DRWJSCHMIDT/T41/README.md

# T41_Stuff

This is the repository for the officially released V10, V11, and V12 versions of the T41 Software Defined Transceiver hardware and kits.  Please read the areas below to understand this project, order boards, make your own boards, find build part lists (BOMs), order kits, and documentation that supports the T41 project.

What is the T41 project?
