DRWJSCHMIDT/T41/T41_V012_Files/T41_V012_Programming_Notes/ATTiny85 Programming Win 11 072026.docx

Notes on using the Arduino IDE to program the ATTiny85

July 20, 2026

USING THIS PROGRAMMER:

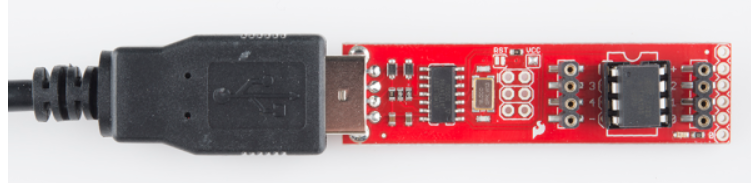
[picture p4: figure]

Unless this is a new Arduino install on the computer using to program, don’t mess with the pre-installed drivers. That is not the issue if it fails.

BUT, IF the drivers need to be updated, this works:

To use a SparkFun programmer (like the Pocket AVR or Tiny AVR) on Windows, download and install the Zadig driver installer. Plug in your programmer, open Zadig, select USBtinyISP from the dropdown, and install the libusb-win32 driver to establish the connection. [1 (https://learn.sparkfun.com/tutorials/pocket-avr-programmer-hookup-guide/installing-drivers), 2 (https://learn.sparkfun.com/tutorials/pocket-avr-programmer-hookup-guide/all), 3 (https://learn.sparkfun.com/tutorials/pocket-avr-programmer-hookup-guide/installing-drivers)]

Because SparkFun programmers generally fall into two categories (AVR Programmers or Boards with USB-to-Serial chips), the exact setup process varies:

1. AVR Programmers (Pocket AVR / Tiny AVR)

Used for burning bootloaders or programming raw chips via ISP. [1 (https://community.sparkfun.com/t/tiny-avr-programmer-windows-11/45802), 2 (https://learn.sparkfun.com/tutorials/pocket-avr-programmer-hookup-guide/introduction)]

- Driver: Windows will likely struggle to recognize this natively. Download and run Zadig (https://zadig.akeo.ie/), select libusb-win32 as the driver, and click Install Driver. [1 (https://learn.sparkfun.com/tutorials/tiny-avr-programmer-hookup-guide/driver-installation), 2 (https://learn.sparkfun.com/tutorials/tiny-avr-programmer-hookup-guide/all), 3 (https://learn.sparkfun.com/tutorials/pocket-avr-programmer-hookup-guide/all), 4 (https://learn.sparkfun.com/tutorials/pocket-avr-programmer-hookup-guide/installing-drivers)]
- Arduino IDE:
  1. Go to Tools > Programmer and select USBtinyISP.
  2. To upload code without a bootloader, click Sketch > Upload Using Programmer. [1 (https://community.sparkfun.com/t/tiny-avr-programmer-windows-11/45802), 2 (https://learn.sparkfun.com/tutorials/pocket-avr-programmer-hookup-guide/all)]
- Command Line: Uses avrdude natively. [1 (https://forums.adafruit.com/viewtopic.php?t=19494), 2 (https://learn.sparkfun.com/tutorials/installing-an-arduino-bootloader/all)]

With the correct drivers, the programmer (FabISP) will show up like this in the system devices list in the DEVICE MANAGER:

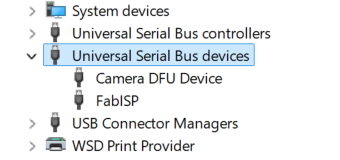
[picture p5: figure]

USING THE Arduino IDE to program:

SELECT THE FOLLOWING UNDER THE TOOLS TAB IN THE IDE:

1. BOARD. Select “ATTiny25/45/85”
2. PORT. Leave this alone!
3. CLOCK: Select “Internal 1 MHz”. NEVER SELECT ANYTHING GREATER THAN 8 MHz
4. PROCESSOR: Select “ATTiny85”
5. PROGRAMMER: Select “USBTinyISP”

Load the program and select “Verify/ Compile” in the SKETCH tab. Then, with the programmer connected, select “Upload Using Programmer in the same tab. No errors should be apparent. LED flashes on programmer during programming. Takes about 3 seconds to program.

Background here:

Tiny AVR Programmer Hookup Guide - SparkFun Learn (https://learn.sparkfun.com/tutorials/tiny-avr-programmer-hookup-guide/all)

Download | USBtinyISP | Adafruit Learning System (https://learn.adafruit.com/usbtinyisp/download)
