DRWJSCHMIDT/T41/T41_V012_Files/T41_V012_PCB_Pictures/Sidplay_Board_MockUp_V1.00_07-14-24.pptx

30 mm Maximum

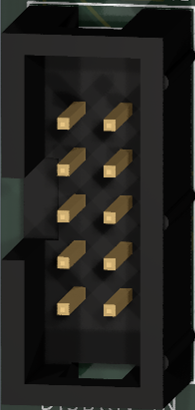
[picture p11: figure]

22.5 mm Maximum
