DRWJSCHMIDT/T41/T41_V012_Files/T41_V012_BPF_Design_Files/AE0AM_T41_BPF_Design_Files/AE0AM_T41_BPF_Filter_Design_Notes.pdf

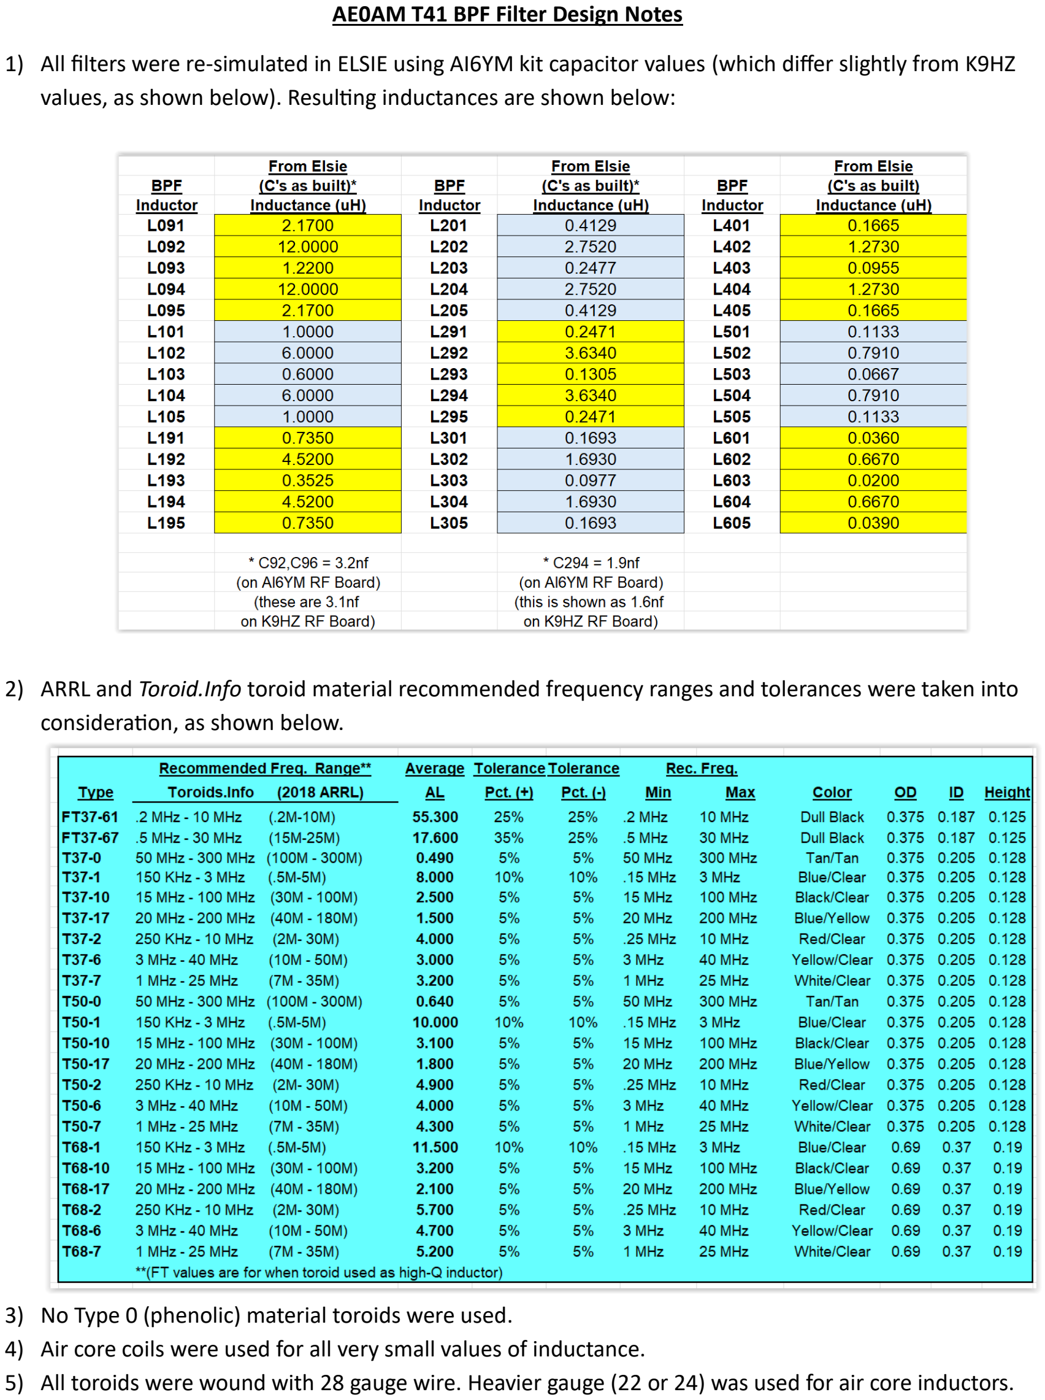
[picture p39: page 1]

AE0AM T41 BPF Filter Design Notes

1) All filters were re-simulated in ELSIE using AI6YM kit capacitor values (which differ slightly from K9HZ values, as shown below). Resulting inductances are shown below:
2) ARRL and Toroid.Info toroid material recommended frequency ranges and tolerances were taken into consideration, as shown below.
3) No Type 0 (phenolic) material toroids were used.
4) Air core coils were used for all very small values of inductance.
5) All toroids were wound with 28 gauge wire. Heavier gauge (22 or 24) was used for air core inductors.

6) All inductor values were checked with LCR meter and “pre-tuned” prior to insertion. In some cases a turn had to be added or removed from the calculated number in order to obtain a better value.
7) Filter as a whole was then tuned until loss was less than at least 3 dBm for entire range.
8) Filter performance was measured with calibrated and normalized DSA832-TG spectrum analyzer, then saved to thumb drive.
9) Filter ELSIE simulated vs. measured performance was displayed using custom Python program.
10) Design details and resulting performance are shown below.

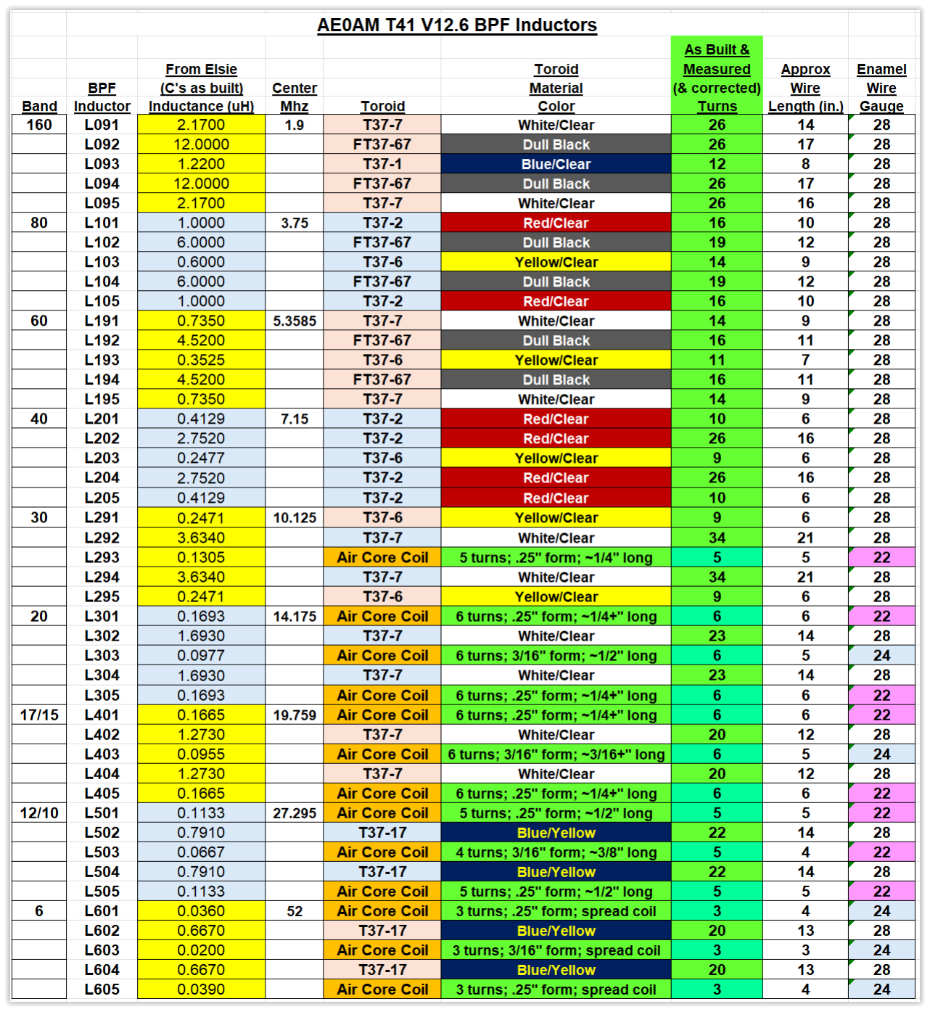
[picture p40: figure]
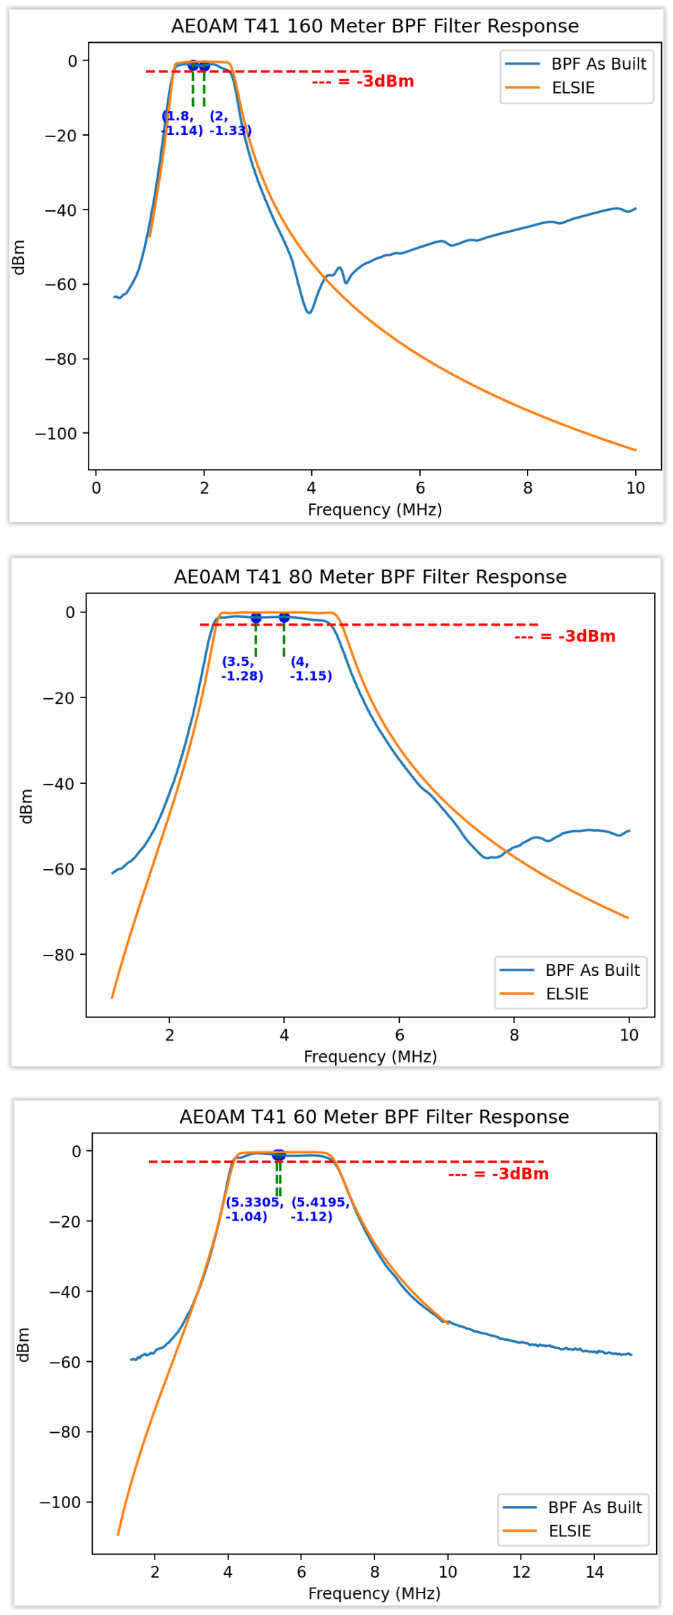
[picture p41: page 3]
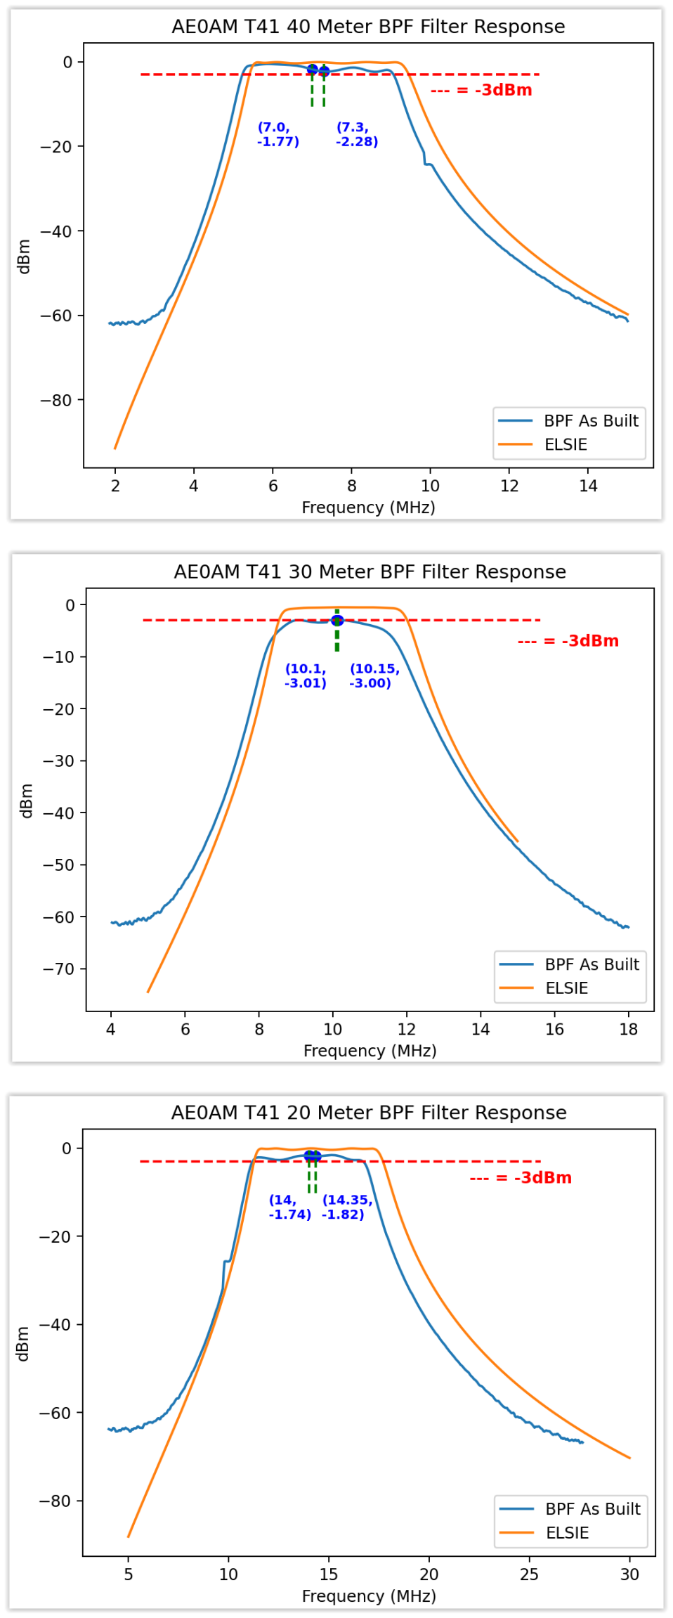
[picture p42: page 4]
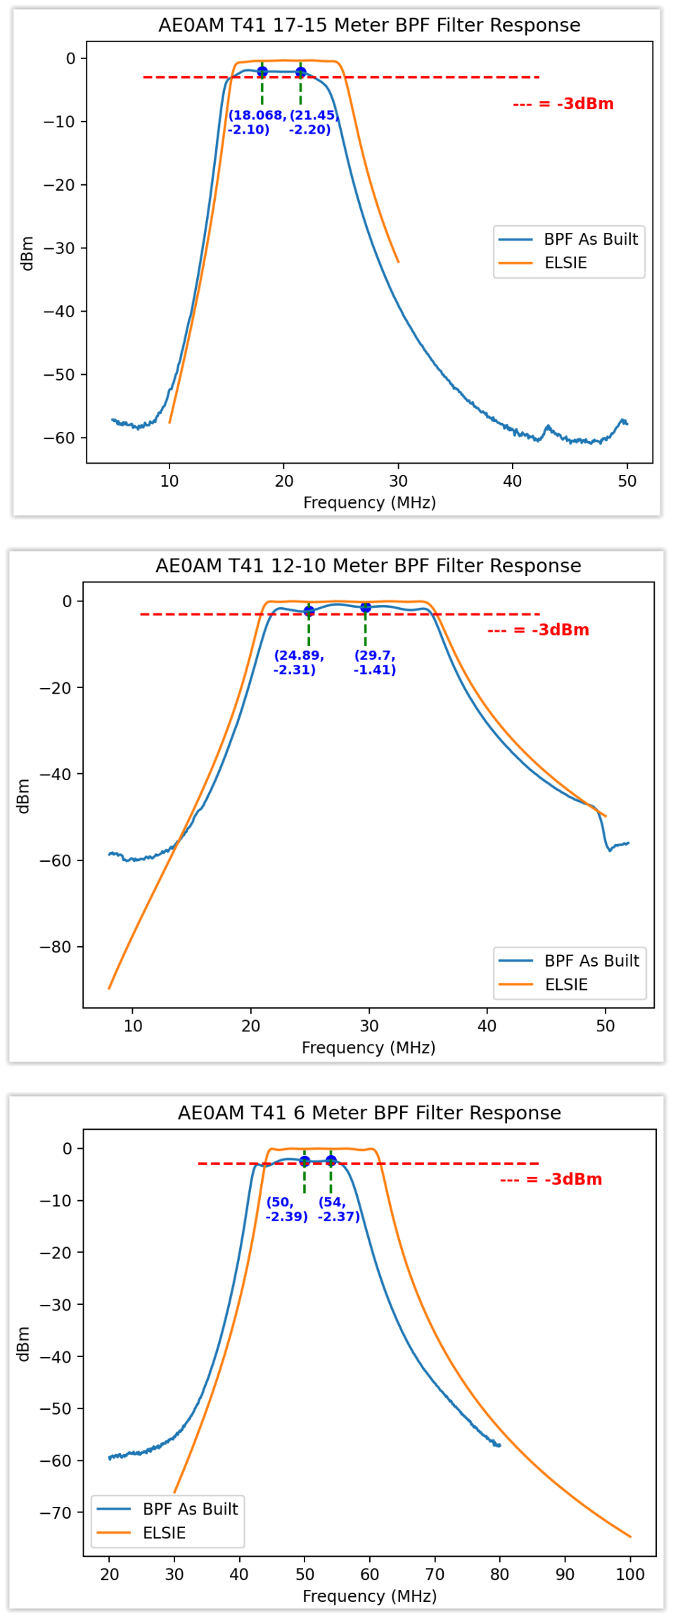
[picture p43: page 5]
