DRWJSCHMIDT/T41/T41_V012_Files/T41_V012_Design_Documents/T41_NF.xlsx

Sheet: 7" Display; no shield
Noise level from my receive antenna |  |  |  |  | T41 Sensitivity and NF
Band | Signal level equal to received atmospheric noise level |  | Level of Atmospheric noise above Rx noise floor | Lowest useable Rx NF | Band | Signal level for 10 dB (S+N)/N |  | NF
(MHz) | (uVolt) | (-dBm) | (dB) | (dB) | (MHz) | (uVolt) | (dBm) | (dB)
3.55 | 0.80 | -109.0 | 19 | 40.0 | 3.69 | 0.06 | -131.5 | 6.0
7.05 | 0.64 | -110.0 | 23 | 39.0 | 7.09 | 0.13 | -125.0 | 12.5
10.12 | 0.80 | -109.0 | 24 | 40.0 | 10.12 | 0.10 | -127.0 | 10.5
14.05 | 0.28 | -118.0 | 15 | 31.0 | 14.03 | 0.12 | -125.5 | 12.0
18.10 | 0.27 | -118.5 | 8 | 30.5 | 18.13 | 0.08 | -129.5 | 8.0
21.20 | 0.17 | -122.5 | 6 | 26.5 | 21.29 | 0.07 | -129.5 | 8.0
24.90 | 0.05 | -133.0 | 3 | 16.0 | 24.95 | 0.48 | -113.0 | 24.5
29.00 | 0.03 | -137.5 | 0 | 11.5 | 28.36 | 0.68 | -111.0 | 26.5
 |  |  |  |  | 50.30 | 2.70 | -99.0 | 38.5
Notes: |  |  |  |  | Notes:
1. Receive BW = 300 Hz. Conversion to 1 Hz BW is 25 dB |  |  |  |  | 1. Receive BW = ~500Hz. Conversion to 1 Hz is 27 dB
2. CW mode |  |  |  |  | 2. CW mode
3. Receiver is KWM-380 |  |  |  |  | 3. Receiver is T41; Main and RF boards
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
