DRWJSCHMIDT/T41/T41_V012_Files/T41_V012_Design_Documents/T41_V12.6_I2C_Assignments.xlsx

Sheet: Summary
I2C Addresses For The T41 V012.6
T41 | I2C | Teensy | Board | SCL | SDA | Address | Chip | Functions
Board | Buss | Pins | Connector | Pin | Pin | Hex | Address
Main | Wire | 18-19 | RFControl | 1 | 3 | 0x0A |  | Audio Adapter/ Hat
 | Wire1 | 16-17 | FrontPanel | 5 | 7
 | Wire2 | 24-25 | Bands | 7 | 5
Display | Wire2 |  | Bands | 7 | 5 | 0x40 or 0x38 |  | Touch Screen Controller
Front | Wire1 |  | Front Panel | 5 | 7 | 0x22 |  | Pico Communication
Panel |  |  |  |  |  | 0x20 | 000 | MCP23017 for Front Panel Switches Switches 1-16
 |  |  |  |  |  | 0X21 | 001 | MCP23017 for Front Panel Switches 17-18, Encoders encoder 1..4 switches, encoder 1..4 A and B and 2 output LEDS.
RF | Wire |  | RFControl | 1 | 3 | 0x60 |  | Si5351a Frequency Control - Primary Receiver and Transmitter for RF board V12.7 and before
 |  |  |  |  |  | 0x61 |  | Si5351a Frequency Control - Primary Receiver and Transmitter for RF board V12.8 and after
 |  |  |  |  |  | 0x6F |  | Si5351a Frequency Control - Second Receiver for RF board V12.7 and before
 |  |  |  |  |  | 0x60 |  | Si5351a Frequency Control - Second Receiver for RF board V12.8 and after
 |  |  |  |  |  | 0x27 | 111 | MCP23017 for Primary Receiver/Transmitter Option Control -
 |  |  |  |  |  | 0x23 | 011 | MCP23017 for Second Receiver Option Control -
BPF | Wire2 |  | Bands | 7 | 5 | 0x24 | 100 | MCP23017 for Band Selection - 160M-6M + Bypass - First Receiver
 |  |  |  |  |  | 0x26 | 110 | MCP23017 for Band Selection - 160M-6M + Bypass - Second Receiver
K9HZ | Wire2 |  | Bands | 7 | 5 | 0x25 | 101 | MCP23017 for Band LPF Selection 160M-6M+Bypass, 1-4 Antenna Selection, XVTR Selection, 100W Module Selection, BPF TX & RX Selection.
LPF |  |  |  |  |  | 0x28 | 0x28 or 0x29 | AD7991-0 or AD7991-1 Two Channel A/D for FORWARD and REFLECTED Power.
VHF-UHF | Wire |  | RFControl | 1 | 3 | TBD |  | Frequency, Band, Preamp power, and I/Q switching
K9HZ | Wire2 |  | Bands | 7 | 5 | 0x48 | 000 | ADT75 Temperature
100W |  |  |  |  |  | 0x4C |  | MCP3021A0T 2xRD100HHF1 Current Draw
K9HZ | Wire2 |  | Bands | 7 | 5 | 0x20 | 000 | MCP21017 for selecting 8-Inductors, 8-Capacitors
ATU |  |  |  |  |  | 0x21 | 001 | MCP21008 for selecting Configuration, Bypass, Transformer
Note: These addresses can be verified using the modified i2cscan address scanner found on the G0ORX github: https://github.com/g0orx/i2cscan

Sheet: Display
DIsplay - I2C Addresses
I2C | Board | SCL | SDA | Address | Chip | Chip | Chip Pin | Function
Buss | Connector | Pin | Pin | Hex |  | Address
Wire2 | Bands | 7 | 5 | 0x40 | GSL1680 |  |  | Touch Screen Controller - 5" Display
Wire3 | Bands | 7 | 5 | 0x38 | FT5206 |  |  | Touch Screen Controller - 7" and 9" Display
Note: Only one of the above addresses will be occupied.

Sheet: Front Panel
Front Panel Board - I2C Addresses
I2C | Board | SCL | SDA | Address | Chip | Chip | Chip Pin | Function
Buss | Connector | Pin | Pin | Hex |  | Address
Wire1 | Front Panel | 5 | 7 | 0x20 | Pico | ? | ?
 |  |  |  | 0x20 | MCP23017 | 000 | GPA0 | Switch 1 ["1"=PRESSED, "0"=Released]
 |  |  |  |  |  |  | GPA1 | Switch 2 ["1"=PRESSED, "0"=Released]
 |  |  |  |  |  |  | GPA2 | Switch 3 ["1"=PRESSED, "0"=Released]
 |  |  |  |  |  |  | GPA3 | Switch 4 ["1"=PRESSED, "0"=Released]
 |  |  |  |  |  |  | GPA4 | Switch 5 ["1"=PRESSED, "0"=Released]
 |  |  |  |  |  |  | GPA5 | Switch 6 ["1"=PRESSED, "0"=Released]
 |  |  |  |  |  |  | GPA6 | Switch 7 ["1"=PRESSED, "0"=Released]
 |  |  |  |  |  |  | GPA7 | Switch 8 ["1"=PRESSED, "0"=Released]
 |  |  |  |  |  |  | GPB0 | Switch 9 ["1"=PRESSED, "0"=Released]
 |  |  |  |  |  |  | GPB1 | Switch 10 ["1"=PRESSED, "0"=Released]
 |  |  |  |  |  |  | GPB2 | Switch 11 ["1"=PRESSED, "0"=Released]
 |  |  |  |  |  |  | GPB3 | Switch 12 ["1"=PRESSED, "0"=Released]
 |  |  |  |  |  |  | GPB4 | Switch 13 ["1"=PRESSED, "0"=Released]
 |  |  |  |  |  |  | GPB5 | Switch 14 ["1"=PRESSED, "0"=Released]
 |  |  |  |  |  |  | GPB6 | Switch 15 ["1"=PRESSED, "0"=Released]
 |  |  |  |  |  |  | GPB7 | Switch 16 ["1"=PRESSED, "0"=Released]
 |  |  |  | 0x21 | MCP23017 | 001 | GPA0 | Switch 17 ["1"=PRESSED, "0"=Released]
 |  |  |  |  |  |  | GPA1 | Switch 18 ["1"=PRESSED, "0"=Released]
 |  |  |  |  |  |  | GPA2 | Encoder #1 Switch ["1"=PRESSED, "0"=Released]
 |  |  |  |  |  |  | GPA3 | Encoder #2 Switch ["1"=PRESSED, "0"=Released]
 |  |  |  |  |  |  | GPA4 | Encoder #3 Switch ["1"=PRESSED, "0"=Released]
 |  |  |  |  |  |  | GPA5 | Encoder #4 Switch ["1"=PRESSED, "0"=Released]
 |  |  |  |  |  |  | GPA6 | LED #1 ["1"=On, "0"=Off]
 |  |  |  |  |  |  | GPA7 | LED #2 ["1"=On, "0"=Off]
 |  |  |  |  |  |  | GPB0 | Encoder #1 A
 |  |  |  |  |  |  | GPB1 | Encoder #1 B
 |  |  |  |  |  |  | GPB2 | Encoder #2 A
 |  |  |  |  |  |  | GPB3 | Encoder #2 B
 |  |  |  |  |  |  | GPB4 | Encoder #3 A
 |  |  |  |  |  |  | GPB5 | Encoder #3 B
 |  |  |  |  |  |  | GPB6 | Encoder #4 A
 |  |  |  |  |  |  | GPB7 | Encoder #4 B

Sheet: RF Board
RF Board - I2C Addresses
I2C | Board | SCL | SDA | Address * | Chip | Chip | Chip Pin | Function
Buss | Connector | Pin | Pin | Hex |  | Address
RX #1
Wire | RFControl | 1 | 3 | 0x60 | Si5351a | DEVICE |  | Frequency Control - Receiver and Transmitter (0x60)
 |  |  |  | 0x27 | MCP23017 | 111 | GPA0 | RC-0.5 dB Receive Signal Reduction ["1"=On, "0"= Off]
 |  |  |  |  |  |  | GPA1 | RC-1 dB Receive Signal Reduction ["1"=On, "0"= Off]
 |  |  |  |  |  |  | GPA2 | RC-2 dB Receive Signal Reduction ["1"=On, "0"= Off]
 |  |  |  |  |  |  | GPA3 | RC-4 dB Receive Signal Reduction ["1"=On, "0"= Off]
 |  |  |  |  |  |  | GPA4 | RC-8 dB Receive Signal Reduction ["1"=On, "0"= Off]
 |  |  |  |  |  |  | GPA5 | RC-16 Receive Signal Reduction ["1"=On, "0"= Off]
 |  |  |  |  |  |  | GPA6 | N/C
 |  |  |  |  |  |  | GPA7 | N/C
 |  |  |  |  |  |  | GPB0 | TC-0.5 dB Transmit Power Reduction ["1"=On, "0"= Off]
 |  |  |  |  |  |  | GPB1 | TC-1 dB Transmit Power Reduction ["1"=On, "0"= Off]
 |  |  |  |  |  |  | GPB2 | TC-2 dB Transmit Power Reduction ["1"=On, "0"= Off]
 |  |  |  |  |  |  | GPB3 | TC-4 dB Transmit Power Reduction ["1"=On, "0"= Off]
 |  |  |  |  |  |  | GPB4 | TC-8 dB Transmit Power Reduction ["1"=On, "0"= Off]
 |  |  |  |  |  |  | GPB5 | TC-16 Transmit Power Reduction ["1"=On, "0"= Off]
 |  |  |  |  |  |  | GPB6 | N/C
 |  |  |  |  |  |  | GPB7 | N/C
RX #2
Wire | RFControl | 1 | 3 | 0x61 or 0x6F | Si5351a | DEVICE |  | Frequency Control - Second Receiver (0x61 or 0x6F)
 |  |  |  | 0x23 | MCP23017 | 011 | GPA0 | RC-0.5 dB Receive Signal Reduction ["1"=On, "0"= Off]
 |  |  |  |  |  |  | GPA1 | RC-1 dB Receive Signal Reduction ["1"=On, "0"= Off]
 |  |  |  |  |  |  | GPA2 | RC-2 dB Receive Signal Reduction ["1"=On, "0"= Off]
 |  |  |  |  |  |  | GPA3 | RC-4 dB Receive Signal Reduction ["1"=On, "0"= Off]
 |  |  |  |  |  |  | GPA4 | RC-8 dB Receive Signal Reduction ["1"=On, "0"= Off]
 |  |  |  |  |  |  | GPA5 | RC-16 Receive Signal Reduction ["1"=On, "0"= Off]
 |  |  |  |  |  |  | GPA6 | N/C
 |  |  |  |  |  |  | GPA7 | N/C
 |  |  |  |  |  |  | GPB0 | TC-0.5 dB Transmit Power Reduction ["1"=On, "0"= Off]
 |  |  |  |  |  |  | GPB1 | TC-1 dB Transmit Power Reduction ["1"=On, "0"= Off]
 |  |  |  |  |  |  | GPB2 | TC-2 dB Transmit Power Reduction ["1"=On, "0"= Off]
 |  |  |  |  |  |  | GPB3 | TC-4 dB Transmit Power Reduction ["1"=On, "0"= Off]
 |  |  |  |  |  |  | GPB4 | TC-8 dB Transmit Power Reduction ["1"=On, "0"= Off]
 |  |  |  |  |  |  | GPB5 | TC-16 Transmit Power Reduction ["1"=On, "0"= Off]
 |  |  |  |  |  |  | GPB6 | N/C
 |  |  |  |  |  |  | GPB7 | N/C
 | *Note: As of this writing, Digikey stocks si5351 chips with custom I2C addresses - 0x6F

Sheet: BPF Board
BPF Board - I2C Addresses
I2C | Board | SCL | SDA | Address | Chip | Chip | Chip Pin | Function
Buss | Connector | Pin | Pin | Hex |  | Address
BPF FOR RX #1
Wire2 | Bands | 7 | 5 | 0x24 | MCP23017 | 100 | GPA0 | High = 12M | BAND | GPA0 | GPA1 | GPA2 | GPA3 | GPA4 | GPA5 | GPA6 | GPA7 | GPB0 | GPB1 | GPB2 | GPB3 | GPB4 | GPB5 | GPB6 | GPB7
 |  |  |  |  |  |  | GPA1 | High = 10M
 |  |  |  |  |  |  | GPA2 | High = 6M | 160M | 0 | 0 | 0 | 0 | 0 | 0 | 0 | 0 | 0 | 1 | 0 | 0 | 0 | 0 | 0 | 0
 |  |  |  |  |  |  | GPA3 | High = Bypass | 80M | 0 | 0 | 0 | 0 | 0 | 0 | 0 | 0 | 0 | 0 | 1 | 0 | 0 | 0 | 0 | 0
 |  |  |  |  |  |  | GPA4 | N/C | 60M | 0 | 0 | 0 | 0 | 0 | 0 | 0 | 0 | 1 | 0 | 0 | 0 | 0 | 0 | 0 | 0
 |  |  |  |  |  |  | GPA5 | N/C | 40M | 0 | 0 | 0 | 0 | 0 | 0 | 0 | 0 | 0 | 0 | 0 | 1 | 0 | 0 | 0 | 0
 |  |  |  |  |  |  | GPA6 | N/C | 30M | 0 | 0 | 0 | 0 | 0 | 0 | 0 | 0 | 0 | 0 | 0 | 0 | 1 | 0 | 0 | 0
 |  |  |  |  |  |  | GPA7 | N/C | 20M | 0 | 0 | 0 | 0 | 0 | 0 | 0 | 0 | 0 | 0 | 0 | 0 | 0 | 1 | 0 | 0
 |  |  |  |  |  |  | GPB0 | High = 60M | 17M | 0 | 0 | 0 | 0 | 0 | 0 | 0 | 0 | 0 | 0 | 0 | 0 | 0 | 0 | 1 | 0
 |  |  |  |  |  |  | GPB1 | High = 160M | 15M | 0 | 0 | 0 | 0 | 0 | 0 | 0 | 0 | 0 | 0 | 0 | 0 | 0 | 0 | 0 | 1
 |  |  |  |  |  |  | GPB2 | High = 80M | 12M | 1 | 0 | 0 | 0 | 0 | 0 | 0 | 0 | 0 | 0 | 0 | 0 | 0 | 0 | 0 | 0
 |  |  |  |  |  |  | GPB3 | High = 40M | 10M | 0 | 1 | 0 | 0 | 0 | 0 | 0 | 0 | 0 | 0 | 0 | 0 | 0 | 0 | 0 | 0
 |  |  |  |  |  |  | GPB4 | High = 30M | 6M | 0 | 0 | 1 | 0 | 0 | 0 | 0 | 0 | 0 | 0 | 0 | 0 | 0 | 0 | 0 | 0
 |  |  |  |  |  |  | GPB5 | High = 20M | Bypass | 0 | 0 | 0 | 1 | 0 | 0 | 0 | 0 | 0 | 0 | 0 | 0 | 0 | 0 | 0 | 0
 |  |  |  |  |  |  | GPB6 | High = 17M
 |  |  |  |  |  |  | GPB7 | High = 15M
BPF FOR RX #2
Wire2 | Bands | 7 | 5 | 0x26 | MCP23017 | 100 | GPA0 | High = 12M | BAND | GPA0 | GPA1 | GPA2 | GPA3 | GPA4 | GPA5 | GPA6 | GPA7 | GPB0 | GPB1 | GPB2 | GPB3 | GPB4 | GPB5 | GPB6 | GPB7
 |  |  |  |  |  |  | GPA1 | High = 10M
 |  |  |  |  |  |  | GPA2 | High = 6M | 160M | 0 | 0 | 0 | 0 | 0 | 0 | 0 | 0 | 0 | 1 | 0 | 0 | 0 | 0 | 0 | 0
 |  |  |  |  |  |  | GPA3 | High = Bypass | 80M | 0 | 0 | 0 | 0 | 0 | 0 | 0 | 0 | 0 | 0 | 1 | 0 | 0 | 0 | 0 | 0
 |  |  |  |  |  |  | GPA4 | N/C | 60M | 0 | 0 | 0 | 0 | 0 | 0 | 0 | 0 | 1 | 0 | 0 | 0 | 0 | 0 | 0 | 0
 |  |  |  |  |  |  | GPA5 | N/C | 40M | 0 | 0 | 0 | 0 | 0 | 0 | 0 | 0 | 0 | 0 | 0 | 1 | 0 | 0 | 0 | 0
 |  |  |  |  |  |  | GPA6 | N/C | 30M | 0 | 0 | 0 | 0 | 0 | 0 | 0 | 0 | 0 | 0 | 0 | 0 | 1 | 0 | 0 | 0
 |  |  |  |  |  |  | GPA7 | N/C | 20M | 0 | 0 | 0 | 0 | 0 | 0 | 0 | 0 | 0 | 0 | 0 | 0 | 0 | 1 | 0 | 0
 |  |  |  |  |  |  | GPB0 | High = 60M | 17M | 0 | 0 | 0 | 0 | 0 | 0 | 0 | 0 | 0 | 0 | 0 | 0 | 0 | 0 | 1 | 0
 |  |  |  |  |  |  | GPB1 | High = 160M | 15M | 0 | 0 | 0 | 0 | 0 | 0 | 0 | 0 | 0 | 0 | 0 | 0 | 0 | 0 | 0 | 1
 |  |  |  |  |  |  | GPB2 | High = 80M | 12M | 1 | 0 | 0 | 0 | 0 | 0 | 0 | 0 | 0 | 0 | 0 | 0 | 0 | 0 | 0 | 0
 |  |  |  |  |  |  | GPB3 | High = 40M | 10M | 0 | 1 | 0 | 0 | 0 | 0 | 0 | 0 | 0 | 0 | 0 | 0 | 0 | 0 | 0 | 0
 |  |  |  |  |  |  | GPB4 | High = 30M | 6M | 0 | 0 | 1 | 0 | 0 | 0 | 0 | 0 | 0 | 0 | 0 | 0 | 0 | 0 | 0 | 0
 |  |  |  |  |  |  | GPB5 | High = 20M | Bypass | 0 | 0 | 0 | 1 | 0 | 0 | 0 | 0 | 0 | 0 | 0 | 0 | 0 | 0 | 0 | 0
 |  |  |  |  |  |  | GPB6 | High = 17M
 |  |  |  |  |  |  | GPB7 | High = 15M

Sheet: LPF Board
LPF Board - I2C Addresses
I2C | Board | SCL | SDA | Address | Chip | Chip | Chip Pin | Function
Buss | Connector | Pin | Pin | Hex |  | Address
Wire2 | Bands | 7 | 5 | 0x25 | MCP23017 | 101 | GPA0 | HI = BPF In Circuit During TX, LO = Bypass | BAND | GPB3 | GPB2 | GPB1 | GPB0
 |  |  |  |  |  |  | GPA1 | HI = BPF In Circuit During RX, LO = Bypass
 |  |  |  |  |  |  | GPA2 | N/C | 160M | 0 | 0 | 0 | 1
 |  |  |  |  |  |  | GPA3 | N/C | 80M | 0 | 0 | 1 | 0
 |  |  |  |  |  |  | GPA4 | N/C | 60M | 0 | 0 | 0 | 0
 |  |  |  |  |  |  | GPA5 | N/C | 40M | 0 | 0 | 1 | 1
 |  |  |  |  |  |  | GPA6 | N/C | 30M | 0 | 1 | 0 | 0
 |  |  |  |  |  |  | GPA7 | N/C | 20M | 0 | 1 | 0 | 1
 |  |  |  |  |  |  | GPB0 | LPF Band Select = [GPB3, GPB2, GPB1, GPB0] See Band Table --> | 17M | 0 | 1 | 1 | 0
 |  |  |  |  |  |  | GPB1 | LPF Band Select = [GPB3, GPB2, GPB1, GPB0] See Band Table --> | 15M | 0 | 1 | 1 | 1
 |  |  |  |  |  |  | GPB2 | LPF Band Select = [GPB3, GPB2, GPB1, GPB0] See Band Table --> | 12M | 1 | 0 | 0 | 0
 |  |  |  |  |  |  | GPB3 | LPF Band Select = [GPB3, GPB2, GPB1, GPB0] See Band Table --> | 10M | 1 | 0 | 0 | 1
 |  |  |  |  |  |  | GPB4 | Antenna Select: [GPA5, GPA4] - [00] = ANT1, [01] = ANT2 | 6M | 1 | 0 | 1 | 0
 |  |  |  |  |  |  | GPB5 | Antenna Select: [GPA5, GPA4] - [10] = ANT3, [11] = ANT4 | Bypass | 1 | 0 | 1 | 1
 |  |  |  |  |  |  | GPB6 | Transverter Select = HIGH, Bypass = LOW
 |  |  |  |  |  |  | GPB7 | 100W Module Select - HIGH, Bypass = LOW
 |  |  |  | 0x28 or 0x29 | AD7991 | 0x28 or 0x29 | V0 | Forward Power
 |  |  |  |  |  |  | V1 | Reflected Power
 |  |  |  |  |  |  | V2 | N/C
 |  |  |  |  |  |  | V3 | Vref

Sheet: ATU Module
ATU Module - I2C Addresses
I2C | Board | SCL | SDA | Address | Chip | Chip | Chip Pin | Function
Buss | Connector | Pin | Pin | Hex |  | Address
Wire2 | Bands | 7 | 5 | 0x20 | MCP23017 | 000 | GPA0 | L1 - 0.05uH
 |  |  |  |  |  |  | GPA1 | L2 - 0.10uH
 |  |  |  |  |  |  | GPA2 | L3 - 0.22uH
 |  |  |  |  |  |  | GPA3 | L4 - 0.45uH
 |  |  |  |  |  |  | GPA4 | L5 - 1.0uH
 |  |  |  |  |  |  | GPA5 | L6 - 2.2uH
 |  |  |  |  |  |  | GPA6 | L7 - 4.4uH
 |  |  |  |  |  |  | GPA7 | L8 - 8.8uH
 |  |  |  |  |  |  | GPB0 | C1 - 10pF
 |  |  |  |  |  |  | GPB1 | C2 - 22pF
 |  |  |  |  |  |  | GPB2 | C3 - 47pF
 |  |  |  |  |  |  | GPB3 | C4 - 100pF
 |  |  |  |  |  |  | GPB4 | C5 - 220pF
 |  |  |  |  |  |  | GPB5 | C6 - 470pF
 |  |  |  |  |  |  | GPB6 | C7 - 1000pF
 |  |  |  |  |  |  | GPB7 | C8 - 2000pF
 |  |  |  | 0x21 | MCP23008 | 001 | GPA0 | Configuration - LC or CL
 |  |  |  |  |  |  | GPA1 | Transformer/ Balanced Line Output
 |  |  |  |  |  |  | GPA2 | Bypass ATU
 |  |  |  |  |  |  | GPA3 | N/C
 |  |  |  |  |  |  | GPA4 | N/C
 |  |  |  |  |  |  | GPA5 | N/C
 |  |  |  |  |  |  | GPA6 | N/C
 |  |  |  |  |  |  | GPA7 | N/C

Sheet: VHF Board
VHF Board - I2C Addresses
I2C | Board | SCL | SDA | Address | Chip | Chip | Chip Pin | Function
Buss | Connector | Pin | Pin | Hex |  | Address
 | TBD

Sheet: 100W Module
100W Module - I2C Addresses
I2C | Board | SCL | SDA | Address | Chip | Chip | Chip Pin | Function
Buss | Connector | Pin | Pin | Hex |  | Address
 | TBD
