DRWJSCHMIDT/T41/T41_V012_Files/T41_V012_Design_Documents/Audio_Board_Sketch_070225.pdf

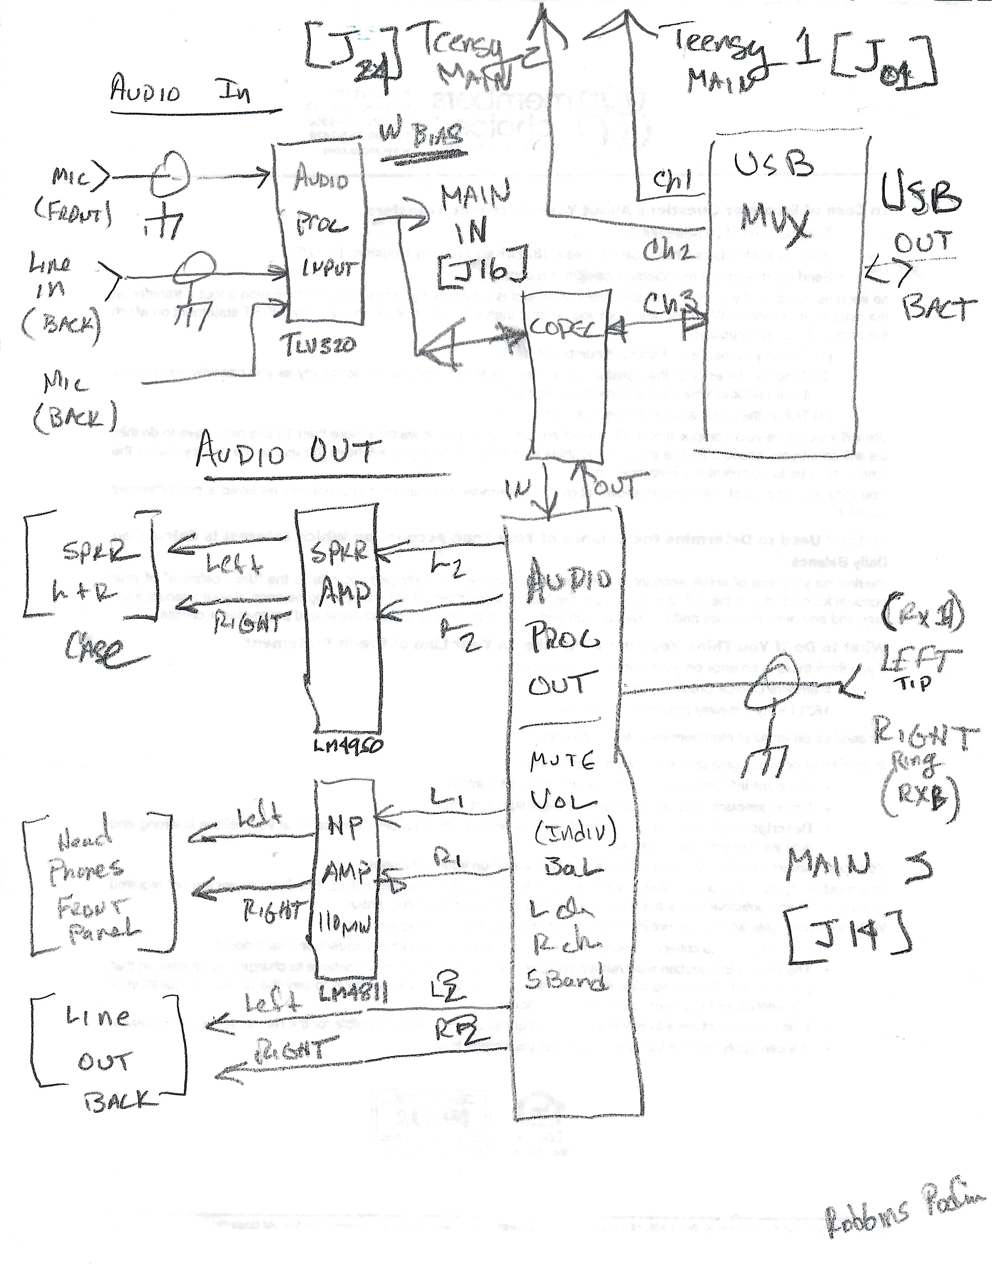
[picture p66: page 1]
