DRWJSCHMIDT/T41/T41_V012_Files/T41_V012_BPF_Design_Files/Opening the T41 BPF and LPF filter files using Elsie.pdf

### Opening the T41 BPF and LPF filter files using Elsie

The files as downloaded contain Unix/Linux line endings (LF only). If you attempt to open these files as is using Elsie, you will get the following error:

“Error string:48
ErrorDescription: Input string past end of file”

This is because Elsie wants to see Windows line endings (CRLF). An easy way to fix the problem is to use Notepad++, a free text editor with many useful features. It can be downloaded at: https://notepad-plus-plus.org/downloads/v8.6.8/.

Once you have installed Notepad++, open the .LCT file (e.g.,
T41_BPF_12-10M_Design_V12.6_01-24-24.LCT.

Then you can see the problem by selecting View -> Show Symbol -> Show End of Line:

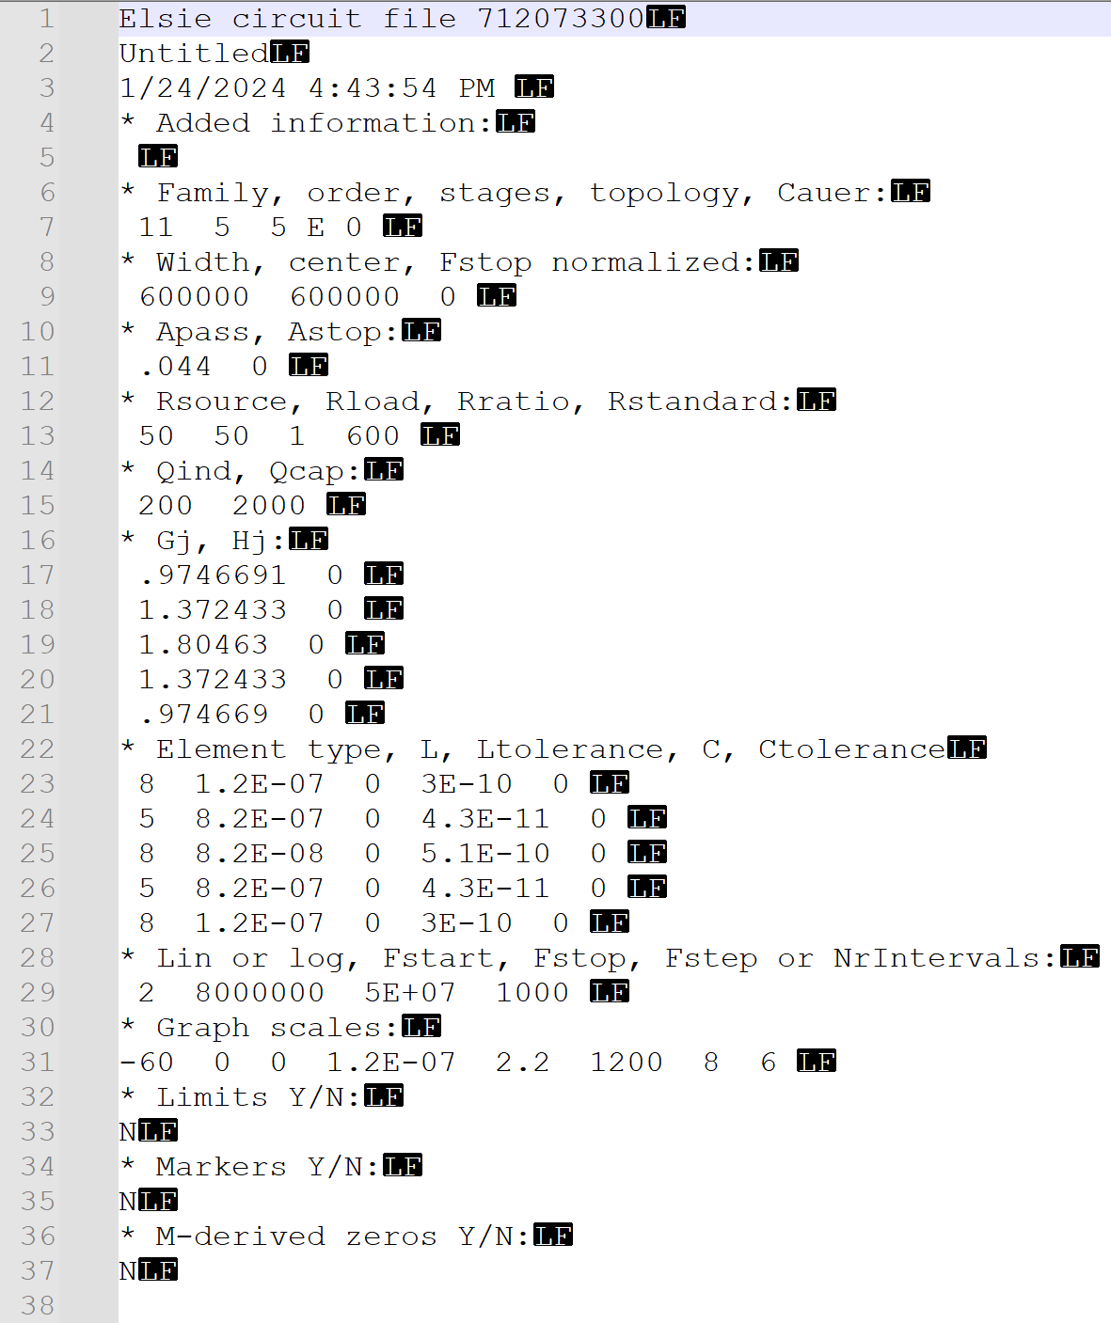
[picture p67: figure]

Now select Edit -> EOL Conversion -> Windows (CR LF), and the file should look loke this:

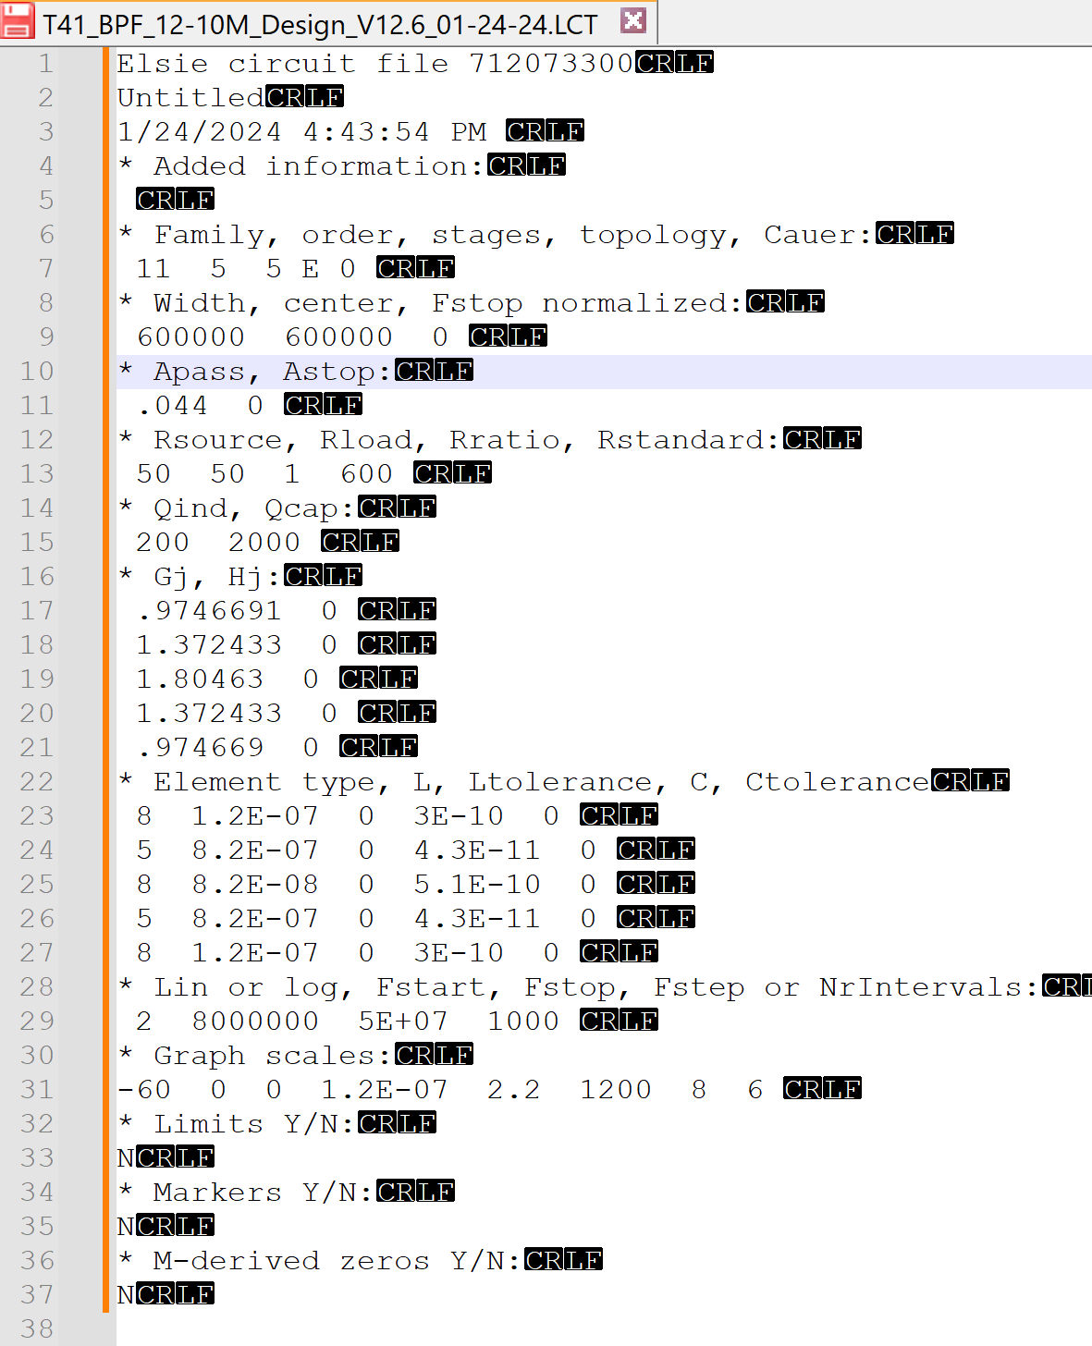
[picture p68: figure]

Save this file and it should open without error in Elsie.
