DRWJSCHMIDT/T41/T41_V012_Files/T41_V012_BPF_Design_Files/K9HZ_T41_BPF_Design_Files/T41_BPF_17-15M_Filter_V12.6_03-07-24.pdf

## Untitled

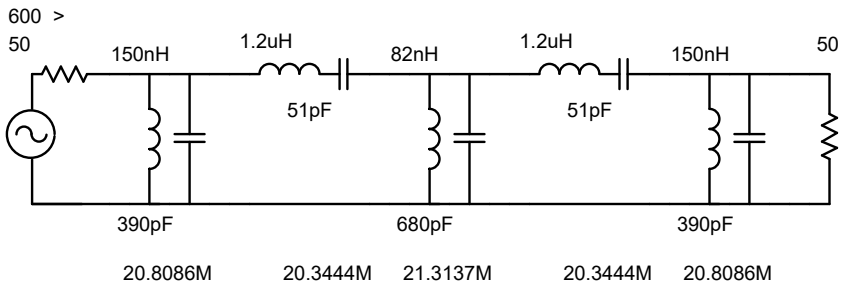
[picture p69: figure]

Bandwidth: 2.5M | Center: 18.1M | Family: Manual entry
iles_01-15-24\T41_V012_BPF_Design_Files\T41_BPF_17-15M_Design_V12.6_03-07-24.LCT 3/7/2024 10:34:45 PM - Elsie 2.86 - www.TonneSoftware.com
