DRWJSCHMIDT/T41/K9HZ_100W_PA/K9HZ_100W_KiCad-bottom.png

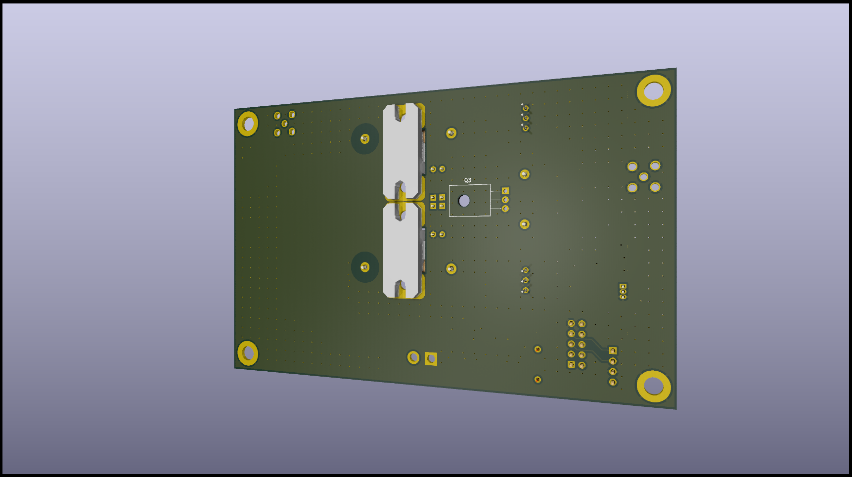
K9HZ_100W_PA/K9HZ_100W_KiCad-bottom.png
