DRWJSCHMIDT/T41/K9HZ_100W_PA/K9HZ_100W_KiCad.png

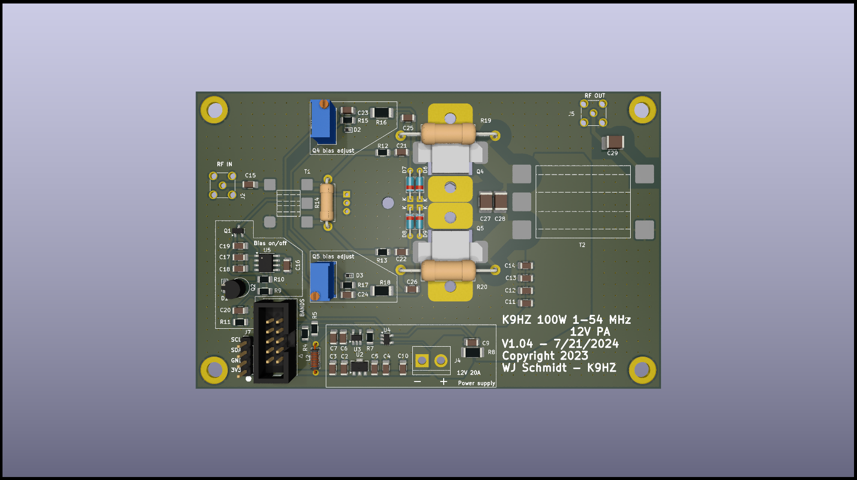
K9HZ_100W_PA/K9HZ_100W_KiCad.png
