DRWJSCHMIDT/T41/K9HZ_KI3P_Reverse_Voltage_Protection/K9HZ_KI3P_50A_Reverse_Voltage_Protection_Kit_X/Reverse_voltage_protection_50A_pcb.jpg

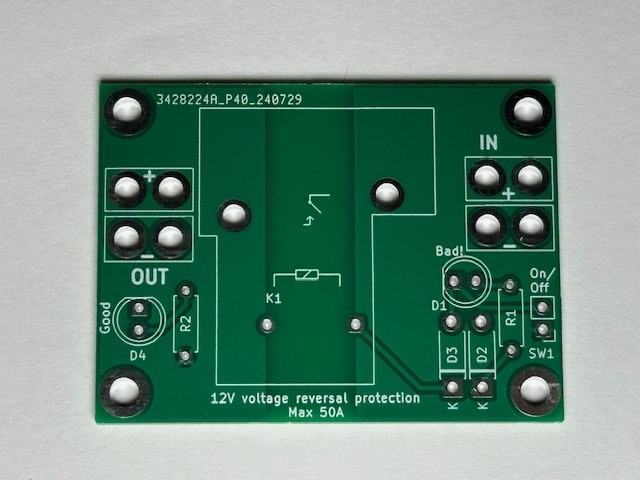
K9HZ_KI3P_Reverse_Voltage_Protection/K9HZ_KI3P_50A_Reverse_Voltage_Protection_Kit_X/Reverse_voltage_protection_50A_pcb.jpg
