DRWJSCHMIDT/T41/T41_V012_Files/T41_V012_Design_Documents/ldovr-lt3045-78xxg-ultra-low-noise-voltage-regulator-5v.jpg

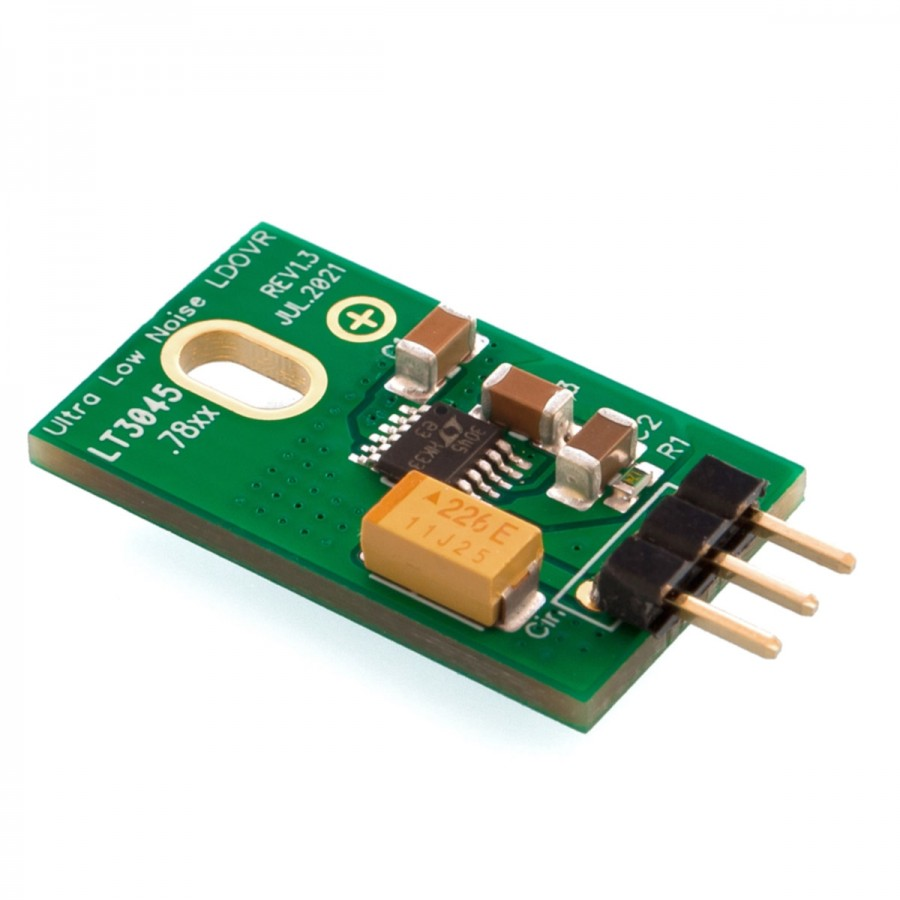
T41_V012_Files/T41_V012_Design_Documents/ldovr-lt3045-78xxg-ultra-low-noise-voltage-regulator-5v.jpg
