DRWJSCHMIDT/T41/T41_V012_Files/T41_V012_PCB_Pictures/Audio_Hat_Partial.JPG

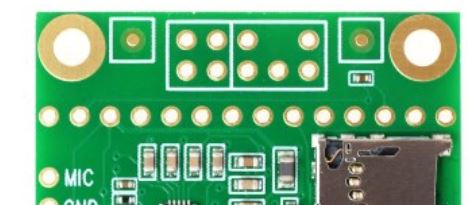
T41_V012_Files/T41_V012_PCB_Pictures/Audio_Hat_Partial.JPG
