DRWJSCHMIDT/T41/T41_V012_Files/T41_V012_PCB_Pictures/BPF_2.jpg

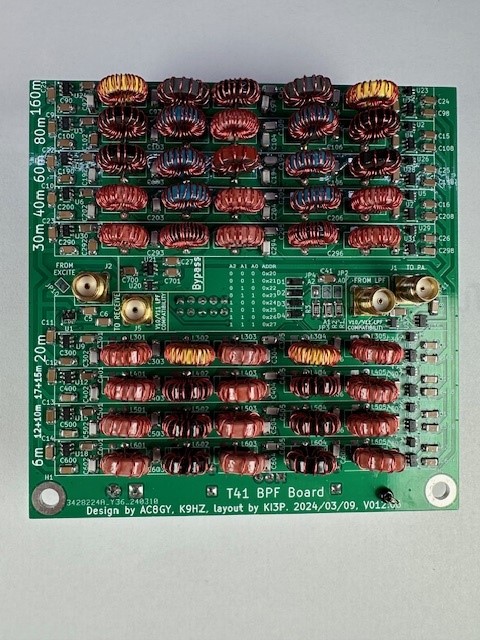
T41_V012_Files/T41_V012_PCB_Pictures/BPF_2.jpg
