DRWJSCHMIDT/T41/T41_V012_Files/T41_V012_PCB_Pictures/Display Adapter 3&5V Built Alt Connectors.jpg

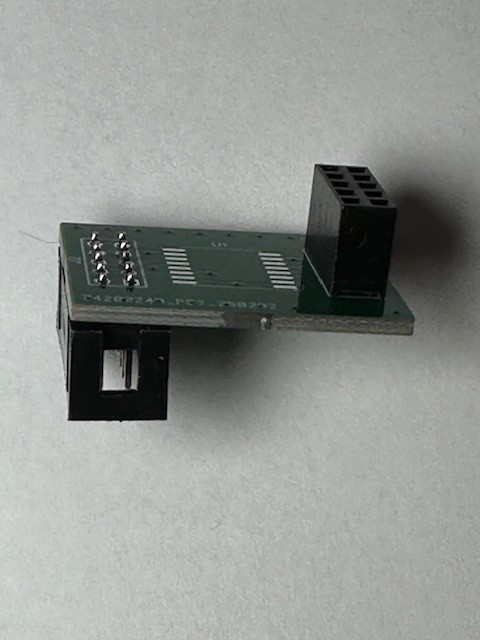
T41_V012_Files/T41_V012_PCB_Pictures/Display Adapter 3&5V Built Alt Connectors.jpg
