DRWJSCHMIDT/T41/T41_V012_Files/T41_V012_PCB_Pictures/Display Adapter bottom.JPG

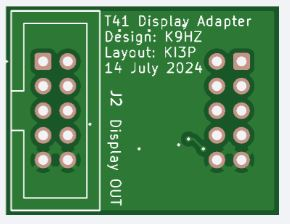
T41_V012_Files/T41_V012_PCB_Pictures/Display Adapter bottom.JPG
