DRWJSCHMIDT/T41/T41_V012_Files/T41_V012_PCB_Pictures/DIsplay Adapter top.JPG

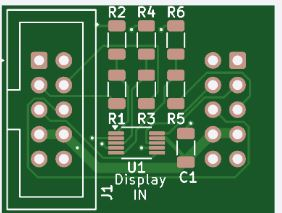
T41_V012_Files/T41_V012_PCB_Pictures/DIsplay Adapter top.JPG
