DRWJSCHMIDT/T41/T41_V012_Files/T41_V012_PCB_Pictures/Display_adapter_010825.jpg

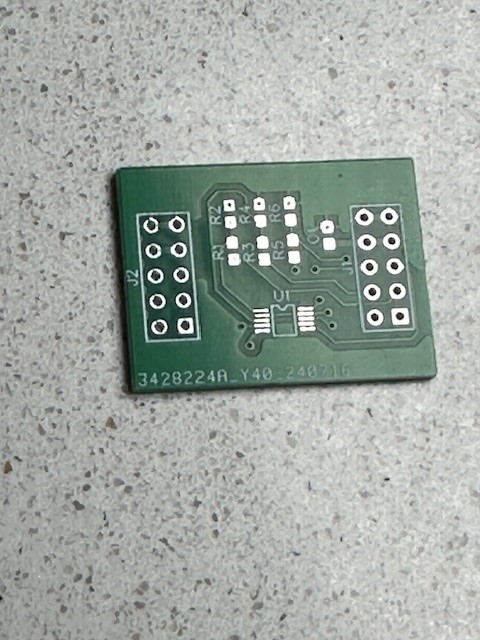
T41_V012_Files/T41_V012_PCB_Pictures/Display_adapter_010825.jpg
