DRWJSCHMIDT/T41/T41_V012_Files/T41_V012_PCB_Pictures/Display_Adapter_Boards_V2.0.jpg

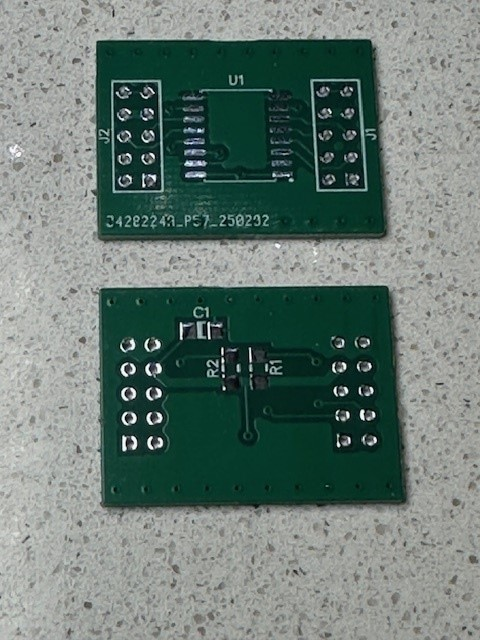
T41_V012_Files/T41_V012_PCB_Pictures/Display_Adapter_Boards_V2.0.jpg
