DRWJSCHMIDT/T41/T41_V012_Files/T41_V012_PCB_Pictures/Display_Driver_3.3V&5V_Top.jpg

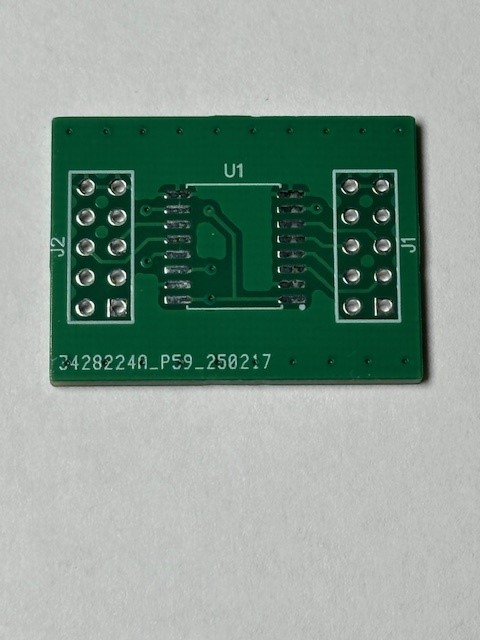
T41_V012_Files/T41_V012_PCB_Pictures/Display_Driver_3.3V&5V_Top.jpg
