DRWJSCHMIDT/T41/T41_V012_Files/T41_V012_PCB_Pictures/Dual Attenuator Daughter Board 041026.PNG

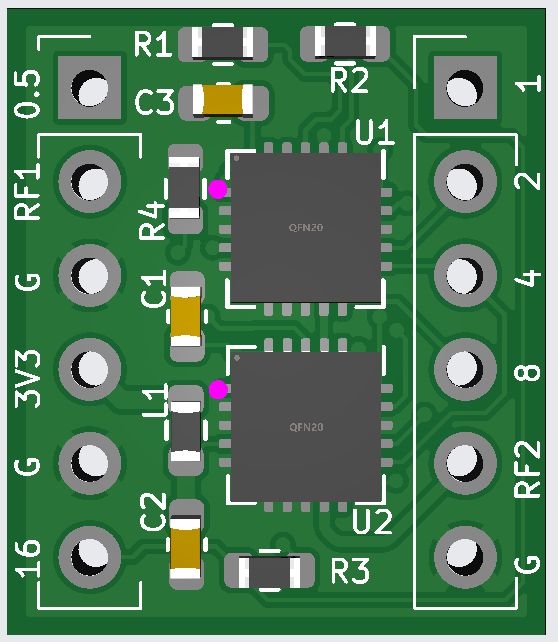
T41_V012_Files/T41_V012_PCB_Pictures/Dual Attenuator Daughter Board 041026.PNG
