DRWJSCHMIDT/T41/T41_V012_Files/T41_V012_PCB_Pictures/Main_Board_Ethernet_Connection.png

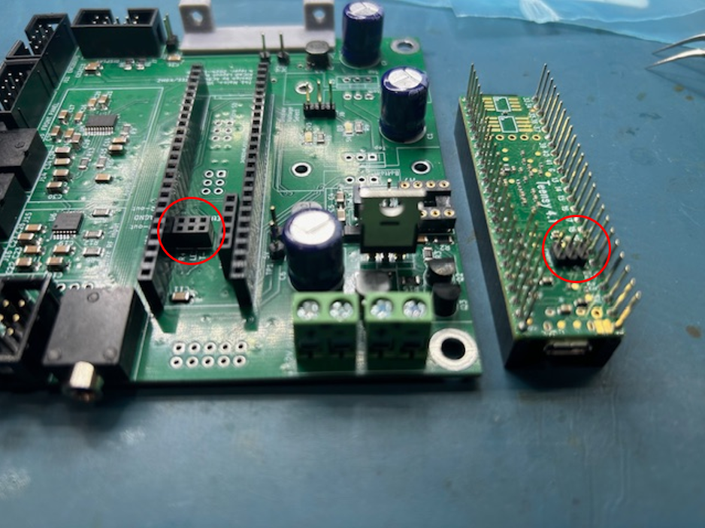
T41_V012_Files/T41_V012_PCB_Pictures/Main_Board_Ethernet_Connection.png
