DRWJSCHMIDT/T41/T41_V012_Files/T41_V012_PCB_Pictures/Main_Board_Mockup_For_Display_Board_V1.00_071424.JPG

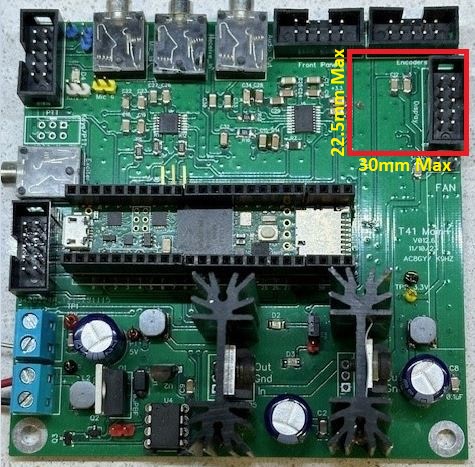
T41_V012_Files/T41_V012_PCB_Pictures/Main_Board_Mockup_For_Display_Board_V1.00_071424.JPG
