DRWJSCHMIDT/T41/T41_V012_Files/T41_V012_PCB_Pictures/Main_Board_Partial_2.JPG

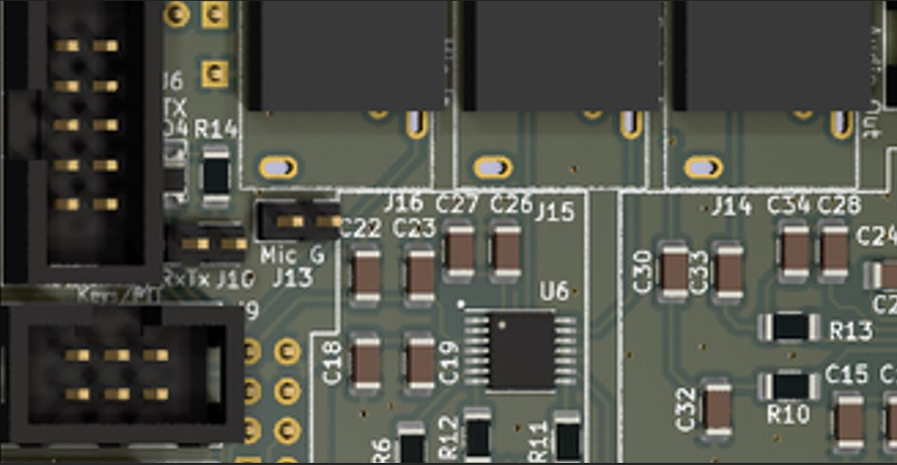
T41_V012_Files/T41_V012_PCB_Pictures/Main_Board_Partial_2.JPG
