DRWJSCHMIDT/T41/T41_V012_Files/T41_V012_PCB_Pictures/Mic_Connection_Picture.jpg

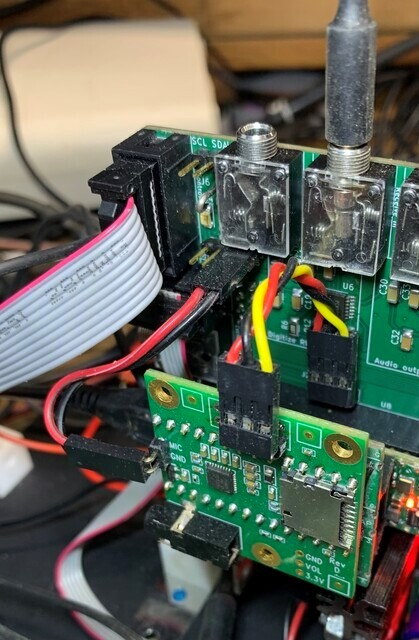
T41_V012_Files/T41_V012_PCB_Pictures/Mic_Connection_Picture.jpg
