DRWJSCHMIDT/T41/T41_V012_Files/T41_V012_PCB_Pictures/Oscillator Board spots for TCXOs.png

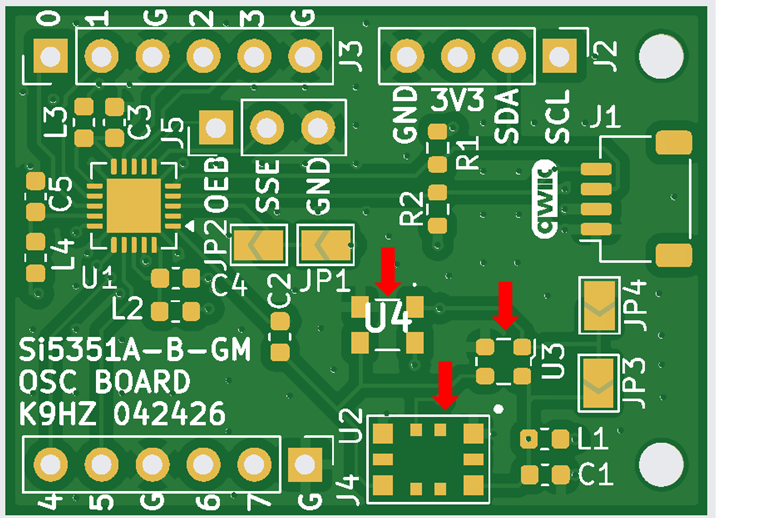
T41_V012_Files/T41_V012_PCB_Pictures/Oscillator Board spots for TCXOs.png
