DRWJSCHMIDT/T41/T41_V012_Files/T41_V012_PCB_Pictures/Oscillator Daughter Board BOTTOM 042426.png

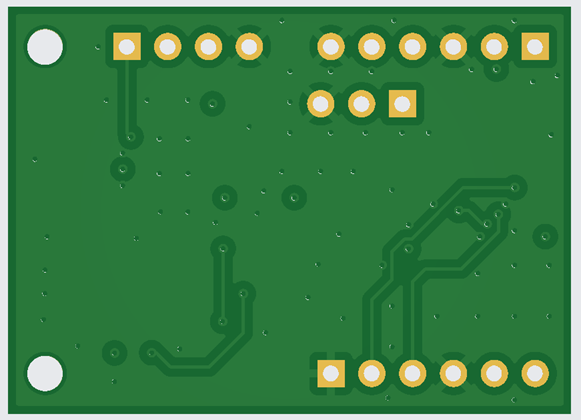
T41_V012_Files/T41_V012_PCB_Pictures/Oscillator Daughter Board BOTTOM 042426.png
