DRWJSCHMIDT/T41/T41_V012_Files/T41_V012_PCB_Pictures/RF Amp on V12.8 Board 070626.gif

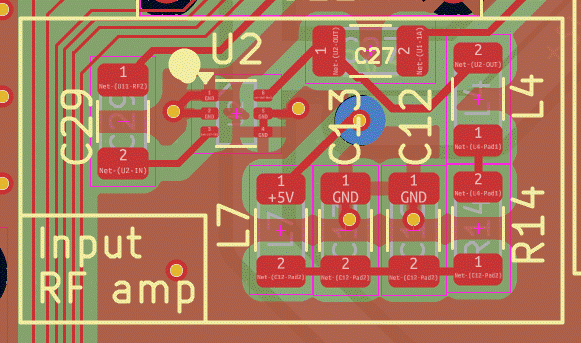
T41_V012_Files/T41_V012_PCB_Pictures/RF Amp on V12.8 Board 070626.gif
