DRWJSCHMIDT/T41/T41_V012_Files/T41_V012_PCB_Pictures/Si5340 Oscillator TOP 071526.gif

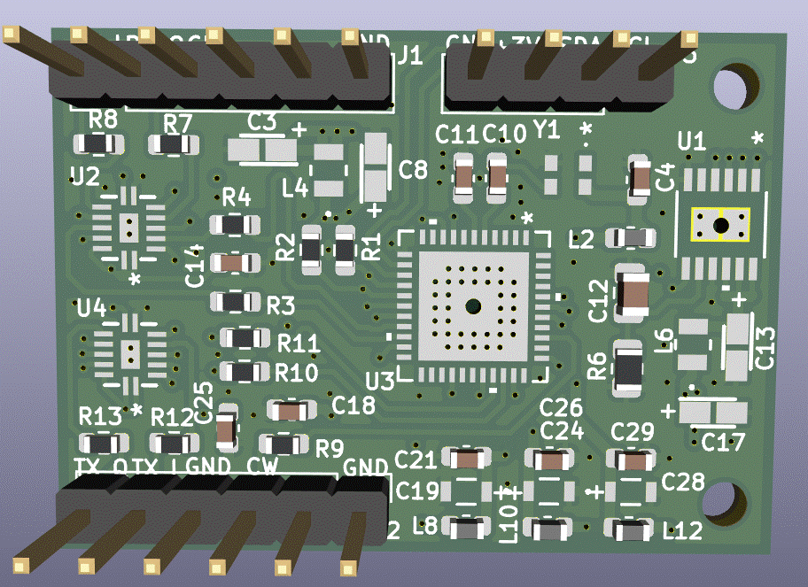
T41_V012_Files/T41_V012_PCB_Pictures/Si5340 Oscillator TOP 071526.gif
