DRWJSCHMIDT/T41/T41_V012_Files/T41_V012_PCB_Pictures/Single Attenuator Daughter Board 041026.png

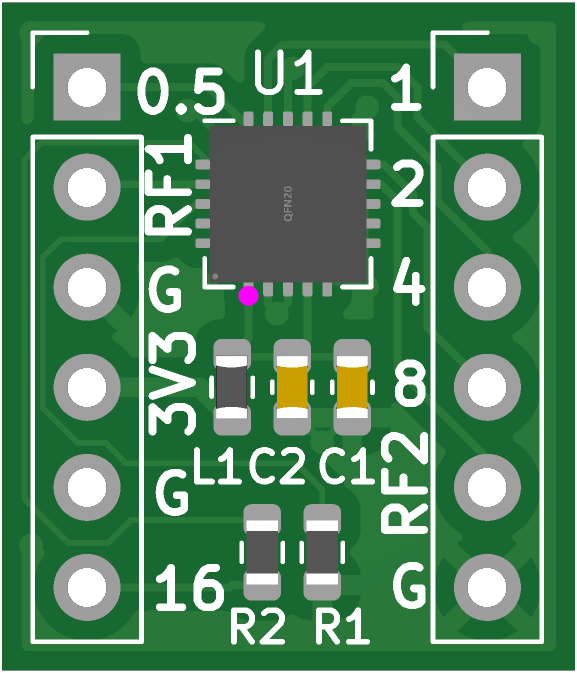
T41_V012_Files/T41_V012_PCB_Pictures/Single Attenuator Daughter Board 041026.png
