DRWJSCHMIDT/T41/T41_V012_Files/T41_V012_PCB_Pictures/T41 V12.8 RF Board 062626.jpg

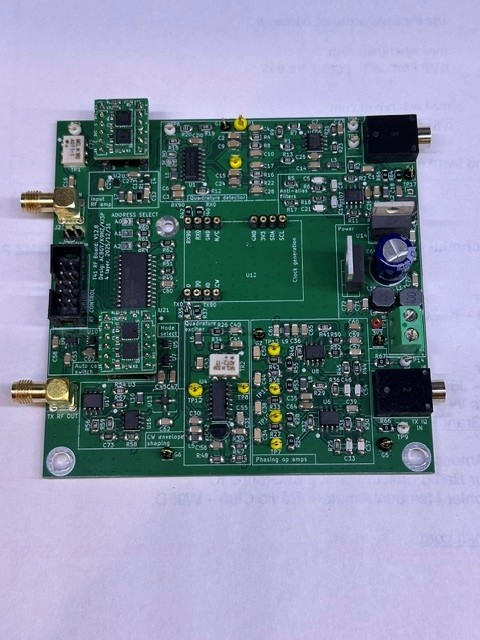
T41_V012_Files/T41_V012_PCB_Pictures/T41 V12.8 RF Board 062626.jpg
