DRWJSCHMIDT/T41/T41_V012_Files/T41_V012_PCB_Pictures/T41-main-board-V012-2D_01-16-24.png

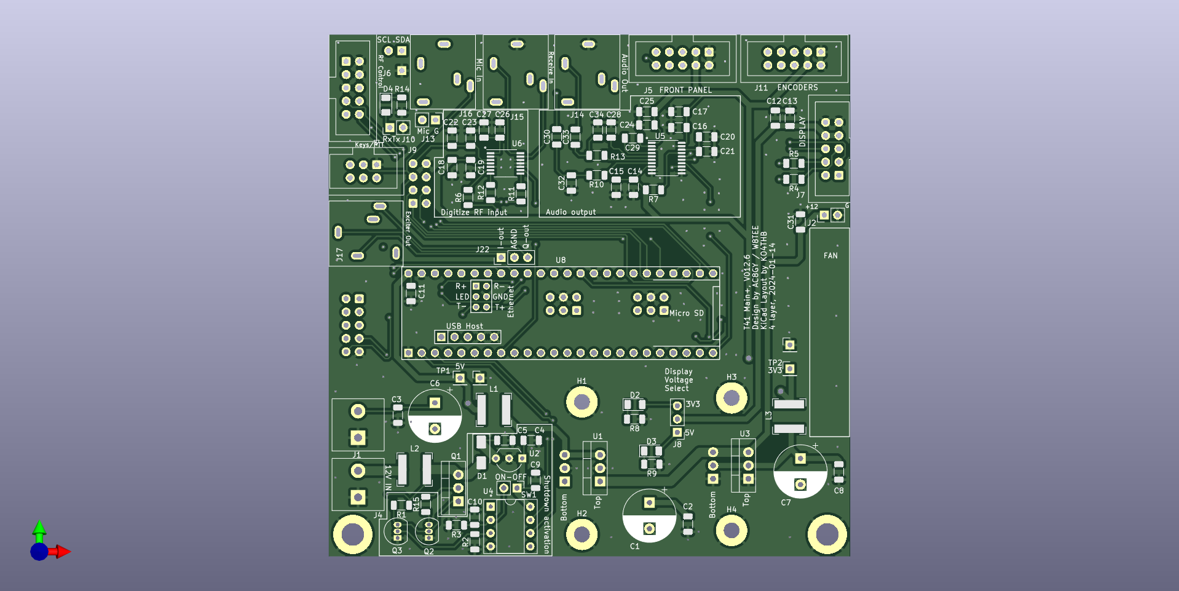
T41_V012_Files/T41_V012_PCB_Pictures/T41-main-board-V012-2D_01-16-24.png
