DRWJSCHMIDT/T41/T41_V012_Files/T41_V012_PCB_Pictures/T41-RF-board-Attenuator-daughterboard_back.png

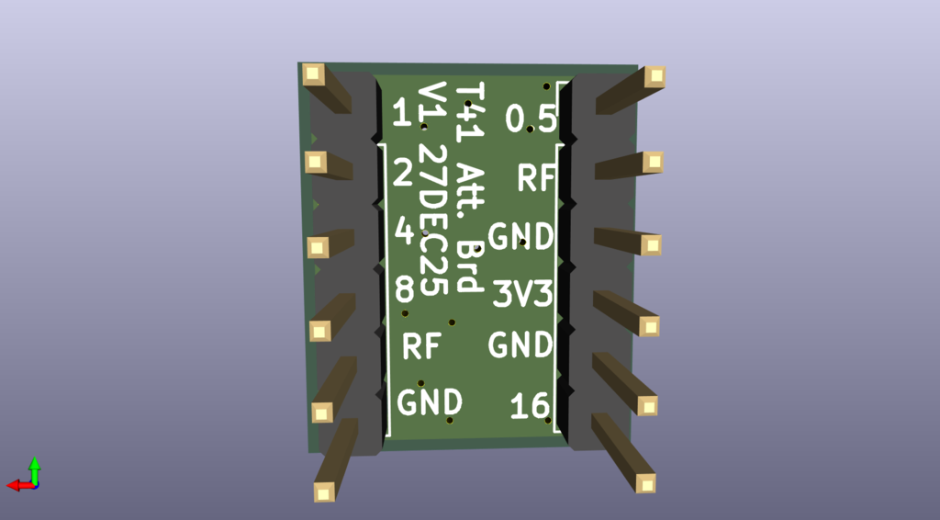
T41_V012_Files/T41_V012_PCB_Pictures/T41-RF-board-Attenuator-daughterboard_back.png
