DRWJSCHMIDT/T41/T41_V012_Files/T41_V012_PCB_Pictures/T41-RF-board-V012-2D_01-05-25.png

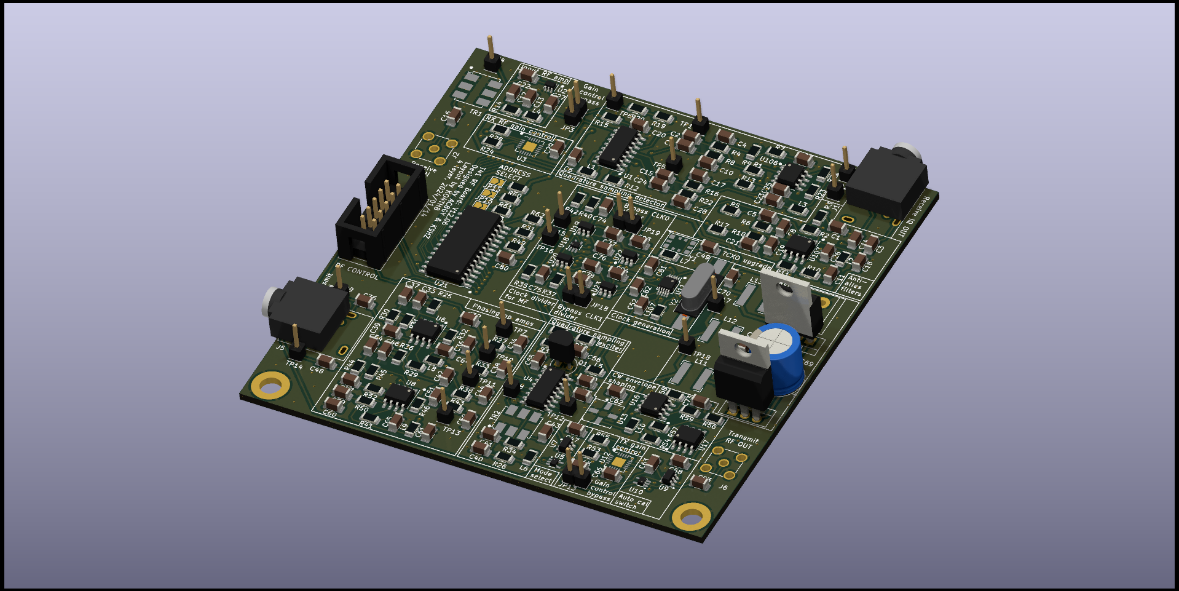
T41_V012_Files/T41_V012_PCB_Pictures/T41-RF-board-V012-2D_01-05-25.png
