DRWJSCHMIDT/T41/T41_V012_Files/T41_V012_PCB_Pictures/T41-RF-Board-V12-si5351-daughterboard_010526.png

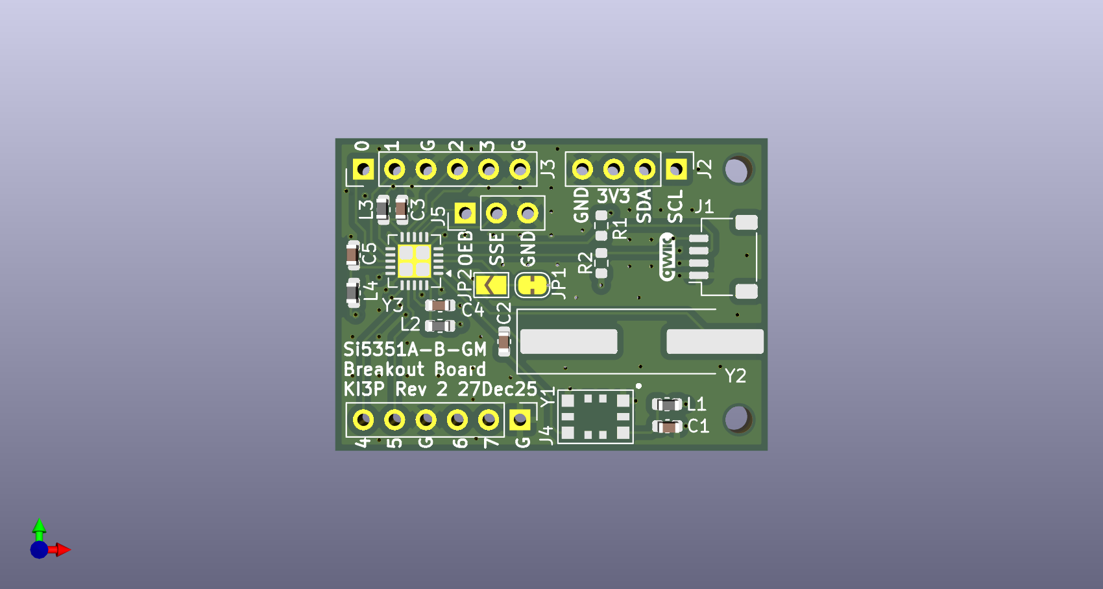
T41_V012_Files/T41_V012_PCB_Pictures/T41-RF-Board-V12-si5351-daughterboard_010526.png
