DRWJSCHMIDT/T41/T41_V012_Files/T41_V012_PCB_Pictures/T41-RF-board-V012.7_010526.png

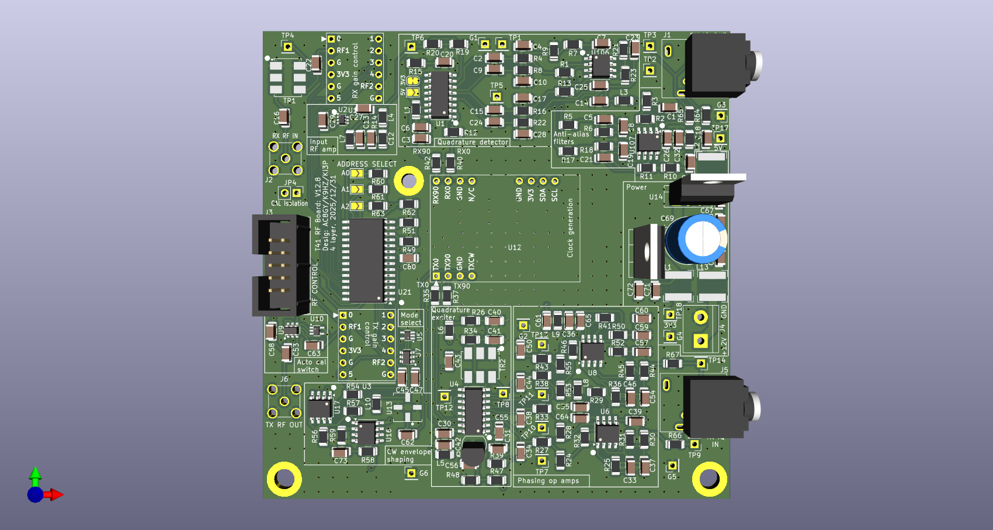
T41_V012_Files/T41_V012_PCB_Pictures/T41-RF-board-V012.7_010526.png
