DRWJSCHMIDT/T41/T41_V012_Files/T41_V012_PCB_Pictures/T41-V12.8-si5351A-B-GM-Oscillator-daughterboard_050626.png

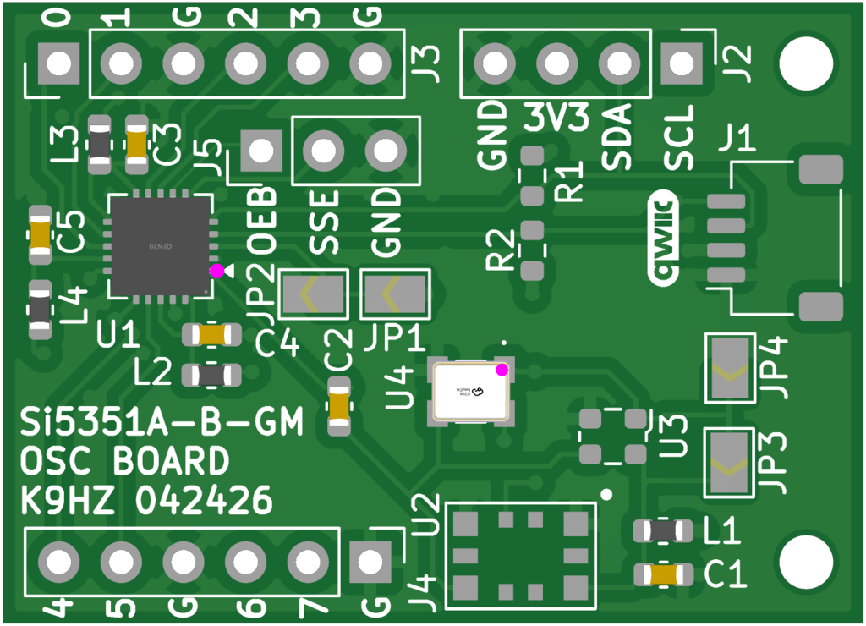
T41_V012_Files/T41_V012_PCB_Pictures/T41-V12.8-si5351A-B-GM-Oscillator-daughterboard_050626.png
