DRWJSCHMIDT/T41/T41_V012_Files/T41_V012_PCB_Pictures/T41_BPF_Board_V012_Top_012624.png

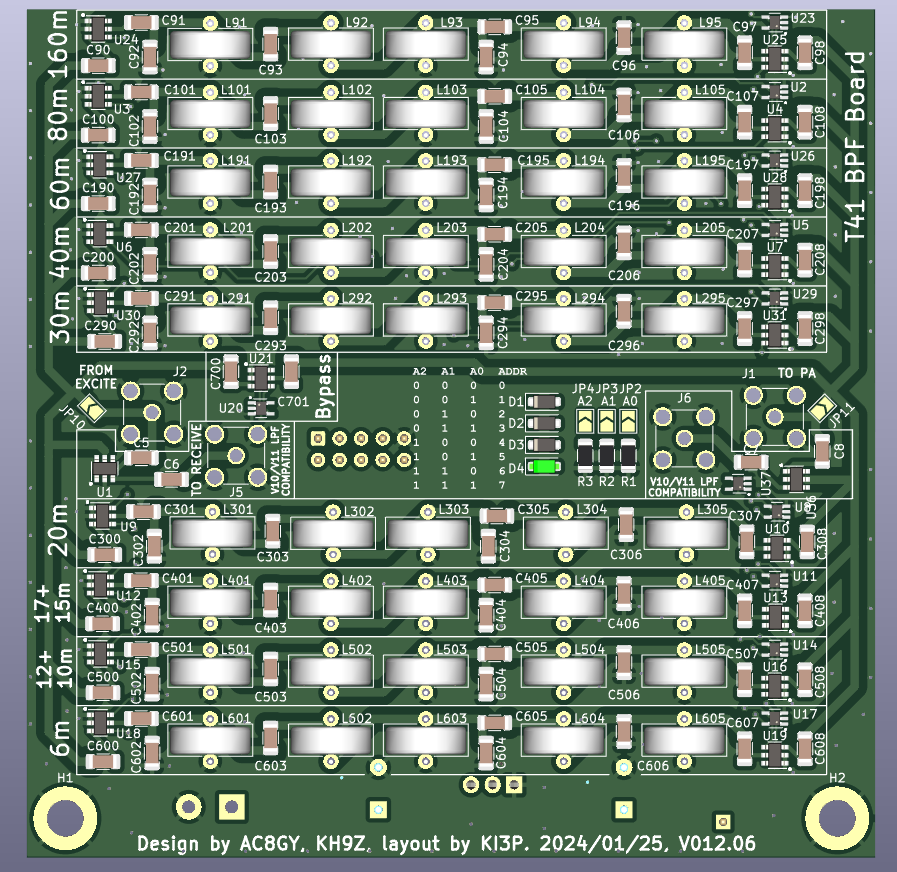
T41_V012_Files/T41_V012_PCB_Pictures/T41_BPF_Board_V012_Top_012624.png
