DRWJSCHMIDT/T41/T41_V012_Files/T41_V012_PCB_Pictures/T41_Display_Adapter_KiCad-top.png

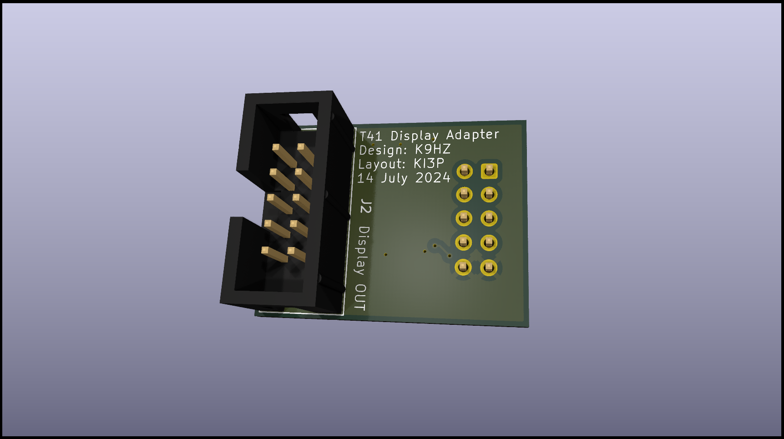
T41_V012_Files/T41_V012_PCB_Pictures/T41_Display_Adapter_KiCad-top.png
