DRWJSCHMIDT/T41/T41_V012_Files/T41_V012_PCB_Pictures/T41_RF_Board_V012.6_Top_01-25-24.png

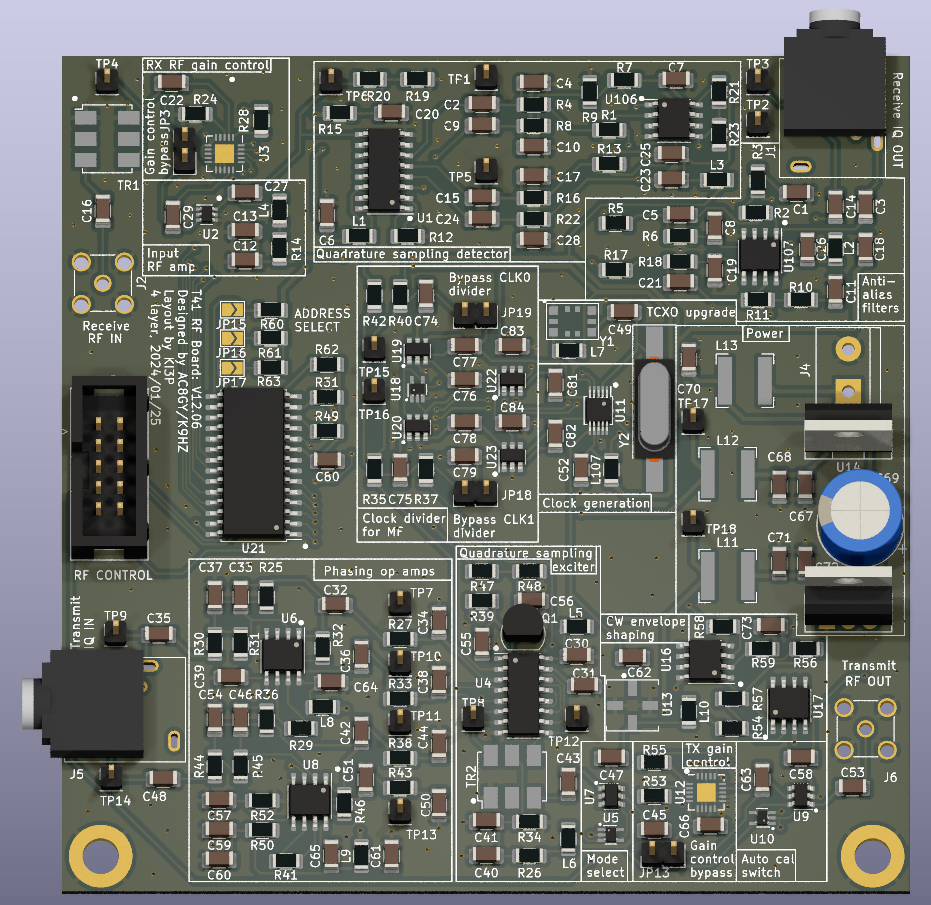
T41_V012_Files/T41_V012_PCB_Pictures/T41_RF_Board_V012.6_Top_01-25-24.png
