DRWJSCHMIDT/T41/T41_V012_Files/T41_V012_PCB_Pictures/T41_Second_Rx_Adapter_Board_V12.6_04-14-24.png

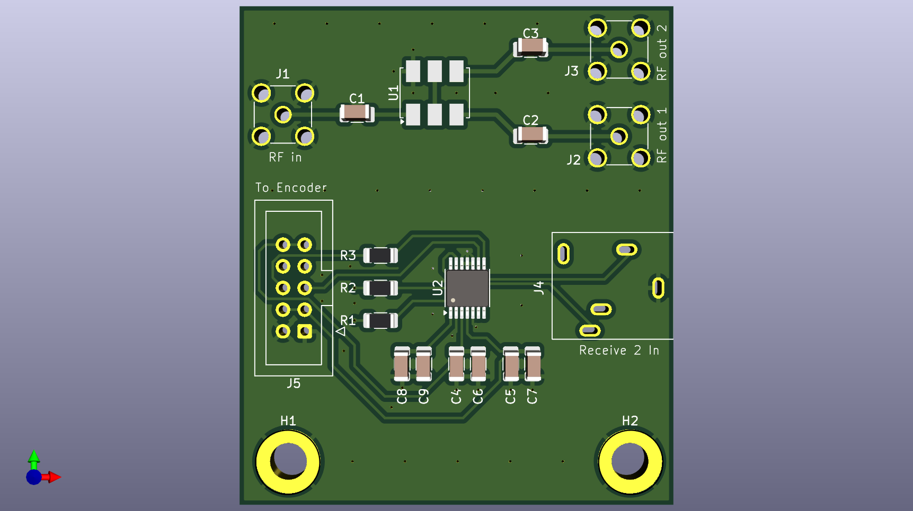
T41_V012_Files/T41_V012_PCB_Pictures/T41_Second_Rx_Adapter_Board_V12.6_04-14-24.png
