DRWJSCHMIDT/T41/T41_V012_Files/T41_V012_PCB_Pictures/T41_V12_BPF_Board_Finished_032424.jpg

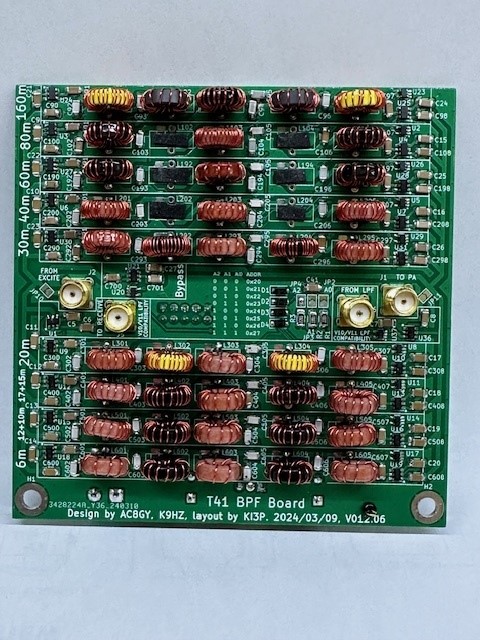
T41_V012_Files/T41_V012_PCB_Pictures/T41_V12_BPF_Board_Finished_032424.jpg
