DRWJSCHMIDT/T41/T41_V012_Files/T41_V012_PCB_Pictures/T41_V012_Fully_Functional_RF_Board_02-14-24.jpg

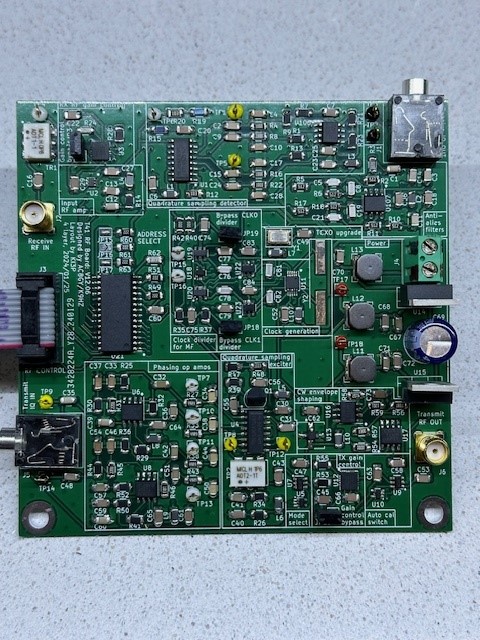
T41_V012_Files/T41_V012_PCB_Pictures/T41_V012_Fully_Functional_RF_Board_02-14-24.jpg
