DRWJSCHMIDT/T41/T41_V012_Files/T41_V012_PCB_Pictures/T41_V12_Main_Board_Blank_Bottom_042624.JPG

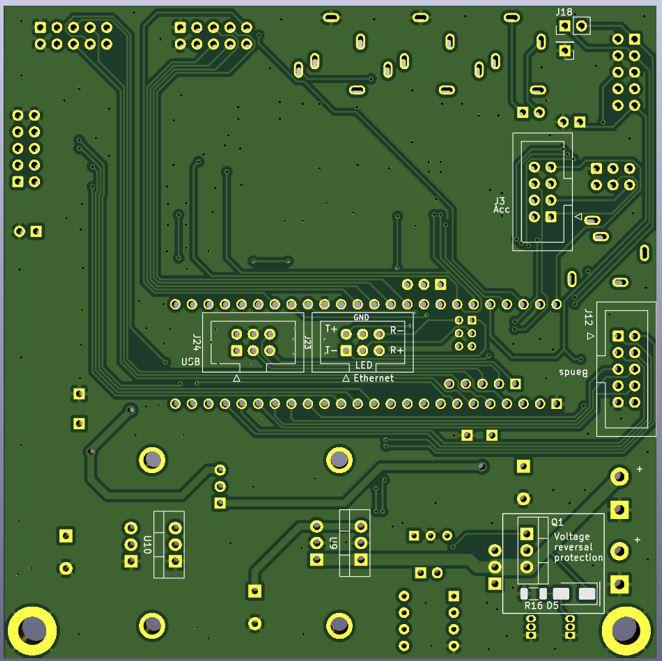
T41_V012_Files/T41_V012_PCB_Pictures/T41_V12_Main_Board_Blank_Bottom_042624.JPG
