DRWJSCHMIDT/T41/T41_V012_Files/T41_V012_PCB_Pictures/T41_V012_Second_RX_Adapter_Blank_Board_070924.jpg

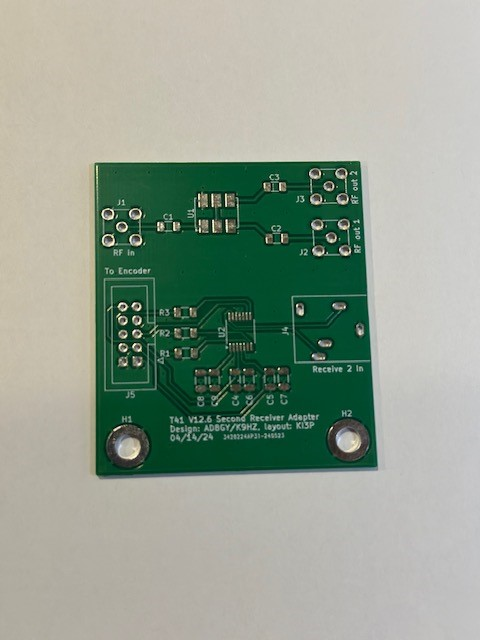
T41_V012_Files/T41_V012_PCB_Pictures/T41_V012_Second_RX_Adapter_Blank_Board_070924.jpg
