DRWJSCHMIDT/T41/T41_V012_Files/T41_V012_PCB_Pictures/T41_V12_Teensy_Audio_Hat_042924.JPG

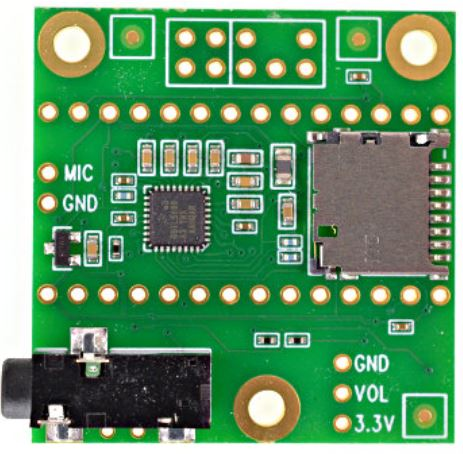
T41_V012_Files/T41_V012_PCB_Pictures/T41_V12_Teensy_Audio_Hat_042924.JPG
