DRWJSCHMIDT/T41/T41_V012_Files/T41_V012_PCBs/T41_V012_PCBs_KiCad/T41-BPF-filter-board-V12.6/T41-exciter-filter-board-BOTTOM-v2.png

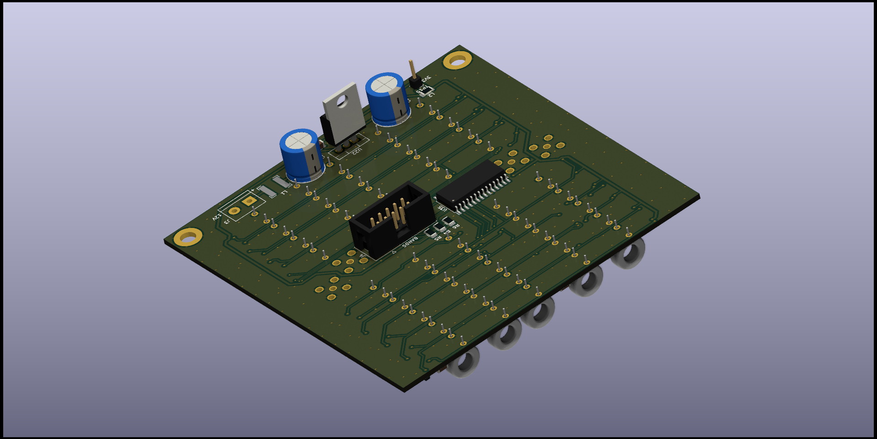
T41_V012_Files/T41_V012_PCBs/T41_V012_PCBs_KiCad/T41-BPF-filter-board-V12.6/T41-exciter-filter-board-BOTTOM-v2.png
