DRWJSCHMIDT/T41/T41_V012_Files/T41_V012_PCBs/T41_V012_PCBs_KiCad/T41-RF-board-Dual-Attenuator-daughterboard-OH5KB/T41-RF-board-Dual-Attenuator-daughterboard-back.png

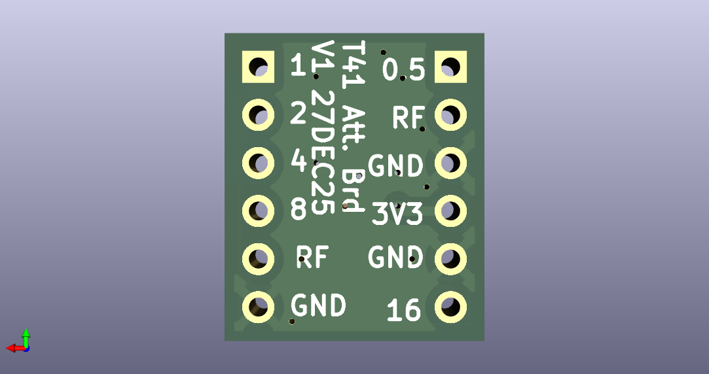
T41_V012_Files/T41_V012_PCBs/T41_V012_PCBs_KiCad/T41-RF-board-Dual-Attenuator-daughterboard-OH5KB/T41-RF-board-Dual-Attenuator-daughterboard-back.png
