DRWJSCHMIDT/T41/T41_V012_Files/T41_V012_PCBs/T41_V012_PCBs_KiCad/T41-RF-board-DualClock-daughterboard-OH5KB/DualClockLO.png

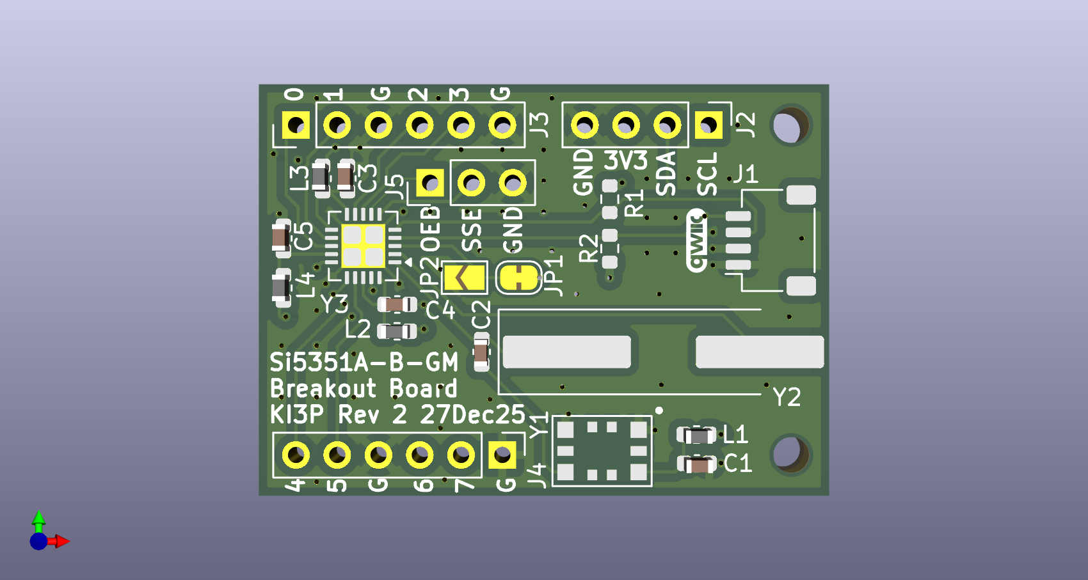
T41_V012_Files/T41_V012_PCBs/T41_V012_PCBs_KiCad/T41-RF-board-DualClock-daughterboard-OH5KB/DualClockLO.png
