DRWJSCHMIDT/T41/T41_V012_Mini_Files/T41_V012_Mini_Board Pictures/T41-Main+RF-board-V012 Front.png

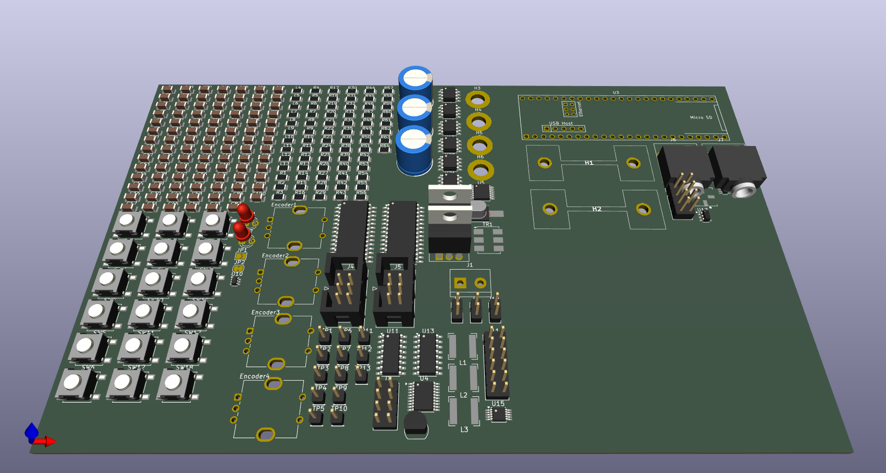
T41_V012_Mini_Files/T41_V012_Mini_Board Pictures/T41-Main+RF-board-V012 Front.png
