DRWJSCHMIDT/T41/T41_V012_Files/T41_V012_BOMs/T41_RF_Board_BOM_V012.8_09-26-26.pdf

Qty | Description | Designator | Mouser Part # | Digikey Part # TaydaElectronics Price (USD) Ext.: (USD)

15 10uF 50V SMD 1206 Capacitor

C1, C3, C11, C12, C14, C32, C35, C36, C39, C41, C42, C57,
C60, C67, C71 | 80-C1206C106K4P | 0.14 $ | 2.09 $
4 | 1uF 50V SMD 1206 Capacitor | C2, C9, C15, C24 | 187-CL31B105KBHNNNE | $ | 0.15 $ | 0.60
2 | 2.2 nF 50V SMD 1206 Capacitor | C33, C46 | 80-C1206C222K5R | $ | 0.13 $ | 0.26
6 | 10 nF 50V SMD 1206 Capacitor | C4, C10, C17, C28, C37, C54 | 80-C1206C103J5RAC | $ | 0.11 $ | 0.66
2 | 105pF 50V SMD 1206 Capacitor | C5, C21 | 581-12065C101KAT2A | $ | 0.17 $ | 0.34
2 | 180pF 50V SMD 1206 Capacitor | C8, C19 | 791-1206B181K160CT | $ | 0.17 $ | 0.34

33 0.1uF 50V SMD 1206 Capacitor

| | C6, C7, C13, C16, C18, C20, C22, C23, C25, C26, C27, C29,
| | C30, C31, C40, C43, C45, C47, C53, C55, C56, C58, C59, C61,
C62, C63, C64, C65, C68, C70, C72, C73, C80 | C1206C104K5RACTU | 0.05 $ | 1.78 $
4 | 0.2uF 50V SMD 1206 Capacitor | C34, C38, C44, C50 | 581-12065C204KAT4A | $ | 0.38 $ | 1.52
1 | 470uF 25V Aluminum Electroylitic Cap C69 | 667-ECA-1EM471 | $ | 0.39 $ | 0.39
2 | IQ_Out, IQ_In, 1/8" Stereo Jack | J1, J5 | 490-SJ1-3515N | $ | 1.41 $ | 2.82
2 | RF_IN, RF_OUT SMA Female | J2, J6 | 712-CONSMA001-G | $ | 3.35 $ | 6.70
1 | RFControl - IDC 2x5 Box Male Index | J3 | A-2939 | $ | 0.14 $ | 0.14
1 | 12-13.8V - Molex Terminal Block | J4 | 538-39880-4302 | $ | 1.12 $ | 1.12
1 | Calibration Enable - IDC 1x2 | JP4 | A-4662/ A-5770 | $ | 0.02 $ | 0.02
8 | FB SMD 1206 600 Ohm 1A | L1, L2, L3, L5, L6, L7, L8, L9 | 875-HZ1206E601R-10 | $ | 0.14 $ | 1.12
2 | 1.5uH SMD 1206 Inductor | L4, L10 | 81-LQM31PN1R5M00L | $ | 0.35 $ | 0.70
3 | 10uH 20% SMD 2424 Inductor | L11, L12, L13 | 70-IFSC2020DER100M01 490-10814-1-ND | $ | 0.47 $ | 1.41
1 | BS170 TO-92 Transistor | Q1 | 512-BS170 | $ | 0.37 $ | 0.37
2 | 2K Ohm SMD 1206 Resistor | R1, R13 | 667-ERA-8AEB202V | $ | 0.59 $ | 1.18
8 | 5.1K Ohm SMD 1206 Resistor | R2, R3, R5, R6, R10, R11, R17, R18 | 652-CR1206JW-512ELF | $ | 0.10 $ | 0.80
5 | 100 Ohm SMD 1206 Resistor | R4, R8, R16, R22, R54 | 652-CR1206FX-1000ELF | $ | 0.10 $ | 0.50
12 | 10K Ohm SMD 1206 Resistor | R7, R9, R12, R15, R19, R20, R21, R23, R30, R39, R44, R47 | 652-CR1206JW-103ELF | $ | 0.02 $ | 0.20
1 | 36.5 Ohm SMD 1206 Resistor | R14 | 71-CRCW120636.5-E3 | $ | 0.10 $ | 0.10
6 | 10K Ohm 1% SMD 1206 Resistor | R25, R29, R32, R36, R41, R46 | 652-CR1206FX-1002ELF | $ | 0.10 $ | 0.60
9 | 2.2K Ohm SMD 1206 Resistor | R26, R34, R49, R50, R51, R60, R61, R62, R63 | 71-CRCW12062K20JNEAC | $ | 0.04 $ | 0.32
2 | 1.1k Ohm SMD 1206 Resistor | R52, R59 | 652-CR1206FX-1101ELF | $ | 0.10 $ | 0.20
4 | 49.9 Ohm 1% SMD 1206 Resistor | R27, R33, R38, R43 | 71-CRCW120649R9FKEAC | $ | 0.10 $ | 0.40
2 | 2.2K Ohm 1% SMD 1206 Resistor | R31, R45 | 652-CR1206FX-2201ELF | $ | 0.10 $ | 0.20
12 | 0 Ohm SMD 1206 Resistor | R24, R28, R35, R37, R40, R42, R53, R55, R64, R65, R66, R67 603-RC1206FR-130RL | $ | 0.02 $ | 0.25
2 | 100K Ohm SMD 1206 Resistor | R48, R73 | 71-CRCW1206100KFKEAC | $ | 0.10 $ | 0.20
1 | 1.6K Ohm SMD 1206 Resistor | R56 | 652-CR1206FX-1601ELF | $ | 0.10 $ | 0.10

1 | 330 Ohm SMD 1206 Resistor | R57 | 652-CR1206FX-3300ELF | | $ | 0.10 $ | 0.10
1 | 51K Ohm SMD 1206 Resistor | R58 | 652-CR1206FX-5102ELF | | $ | 0.10 $ | 0.10

### 16 TestPoint

| | TP1, TP2, TP3, TP4, TP5, TP6, TP7, TP8, TP9, TP10, TP11,
TP12, TP13, TP14, TP17, TP18 | A-4662 | 0.03 $ | 0.45 $
1 | ADT1-1+ | TR1 | 139-ADT1-1 | | $ | 4.02 $ | 4.02
1 | ADT2-1T+ | TR2 | 139-ADT2-1T | | $ | 5.17 $ | 5.17
2 | 74CBTLV3253DR in SOIC-16 | U1, U4 | 595-74CBTLV3253DR | 296-9132-1-ND | $ | 0.85 $ | 1.70
1 | PSA-8A+ | U2 | 139-PSA-8A | | $ | 3.60 $ | 3.60
2 | 74LVC1G04DCKR | U5, U10 | 595-SN74LVC1G04DCKR | | $ | 0.33 $ | 0.66
2 | MC33078 | U6, U8 | 595-MC33078DR | | $ | 0.84 $ | 1.68
1 | LM358B | U16 | 595-LM358BIDR | | $ | 0.47 $ | 0.47
2 | MASWSS0179 | U7, U9 | 937-MASWSS0179-T | | $ | 1.03 $ | 2.06
1 | MAR-3SM+ | U13 | 139-MAR-3SM | | $ | 1.87 $ | 1.87
1 | LM7805CT | U14 | 926-LM7805CT | | $ | 2.46 $ | 2.46
1 | LM1117T-3.3 | U15 | 926-LM1117T-3.3/NOPB | | $ | 1.69 $ | 1.69
1 | LM317LIDR | U17 | 595-LM317LIDR | | $ | 0.46 $ | 0.46
1 | MCP23017_SO | U21 | 579-MCP23017-E/SO | | $ | 1.42 $ | 1.42
1 | AD8599 | U106 | 584-AD8599ARZ-R | | $ | 9.96 $ | 9.96
1 | OPA2209 | U107 | 595-OPA2209AIDR | | $ | 4.00 $ | 4.00
1 | Heatsink for U14 | For U14 | Various | 0.70 $ | 0.70 $
2 | Attenuator Modules, premade | U3, U11 | From K9HZ | 5.84 $ | 11.68 $
1 | Oscillator Module, premade | U12 | From K9HZ | 11.74 $ | 11.74 $
197 $ 93.43
| NOTE: R73 is stacked on top of C73
