DRWJSCHMIDT/T41/T41_V012_Files/T41_V012_BOMs/T41_RF_Board_DualClock_BOM_V012.6_031426.pdf

Id | Designator | Footprint | Quantity | Designation | Manufacturer | Manufacturer Number
1 C1, C2, C3, C4, C5 | C_0603_1608Metric | 5 | 0.1uF 50V X7R 0603 SMD | Kemet | C0603C104K5RACTU
2 L1, L2, L3, L4 | R_0603_1608Metric | 4 | Ferrite bead 600 mOhm 1A 0603 SMD | Laird Technologies MI0603J601R-10
3 R1, R2 | R_0603_1608Metric | 2 | 2.2K Ohm 1% 1/8W | Vishay | CRCW06032K20FKEC
4 Y1 | | Oscillator_ECS_TXO53_S3 | 1 | ECS-TX053-S3 | ECS | ECS-TXO53-S3-33-250-BN-TR
5 Y3 | | QFN-20-1EP_4x4mm_P0.5mm_EP2.7x2.7mm | 1 | Clock Generator Si5351A-B-GM | Skyworks | Si5351A-B-GM
