DRWJSCHMIDT/T41/T41_V012_Files/T41_V012_BOMs/T41_Display_Driver_3.3_V2.00_BOM_02-06-25.pdf

Quantity | Part Decription | Part Designator | Mouser PN | TaydaElectronics.com
1 | 0.1uF 50V SMD 1206 Ceramic Capacitor | C1 | 791-SH31B104K160CT
1 | IDC 2x5 Female PCB Socket | J1
1 | IDC 2x5 Keyed Male PCB Socket | J2 | A-2939
2 | 4.7K Ohm SMD 1206 Resistor | R1, R2 | 708-RMCF1206JT4K70
1 | ISO7241MDWR or CDWR | U1 | 595-ISO7241MDWR

### 1 K9HZ Display Driver PCB

7
