DRWJSCHMIDT/T41/T41_V012_Files/T41_V012_BOMs/T41_RF_Board_Option_Cost_V012.6_03-07-25.pdf

# T41 V012.6 RF Board Parts (Less PCB)

SEQUENCE | BUILD OPTION | PARTS | | COST
1 | Base Board | 192 | $ | 71.53
2 | TXCO Option | 4 | $ | 10.10
3 | I2C Control Option | 8 | $ | 2.07
4 | TX Gain Control Option | 4 | $ | 5.41
5 | RX Gain Control Option | 4 | $ | 5.41
| | 212 | $ | 94.52
7 | Built as RX #2 Base Bd | 105 | $ | 52.31
