DRWJSCHMIDT/T41/T41_V012_Files/T41_V012_BOMs/T41_Second_RX_Adapter_Board_BOM_V012.6_04-30-24.pdf

Quantity | Part Decription | Part Designator | Mouser PN | TaydaElectronics.com | Digikey.com | Price (USD) Ext.: (USD) | Comment
6 | 0.1uF 50V SMD 1206 Ceramic Capacitor | C1, C2, C3, C4, C5, C8 C1206C104K5RACTU | $ | 0.05 $ | 0.32
3 | 10uF 16V SMD 1206 Capacitor | C6, C7, C9 | 80-C1206C106K4P | $ | 0.29 $ | 0.87
3 | SMA Female PCB Mount | J1, J2, J3 | 712-CONSMA001-G | $ | 3.35 $ 10.05
1 | 1/8" Female Stereo Jack, PCB Mount | J4 | 490-SJ1-3515N | CP1-3515N-ND $ | 1.41 1.41 $
3 | 100 Ohm SMD 1206 Resistor | R1, R2, R3 | 652-CR1206FX-1000ELF | $ | 0.10 $ | 0.30
1 | ADP-2-1W+ | U1 | 139-ADP-2-1W | $ | 10.02 $ 10.02
1 | PCM1808PWR Stereo ADC TSSOP-14 | U6 | 595-PCM1808PWR | $ | 1.71 $ | 1.71
1 | IDC 2x5 Keyed Male PCB Socket | J5 | A-2939 | $ | 0.14 $ | 0.14
19 $ 24.82
