DRWJSCHMIDT/T41/T41_V012_Files/T41_V012_BOMs/More TXCO oscillators.xlsx

Datasheet | Image | Mfr Part # | Mfr | Description | Stock | Price | Min Qty | Package | Series | Type | Frequency | Function | Output | Voltage - Supply | Frequency Stability | Operating Temperature | Current - Supply (Max) | Package / Case | Supplier Device Package | Size / Dimension | Height - Seated (Max) | URL
https://www.ctscorp.com/Files/DataSheets/Passives/FCP/TCXO/TCXO-526-datasheet.pdf | - | 526L25020CTR | CTS-Frequency Controls | 3.2mm x 2.5mm Surface Mount HCMO | 0 | $1.90 | 3000 | Tape & Reel (TR) | 526 | TCXO | 25 MHz | Standby (Power Down) | HCMOS | 3.3V | ±2ppm | -20°C ~ 70°C | 10mA | 4-SMD, No Lead | 4-SMD (3.2x2.5) | 0.126" L x 0.098" W (3.20mm x 2.50mm) | 0.047" (1.20mm) | https://www.digikey.com/en/products/detail/cts-frequency-controls/526L25020CTR/17086202
https://www.ctscorp.com/Files/DataSheets/Passives/FCP/TCXO/TCXO-526-datasheet.pdf | - | 526L25025DTR | CTS-Frequency Controls | 3.2mm x 2.5mm Surface Mount HCMO | 0 | $1.90 | 3000 | Tape & Reel (TR) | 526 | TCXO | 25 MHz | Standby (Power Down) | HCMOS | 3.3V | ±2.5ppm | -30°C ~ 85°C | 10mA | 4-SMD, No Lead | 4-SMD (3.2x2.5) | 0.126" L x 0.098" W (3.20mm x 2.50mm) | 0.047" (1.20mm) | https://www.digikey.com/en/products/detail/cts-frequency-controls/526L25025DTR/17086290
https://www.ctscorp.com/Files/DataSheets/Passives/FCP/TCXO/TCXO-526-datasheet.pdf | - | 526L25025CTR | CTS-Frequency Controls | 3.2mm x 2.5mm Surface Mount HCMO | 0 | $1.90 | 3000 | Tape & Reel (TR) | 526 | TCXO | 25 MHz | Standby (Power Down) | HCMOS | 3.3V | ±2.5ppm | -20°C ~ 70°C | 10mA | 4-SMD, No Lead | 4-SMD (3.2x2.5) | 0.126" L x 0.098" W (3.20mm x 2.50mm) | 0.047" (1.20mm) | https://www.digikey.com/en/products/detail/cts-frequency-controls/526L25025CTR/17086769
https://www.ctscorp.com/Files/DataSheets/Passives/FCP/TCXO/TCXO-526-datasheet.pdf | - | 526L25025ITR | CTS-Frequency Controls | 3.2mm x 2.5mm Surface Mount HCMO | 0 | $1.90 | 3000 | Tape & Reel (TR) | 526 | TCXO | 25 MHz | Standby (Power Down) | HCMOS | 3.3V | ±2.5ppm | -40°C ~ 85°C | 10mA | 4-SMD, No Lead | 4-SMD (3.2x2.5) | 0.126" L x 0.098" W (3.20mm x 2.50mm) | 0.047" (1.20mm) | https://www.digikey.com/en/products/detail/cts-frequency-controls/526L25025ITR/17089599
https://www.ctscorp.com/Files/DataSheets/Passives/FCP/TCXO/TCXO-521-datasheet.pdf | - | 521L25025DTR | CTS-Frequency Controls | 2.5mm x 2.0mm Surface Mount HCMO | 0 | $1.90 | 3000 | Tape & Reel (TR) | 521 | TCXO | 25 MHz | Standby (Power Down) | HCMOS | 3.3V | ±2.5ppm | -30°C ~ 85°C | 10mA | 4-SMD, No Lead | 4-SMD (3.2x2.5) | 0.098" L x 0.079" W (2.50mm x 2.00mm) | 0.039" (1.00mm) | https://www.digikey.com/en/products/detail/cts-frequency-controls/521L25025DTR/17090418
https://www.ctscorp.com/Files/DataSheets/Passives/FCP/TCXO/TCXO-521-datasheet.pdf | - | 521L25020CTR | CTS-Frequency Controls | 2.5mm x 2.0mm Surface Mount HCMO | 0 | $1.90 | 3000 | Tape & Reel (TR) | 521 | TCXO | 25 MHz | Standby (Power Down) | HCMOS | 3.3V | ±2ppm | -20°C ~ 70°C | 10mA | 4-SMD, No Lead | 4-SMD (3.2x2.5) | 0.098" L x 0.079" W (2.50mm x 2.00mm) | 0.039" (1.00mm) | https://www.digikey.com/en/products/detail/cts-frequency-controls/521L25020CTR/17090428
https://www.ctscorp.com/Files/DataSheets/Passives/FCP/TCXO/TCXO-521-datasheet.pdf | - | 521L25025ITR | CTS-Frequency Controls | 2.5mm x 2.0mm Surface Mount HCMO | 0 | $1.90 | 3000 | Tape & Reel (TR) | 521 | TCXO | 25 MHz | Standby (Power Down) | HCMOS | 3.3V | ±2.5ppm | -40°C ~ 85°C | 10mA | 4-SMD, No Lead | 4-SMD (3.2x2.5) | 0.098" L x 0.079" W (2.50mm x 2.00mm) | 0.039" (1.00mm) | https://www.digikey.com/en/products/detail/cts-frequency-controls/521L25025ITR/17091236
https://www.ctscorp.com/Files/DataSheets/Passives/FCP/TCXO/TCXO-521-datasheet.pdf | - | 521L25025CTR | CTS-Frequency Controls | 2.5mm x 2.0mm Surface Mount HCMO | 0 | $1.90 | 3000 | Tape & Reel (TR) | 521 | TCXO | 25 MHz | Standby (Power Down) | HCMOS | 3.3V | ±2.5ppm | -20°C ~ 70°C | 10mA | 4-SMD, No Lead | 4-SMD (3.2x2.5) | 0.098" L x 0.079" W (2.50mm x 2.00mm) | 0.039" (1.00mm) | https://www.digikey.com/en/products/detail/cts-frequency-controls/521L25025CTR/17094374
https://www.ctscorp.com/Files/DataSheets/Passives/FCP/TCXO/TCXO-520-datasheet.pdf | - | 520L25015ITR | CTS-Frequency Controls | 2.5mm x 2.0mm Surface Mount Clip | 0 | $1.94 | 3000 | Tape & Reel (TR) | 520 | TCXO | 25 MHz | - | Clipped Sine Wave | 3.3V | ±1.5ppm | -40°C ~ 85°C | 2mA | 4-SMD, No Lead | 4-SMD (2.5x2) | 0.098" L x 0.079" W (2.50mm x 2.00mm) | 0.039" (1.00mm) | https://www.digikey.com/en/products/detail/cts-frequency-controls/520L25015ITR/17086476
https://www.ctscorp.com/Files/DataSheets/Passives/FCP/TCXO/TCXO-520-datasheet.pdf | - | 520L25020CTR | CTS-Frequency Controls | 2.5mm x 2.0mm Surface Mount Clip | 0 | $1.94 | 3000 | Tape & Reel (TR) | 520 | TCXO | 25 MHz | - | Clipped Sine Wave | 3.3V | ±2ppm | -20°C ~ 70°C | 2mA | 4-SMD, No Lead | 4-SMD (2.5x2) | 0.098" L x 0.079" W (2.50mm x 2.00mm) | 0.039" (1.00mm) | https://www.digikey.com/en/products/detail/cts-frequency-controls/520L25020CTR/17086577
https://www.ctscorp.com/Files/DataSheets/Passives/FCP/TCXO/TCXO-520-datasheet.pdf | - | 520L25010DTR | CTS-Frequency Controls | 2.5mm x 2.0mm Surface Mount Clip | 0 | $1.94 | 3000 | Tape & Reel (TR) | 520 | TCXO | 25 MHz | - | Clipped Sine Wave | 3.3V | ±1ppm | -30°C ~ 85°C | 2mA | 4-SMD, No Lead | 4-SMD (2.5x2) | 0.098" L x 0.079" W (2.50mm x 2.00mm) | 0.039" (1.00mm) | https://www.digikey.com/en/products/detail/cts-frequency-controls/520L25010DTR/17096580
https://www.ctscorp.com/Files/DataSheets/Passives/FCP/TCXO/TCXO-520-datasheet.pdf | - | 520L25015CTR | CTS-Frequency Controls | 2.5mm x 2.0mm Surface Mount Clip | 0 | $1.94 | 3000 | Tape & Reel (TR) | 520 | TCXO | 25 MHz | - | Clipped Sine Wave | 3.3V | ±1.5ppm | -20°C ~ 70°C | 2mA | 4-SMD, No Lead | 4-SMD (2.5x2) | 0.098" L x 0.079" W (2.50mm x 2.00mm) | 0.039" (1.00mm) | https://www.digikey.com/en/products/detail/cts-frequency-controls/520L25015CTR/17097129
https://www.ctscorp.com/Files/DataSheets/Passives/FCP/TCXO/TCXO-520-datasheet.pdf | - | 520L25010CTR | CTS-Frequency Controls | 2.5mm x 2.0mm Surface Mount Clip | 0 | $1.94 | 3000 | Tape & Reel (TR) | 520 | TCXO | 25 MHz | - | Clipped Sine Wave | 3.3V | ±1ppm | -20°C ~ 70°C | 2mA | 4-SMD, No Lead | 4-SMD (2.5x2) | 0.098" L x 0.079" W (2.50mm x 2.00mm) | 0.039" (1.00mm) | https://www.digikey.com/en/products/detail/cts-frequency-controls/520L25010CTR/17097227
https://www.ctscorp.com/Files/DataSheets/Passives/FCP/TCXO/TCXO-520-datasheet.pdf | - | 520L25015DTR | CTS-Frequency Controls | 2.5mm x 2.0mm Surface Mount Clip | 0 | $1.94 | 3000 | Tape & Reel (TR) | 520 | TCXO | 25 MHz | - | Clipped Sine Wave | 3.3V | ±1.5ppm | -30°C ~ 85°C | 2mA | 4-SMD, No Lead | 4-SMD (2.5x2) | 0.098" L x 0.079" W (2.50mm x 2.00mm) | 0.039" (1.00mm) | https://www.digikey.com/en/products/detail/cts-frequency-controls/520L25015DTR/17098783
https://www.ctscorp.com/Files/DataSheets/Passives/FCP/TCXO/TCXO-520-datasheet.pdf | - | 520L25005CTR | CTS-Frequency Controls | 2.5mm x 2.0mm Surface Mount Clip | 0 | $1.94 | 3000 | Tape & Reel (TR) | 520 | TCXO | 25 MHz | - | Clipped Sine Wave | 3.3V | ±500ppb | -20°C ~ 70°C | 2mA | 4-SMD, No Lead | 4-SMD (2.5x2) | 0.098" L x 0.079" W (2.50mm x 2.00mm) | 0.039" (1.00mm) | https://www.digikey.com/en/products/detail/cts-frequency-controls/520L25005CTR/17100149
https://www.ctscorp.com/Files/DataSheets/Passives/FCP/TCXO/TCXO-520-datasheet.pdf | - | 520L25005DTR | CTS-Frequency Controls | 2.5mm x 2.0mm Surface Mount Clip | 0 | $1.94 | 3000 | Tape & Reel (TR) | 520 | TCXO | 25 MHz | - | Clipped Sine Wave | 3.3V | ±500ppb | -30°C ~ 85°C | 2mA | 4-SMD, No Lead | 4-SMD (2.5x2) | 0.098" L x 0.079" W (2.50mm x 2.00mm) | 0.039" (1.00mm) | https://www.digikey.com/en/products/detail/cts-frequency-controls/520L25005DTR/17100160
https://ecsxtal.com/store/pdf/ECS-TXO-2016.pdf | //mm.digikey.com/Volume0/opasdata/d220001/medias/images/189/MFG_ECS-OSCILLATOR-4SMD-NOLEADS.jpg | ECS-TXO-2016-33-250-TR | ECS Inc. | XTAL OSC TCXO 25MHZ 3.3V SMD | 0 | $2.00 | 1 | Tape & Reel (TR),Cut Tape (CT),Digi-Reel® | ECS-TXO-2016 | TCXO | 25 MHz | Enable/Disable | HCMOS | 3.3V | ±2.5ppm | -40°C ~ 85°C | 5.5mA | 4-SMD, No Lead | 4-SMD (2x1.6) | 0.079" L x 0.063" W (2.00mm x 1.60mm) | 0.031" (0.80mm) | https://www.digikey.com/en/products/detail/ecs-inc/ECS-TXO-2016-33-250-TR/10244138
https://www.ctscorp.com/Files/DataSheets/Passives/FCP/TCXO/TCXO-525-datasheet.pdf | - | 525R25010CTR | CTS-Frequency Controls | 3.2mm x 2.5mm Surface Mount Clip | 0 | $2.10 | 3000 | Tape & Reel (TR) | 525 | TCXO | 25 MHz | - | Clipped Sine Wave | 3.3V | ±1ppm | -20°C ~ 70°C | 2mA | 4-SMD, No Lead | 4-SMD (3.2x2.5) | 0.126" L x 0.098" W (3.20mm x 2.50mm) | 0.047" (1.20mm) | https://www.digikey.com/en/products/detail/cts-frequency-controls/525R25010CTR/17086266
https://www.ctscorp.com/Files/DataSheets/Passives/FCP/TCXO/TCXO-525-datasheet.pdf | - | 525R25025ITR | CTS-Frequency Controls | 3.2mm x 2.5mm Surface Mount Clip | 0 | $2.10 | 3000 | Tape & Reel (TR) | 525 | TCXO | 25 MHz | - | Clipped Sine Wave | 3.3V | ±2.5ppm | -40°C ~ 85°C | 2mA | 4-SMD, No Lead | 4-SMD (3.2x2.5) | 0.126" L x 0.098" W (3.20mm x 2.50mm) | 0.047" (1.20mm) | https://www.digikey.com/en/products/detail/cts-frequency-controls/525R25025ITR/17086485
https://www.ctscorp.com/Files/DataSheets/Passives/FCP/TCXO/TCXO-525-datasheet.pdf | - | 525R25005DTR | CTS-Frequency Controls | 3.2mm x 2.5mm Surface Mount Clip | 0 | $2.10 | 3000 | Tape & Reel (TR) | 525 | TCXO | 25 MHz | - | Clipped Sine Wave | 3.3V | ±500ppb | -30°C ~ 85°C | 2mA | 4-SMD, No Lead | 4-SMD (3.2x2.5) | 0.126" L x 0.098" W (3.20mm x 2.50mm) | 0.047" (1.20mm) | https://www.digikey.com/en/products/detail/cts-frequency-controls/525R25005DTR/17086496
https://www.ctscorp.com/Files/DataSheets/Passives/FCP/TCXO/TCXO-525-datasheet.pdf | - | 525L25015DTR | CTS-Frequency Controls | 3.2mm x 2.5mm Surface Mount Clip | 0 | $2.10 | 3000 | Tape & Reel (TR) | 525 | TCXO | 25 MHz | - | Clipped Sine Wave | 3.3V | ±1.5ppm | -30°C ~ 85°C | 2mA | 4-SMD, No Lead | 4-SMD (3.2x2.5) | 0.126" L x 0.098" W (3.20mm x 2.50mm) | 0.047" (1.20mm) | https://www.digikey.com/en/products/detail/cts-frequency-controls/525L25015DTR/17087051
https://www.ctscorp.com/Files/DataSheets/Passives/FCP/TCXO/TCXO-525-datasheet.pdf | - | 525L25005CTR | CTS-Frequency Controls | 3.2mm x 2.5mm Surface Mount Clip | 0 | $2.10 | 3000 | Tape & Reel (TR) | 525 | TCXO | 25 MHz | - | Clipped Sine Wave | 3.3V | ±500ppb | -20°C ~ 70°C | 2mA | 4-SMD, No Lead | 4-SMD (3.2x2.5) | 0.126" L x 0.098" W (3.20mm x 2.50mm) | 0.047" (1.20mm) | https://www.digikey.com/en/products/detail/cts-frequency-controls/525L25005CTR/17087144
https://www.ctscorp.com/Files/DataSheets/Passives/FCP/TCXO/TCXO-525-datasheet.pdf | - | 525L25010CTR | CTS-Frequency Controls | 3.2mm x 2.5mm Surface Mount Clip | 0 | $2.10 | 3000 | Tape & Reel (TR) | 525 | TCXO | 25 MHz | - | Clipped Sine Wave | 3.3V | ±1ppm | -20°C ~ 70°C | 2mA | 4-SMD, No Lead | 4-SMD (3.2x2.5) | 0.126" L x 0.098" W (3.20mm x 2.50mm) | 0.047" (1.20mm) | https://www.digikey.com/en/products/detail/cts-frequency-controls/525L25010CTR/17087371
https://www.ctscorp.com/Files/DataSheets/Passives/FCP/TCXO/TCXO-525-datasheet.pdf | - | 525R25010ITR | CTS-Frequency Controls | 3.2mm x 2.5mm Surface Mount Clip | 0 | $2.10 | 3000 | Tape & Reel (TR) | 525 | TCXO | 25 MHz | - | Clipped Sine Wave | 3.3V | ±1ppm | -40°C ~ 85°C | 2mA | 4-SMD, No Lead | 4-SMD (3.2x2.5) | 0.126" L x 0.098" W (3.20mm x 2.50mm) | 0.047" (1.20mm) | https://www.digikey.com/en/products/detail/cts-frequency-controls/525R25010ITR/17087705
https://www.ctscorp.com/Files/DataSheets/Passives/FCP/TCXO/TCXO-525-datasheet.pdf | - | 525R25005CTR | CTS-Frequency Controls | 3.2mm x 2.5mm Surface Mount Clip | 0 | $2.10 | 3000 | Tape & Reel (TR) | 525 | TCXO | 25 MHz | - | Clipped Sine Wave | 3.3V | ±500ppb | -20°C ~ 70°C | 2mA | 4-SMD, No Lead | 4-SMD (3.2x2.5) | 0.126" L x 0.098" W (3.20mm x 2.50mm) | 0.047" (1.20mm) | https://www.digikey.com/en/products/detail/cts-frequency-controls/525R25005CTR/17087725
https://www.ctscorp.com/Files/DataSheets/Passives/FCP/TCXO/TCXO-525-datasheet.pdf | - | 525R25010DTR | CTS-Frequency Controls | 3.2mm x 2.5mm Surface Mount Clip | 0 | $2.10 | 3000 | Tape & Reel (TR) | 525 | TCXO | 25 MHz | - | Clipped Sine Wave | 3.3V | ±1ppm | -30°C ~ 85°C | 2mA | 4-SMD, No Lead | 4-SMD (3.2x2.5) | 0.126" L x 0.098" W (3.20mm x 2.50mm) | 0.047" (1.20mm) | https://www.digikey.com/en/products/detail/cts-frequency-controls/525R25010DTR/17088133
https://www.ctscorp.com/Files/DataSheets/Passives/FCP/TCXO/TCXO-525-datasheet.pdf | - | 525L25010DTR | CTS-Frequency Controls | 3.2mm x 2.5mm Surface Mount Clip | 0 | $2.10 | 3000 | Tape & Reel (TR) | 525 | TCXO | 25 MHz | - | Clipped Sine Wave | 3.3V | ±1ppm | -30°C ~ 85°C | 2mA | 4-SMD, No Lead | 4-SMD (3.2x2.5) | 0.126" L x 0.098" W (3.20mm x 2.50mm) | 0.047" (1.20mm) | https://www.digikey.com/en/products/detail/cts-frequency-controls/525L25010DTR/17088327
https://www.ctscorp.com/Files/DataSheets/Passives/FCP/TCXO/TCXO-525-datasheet.pdf | - | 525L25005DTR | CTS-Frequency Controls | 3.2mm x 2.5mm Surface Mount Clip | 0 | $2.10 | 3000 | Tape & Reel (TR) | 525 | TCXO | 25 MHz | - | Clipped Sine Wave | 3.3V | ±500ppb | -30°C ~ 85°C | 2mA | 4-SMD, No Lead | 4-SMD (3.2x2.5) | 0.126" L x 0.098" W (3.20mm x 2.50mm) | 0.047" (1.20mm) | https://www.digikey.com/en/products/detail/cts-frequency-controls/525L25005DTR/17088379
https://www.ctscorp.com/Files/DataSheets/Passives/FCP/TCXO/TCXO-525-datasheet.pdf | - | 525R25020CTR | CTS-Frequency Controls | 3.2mm x 2.5mm Surface Mount Clip | 0 | $2.10 | 3000 | Tape & Reel (TR) | 525 | TCXO | 25 MHz | - | Clipped Sine Wave | 3.3V | ±2ppm | -20°C ~ 70°C | 2mA | 4-SMD, No Lead | 4-SMD (3.2x2.5) | 0.126" L x 0.098" W (3.20mm x 2.50mm) | 0.047" (1.20mm) | https://www.digikey.com/en/products/detail/cts-frequency-controls/525R25020CTR/17088796
https://www.ctscorp.com/Files/DataSheets/Passives/FCP/TCXO/TCXO-525-datasheet.pdf | - | 525R25015DTR | CTS-Frequency Controls | 3.2mm x 2.5mm Surface Mount Clip | 0 | $2.10 | 3000 | Tape & Reel (TR) | 525 | TCXO | 25 MHz | - | Clipped Sine Wave | 3.3V | ±1.5ppm | -30°C ~ 85°C | 2mA | 4-SMD, No Lead | 4-SMD (3.2x2.5) | 0.126" L x 0.098" W (3.20mm x 2.50mm) | 0.047" (1.20mm) | https://www.digikey.com/en/products/detail/cts-frequency-controls/525R25015DTR/17088939
https://www.ctscorp.com/Files/DataSheets/Passives/FCP/TCXO/TCXO-525-datasheet.pdf | - | 525L25015CTR | CTS-Frequency Controls | 3.2mm x 2.5mm Surface Mount Clip | 0 | $2.10 | 3000 | Tape & Reel (TR) | 525 | TCXO | 25 MHz | - | Clipped Sine Wave | 3.3V | ±1.5ppm | -20°C ~ 70°C | 2mA | 4-SMD, No Lead | 4-SMD (3.2x2.5) | 0.126" L x 0.098" W (3.20mm x 2.50mm) | 0.047" (1.20mm) | https://www.digikey.com/en/products/detail/cts-frequency-controls/525L25015CTR/17088970
https://www.ctscorp.com/Files/DataSheets/Passives/FCP/TCXO/TCXO-525-datasheet.pdf | - | 525R25020DTR | CTS-Frequency Controls | 3.2mm x 2.5mm Surface Mount Clip | 0 | $2.10 | 3000 | Tape & Reel (TR) | 525 | TCXO | 25 MHz | - | Clipped Sine Wave | 3.3V | ±2ppm | -30°C ~ 85°C | 2mA | 4-SMD, No Lead | 4-SMD (3.2x2.5) | 0.126" L x 0.098" W (3.20mm x 2.50mm) | 0.047" (1.20mm) | https://www.digikey.com/en/products/detail/cts-frequency-controls/525R25020DTR/17089508
https://www.ctscorp.com/Files/DataSheets/Passives/FCP/TCXO/TCXO-525-datasheet.pdf | - | 525R25020ITR | CTS-Frequency Controls | 3.2mm x 2.5mm Surface Mount Clip | 0 | $2.10 | 3000 | Tape & Reel (TR) | 525 | TCXO | 25 MHz | - | Clipped Sine Wave | 3.3V | ±2ppm | -40°C ~ 85°C | 2mA | 4-SMD, No Lead | 4-SMD (3.2x2.5) | 0.126" L x 0.098" W (3.20mm x 2.50mm) | 0.047" (1.20mm) | https://www.digikey.com/en/products/detail/cts-frequency-controls/525R25020ITR/17089514
https://www.ctscorp.com/Files/DataSheets/Passives/FCP/TCXO/TCXO-525-datasheet.pdf | - | 525R25015ITR | CTS-Frequency Controls | 3.2mm x 2.5mm Surface Mount Clip | 0 | $2.10 | 3000 | Tape & Reel (TR) | 525 | TCXO | 25 MHz | - | Clipped Sine Wave | 3.3V | ±1.5ppm | -40°C ~ 85°C | 2mA | 4-SMD, No Lead | 4-SMD (3.2x2.5) | 0.126" L x 0.098" W (3.20mm x 2.50mm) | 0.047" (1.20mm) | https://www.digikey.com/en/products/detail/cts-frequency-controls/525R25015ITR/17089520
https://www.ctscorp.com/Files/DataSheets/Passives/FCP/TCXO/TCXO-525-datasheet.pdf | - | 525R25025DTR | CTS-Frequency Controls | 3.2mm x 2.5mm Surface Mount Clip | 0 | $2.10 | 3000 | Tape & Reel (TR) | 525 | TCXO | 25 MHz | - | Clipped Sine Wave | 3.3V | ±2.5ppm | -30°C ~ 85°C | 2mA | 4-SMD, No Lead | 4-SMD (3.2x2.5) | 0.126" L x 0.098" W (3.20mm x 2.50mm) | 0.047" (1.20mm) | https://www.digikey.com/en/products/detail/cts-frequency-controls/525R25025DTR/17089559
https://www.ctscorp.com/Files/DataSheets/Passives/FCP/TCXO/TCXO-525-datasheet.pdf | - | 525R25015CTR | CTS-Frequency Controls | 3.2mm x 2.5mm Surface Mount Clip | 0 | $2.10 | 3000 | Tape & Reel (TR) | 525 | TCXO | 25 MHz | - | Clipped Sine Wave | 3.3V | ±1.5ppm | -20°C ~ 70°C | 2mA | 4-SMD, No Lead | 4-SMD (3.2x2.5) | 0.126" L x 0.098" W (3.20mm x 2.50mm) | 0.047" (1.20mm) | https://www.digikey.com/en/products/detail/cts-frequency-controls/525R25015CTR/17089583
https://www.ctscorp.com/Files/DataSheets/Passives/FCP/TCXO/TCXO-525-datasheet.pdf | - | 525R25025CTR | CTS-Frequency Controls | 3.2mm x 2.5mm Surface Mount Clip | 0 | $2.10 | 3000 | Tape & Reel (TR) | 525 | TCXO | 25 MHz | - | Clipped Sine Wave | 3.3V | ±2.5ppm | -20°C ~ 70°C | 2mA | 4-SMD, No Lead | 4-SMD (3.2x2.5) | 0.126" L x 0.098" W (3.20mm x 2.50mm) | 0.047" (1.20mm) | https://www.digikey.com/en/products/detail/cts-frequency-controls/525R25025CTR/17089932
https://www.ctscorp.com/Files/DataSheets/Passives/FCP/TCXO/TCXO-525-datasheet.pdf | - | 525N25015CTR | CTS-Frequency Controls | 3.2mm x 2.5mm Surface Mount Clip | 0 | $2.10 | 3000 | Tape & Reel (TR) | 525 | TCXO | 25 MHz | - | Clipped Sine Wave | 3.3V | ±1.5ppm | -20°C ~ 70°C | 2mA | 4-SMD, No Lead | 4-SMD (3.2x2.5) | 0.126" L x 0.098" W (3.20mm x 2.50mm) | 0.047" (1.20mm) | https://www.digikey.com/en/products/detail/cts-frequency-controls/525N25015CTR/17090343
https://www.ctscorp.com/Files/DataSheets/Passives/FCP/TCXO/TCXO-525-datasheet.pdf | - | 525N25020ITR | CTS-Frequency Controls | 3.2mm x 2.5mm Surface Mount Clip | 0 | $2.10 | 3000 | Tape & Reel (TR) | 525 | TCXO | 25 MHz | - | Clipped Sine Wave | 3.3V | ±2ppm | -40°C ~ 85°C | 2mA | 4-SMD, No Lead | 4-SMD (3.2x2.5) | 0.126" L x 0.098" W (3.20mm x 2.50mm) | 0.047" (1.20mm) | https://www.digikey.com/en/products/detail/cts-frequency-controls/525N25020ITR/17090467
https://www.ctscorp.com/Files/DataSheets/Passives/FCP/TCXO/TCXO-525-datasheet.pdf | - | 525N25005DTR | CTS-Frequency Controls | 3.2mm x 2.5mm Surface Mount Clip | 0 | $2.10 | 3000 | Tape & Reel (TR) | 525 | TCXO | 25 MHz | - | Clipped Sine Wave | 3.3V | ±500ppb | -30°C ~ 85°C | 2mA | 4-SMD, No Lead | 4-SMD (3.2x2.5) | 0.126" L x 0.098" W (3.20mm x 2.50mm) | 0.047" (1.20mm) | https://www.digikey.com/en/products/detail/cts-frequency-controls/525N25005DTR/17090593
https://www.ctscorp.com/Files/DataSheets/Passives/FCP/TCXO/TCXO-525-datasheet.pdf | - | 525N25010ITR | CTS-Frequency Controls | 3.2mm x 2.5mm Surface Mount Clip | 0 | $2.10 | 3000 | Tape & Reel (TR) | 525 | TCXO | 25 MHz | - | Clipped Sine Wave | 3.3V | ±1ppm | -40°C ~ 85°C | 2mA | 4-SMD, No Lead | 4-SMD (3.2x2.5) | 0.126" L x 0.098" W (3.20mm x 2.50mm) | 0.047" (1.20mm) | https://www.digikey.com/en/products/detail/cts-frequency-controls/525N25010ITR/17090821
https://www.ctscorp.com/Files/DataSheets/Passives/FCP/TCXO/TCXO-525-datasheet.pdf | - | 525N25025CTR | CTS-Frequency Controls | 3.2mm x 2.5mm Surface Mount Clip | 0 | $2.10 | 3000 | Tape & Reel (TR) | 525 | TCXO | 25 MHz | - | Clipped Sine Wave | 3.3V | ±2.5ppm | -20°C ~ 70°C | 2mA | 4-SMD, No Lead | 4-SMD (3.2x2.5) | 0.126" L x 0.098" W (3.20mm x 2.50mm) | 0.047" (1.20mm) | https://www.digikey.com/en/products/detail/cts-frequency-controls/525N25025CTR/17090997
https://www.ctscorp.com/Files/DataSheets/Passives/FCP/TCXO/TCXO-525-datasheet.pdf | - | 525L25025DTR | CTS-Frequency Controls | 3.2mm x 2.5mm Surface Mount Clip | 0 | $2.10 | 3000 | Tape & Reel (TR) | 525 | TCXO | 25 MHz | - | Clipped Sine Wave | 3.3V | ±2.5ppm | -30°C ~ 85°C | 2mA | 4-SMD, No Lead | 4-SMD (3.2x2.5) | 0.126" L x 0.098" W (3.20mm x 2.50mm) | 0.047" (1.20mm) | https://www.digikey.com/en/products/detail/cts-frequency-controls/525L25025DTR/17091019
https://www.ctscorp.com/Files/DataSheets/Passives/FCP/TCXO/TCXO-525-datasheet.pdf | - | 525N25010DTR | CTS-Frequency Controls | 3.2mm x 2.5mm Surface Mount Clip | 0 | $2.10 | 3000 | Tape & Reel (TR) | 525 | TCXO | 25 MHz | - | Clipped Sine Wave | 3.3V | ±1ppm | -30°C ~ 85°C | 2mA | 4-SMD, No Lead | 4-SMD (3.2x2.5) | 0.126" L x 0.098" W (3.20mm x 2.50mm) | 0.047" (1.20mm) | https://www.digikey.com/en/products/detail/cts-frequency-controls/525N25010DTR/17091283
https://www.ctscorp.com/Files/DataSheets/Passives/FCP/TCXO/TCXO-525-datasheet.pdf | - | 525N25025DTR | CTS-Frequency Controls | 3.2mm x 2.5mm Surface Mount Clip | 0 | $2.10 | 3000 | Tape & Reel (TR) | 525 | TCXO | 25 MHz | - | Clipped Sine Wave | 3.3V | ±2.5ppm | -30°C ~ 85°C | 2mA | 4-SMD, No Lead | 4-SMD (3.2x2.5) | 0.126" L x 0.098" W (3.20mm x 2.50mm) | 0.047" (1.20mm) | https://www.digikey.com/en/products/detail/cts-frequency-controls/525N25025DTR/17092085
https://www.ctscorp.com/Files/DataSheets/Passives/FCP/TCXO/TCXO-525-datasheet.pdf | - | 525L25025CTR | CTS-Frequency Controls | 3.2mm x 2.5mm Surface Mount Clip | 0 | $2.10 | 3000 | Tape & Reel (TR) | 525 | TCXO | 25 MHz | - | Clipped Sine Wave | 3.3V | ±2.5ppm | -20°C ~ 70°C | 2mA | 4-SMD, No Lead | 4-SMD (3.2x2.5) | 0.126" L x 0.098" W (3.20mm x 2.50mm) | 0.047" (1.20mm) | https://www.digikey.com/en/products/detail/cts-frequency-controls/525L25025CTR/17092328
https://www.ctscorp.com/Files/DataSheets/Passives/FCP/TCXO/TCXO-525-datasheet.pdf | - | 525L25020DTR | CTS-Frequency Controls | 3.2mm x 2.5mm Surface Mount Clip | 0 | $2.10 | 3000 | Tape & Reel (TR) | 525 | TCXO | 25 MHz | - | Clipped Sine Wave | 3.3V | ±2ppm | -30°C ~ 85°C | 2mA | 4-SMD, No Lead | 4-SMD (3.2x2.5) | 0.126" L x 0.098" W (3.20mm x 2.50mm) | 0.047" (1.20mm) | https://www.digikey.com/en/products/detail/cts-frequency-controls/525L25020DTR/17092880
https://www.ctscorp.com/Files/DataSheets/Passives/FCP/TCXO/TCXO-525-datasheet.pdf | - | 525N25005CTR | CTS-Frequency Controls | 3.2mm x 2.5mm Surface Mount Clip | 0 | $2.10 | 3000 | Tape & Reel (TR) | 525 | TCXO | 25 MHz | - | Clipped Sine Wave | 3.3V | ±500ppb | -20°C ~ 70°C | 2mA | 4-SMD, No Lead | 4-SMD (3.2x2.5) | 0.126" L x 0.098" W (3.20mm x 2.50mm) | 0.047" (1.20mm) | https://www.digikey.com/en/products/detail/cts-frequency-controls/525N25005CTR/17093184
https://www.ctscorp.com/Files/DataSheets/Passives/FCP/TCXO/TCXO-525-datasheet.pdf | - | 525N25020CTR | CTS-Frequency Controls | 3.2mm x 2.5mm Surface Mount Clip | 0 | $2.10 | 3000 | Tape & Reel (TR) | 525 | TCXO | 25 MHz | - | Clipped Sine Wave | 3.3V | ±2ppm | -20°C ~ 70°C | 2mA | 4-SMD, No Lead | 4-SMD (3.2x2.5) | 0.126" L x 0.098" W (3.20mm x 2.50mm) | 0.047" (1.20mm) | https://www.digikey.com/en/products/detail/cts-frequency-controls/525N25020CTR/17093249
https://www.ctscorp.com/Files/DataSheets/Passives/FCP/TCXO/TCXO-525-datasheet.pdf | - | 525N25020DTR | CTS-Frequency Controls | 3.2mm x 2.5mm Surface Mount Clip | 0 | $2.10 | 3000 | Tape & Reel (TR) | 525 | TCXO | 25 MHz | - | Clipped Sine Wave | 3.3V | ±2ppm | -30°C ~ 85°C | 2mA | 4-SMD, No Lead | 4-SMD (3.2x2.5) | 0.126" L x 0.098" W (3.20mm x 2.50mm) | 0.047" (1.20mm) | https://www.digikey.com/en/products/detail/cts-frequency-controls/525N25020DTR/17093281
https://www.ctscorp.com/Files/DataSheets/Passives/FCP/TCXO/TCXO-525-datasheet.pdf | - | 525L25020ITR | CTS-Frequency Controls | 3.2mm x 2.5mm Surface Mount Clip | 0 | $2.10 | 3000 | Tape & Reel (TR) | 525 | TCXO | 25 MHz | - | Clipped Sine Wave | 3.3V | ±2ppm | -40°C ~ 85°C | 2mA | 4-SMD, No Lead | 4-SMD (3.2x2.5) | 0.126" L x 0.098" W (3.20mm x 2.50mm) | 0.047" (1.20mm) | https://www.digikey.com/en/products/detail/cts-frequency-controls/525L25020ITR/17093812
https://www.ctscorp.com/Files/DataSheets/Passives/FCP/TCXO/TCXO-525-datasheet.pdf | - | 525L25020CTR | CTS-Frequency Controls | 3.2mm x 2.5mm Surface Mount Clip | 0 | $2.10 | 3000 | Tape & Reel (TR) | 525 | TCXO | 25 MHz | - | Clipped Sine Wave | 3.3V | ±2ppm | -20°C ~ 70°C | 2mA | 4-SMD, No Lead | 4-SMD (3.2x2.5) | 0.126" L x 0.098" W (3.20mm x 2.50mm) | 0.047" (1.20mm) | https://www.digikey.com/en/products/detail/cts-frequency-controls/525L25020CTR/17093833
https://www.ctscorp.com/Files/DataSheets/Passives/FCP/TCXO/TCXO-525-datasheet.pdf | - | 525N25015DTR | CTS-Frequency Controls | 3.2mm x 2.5mm Surface Mount Clip | 0 | $2.10 | 3000 | Tape & Reel (TR) | 525 | TCXO | 25 MHz | - | Clipped Sine Wave | 3.3V | ±1.5ppm | -30°C ~ 85°C | 2mA | 4-SMD, No Lead | 4-SMD (3.2x2.5) | 0.126" L x 0.098" W (3.20mm x 2.50mm) | 0.047" (1.20mm) | https://www.digikey.com/en/products/detail/cts-frequency-controls/525N25015DTR/17093913
https://www.ctscorp.com/Files/DataSheets/Passives/FCP/TCXO/TCXO-525-datasheet.pdf | - | 525L25015ITR | CTS-Frequency Controls | 3.2mm x 2.5mm Surface Mount Clip | 0 | $2.10 | 3000 | Tape & Reel (TR) | 525 | TCXO | 25 MHz | - | Clipped Sine Wave | 3.3V | ±1.5ppm | -40°C ~ 85°C | 2mA | 4-SMD, No Lead | 4-SMD (3.2x2.5) | 0.126" L x 0.098" W (3.20mm x 2.50mm) | 0.047" (1.20mm) | https://www.digikey.com/en/products/detail/cts-frequency-controls/525L25015ITR/17094103
https://www.ctscorp.com/Files/DataSheets/Passives/FCP/TCXO/TCXO-525-datasheet.pdf | - | 525N25010CTR | CTS-Frequency Controls | 3.2mm x 2.5mm Surface Mount Clip | 0 | $2.10 | 3000 | Tape & Reel (TR) | 525 | TCXO | 25 MHz | - | Clipped Sine Wave | 3.3V | ±1ppm | -20°C ~ 70°C | 2mA | 4-SMD, No Lead | 4-SMD (3.2x2.5) | 0.126" L x 0.098" W (3.20mm x 2.50mm) | 0.047" (1.20mm) | https://www.digikey.com/en/products/detail/cts-frequency-controls/525N25010CTR/17094284
https://www.ctscorp.com/Files/DataSheets/Passives/FCP/TCXO/TCXO-525-datasheet.pdf | - | 525N25015ITR | CTS-Frequency Controls | 3.2mm x 2.5mm Surface Mount Clip | 0 | $2.10 | 3000 | Tape & Reel (TR) | 525 | TCXO | 25 MHz | - | Clipped Sine Wave | 3.3V | ±1.5ppm | -40°C ~ 85°C | 2mA | 4-SMD, No Lead | 4-SMD (3.2x2.5) | 0.126" L x 0.098" W (3.20mm x 2.50mm) | 0.047" (1.20mm) | https://www.digikey.com/en/products/detail/cts-frequency-controls/525N25015ITR/17094633
https://www.ctscorp.com/Files/DataSheets/Passives/FCP/TCXO/TCXO-525-datasheet.pdf | - | 525N25025ITR | CTS-Frequency Controls | 3.2mm x 2.5mm Surface Mount Clip | 0 | $2.10 | 3000 | Tape & Reel (TR) | 525 | TCXO | 25 MHz | - | Clipped Sine Wave | 3.3V | ±2.5ppm | -40°C ~ 85°C | 2mA | 4-SMD, No Lead | 4-SMD (3.2x2.5) | 0.126" L x 0.098" W (3.20mm x 2.50mm) | 0.047" (1.20mm) | https://www.digikey.com/en/products/detail/cts-frequency-controls/525N25025ITR/17094846
https://www.ctscorp.com/Files/DataSheets/Passives/FCP/TCXO/TCXO-525-datasheet.pdf | - | 525L25025ITR | CTS-Frequency Controls | 3.2mm x 2.5mm Surface Mount Clip | 0 | $2.10 | 3000 | Tape & Reel (TR) | 525 | TCXO | 25 MHz | - | Clipped Sine Wave | 3.3V | ±2.5ppm | -40°C ~ 85°C | 2mA | 4-SMD, No Lead | 4-SMD (3.2x2.5) | 0.126" L x 0.098" W (3.20mm x 2.50mm) | 0.047" (1.20mm) | https://www.digikey.com/en/products/detail/cts-frequency-controls/525L25025ITR/17094867
https://www.ctscorp.com/Files/DataSheets/Passives/FCP/TCXO/TCXO-525-datasheet.pdf | - | 525T25025ITR | CTS-Frequency Controls | 3.2mm x 2.5mm Surface Mount Clip | 0 | $2.10 | 3000 | Tape & Reel (TR) | 525 | TCXO | 25 MHz | - | Clipped Sine Wave | 3.3V | ±2.5ppm | -40°C ~ 85°C | 2mA | 4-SMD, No Lead | 4-SMD (3.2x2.5) | 0.126" L x 0.098" W (3.20mm x 2.50mm) | 0.047" (1.20mm) | https://www.digikey.com/en/products/detail/cts-frequency-controls/525T25025ITR/17098997
https://www.ctscorp.com/Files/DataSheets/Passives/FCP/TCXO/TCXO-525-datasheet.pdf | - | 525T25020CTR | CTS-Frequency Controls | 3.2mm x 2.5mm Surface Mount Clip | 0 | $2.10 | 3000 | Tape & Reel (TR) | 525 | TCXO | 25 MHz | - | Clipped Sine Wave | 3.3V | ±2ppm | -20°C ~ 70°C | 2mA | 4-SMD, No Lead | 4-SMD (3.2x2.5) | 0.126" L x 0.098" W (3.20mm x 2.50mm) | 0.047" (1.20mm) | https://www.digikey.com/en/products/detail/cts-frequency-controls/525T25020CTR/17099295
https://www.ctscorp.com/Files/DataSheets/Passives/FCP/TCXO/TCXO-525-datasheet.pdf | - | 525T25015DTR | CTS-Frequency Controls | 3.2mm x 2.5mm Surface Mount Clip | 0 | $2.10 | 3000 | Tape & Reel (TR) | 525 | TCXO | 25 MHz | - | Clipped Sine Wave | 3.3V | ±1.5ppm | -30°C ~ 85°C | 2mA | 4-SMD, No Lead | 4-SMD (3.2x2.5) | 0.126" L x 0.098" W (3.20mm x 2.50mm) | 0.047" (1.20mm) | https://www.digikey.com/en/products/detail/cts-frequency-controls/525T25015DTR/17099328
https://www.ctscorp.com/Files/DataSheets/Passives/FCP/TCXO/TCXO-525-datasheet.pdf | - | 525T25005CTR | CTS-Frequency Controls | 3.2mm x 2.5mm Surface Mount Clip | 0 | $2.10 | 3000 | Tape & Reel (TR) | 525 | TCXO | 25 MHz | - | Clipped Sine Wave | 3.3V | ±500ppb | -20°C ~ 70°C | 2mA | 4-SMD, No Lead | 4-SMD (3.2x2.5) | 0.126" L x 0.098" W (3.20mm x 2.50mm) | 0.047" (1.20mm) | https://www.digikey.com/en/products/detail/cts-frequency-controls/525T25005CTR/17099370
https://www.ctscorp.com/Files/DataSheets/Passives/FCP/TCXO/TCXO-525-datasheet.pdf | - | 525T25010CTR | CTS-Frequency Controls | 3.2mm x 2.5mm Surface Mount Clip | 0 | $2.10 | 3000 | Tape & Reel (TR) | 525 | TCXO | 25 MHz | - | Clipped Sine Wave | 3.3V | ±1ppm | -20°C ~ 70°C | 2mA | 4-SMD, No Lead | 4-SMD (3.2x2.5) | 0.126" L x 0.098" W (3.20mm x 2.50mm) | 0.047" (1.20mm) | https://www.digikey.com/en/products/detail/cts-frequency-controls/525T25010CTR/17099373
https://www.ctscorp.com/Files/DataSheets/Passives/FCP/TCXO/TCXO-525-datasheet.pdf | - | 525T25005DTR | CTS-Frequency Controls | 3.2mm x 2.5mm Surface Mount Clip | 0 | $2.10 | 3000 | Tape & Reel (TR) | 525 | TCXO | 25 MHz | - | Clipped Sine Wave | 3.3V | ±500ppb | -30°C ~ 85°C | 2mA | 4-SMD, No Lead | 4-SMD (3.2x2.5) | 0.126" L x 0.098" W (3.20mm x 2.50mm) | 0.047" (1.20mm) | https://www.digikey.com/en/products/detail/cts-frequency-controls/525T25005DTR/17099429
https://www.ctscorp.com/Files/DataSheets/Passives/FCP/TCXO/TCXO-525-datasheet.pdf | - | 525T25025DTR | CTS-Frequency Controls | 3.2mm x 2.5mm Surface Mount Clip | 0 | $2.10 | 3000 | Tape & Reel (TR) | 525 | TCXO | 25 MHz | - | Clipped Sine Wave | 3.3V | ±2.5ppm | -30°C ~ 85°C | 2mA | 4-SMD, No Lead | 4-SMD (3.2x2.5) | 0.126" L x 0.098" W (3.20mm x 2.50mm) | 0.047" (1.20mm) | https://www.digikey.com/en/products/detail/cts-frequency-controls/525T25025DTR/17099494
https://www.ctscorp.com/Files/DataSheets/Passives/FCP/TCXO/TCXO-525-datasheet.pdf | - | 525T25010ITR | CTS-Frequency Controls | 3.2mm x 2.5mm Surface Mount Clip | 0 | $2.10 | 3000 | Tape & Reel (TR) | 525 | TCXO | 25 MHz | - | Clipped Sine Wave | 3.3V | ±1ppm | -40°C ~ 85°C | 2mA | 4-SMD, No Lead | 4-SMD (3.2x2.5) | 0.126" L x 0.098" W (3.20mm x 2.50mm) | 0.047" (1.20mm) | https://www.digikey.com/en/products/detail/cts-frequency-controls/525T25010ITR/17099531
https://www.ctscorp.com/Files/DataSheets/Passives/FCP/TCXO/TCXO-525-datasheet.pdf | - | 525T25010DTR | CTS-Frequency Controls | 3.2mm x 2.5mm Surface Mount Clip | 0 | $2.10 | 3000 | Tape & Reel (TR) | 525 | TCXO | 25 MHz | - | Clipped Sine Wave | 3.3V | ±1ppm | -30°C ~ 85°C | 2mA | 4-SMD, No Lead | 4-SMD (3.2x2.5) | 0.126" L x 0.098" W (3.20mm x 2.50mm) | 0.047" (1.20mm) | https://www.digikey.com/en/products/detail/cts-frequency-controls/525T25010DTR/17099553
https://www.ctscorp.com/Files/DataSheets/Passives/FCP/TCXO/TCXO-525-datasheet.pdf | - | 525T25025CTR | CTS-Frequency Controls | 3.2mm x 2.5mm Surface Mount Clip | 0 | $2.10 | 3000 | Tape & Reel (TR) | 525 | TCXO | 25 MHz | - | Clipped Sine Wave | 3.3V | ±2.5ppm | -20°C ~ 70°C | 2mA | 4-SMD, No Lead | 4-SMD (3.2x2.5) | 0.126" L x 0.098" W (3.20mm x 2.50mm) | 0.047" (1.20mm) | https://www.digikey.com/en/products/detail/cts-frequency-controls/525T25025CTR/17099650
https://www.ctscorp.com/Files/DataSheets/Passives/FCP/TCXO/TCXO-525-datasheet.pdf | - | 525T25020DTR | CTS-Frequency Controls | 3.2mm x 2.5mm Surface Mount Clip | 0 | $2.10 | 3000 | Tape & Reel (TR) | 525 | TCXO | 25 MHz | - | Clipped Sine Wave | 3.3V | ±2ppm | -30°C ~ 85°C | 2mA | 4-SMD, No Lead | 4-SMD (3.2x2.5) | 0.126" L x 0.098" W (3.20mm x 2.50mm) | 0.047" (1.20mm) | https://www.digikey.com/en/products/detail/cts-frequency-controls/525T25020DTR/17099714
https://www.ctscorp.com/Files/DataSheets/Passives/FCP/TCXO/TCXO-525-datasheet.pdf | - | 525T25015CTR | CTS-Frequency Controls | 3.2mm x 2.5mm Surface Mount Clip | 0 | $2.10 | 3000 | Tape & Reel (TR) | 525 | TCXO | 25 MHz | - | Clipped Sine Wave | 3.3V | ±1.5ppm | -20°C ~ 70°C | 2mA | 4-SMD, No Lead | 4-SMD (3.2x2.5) | 0.126" L x 0.098" W (3.20mm x 2.50mm) | 0.047" (1.20mm) | https://www.digikey.com/en/products/detail/cts-frequency-controls/525T25015CTR/17099810
https://www.ctscorp.com/Files/DataSheets/Passives/FCP/TCXO/TCXO-525-datasheet.pdf | - | 525T25015ITR | CTS-Frequency Controls | 3.2mm x 2.5mm Surface Mount Clip | 0 | $2.10 | 3000 | Tape & Reel (TR) | 525 | TCXO | 25 MHz | - | Clipped Sine Wave | 3.3V | ±1.5ppm | -40°C ~ 85°C | 2mA | 4-SMD, No Lead | 4-SMD (3.2x2.5) | 0.126" L x 0.098" W (3.20mm x 2.50mm) | 0.047" (1.20mm) | https://www.digikey.com/en/products/detail/cts-frequency-controls/525T25015ITR/17099845
https://www.ctscorp.com/Files/DataSheets/Passives/FCP/TCXO/TCXO-525-datasheet.pdf | - | 525T25020ITR | CTS-Frequency Controls | 3.2mm x 2.5mm Surface Mount Clip | 0 | $2.10 | 3000 | Tape & Reel (TR) | 525 | TCXO | 25 MHz | - | Clipped Sine Wave | 3.3V | ±2ppm | -40°C ~ 85°C | 2mA | 4-SMD, No Lead | 4-SMD (3.2x2.5) | 0.126" L x 0.098" W (3.20mm x 2.50mm) | 0.047" (1.20mm) | https://www.digikey.com/en/products/detail/cts-frequency-controls/525T25020ITR/17100014
https://www.ctscorp.com/Files/DataSheets/Passives/FCP/TCXO/TCXO-520-datasheet.pdf | - | 520L25005ITR | CTS-Frequency Controls | 2.5mm x 2.0mm Surface Mount Clip | 0 | $2.23 | 3000 | Tape & Reel (TR) | 520 | TCXO | 25 MHz | - | Clipped Sine Wave | 3.3V | ±500ppb | -40°C ~ 85°C | 2mA | 4-SMD, No Lead | 4-SMD (2.5x2) | 0.098" L x 0.079" W (2.50mm x 2.00mm) | 0.039" (1.00mm) | https://www.digikey.com/en/products/detail/cts-frequency-controls/520L25005ITR/17100135
https://www.ctscorp.com/Files/DataSheets/Passives/FCP/TCXO/TCXO-525-datasheet.pdf | - | 525L25005ITR | CTS-Frequency Controls | 3.2mm x 2.5mm Surface Mount Clip | 0 | $2.41 | 3000 | Tape & Reel (TR) | 525 | TCXO | 25 MHz | - | Clipped Sine Wave | 3.3V | ±500ppb | -40°C ~ 85°C | 2mA | 4-SMD, No Lead | 4-SMD (3.2x2.5) | 0.126" L x 0.098" W (3.20mm x 2.50mm) | 0.047" (1.20mm) | https://www.digikey.com/en/products/detail/cts-frequency-controls/525L25005ITR/17087025
https://www.ctscorp.com/Files/DataSheets/Passives/FCP/TCXO/TCXO-525-datasheet.pdf | - | 525R25005ITR | CTS-Frequency Controls | 3.2mm x 2.5mm Surface Mount Clip | 0 | $2.41 | 3000 | Tape & Reel (TR) | 525 | TCXO | 25 MHz | - | Clipped Sine Wave | 3.3V | ±500ppb | -40°C ~ 85°C | 2mA | 4-SMD, No Lead | 4-SMD (3.2x2.5) | 0.126" L x 0.098" W (3.20mm x 2.50mm) | 0.047" (1.20mm) | https://www.digikey.com/en/products/detail/cts-frequency-controls/525R25005ITR/17089493
https://www.ctscorp.com/Files/DataSheets/Passives/FCP/TCXO/TCXO-525-datasheet.pdf | - | 525N25005ITR | CTS-Frequency Controls | 3.2mm x 2.5mm Surface Mount Clip | 0 | $2.41 | 3000 | Tape & Reel (TR) | 525 | TCXO | 25 MHz | - | Clipped Sine Wave | 3.3V | ±500ppb | -40°C ~ 85°C | 2mA | 4-SMD, No Lead | 4-SMD (3.2x2.5) | 0.126" L x 0.098" W (3.20mm x 2.50mm) | 0.047" (1.20mm) | https://www.digikey.com/en/products/detail/cts-frequency-controls/525N25005ITR/17094524
https://www.ctscorp.com/Files/DataSheets/Passives/FCP/TCXO/TCXO-525-datasheet.pdf | - | 525T25005ITR | CTS-Frequency Controls | 3.2mm x 2.5mm Surface Mount Clip | 0 | $2.41 | 3000 | Tape & Reel (TR) | 525 | TCXO | 25 MHz | - | Clipped Sine Wave | 3.3V | ±500ppb | -40°C ~ 85°C | 2mA | 4-SMD, No Lead | 4-SMD (3.2x2.5) | 0.126" L x 0.098" W (3.20mm x 2.50mm) | 0.047" (1.20mm) | https://www.digikey.com/en/products/detail/cts-frequency-controls/525T25005ITR/17099269
https://ecsxtal.com/store/pdf/ECS-TXO-2520.pdf | //mm.digikey.com/Volume0/opasdata/d220001/medias/images/2508/MFG_ECS-TXO-2520.jpg | ECS-TXO-2520-33-250-AN-TR | ECS Inc. | XTAL OSC TCXO 25.0000MHZ HCMOS | 21397 | $2.48 | 1 | Tape & Reel (TR),Cut Tape (CT),Digi-Reel® | ECS-TXO-2520 | TCXO | 25 MHz | Enable/Disable | HCMOS | 3.3V | ±2.5ppm | -40°C ~ 85°C | 5.5mA | 4-SMD, No Lead | 4-SMD (2.5x2) | 0.098" L x 0.079" W (2.50mm x 2.00mm) | 0.039" (1.00mm) | https://www.digikey.com/en/products/detail/ecs-inc/ECS-TXO-2520-33-250-AN-TR/6578485
https://ecsxtal.com/store/pdf/ECS-TXO-5032.pdf | //mm.digikey.com/Volume0/opasdata/d220001/medias/images/1300/MFG_NPH-TXO-5032.jpg | ECS-TXO-5032-250-TR | ECS Inc. | XTAL OSC TCXO 25.0000MHZ HCMOS | 3486 | $2.66 | 1 | Tape & Reel (TR),Cut Tape (CT),Digi-Reel® | ECS-TXO-5032 | TCXO | 25 MHz | - | HCMOS | 3.3V | ±2.5ppm | -30°C ~ 85°C | 6mA | 4-SMD, No Lead | 4-SMD (5x3.2) | 0.197" L x 0.126" W (5.00mm x 3.20mm) | 0.059" (1.50mm) | https://www.digikey.com/en/products/detail/ecs-inc/ECS-TXO-5032-250-TR/5357959
https://ecsxtal.com/store/pdf/ECS-TXO-3225.pdf | //mm.digikey.com/Volume0/opasdata/d220001/medias/images/2508/MFG_ECS-TXO-2520.jpg | ECS-TXO-3225-250-TR | ECS Inc. | XTAL OSC TCXO 25.0000MHZ HCMOS | 0 | $2.66 | 1 | Tape & Reel (TR),Cut Tape (CT),Digi-Reel® | ECS-TXO-3225 | TCXO | 25 MHz | - | HCMOS | 3.3V | ±2.5ppm | -30°C ~ 85°C | 6mA | 4-SMD, No Lead | 4-SMD (3.2x2.5) | 0.126" L x 0.098" W (3.20mm x 2.50mm) | 0.039" (1.00mm) | https://www.digikey.com/en/products/detail/ecs-inc/ECS-TXO-3225-250-TR/5357951
https://abracon.com/Oscillators/ASTX-H12.pdf | //mm.digikey.com/Volume0/opasdata/d220001/medias/images/6351/ASESeries.jpg | ASTX-H12-25.000MHZ-I25-T | Abracon LLC | XTAL OSC TCXO 25.0000MHZ HCMOS | 0 | $2.93 | 1000 | Tape & Reel (TR) | ASTX-H12 | TCXO | 25 MHz | Enable/Disable | HCMOS | 3.3V | ±2.5ppm | -40°C ~ 85°C | 5.5mA | 4-SMD, No Lead | 4-SMD (2.5x2) | 0.098" L x 0.079" W (2.50mm x 2.00mm) | 0.037" (0.95mm) | https://www.digikey.com/en/products/detail/abracon-llc/ASTX-H12-25-000MHZ-I25-T/24637287
//mm.digikey.com/Volume0/opasdata/d220001/medias/docus/8895/TCXO-532-datasheet.pdf | //mm.digikey.com/Volume0/opasdata/d220001/medias/images/204/MFG_626-Series.jpg | 532L25010CTT | CTS-Frequency Controls | XTAL OSC TCXO 25.0000MHZ SNWV | 0 | $3.15 | 1000 | Tape & Reel (TR) | 532 | TCXO | 25 MHz | - | Clipped Sine Wave | 3.3V | ±1ppm | -20°C ~ 70°C | 2mA | 4-SMD, No Lead | 4-SMD (5x3.2) | 0.197" L x 0.126" W (5.00mm x 3.20mm) | 0.065" (1.65mm) | https://www.digikey.com/en/products/detail/cts-frequency-controls/532L25010CTT/17036206
//mm.digikey.com/Volume0/opasdata/d220001/medias/docus/8895/TCXO-532-datasheet.pdf | //mm.digikey.com/Volume0/opasdata/d220001/medias/images/204/MFG_626-Series.jpg | 532L25015CTT | CTS-Frequency Controls | XTAL OSC TCXO 25.0000MHZ SNWV | 0 | $3.15 | 1000 | Tape & Reel (TR) | 532 | TCXO | 25 MHz | - | Clipped Sine Wave | 3.3V | ±1.5ppm | -20°C ~ 70°C | 2mA | 4-SMD, No Lead | 4-SMD (5x3.2) | 0.197" L x 0.126" W (5.00mm x 3.20mm) | 0.065" (1.65mm) | https://www.digikey.com/en/products/detail/cts-frequency-controls/532L25015CTT/17037404
//mm.digikey.com/Volume0/opasdata/d220001/medias/docus/8895/TCXO-532-datasheet.pdf | - | 532L25025CTT | CTS-Frequency Controls | 5.0mm x 3.2mm Surface Mount Clip | 0 | $3.15 | 1000 | Tape & Reel (TR) | 532 | TCXO | 25 MHz | - | Clipped Sine Wave | 3.3V | ±2.5ppm | -20°C ~ 70°C | 2mA | 4-SMD, No Lead | 4-SMD (5x3.2) | 0.197" L x 0.126" W (5.00mm x 3.20mm) | 0.065" (1.65mm) | https://www.digikey.com/en/products/detail/cts-frequency-controls/532L25025CTT/17086509
//mm.digikey.com/Volume0/opasdata/d220001/medias/docus/8895/TCXO-532-datasheet.pdf | - | 532L25025ITT | CTS-Frequency Controls | 5.0mm x 3.2mm Surface Mount Clip | 0 | $3.15 | 1000 | Tape & Reel (TR) | 532 | TCXO | 25 MHz | - | Clipped Sine Wave | 3.3V | ±2.5ppm | -40°C ~ 85°C | 2mA | 4-SMD, No Lead | 4-SMD (5x3.2) | 0.197" L x 0.126" W (5.00mm x 3.20mm) | 0.065" (1.65mm) | https://www.digikey.com/en/products/detail/cts-frequency-controls/532L25025ITT/17086698
//mm.digikey.com/Volume0/opasdata/d220001/medias/docus/8895/TCXO-532-datasheet.pdf | - | 532L25025DTT | CTS-Frequency Controls | 5.0mm x 3.2mm Surface Mount Clip | 0 | $3.15 | 1000 | Tape & Reel (TR) | 532 | TCXO | 25 MHz | - | Clipped Sine Wave | 3.3V | ±2.5ppm | -30°C ~ 85°C | 2mA | 4-SMD, No Lead | 4-SMD (5x3.2) | 0.197" L x 0.126" W (5.00mm x 3.20mm) | 0.065" (1.65mm) | https://www.digikey.com/en/products/detail/cts-frequency-controls/532L25025DTT/17086701
https://www.ctscorp.com/Files/DataSheets/Passives/FCP/TCXO/TCXO-533-datasheet.pdf | - | 533L25025ITT | CTS-Frequency Controls | 5.0mm x 3.2mm Surface Mount HCMO | 0 | $3.15 | 1000 | Tape & Reel (TR) | 533 | TCXO | 25 MHz | Standby (Power Down) | HCMOS | 3.3V | ±2.5ppm | -40°C ~ 85°C | 10mA | 4-SMD, No Lead | 4-SMD (5x3.2) | 0.197" L x 0.126" W (5.00mm x 3.20mm) | 0.065" (1.65mm) | https://www.digikey.com/en/products/detail/cts-frequency-controls/533L25025ITT/17096186
https://www.ctscorp.com/Files/DataSheets/Passives/FCP/TCXO/TCXO-533-datasheet.pdf | - | 533L25025CTT | CTS-Frequency Controls | 5.0mm x 3.2mm Surface Mount HCMO | 0 | $3.15 | 1000 | Tape & Reel (TR) | 533 | TCXO | 25 MHz | Standby (Power Down) | HCMOS | 3.3V | ±2.5ppm | -20°C ~ 70°C | 10mA | 4-SMD, No Lead | 4-SMD (5x3.2) | 0.197" L x 0.126" W (5.00mm x 3.20mm) | 0.065" (1.65mm) | https://www.digikey.com/en/products/detail/cts-frequency-controls/533L25025CTT/17096509
https://www.ctscorp.com/Files/DataSheets/Passives/FCP/TCXO/TCXO-533-datasheet.pdf | - | 533L25025DTT | CTS-Frequency Controls | 5.0mm x 3.2mm Surface Mount HCMO | 0 | $3.15 | 1000 | Tape & Reel (TR) | 533 | TCXO | 25 MHz | Standby (Power Down) | HCMOS | 3.3V | ±2.5ppm | -30°C ~ 85°C | 10mA | 4-SMD, No Lead | 4-SMD (5x3.2) | 0.197" L x 0.126" W (5.00mm x 3.20mm) | 0.065" (1.65mm) | https://www.digikey.com/en/products/detail/cts-frequency-controls/533L25025DTT/17096512
https://www.ctscorp.com/Files/DataSheets/Passives/FCP/TCXO/TCXO-533-datasheet.pdf | - | 533L25020CTT | CTS-Frequency Controls | 5.0mm x 3.2mm Surface Mount HCMO | 0 | $3.15 | 1000 | Tape & Reel (TR) | 533 | TCXO | 25 MHz | Standby (Power Down) | HCMOS | 3.3V | ±2ppm | -20°C ~ 70°C | 10mA | 4-SMD, No Lead | 4-SMD (5x3.2) | 0.197" L x 0.126" W (5.00mm x 3.20mm) | 0.065" (1.65mm) | https://www.digikey.com/en/products/detail/cts-frequency-controls/533L25020CTT/17097211
//mm.digikey.com/Volume0/opasdata/d220001/medias/docus/8895/TCXO-532-datasheet.pdf | //mm.digikey.com/Volume0/opasdata/d220001/medias/images/6283/MFG_4-SMD-532-Series.jpg | 532L25020CTT | CTS-Frequency Controls | 5.0mm x 3.2mm Surface Mount Clip | 0 | $3.15 | 1000 | Tape & Reel (TR) | 532 | TCXO | 25 MHz | - | Clipped Sine Wave | 3.3V | ±2ppm | -20°C ~ 70°C | 2mA | 4-SMD, No Lead | 4-SMD (5x3.2) | 0.197" L x 0.126" W (5.00mm x 3.20mm) | 0.065" (1.65mm) | https://www.digikey.com/en/products/detail/cts-frequency-controls/532L25020CTT/24320888
//mm.digikey.com/Volume0/opasdata/d220001/medias/docus/8895/TCXO-532-datasheet.pdf | //mm.digikey.com/Volume0/opasdata/d220001/medias/images/6283/MFG_4-SMD-532-Series.jpg | 532L25005CTT | CTS-Frequency Controls | 5.0mm x 3.2mm Surface Mount Clip | 0 | $3.15 | 1000 | Tape & Reel (TR) | 532 | TCXO | 25 MHz | - | Clipped Sine Wave | 3.3V | ±500ppb | -20°C ~ 70°C | 2mA | 4-SMD, No Lead | 4-SMD (5x3.2) | 0.197" L x 0.126" W (5.00mm x 3.20mm) | 0.065" (1.65mm) | https://www.digikey.com/en/products/detail/cts-frequency-controls/532L25005CTT/24320984
https://abracon.com/Oscillators/ASTX-H12.pdf | //mm.digikey.com/Volume0/opasdata/d220001/medias/images/4843/631_4-SMD.jpg | ASTX-H12-25.000MHZ-T | Abracon LLC | XTAL OSC TCXO 25.0000MHZ HCMOS | 1739 | $4.37 | 1 | Tape & Reel (TR),Cut Tape (CT),Digi-Reel® | ASTX-H12 | TCXO | 25 MHz | Enable/Disable | HCMOS | 3.3V | ±2.5ppm | -30°C ~ 75°C | 5.5mA | 4-SMD, No Lead | 4-SMD (2.5x2) | 0.098" L x 0.079" W (2.50mm x 2.00mm) | 0.037" (0.95mm) | https://www.digikey.com/en/products/detail/abracon-llc/ASTX-H12-25-000MHZ-T/3906608
https://abracon.com/Oscillators/ASTX-H11.pdf | //mm.digikey.com/Volume0/opasdata/d220001/medias/images/2407/ASTX-H11%20SERIES.JPG | ASTX-H11-25.000MHZ-T | Abracon LLC | XTAL OSC TCXO 25.0000MHZ HCMOS | 0 | $4.37 | 1 | Tape & Reel (TR),Tape & Reel (TR),Cut Tape (CT),Digi-Reel® | ASTX-H11 | TCXO | 25 MHz | Enable/Disable | HCMOS | 3.3V | ±2.5ppm | -30°C ~ 75°C | 5.5mA | 4-SMD, No Lead | 4-SMD (3.2x2.5) | 0.126" L x 0.098" W (3.20mm x 2.50mm) | 0.043" (1.10mm) | https://www.digikey.com/en/products/detail/abracon-llc/ASTX-H11-25-000MHZ-T/3906606
//mm.digikey.com/Volume0/opasdata/d220001/medias/docus/8895/TCXO-532-datasheet.pdf | //mm.digikey.com/Volume0/opasdata/d220001/medias/images/204/MFG_626-Series.jpg | 532L25010ITT | CTS-Frequency Controls | XTAL OSC TCXO 25.0000MHZ SNWV | 0 | $5.83 | 1000 | Tape & Reel (TR) | 532 | TCXO | 25 MHz | - | Clipped Sine Wave | 3.3V | ±1ppm | -40°C ~ 85°C | 2mA | 4-SMD, No Lead | 4-SMD (5x3.2) | 0.197" L x 0.126" W (5.00mm x 3.20mm) | 0.065" (1.65mm) | https://www.digikey.com/en/products/detail/cts-frequency-controls/532L25010ITT/17034861
//mm.digikey.com/Volume0/opasdata/d220001/medias/docus/8895/TCXO-532-datasheet.pdf | //mm.digikey.com/Volume0/opasdata/d220001/medias/images/204/MFG_626-Series.jpg | 532L25005DTT | CTS-Frequency Controls | XTAL OSC TCXO 25.0000MHZ SNWV | 0 | $5.83 | 1000 | Tape & Reel (TR) | 532 | TCXO | 25 MHz | - | Clipped Sine Wave | 3.3V | ±500ppb | -30°C ~ 85°C | 2mA | 4-SMD, No Lead | 4-SMD (5x3.2) | 0.197" L x 0.126" W (5.00mm x 3.20mm) | 0.065" (1.65mm) | https://www.digikey.com/en/products/detail/cts-frequency-controls/532L25005DTT/17035548
//mm.digikey.com/Volume0/opasdata/d220001/medias/docus/8895/TCXO-532-datasheet.pdf | //mm.digikey.com/Volume0/opasdata/d220001/medias/images/204/MFG_626-Series.jpg | 532L25010DTT | CTS-Frequency Controls | XTAL OSC TCXO 25.0000MHZ SNWV | 0 | $5.83 | 1000 | Tape & Reel (TR) | 532 | TCXO | 25 MHz | - | Clipped Sine Wave | 3.3V | ±1ppm | -30°C ~ 85°C | 2mA | 4-SMD, No Lead | 4-SMD (5x3.2) | 0.197" L x 0.126" W (5.00mm x 3.20mm) | 0.065" (1.65mm) | https://www.digikey.com/en/products/detail/cts-frequency-controls/532L25010DTT/17037637
//mm.digikey.com/Volume0/opasdata/d220001/medias/docus/8895/TCXO-532-datasheet.pdf | //mm.digikey.com/Volume0/opasdata/d220001/medias/images/6283/MFG_4-SMD-532-Series.jpg | 532L25020ITT | CTS-Frequency Controls | 5.0mm x 3.2mm Surface Mount Clip | 0 | $5.83 | 1000 | Tape & Reel (TR) | 532 | TCXO | 25 MHz | - | Clipped Sine Wave | 3.3V | ±2ppm | -40°C ~ 85°C | 2mA | 4-SMD, No Lead | 4-SMD (5x3.2) | 0.197" L x 0.126" W (5.00mm x 3.20mm) | 0.065" (1.65mm) | https://www.digikey.com/en/products/detail/cts-frequency-controls/532L25020ITT/24320925
//mm.digikey.com/Volume0/opasdata/d220001/medias/docus/8895/TCXO-532-datasheet.pdf | //mm.digikey.com/Volume0/opasdata/d220001/medias/images/6283/MFG_4-SMD-532-Series.jpg | 532L25015ITT | CTS-Frequency Controls | 5.0mm x 3.2mm Surface Mount Clip | 0 | $5.83 | 1000 | Tape & Reel (TR) | 532 | TCXO | 25 MHz | - | Clipped Sine Wave | 3.3V | ±1.5ppm | -40°C ~ 85°C | 2mA | 4-SMD, No Lead | 4-SMD (5x3.2) | 0.197" L x 0.126" W (5.00mm x 3.20mm) | 0.065" (1.65mm) | https://www.digikey.com/en/products/detail/cts-frequency-controls/532L25015ITT/24321085
//mm.digikey.com/Volume0/opasdata/d220001/medias/docus/8895/TCXO-532-datasheet.pdf | //mm.digikey.com/Volume0/opasdata/d220001/medias/images/6283/MFG_4-SMD-532-Series.jpg | 532L25020DTT | CTS-Frequency Controls | 5.0mm x 3.2mm Surface Mount Clip | 0 | $5.83 | 1000 | Tape & Reel (TR) | 532 | TCXO | 25 MHz | - | Clipped Sine Wave | 3.3V | ±2ppm | -30°C ~ 85°C | 2mA | 4-SMD, No Lead | 4-SMD (5x3.2) | 0.197" L x 0.126" W (5.00mm x 3.20mm) | 0.065" (1.65mm) | https://www.digikey.com/en/products/detail/cts-frequency-controls/532L25020DTT/24321131
//mm.digikey.com/Volume0/opasdata/d220001/medias/docus/8895/TCXO-532-datasheet.pdf | //mm.digikey.com/Volume0/opasdata/d220001/medias/images/6283/MFG_4-SMD-532-Series.jpg | 532L25015DTT | CTS-Frequency Controls | 5.0mm x 3.2mm Surface Mount Clip | 0 | $5.83 | 1000 | Tape & Reel (TR) | 532 | TCXO | 25 MHz | - | Clipped Sine Wave | 3.3V | ±1.5ppm | -30°C ~ 85°C | 2mA | 4-SMD, No Lead | 4-SMD (5x3.2) | 0.197" L x 0.126" W (5.00mm x 3.20mm) | 0.065" (1.65mm) | https://www.digikey.com/en/products/detail/cts-frequency-controls/532L25015DTT/24321173
//mm.digikey.com/Volume0/opasdata/d220001/medias/docus/8895/TCXO-532-datasheet.pdf | //mm.digikey.com/Volume0/opasdata/d220001/medias/images/204/MFG_626-Series.jpg | 532L25005ITT | CTS-Frequency Controls | XTAL OSC TCXO 25.0000MHZ SNWV | 0 | $6.07 | 1000 | Tape & Reel (TR) | 532 | TCXO | 25 MHz | - | Clipped Sine Wave | 3.3V | ±500ppb | -40°C ~ 85°C | 2mA | 4-SMD, No Lead | 4-SMD (5x3.2) | 0.197" L x 0.126" W (5.00mm x 3.20mm) | 0.065" (1.65mm) | https://www.digikey.com/en/products/detail/cts-frequency-controls/532L25005ITT/17035715
https://support.epson.biz/td/api/doc_check.php?dl=brief_TG5032CFN&lang=en | //mm.digikey.com/Volume0/opasdata/d220001/medias/images/2259/MFG_TG5032SAN-Series.jpg | TG5032CFN 25.0000M-CBGNNA0 | EPSON | XTAL OSC TCXO 25.0000MHZ SMD | 0 | $7.50 | 1000 | Tape & Reel (TR) | TG5032CFN | TCXO | 25 MHz | - | CMOS | 3.3V | ±280ppb | -40°C ~ 85°C | 5mA | 4-SMD, No Lead | 4-SMD (5x3.2) | 0.197" L x 0.126" W (5.00mm x 3.20mm) | 0.065" (1.65mm) | https://www.digikey.com/en/products/detail/epson/TG5032CFN-25-0000M-CBGNNA0/25598474
https://support.epson.biz/td/api/doc_check.php?dl=brief_TG5032CGN&lang=en | //mm.digikey.com/Volume0/opasdata/d220001/medias/images/307/Epson-10-SMT-3%2C2-2%2C5.jpg | TG5032CGN 25.0000M-CAGHGA0 | EPSON | XTAL OSC TCXO 25.0000MHZ SMD | 0 | $7.50 | 1000 | Tape & Reel (TR) | TG5032CGN | TCXO | 25 MHz | Enable/Disable | CMOS | 3.3V | ±100ppb | -40°C ~ 85°C | 5mA | 10-SMD, No Lead | 10-SMD (5x3.2) | 0.197" L x 0.126" W (5.00mm x 3.20mm) | 0.065" (1.65mm) | https://www.digikey.com/en/products/detail/epson/TG5032CGN-25-0000M-CAGHGA0/25599016
https://support.epson.biz/td/api/doc_check.php?dl=brief_TG5032CGN&lang=en | //mm.digikey.com/Volume0/opasdata/d220001/medias/images/307/Epson-10-SMT-3%2C2-2%2C5.jpg | TG5032CGN 25.0000M-CBGHNA0 | EPSON | XTAL OSC TCXO 25.0000MHZ SMD | 0 | $7.55 | 1000 | Tape & Reel (TR) | TG5032CGN | TCXO | 25 MHz | Enable/Disable | CMOS | 3.3V | ±280ppb | -40°C ~ 85°C | 5mA | 10-SMD, No Lead | 10-SMD (5x3.2) | 0.197" L x 0.126" W (5.00mm x 3.20mm) | 0.065" (1.65mm) | https://www.digikey.com/en/products/detail/epson/TG5032CGN-25-0000M-CBGHNA0/17125272
https://support.epson.biz/td/api/doc_check.php?dl=brief_TG5032CFN&lang=en | //mm.digikey.com/Volume0/opasdata/d220001/medias/images/2259/MFG_TG5032SAN-Series.jpg | TG5032CFN 25.0000M-CAGNNA0 | EPSON | XTAL OSC TCXO 25.0000MHZ SMD | 0 | $7.58 | 1000 | Tape & Reel (TR) | TG5032CFN | TCXO | 25 MHz | - | CMOS | 3.3V | ±100ppb | -40°C ~ 85°C | 5mA | 4-SMD, No Lead | 4-SMD (5x3.2) | 0.197" L x 0.126" W (5.00mm x 3.20mm) | 0.065" (1.65mm) | https://www.digikey.com/en/products/detail/epson/TG5032CFN-25-0000M-CAGNNA0/17123696
https://support.epson.biz/td/api/doc_check.php?dl=brief_TG5032CGN&lang=en | //mm.digikey.com/Volume0/opasdata/d220001/medias/images/307/Epson-10-SMT-3%2C2-2%2C5.jpg | TG5032CGN 25.0000M-CAGHNA0 | EPSON | XTAL OSC TCXO 25.0000MHZ SMD | 0 | $7.58 | 1000 | Tape & Reel (TR) | TG5032CGN | TCXO | 25 MHz | Enable/Disable | CMOS | 3.3V | ±100ppb | -40°C ~ 85°C | 5mA | 10-SMD, No Lead | 10-SMD (5x3.2) | 0.197" L x 0.126" W (5.00mm x 3.20mm) | 0.065" (1.65mm) | https://www.digikey.com/en/products/detail/epson/TG5032CGN-25-0000M-CAGHNA0/17123741
https://ecsxtal.com/store/pdf/ECS-TXO53-S3.pdf | //mm.digikey.com/Volume0/opasdata/d220001/medias/images/4831/MFG_ECS-TXO53-S3-33-100-BN-TR.jpg | ECS-TXO53-S3-33-250-BN-TR | ECS Inc. | XTAL OSC TCXO 25.0000MHZ CMOS | 0 | $11.27 | 1 | Tape & Reel (TR),Cut Tape (CT),Digi-Reel® | ECS-TXO53-S3 | TCXO | 25 MHz | - | CMOS | 3.3V | ±280ppb | -40°C ~ 85°C | 8mA | 10-SMD, No Lead | 10-SMD (5x3.2) | 0.197" L x 0.126" W (5.00mm x 3.20mm) | 0.083" (2.10mm) | https://www.digikey.com/en/products/detail/ecs-inc/ECS-TXO53-S3-33-250-BN-TR/17802084
https://www.ctscorp.com/Files/DataSheets/Passives/FCP/TCXO/TCXO-580-datasheet.pdf | //mm.digikey.com/Volume0/opasdata/d220001/medias/images/204/MFG_626-Series.jpg | 580EL25005ITT | CTS-Frequency Controls | XTAL OSC TCXO 25.0000MHZ SNWV | 0 | $16.47 | 1000 | Tape & Reel (TR) | 580 | TCXO | 25 MHz | Enable/Disable | Clipped Sine Wave | 3.3V | ±500ppb | -40°C ~ 85°C | 6mA | 4-SMD, No Lead | 4-SMD (5x3.2) | 0.197" L x 0.126" W (5.00mm x 3.20mm) | 0.065" (1.65mm) | https://www.digikey.com/en/products/detail/cts-frequency-controls/580EL25005ITT/17035104
https://www.ctscorp.com/Files/DataSheets/Passives/FCP/TCXO/TCXO-580-datasheet.pdf | //mm.digikey.com/Volume0/opasdata/d220001/medias/images/204/MFG_626-Series.jpg | 580EL25005CTT | CTS-Frequency Controls | XTAL OSC TCXO 25.0000MHZ SNWV | 0 | $16.47 | 1000 | Tape & Reel (TR) | 580 | TCXO | 25 MHz | Enable/Disable | Clipped Sine Wave | 3.3V | ±500ppb | -20°C ~ 70°C | 6mA | 4-SMD, No Lead | 4-SMD (5x3.2) | 0.197" L x 0.126" W (5.00mm x 3.20mm) | 0.065" (1.65mm) | https://www.digikey.com/en/products/detail/cts-frequency-controls/580EL25005CTT/17035188
https://www.ctscorp.com/Files/DataSheets/Passives/FCP/TCXO/TCXO-580-datasheet.pdf | //mm.digikey.com/Volume0/opasdata/d220001/medias/images/204/MFG_626-Series.jpg | 580EL25005DTT | CTS-Frequency Controls | XTAL OSC TCXO 25.0000MHZ SNWV | 0 | $16.47 | 1000 | Tape & Reel (TR) | 580 | TCXO | 25 MHz | Enable/Disable | Clipped Sine Wave | 3.3V | ±500ppb | -30°C ~ 85°C | 6mA | 4-SMD, No Lead | 4-SMD (5x3.2) | 0.197" L x 0.126" W (5.00mm x 3.20mm) | 0.065" (1.65mm) | https://www.digikey.com/en/products/detail/cts-frequency-controls/580EL25005DTT/17037598
https://www.ctscorp.com/Files/DataSheets/Passives/FCP/TCXO/TCXO-581-datasheet.pdf | - | 581EL25005CTT | CTS-Frequency Controls | 5.0mm x 3.2mm Surface Mount Stra | 0 | $16.47 | 1000 | Tape & Reel (TR) | 581 | TCXO | 25 MHz | Standby (Power Down) | HCMOS | 3.3V | ±500ppb | -20°C ~ 70°C | 9.5mA | 8-SMD, No Lead | 8-SMD (5x3.2) | 0.197" L x 0.126" W (5.00mm x 3.20mm) | 0.079" (2.00mm) | https://www.digikey.com/en/products/detail/cts-frequency-controls/581EL25005CTT/17097956
https://www.ctscorp.com/Files/DataSheets/Passives/FCP/TCXO/TCXO-581-datasheet.pdf | - | 581EL25005ITT | CTS-Frequency Controls | 5.0mm x 3.2mm Surface Mount Stra | 0 | $16.47 | 1000 | Tape & Reel (TR) | 581 | TCXO | 25 MHz | Standby (Power Down) | HCMOS | 3.3V | ±500ppb | -40°C ~ 85°C | 9.5mA | 8-SMD, No Lead | 8-SMD (5x3.2) | 0.197" L x 0.126" W (5.00mm x 3.20mm) | 0.079" (2.00mm) | https://www.digikey.com/en/products/detail/cts-frequency-controls/581EL25005ITT/17098401
https://www.ctscorp.com/Files/DataSheets/Passives/FCP/TCXO/TCXO-581-datasheet.pdf | - | 581EL25005DTT | CTS-Frequency Controls | 5.0mm x 3.2mm Surface Mount Stra | 0 | $16.47 | 1000 | Tape & Reel (TR) | 581 | TCXO | 25 MHz | Standby (Power Down) | HCMOS | 3.3V | ±500ppb | -30°C ~ 85°C | 9.5mA | 8-SMD, No Lead | 8-SMD (5x3.2) | 0.197" L x 0.126" W (5.00mm x 3.20mm) | 0.079" (2.00mm) | https://www.digikey.com/en/products/detail/cts-frequency-controls/581EL25005DTT/17099192
https://www.ctscorp.com/Files/DataSheets/Passives/FCP/TCXO/TCXO-580-datasheet.pdf | //mm.digikey.com/Volume0/opasdata/d220001/medias/images/204/MFG_626-Series.jpg | 580EL250X2CTT | CTS-Frequency Controls | XTAL OSC TCXO 25.0000MHZ SNWV | 0 | $16.69 | 1000 | Tape & Reel (TR) | 580 | TCXO | 25 MHz | Enable/Disable | Clipped Sine Wave | 3.3V | ±280ppb | -20°C ~ 70°C | 6mA | 4-SMD, No Lead | 4-SMD (5x3.2) | 0.197" L x 0.126" W (5.00mm x 3.20mm) | 0.065" (1.65mm) | https://www.digikey.com/en/products/detail/cts-frequency-controls/580EL250X2CTT/17033750
https://www.ctscorp.com/Files/DataSheets/Passives/FCP/TCXO/TCXO-580-datasheet.pdf | //mm.digikey.com/Volume0/opasdata/d220001/medias/images/204/MFG_626-Series.jpg | 580EL25002DTT | CTS-Frequency Controls | XTAL OSC TCXO 25.0000MHZ SNWV | 0 | $16.69 | 1000 | Tape & Reel (TR) | 580 | TCXO | 25 MHz | Enable/Disable | Clipped Sine Wave | 3.3V | ±200ppb | -30°C ~ 85°C | 6mA | 4-SMD, No Lead | 4-SMD (5x3.2) | 0.197" L x 0.126" W (5.00mm x 3.20mm) | 0.065" (1.65mm) | https://www.digikey.com/en/products/detail/cts-frequency-controls/580EL25002DTT/17034552
https://www.ctscorp.com/Files/DataSheets/Passives/FCP/TCXO/TCXO-580-datasheet.pdf | //mm.digikey.com/Volume0/opasdata/d220001/medias/images/204/MFG_626-Series.jpg | 580EL25002CTT | CTS-Frequency Controls | XTAL OSC TCXO 25.0000MHZ SNWV | 0 | $16.69 | 1000 | Tape & Reel (TR) | 580 | TCXO | 25 MHz | Enable/Disable | Clipped Sine Wave | 3.3V | ±200ppb | -20°C ~ 70°C | 6mA | 4-SMD, No Lead | 4-SMD (5x3.2) | 0.197" L x 0.126" W (5.00mm x 3.20mm) | 0.065" (1.65mm) | https://www.digikey.com/en/products/detail/cts-frequency-controls/580EL25002CTT/17036679
https://www.ctscorp.com/Files/DataSheets/Passives/FCP/TCXO/TCXO-580-datasheet.pdf | //mm.digikey.com/Volume0/opasdata/d220001/medias/images/204/MFG_626-Series.jpg | 580EL25002ITT | CTS-Frequency Controls | XTAL OSC TCXO 25.0000MHZ SNWV | 0 | $16.69 | 1000 | Tape & Reel (TR) | 580 | TCXO | 25 MHz | Enable/Disable | Clipped Sine Wave | 3.3V | ±200ppb | -40°C ~ 85°C | 6mA | 4-SMD, No Lead | 4-SMD (5x3.2) | 0.197" L x 0.126" W (5.00mm x 3.20mm) | 0.065" (1.65mm) | https://www.digikey.com/en/products/detail/cts-frequency-controls/580EL25002ITT/17037685
https://www.ctscorp.com/Files/DataSheets/Passives/FCP/TCXO/TCXO-581-datasheet.pdf | - | 581L250X2CTT | CTS-Frequency Controls | 5.0mm x 3.2mm Surface Mount Stra | 0 | $16.69 | 1000 | Tape & Reel (TR) | 581 | TCXO | 25 MHz | - | HCMOS | 3.3V | ±280ppb | -20°C ~ 70°C | 9.5mA | 8-SMD, No Lead | 8-SMD (5x3.2) | 0.197" L x 0.126" W (5.00mm x 3.20mm) | 0.079" (2.00mm) | https://www.digikey.com/en/products/detail/cts-frequency-controls/581L250X2CTT/17092195
https://www.ctscorp.com/Files/DataSheets/Passives/FCP/TCXO/TCXO-581-datasheet.pdf | - | 581L250X2DTT | CTS-Frequency Controls | 5.0mm x 3.2mm Surface Mount Stra | 0 | $16.69 | 1000 | Tape & Reel (TR) | 581 | TCXO | 25 MHz | - | HCMOS | 3.3V | ±280ppb | -30°C ~ 85°C | 9.5mA | 8-SMD, No Lead | 8-SMD (5x3.2) | 0.197" L x 0.126" W (5.00mm x 3.20mm) | 0.079" (2.00mm) | https://www.digikey.com/en/products/detail/cts-frequency-controls/581L250X2DTT/17094581
https://www.ctscorp.com/Files/DataSheets/Passives/FCP/TCXO/TCXO-581-datasheet.pdf | - | 581L250X2ITT | CTS-Frequency Controls | 5.0mm x 3.2mm Surface Mount Stra | 0 | $16.69 | 1000 | Tape & Reel (TR) | 581 | TCXO | 25 MHz | - | HCMOS | 3.3V | ±280ppb | -40°C ~ 85°C | 9.5mA | 8-SMD, No Lead | 8-SMD (5x3.2) | 0.197" L x 0.126" W (5.00mm x 3.20mm) | 0.079" (2.00mm) | https://www.digikey.com/en/products/detail/cts-frequency-controls/581L250X2ITT/17095088
https://www.ctscorp.com/Files/DataSheets/Passives/FCP/TCXO/TCXO-581-datasheet.pdf | - | 581EL25002DTT | CTS-Frequency Controls | 5.0mm x 3.2mm Surface Mount Stra | 0 | $16.69 | 1000 | Tape & Reel (TR) | 581 | TCXO | 25 MHz | Standby (Power Down) | HCMOS | 3.3V | ±200ppb | -30°C ~ 85°C | 9.5mA | 8-SMD, No Lead | 8-SMD (5x3.2) | 0.197" L x 0.126" W (5.00mm x 3.20mm) | 0.079" (2.00mm) | https://www.digikey.com/en/products/detail/cts-frequency-controls/581EL25002DTT/17095268
https://www.ctscorp.com/Files/DataSheets/Passives/FCP/TCXO/TCXO-581-datasheet.pdf | - | 581EL25002ITT | CTS-Frequency Controls | 5.0mm x 3.2mm Surface Mount Stra | 0 | $16.69 | 1000 | Tape & Reel (TR) | 581 | TCXO | 25 MHz | Standby (Power Down) | HCMOS | 3.3V | ±200ppb | -40°C ~ 85°C | 9.5mA | 8-SMD, No Lead | 8-SMD (5x3.2) | 0.197" L x 0.126" W (5.00mm x 3.20mm) | 0.079" (2.00mm) | https://www.digikey.com/en/products/detail/cts-frequency-controls/581EL25002ITT/17095359
https://www.ctscorp.com/Files/DataSheets/Passives/FCP/TCXO/TCXO-580-datasheet.pdf | - | 580L250X2DTT | CTS-Frequency Controls | 5.0mm x 3.2mm Surface Mount Stra | 0 | $16.69 | 1000 | Tape & Reel (TR) | 580 | TCXO | 25 MHz | - | Clipped Sine Wave | 3.3V | ±280ppb | -30°C ~ 85°C | 6mA | 8-SMD, No Lead | 8-SMD (5x3.2) | 0.197" L x 0.126" W (5.00mm x 3.20mm) | 0.079" (2.00mm) | https://www.digikey.com/en/products/detail/cts-frequency-controls/580L250X2DTT/17096159
https://www.ctscorp.com/Files/DataSheets/Passives/FCP/TCXO/TCXO-580-datasheet.pdf | - | 580L250X2CTT | CTS-Frequency Controls | 5.0mm x 3.2mm Surface Mount Stra | 0 | $16.69 | 1000 | Tape & Reel (TR) | 580 | TCXO | 25 MHz | - | Clipped Sine Wave | 3.3V | ±280ppb | -20°C ~ 70°C | 6mA | 8-SMD, No Lead | 8-SMD (5x3.2) | 0.197" L x 0.126" W (5.00mm x 3.20mm) | 0.079" (2.00mm) | https://www.digikey.com/en/products/detail/cts-frequency-controls/580L250X2CTT/17096217
https://www.ctscorp.com/Files/DataSheets/Passives/FCP/TCXO/TCXO-580-datasheet.pdf | - | 580L250X2ITT | CTS-Frequency Controls | 5.0mm x 3.2mm Surface Mount Stra | 0 | $16.69 | 1000 | Tape & Reel (TR) | 580 | TCXO | 25 MHz | - | Clipped Sine Wave | 3.3V | ±280ppb | -40°C ~ 85°C | 6mA | 8-SMD, No Lead | 8-SMD (5x3.2) | 0.197" L x 0.126" W (5.00mm x 3.20mm) | 0.079" (2.00mm) | https://www.digikey.com/en/products/detail/cts-frequency-controls/580L250X2ITT/17096338
https://www.ctscorp.com/Files/DataSheets/Passives/FCP/TCXO/TCXO-581-datasheet.pdf | - | 581EL250X2ITT | CTS-Frequency Controls | 5.0mm x 3.2mm Surface Mount Stra | 0 | $16.69 | 1000 | Tape & Reel (TR) | 581 | TCXO | 25 MHz | Standby (Power Down) | HCMOS | 3.3V | ±280ppb | -40°C ~ 85°C | 9.5mA | 8-SMD, No Lead | 8-SMD (5x3.2) | 0.197" L x 0.126" W (5.00mm x 3.20mm) | 0.079" (2.00mm) | https://www.digikey.com/en/products/detail/cts-frequency-controls/581EL250X2ITT/17096719
https://www.ctscorp.com/Files/DataSheets/Passives/FCP/TCXO/TCXO-581-datasheet.pdf | - | 581EL250X2CTT | CTS-Frequency Controls | 5.0mm x 3.2mm Surface Mount Stra | 0 | $16.69 | 1000 | Tape & Reel (TR) | 581 | TCXO | 25 MHz | Standby (Power Down) | HCMOS | 3.3V | ±280ppb | -20°C ~ 70°C | 9.5mA | 8-SMD, No Lead | 8-SMD (5x3.2) | 0.197" L x 0.126" W (5.00mm x 3.20mm) | 0.079" (2.00mm) | https://www.digikey.com/en/products/detail/cts-frequency-controls/581EL250X2CTT/17098755
https://www.ctscorp.com/Files/DataSheets/Passives/FCP/TCXO/TCXO-581-datasheet.pdf | - | 581EL25002CTT | CTS-Frequency Controls | 5.0mm x 3.2mm Surface Mount Stra | 0 | $16.69 | 1000 | Tape & Reel (TR) | 581 | TCXO | 25 MHz | Standby (Power Down) | HCMOS | 3.3V | ±200ppb | -20°C ~ 70°C | 9.5mA | 8-SMD, No Lead | 8-SMD (5x3.2) | 0.197" L x 0.126" W (5.00mm x 3.20mm) | 0.079" (2.00mm) | https://www.digikey.com/en/products/detail/cts-frequency-controls/581EL25002CTT/17099003
https://www.ctscorp.com/Files/DataSheets/Passives/FCP/TCXO/TCXO-581-datasheet.pdf | - | 581EL250X2DTT | CTS-Frequency Controls | 5.0mm x 3.2mm Surface Mount Stra | 0 | $16.69 | 1000 | Tape & Reel (TR) | 581 | TCXO | 25 MHz | Standby (Power Down) | HCMOS | 3.3V | ±280ppb | -30°C ~ 85°C | 9.5mA | 8-SMD, No Lead | 8-SMD (5x3.2) | 0.197" L x 0.126" W (5.00mm x 3.20mm) | 0.079" (2.00mm) | https://www.digikey.com/en/products/detail/cts-frequency-controls/581EL250X2DTT/17099686
https://www.ctscorp.com/Files/DataSheets/Passives/FCP/TCXO/TCXO-580-datasheet.pdf | //mm.digikey.com/Volume0/opasdata/d220001/medias/images/61/MFG_535-536_top.jpg | 580EL250X2DTT | CTS-Frequency Controls | 5.0mm x 3.2mm Surface Mount Stra | 0 | $16.69 | 1000 | Tape & Reel (TR) | 580 | TCXO | 25 MHz | Enable/Disable | Clipped Sine Wave | 3.3V | ±280ppb | -30°C ~ 85°C | 6mA | 8-SMD, No Lead | 8-SMD (5x3.2) | 0.197" L x 0.126" W (5.00mm x 3.20mm) | 0.079" (2.00mm) | https://www.digikey.com/en/products/detail/cts-frequency-controls/580EL250X2DTT/24320945
https://www.ctscorp.com/Files/DataSheets/Passives/FCP/TCXO/TCXO-580-datasheet.pdf | //mm.digikey.com/Volume0/opasdata/d220001/medias/images/61/MFG_535-536_top.jpg | 580EL250X2ITT | CTS-Frequency Controls | 5.0mm x 3.2mm Surface Mount Stra | 0 | $16.69 | 1000 | Tape & Reel (TR) | 580 | TCXO | 25 MHz | Enable/Disable | Clipped Sine Wave | 3.3V | ±280ppb | -40°C ~ 85°C | 6mA | 8-SMD, No Lead | 8-SMD (5x3.2) | 0.197" L x 0.126" W (5.00mm x 3.20mm) | 0.079" (2.00mm) | https://www.digikey.com/en/products/detail/cts-frequency-controls/580EL250X2ITT/24321190
https://support.epson.biz/td/api/doc_check.php?dl=brief_TG5032CFN&lang=en | //mm.digikey.com/Volume0/opasdata/d220001/medias/images/2259/MFG_TG5032SAN-Series.jpg | TG5032CFN 25.0000M-CAGNNA3 | EPSON | XTAL OSC TCXO 25.0000MHZ SMD | 0 | $16.80 | 250 | Tape & Reel (TR) | TG5032CFN | TCXO | 25 MHz | - | CMOS | 3.3V | ±100ppb | -40°C ~ 85°C | 5mA | 4-SMD, No Lead | 4-SMD (5x3.2) | 0.197" L x 0.126" W (5.00mm x 3.20mm) | 0.065" (1.65mm) | https://www.digikey.com/en/products/detail/epson/TG5032CFN-25-0000M-CAGNNA3/25598391
https://support.epson.biz/td/api/doc_check.php?dl=brief_TG5032CGN&lang=en | //mm.digikey.com/Volume0/opasdata/d220001/medias/images/307/Epson-10-SMT-3%2C2-2%2C5.jpg | TG5032CGN 25.0000M-CAGHGA3 | EPSON | XTAL OSC TCXO 25.0000MHZ SMD | 0 | $18.05 | 250 | Tape & Reel (TR) | TG5032CGN | TCXO | 25 MHz | Enable/Disable | CMOS | 3.3V | ±100ppb | -40°C ~ 85°C | 5mA | 10-SMD, No Lead | 10-SMD (5x3.2) | 0.197" L x 0.126" W (5.00mm x 3.20mm) | 0.065" (1.65mm) | https://www.digikey.com/en/products/detail/epson/TG5032CGN-25-0000M-CAGHGA3/17122102
https://support.epson.biz/td/api/doc_check.php?dl=brief_TG5032CGN&lang=en | //mm.digikey.com/Volume0/opasdata/d220001/medias/images/307/Epson-10-SMT-3%2C2-2%2C5.jpg | TG5032CGN 25.0000M-CBGHNA3 | EPSON | XTAL OSC TCXO 25.0000MHZ SMD | 0 | $18.05 | 250 | Tape & Reel (TR) | TG5032CGN | TCXO | 25 MHz | Enable/Disable | CMOS | 3.3V | ±280ppb | -40°C ~ 85°C | 5mA | 10-SMD, No Lead | 10-SMD (5x3.2) | 0.197" L x 0.126" W (5.00mm x 3.20mm) | 0.065" (1.65mm) | https://www.digikey.com/en/products/detail/epson/TG5032CGN-25-0000M-CBGHNA3/17123554
https://support.epson.biz/td/api/doc_check.php?dl=brief_TG5032CGN&lang=en | //mm.digikey.com/Volume0/opasdata/d220001/medias/images/307/Epson-10-SMT-3%2C2-2%2C5.jpg | TG5032CGN 25.0000M-CAGHNA3 | EPSON | XTAL OSC TCXO 25.0000MHZ SMD | 0 | $18.05 | 250 | Tape & Reel (TR) | TG5032CGN | TCXO | 25 MHz | Enable/Disable | CMOS | 3.3V | ±100ppb | -40°C ~ 85°C | 5mA | 10-SMD, No Lead | 10-SMD (5x3.2) | 0.197" L x 0.126" W (5.00mm x 3.20mm) | 0.065" (1.65mm) | https://www.digikey.com/en/products/detail/epson/TG5032CGN-25-0000M-CAGHNA3/17125009
https://www.ctscorp.com/Files/DataSheets/Passives/FCP/TCXO/TCXO-535-datasheet.pdf | //mm.digikey.com/Volume0/opasdata/d220001/medias/images/61/MFG_535-536_top.jpg | 535EL250X2IT5 | CTS-Frequency Controls | XTAL OSC TCXO 25.0000MHZ SNWV | 0 | $18.69 | 500 | Tape & Reel (TR) | 535 | TCXO | 25 MHz | Enable/Disable | Clipped Sine Wave | 3.3V | ±280ppb | -40°C ~ 85°C | 10mA | 10-SMD, No Lead | 10-SMD (5x3.2) | 0.197" L x 0.126" W (5.00mm x 3.20mm) | 0.079" (2.00mm) | https://www.digikey.com/en/products/detail/cts-frequency-controls/535EL250X2IT5/10710966
https://www.ctscorp.com/Files/DataSheets/Passives/FCP/TCXO/TCXO-535-datasheet.pdf | //mm.digikey.com/Volume0/opasdata/d220001/medias/images/61/MFG_535-536_top.jpg | 535L250X2IT5 | CTS-Frequency Controls | XTAL OSC TCXO 25.0000MHZ SNWV | 0 | $18.69 | 500 | Tape & Reel (TR) | 535 | TCXO | 25 MHz | - | Clipped Sine Wave | 3.3V | ±280ppb | -40°C ~ 85°C | 10mA | 10-SMD, No Lead | 10-SMD (5x3.2) | 0.197" L x 0.126" W (5.00mm x 3.20mm) | 0.079" (2.00mm) | https://www.digikey.com/en/products/detail/cts-frequency-controls/535L250X2IT5/10711461
https://www.ctscorp.com/Files/DataSheets/Passives/FCP/TCXO/TCXO-536-datasheet.pdf | //mm.digikey.com/Volume0/opasdata/d220001/medias/images/61/MFG_535-536_top.jpg | 536EL250X2IT5 | CTS-Frequency Controls | XTAL OSC TCXO 25.0000MHZ HCMOS | 0 | $19.19 | 500 | Tape & Reel (TR) | 536 | TCXO | 25 MHz | Enable/Disable | HCMOS | 3.3V | ±280ppb | -40°C ~ 85°C | 10mA | 10-SMD, No Lead | 10-SMD (5x3.2) | 0.197" L x 0.126" W (5.00mm x 3.20mm) | 0.079" (2.00mm) | https://www.digikey.com/en/products/detail/cts-frequency-controls/536EL250X2IT5/10711218
https://www.ctscorp.com/Files/DataSheets/Passives/FCP/TCXO/TCXO-536-datasheet.pdf | //mm.digikey.com/Volume0/opasdata/d220001/medias/images/61/MFG_535-536_top.jpg | 536L250X2IT5 | CTS-Frequency Controls | XTAL OSC TCXO 25.0000MHZ HCMOS | 0 | $19.19 | 500 | Tape & Reel (TR) | 536 | TCXO | 25 MHz | - | HCMOS | 3.3V | ±280ppb | -40°C ~ 85°C | 10mA | 10-SMD, No Lead | 10-SMD (5x3.2) | 0.197" L x 0.126" W (5.00mm x 3.20mm) | 0.079" (2.00mm) | https://www.digikey.com/en/products/detail/cts-frequency-controls/536L250X2IT5/10711585
https://support.epson.biz/td/api/doc_check.php?dl=brief_TG5032CGN&lang=en | //mm.digikey.com/Volume0/opasdata/d220001/medias/images/307/Epson-10-SMT-3%2C2-2%2C5.jpg | TG5032CGN 25.0000M-CAGHNAB | EPSON | XTAL OSC TCXO 25.0000MHZ SMD | 0 | $19.76 | 10 | Bulk | TG5032CGN | TCXO | 25 MHz | Enable/Disable | CMOS | 3.3V | ±100ppb | -40°C ~ 85°C | 5mA | 10-SMD, No Lead | 10-SMD (5x3.2) | 0.197" L x 0.126" W (5.00mm x 3.20mm) | 0.065" (1.65mm) | https://www.digikey.com/en/products/detail/epson/TG5032CGN-25-0000M-CAGHNAB/17123640
https://support.epson.biz/td/api/doc_check.php?dl=brief_TG5032CGN&lang=en | //mm.digikey.com/Volume0/opasdata/d220001/medias/images/307/Epson-10-SMT-3%2C2-2%2C5.jpg | TG5032CGN 25.0000M-CAGHGAB | EPSON | XTAL OSC TCXO 25.0000MHZ SMD | 0 | $19.76 | 10 | Bulk | TG5032CGN | TCXO | 25 MHz | Enable/Disable | CMOS | 3.3V | ±100ppb | -40°C ~ 85°C | 5mA | 10-SMD, No Lead | 10-SMD (5x3.2) | 0.197" L x 0.126" W (5.00mm x 3.20mm) | 0.065" (1.65mm) | https://www.digikey.com/en/products/detail/epson/TG5032CGN-25-0000M-CAGHGAB/17123988
https://support.epson.biz/td/api/doc_check.php?dl=brief_TG5032CGN&lang=en | //mm.digikey.com/Volume0/opasdata/d220001/medias/images/307/Epson-10-SMT-3%2C2-2%2C5.jpg | TG5032CGN 25.0000M-CBGHNAB | EPSON | XTAL OSC TCXO 25.0000MHZ SMD | 0 | $19.76 | 10 | Bulk | TG5032CGN | TCXO | 25 MHz | Enable/Disable | CMOS | 3.3V | ±280ppb | -40°C ~ 85°C | 5mA | 10-SMD, No Lead | 10-SMD (5x3.2) | 0.197" L x 0.126" W (5.00mm x 3.20mm) | 0.065" (1.65mm) | https://www.digikey.com/en/products/detail/epson/TG5032CGN-25-0000M-CBGHNAB/17123991
https://support.epson.biz/td/api/doc_check.php?dl=brief_TG5032CFN&lang=en | //mm.digikey.com/Volume0/opasdata/d220001/medias/images/2259/MFG_TG5032SAN-Series.jpg | TG5032CFN 25.0000M-CAGNNAB | EPSON | XTAL OSC TCXO 25.0000MHZ SMD | 0 | $19.76 | 10 | Bulk | TG5032CFN | TCXO | 25 MHz | - | CMOS | 3.3V | ±100ppb | -40°C ~ 85°C | 5mA | 4-SMD, No Lead | 4-SMD (5x3.2) | 0.197" L x 0.126" W (5.00mm x 3.20mm) | 0.065" (1.65mm) | https://www.digikey.com/en/products/detail/epson/TG5032CFN-25-0000M-CAGNNAB/17124512
https://www.ctscorp.com/Files/DataSheets/Passives/FCP/TCXO/TCXO-535-datasheet.pdf | //mm.digikey.com/Volume0/opasdata/d220001/medias/images/61/MFG_535-536_top.jpg | 535L250X2GT5 | CTS-Frequency Controls | XTAL OSC TCXO 25.0000MHZ SNWV | 978 | $20.48 | 1 | Tape & Reel (TR),Cut Tape (CT),Digi-Reel® | 535 | TCXO | 25 MHz | - | Clipped Sine Wave | 3.3V | ±280ppb | -40°C ~ 105°C | 10mA | 10-SMD, No Lead | 10-SMD (5x3.2) | 0.197" L x 0.126" W (5.00mm x 3.20mm) | 0.079" (2.00mm) | https://www.digikey.com/en/products/detail/cts-frequency-controls/535L250X2GT5/10711626
https://www.ctscorp.com/Files/DataSheets/Passives/FCP/TCXO/TCXO-535-datasheet.pdf | //mm.digikey.com/Volume0/opasdata/d220001/medias/images/61/MFG_535-536_top.jpg | 535EL25005IT5 | CTS-Frequency Controls | XTAL OSC TCXO 25.0000MHZ SNWV | 0 | $20.90 | 500 | Tape & Reel (TR) | 535 | TCXO | 25 MHz | Enable/Disable | Clipped Sine Wave | 3.3V | ±500ppb | -40°C ~ 85°C | 10mA | 10-SMD, No Lead | 10-SMD (5x3.2) | 0.197" L x 0.126" W (5.00mm x 3.20mm) | 0.079" (2.00mm) | https://www.digikey.com/en/products/detail/cts-frequency-controls/535EL25005IT5/10710929
https://www.ctscorp.com/Files/DataSheets/Passives/FCP/TCXO/TCXO-535-datasheet.pdf | //mm.digikey.com/Volume0/opasdata/d220001/medias/images/61/MFG_535-536_top.jpg | 535EL25005GT5 | CTS-Frequency Controls | XTAL OSC TCXO 25.0000MHZ SNWV | 0 | $20.90 | 500 | Tape & Reel (TR) | 535 | TCXO | 25 MHz | Enable/Disable | Clipped Sine Wave | 3.3V | ±500ppb | -40°C ~ 105°C | 10mA | 10-SMD, No Lead | 10-SMD (5x3.2) | 0.197" L x 0.126" W (5.00mm x 3.20mm) | 0.079" (2.00mm) | https://www.digikey.com/en/products/detail/cts-frequency-controls/535EL25005GT5/10711017
https://www.ctscorp.com/Files/DataSheets/Passives/FCP/TCXO/TCXO-535-datasheet.pdf | //mm.digikey.com/Volume0/opasdata/d220001/medias/images/61/MFG_535-536_top.jpg | 535L25005IT5 | CTS-Frequency Controls | XTAL OSC TCXO 25.0000MHZ SNWV | 0 | $20.90 | 500 | Tape & Reel (TR) | 535 | TCXO | 25 MHz | - | Clipped Sine Wave | 3.3V | ±500ppb | -40°C ~ 85°C | 10mA | 10-SMD, No Lead | 10-SMD (5x3.2) | 0.197" L x 0.126" W (5.00mm x 3.20mm) | 0.079" (2.00mm) | https://www.digikey.com/en/products/detail/cts-frequency-controls/535L25005IT5/10711126
https://www.ctscorp.com/Files/DataSheets/Passives/FCP/TCXO/TCXO-535-datasheet.pdf | //mm.digikey.com/Volume0/opasdata/d220001/medias/images/61/MFG_535-536_top.jpg | 535L25005GT5 | CTS-Frequency Controls | XTAL OSC TCXO 25.0000MHZ SNWV | 0 | $20.90 | 500 | Tape & Reel (TR) | 535 | TCXO | 25 MHz | - | Clipped Sine Wave | 3.3V | ±500ppb | -40°C ~ 105°C | 10mA | 10-SMD, No Lead | 10-SMD (5x3.2) | 0.197" L x 0.126" W (5.00mm x 3.20mm) | 0.079" (2.00mm) | https://www.digikey.com/en/products/detail/cts-frequency-controls/535L25005GT5/10711362
https://www.ctscorp.com/Files/DataSheets/Passives/FCP/TCXO/TCXO-536-datasheet.pdf | //mm.digikey.com/Volume0/opasdata/d220001/medias/images/61/MFG_535-536_top.jpg | 536L25001IT5 | CTS-Frequency Controls | XTAL OSC TCXO 25.0000MHZ HCMOS | 988 | $21.23 | 1 | Tape & Reel (TR),Cut Tape (CT),Digi-Reel® | 536 | TCXO | 25 MHz | - | HCMOS | 3.3V | ±100ppb | -40°C ~ 85°C | 10mA | 10-SMD, No Lead | 10-SMD (5x3.2) | 0.197" L x 0.126" W (5.00mm x 3.20mm) | 0.079" (2.00mm) | https://www.digikey.com/en/products/detail/cts-frequency-controls/536L25001IT5/10711641
https://www.ctscorp.com/Files/DataSheets/Passives/FCP/TCXO/TCXO-536-datasheet.pdf | //mm.digikey.com/Volume0/opasdata/d220001/medias/images/61/MFG_535-536_top.jpg | 536EL25005GT5 | CTS-Frequency Controls | XTAL OSC TCXO 25.0000MHZ HCMOS | 0 | $21.42 | 500 | Tape & Reel (TR) | 536 | TCXO | 25 MHz | Enable/Disable | HCMOS | 3.3V | ±500ppb | -40°C ~ 105°C | 10mA | 10-SMD, No Lead | 10-SMD (5x3.2) | 0.197" L x 0.126" W (5.00mm x 3.20mm) | 0.079" (2.00mm) | https://www.digikey.com/en/products/detail/cts-frequency-controls/536EL25005GT5/10711087
https://www.ctscorp.com/Files/DataSheets/Passives/FCP/TCXO/TCXO-536-datasheet.pdf | //mm.digikey.com/Volume0/opasdata/d220001/medias/images/61/MFG_535-536_top.jpg | 536EL25005IT5 | CTS-Frequency Controls | XTAL OSC TCXO 25.0000MHZ HCMOS | 0 | $21.42 | 500 | Tape & Reel (TR) | 536 | TCXO | 25 MHz | Enable/Disable | HCMOS | 3.3V | ±500ppb | -40°C ~ 85°C | 10mA | 10-SMD, No Lead | 10-SMD (5x3.2) | 0.197" L x 0.126" W (5.00mm x 3.20mm) | 0.079" (2.00mm) | https://www.digikey.com/en/products/detail/cts-frequency-controls/536EL25005IT5/10711227
https://www.ctscorp.com/Files/DataSheets/Passives/FCP/TCXO/TCXO-536-datasheet.pdf | //mm.digikey.com/Volume0/opasdata/d220001/medias/images/61/MFG_535-536_top.jpg | 536L25005IT5 | CTS-Frequency Controls | XTAL OSC TCXO 25.0000MHZ HCMOS | 0 | $21.42 | 500 | Tape & Reel (TR) | 536 | TCXO | 25 MHz | - | HCMOS | 3.3V | ±500ppb | -40°C ~ 85°C | 10mA | 10-SMD, No Lead | 10-SMD (5x3.2) | 0.197" L x 0.126" W (5.00mm x 3.20mm) | 0.079" (2.00mm) | https://www.digikey.com/en/products/detail/cts-frequency-controls/536L25005IT5/10711237
https://www.ctscorp.com/Files/DataSheets/Passives/FCP/TCXO/TCXO-536-datasheet.pdf | //mm.digikey.com/Volume0/opasdata/d220001/medias/images/61/MFG_535-536_top.jpg | 536L25005GT5 | CTS-Frequency Controls | XTAL OSC TCXO 25.0000MHZ HCMOS | 0 | $21.42 | 500 | Tape & Reel (TR) | 536 | TCXO | 25 MHz | - | HCMOS | 3.3V | ±500ppb | -40°C ~ 105°C | 10mA | 10-SMD, No Lead | 10-SMD (5x3.2) | 0.197" L x 0.126" W (5.00mm x 3.20mm) | 0.079" (2.00mm) | https://www.digikey.com/en/products/detail/cts-frequency-controls/536L25005GT5/10711639
https://www.ctscorp.com/Files/DataSheets/Passives/FCP/TCXO/TCXO-536-datasheet.pdf | //mm.digikey.com/Volume0/opasdata/d220001/medias/images/61/MFG_535-536_top.jpg | 536EL250X2GT5 | CTS-Frequency Controls | XTAL OSC TCXO 25.0000MHZ HCMOS | 0 | $24.39 | 500 | Tape & Reel (TR) | 536 | TCXO | 25 MHz | Enable/Disable | HCMOS | 3.3V | ±280ppb | -40°C ~ 105°C | 10mA | 10-SMD, No Lead | 10-SMD (5x3.2) | 0.197" L x 0.126" W (5.00mm x 3.20mm) | 0.079" (2.00mm) | https://www.digikey.com/en/products/detail/cts-frequency-controls/536EL250X2GT5/10711064
https://www.ctscorp.com/Files/DataSheets/Passives/FCP/TCXO/TCXO-536-datasheet.pdf | //mm.digikey.com/Volume0/opasdata/d220001/medias/images/61/MFG_535-536_top.jpg | 536L250X2GT5 | CTS-Frequency Controls | XTAL OSC TCXO 25.0000MHZ HCMOS | 0 | $24.39 | 500 | Tape & Reel (TR) | 536 | TCXO | 25 MHz | - | HCMOS | 3.3V | ±280ppb | -40°C ~ 105°C | 10mA | 10-SMD, No Lead | 10-SMD (5x3.2) | 0.197" L x 0.126" W (5.00mm x 3.20mm) | 0.079" (2.00mm) | https://www.digikey.com/en/products/detail/cts-frequency-controls/536L250X2GT5/10711304
https://www.ctscorp.com/Files/DataSheets/Passives/FCP/TCXO/TCXO-535-datasheet.pdf | //mm.digikey.com/Volume0/opasdata/d220001/medias/images/61/MFG_535-536_top.jpg | 535EL250X2GT5 | CTS-Frequency Controls | XTAL OSC TCXO 25.0000MHZ SNWV | 0 | $24.89 | 500 | Tape & Reel (TR) | 535 | TCXO | 25 MHz | Enable/Disable | Clipped Sine Wave | 3.3V | ±280ppb | -40°C ~ 105°C | 10mA | 10-SMD, No Lead | 10-SMD (5x3.2) | 0.197" L x 0.126" W (5.00mm x 3.20mm) | 0.079" (2.00mm) | https://www.digikey.com/en/products/detail/cts-frequency-controls/535EL250X2GT5/10711303
https://www.ctscorp.com/Files/DataSheets/Passives/FCP/TCXO/TCXO-535-datasheet.pdf | //mm.digikey.com/Volume0/opasdata/d220001/medias/images/61/MFG_535-536_top.jpg | 535L25001IT5 | CTS-Frequency Controls | XTAL OSC TCXO 25.0000MHZ SNWV | 0 | $24.98 | 500 | Tape & Reel (TR) | 535 | TCXO | 25 MHz | - | Clipped Sine Wave | 3.3V | ±100ppb | -40°C ~ 85°C | 10mA | 10-SMD, No Lead | 10-SMD (5x3.2) | 0.197" L x 0.126" W (5.00mm x 3.20mm) | 0.079" (2.00mm) | https://www.digikey.com/en/products/detail/cts-frequency-controls/535L25001IT5/10711356
https://www.ctscorp.com/Files/DataSheets/Passives/FCP/TCXO/TCXO-535-datasheet.pdf | //mm.digikey.com/Volume0/opasdata/d220001/medias/images/61/MFG_535-536_top.jpg | 535EL25001IT5 | CTS-Frequency Controls | XTAL OSC TCXO 25.0000MHZ SNWV | 0 | $24.98 | 500 | Tape & Reel (TR) | 535 | TCXO | 25 MHz | Enable/Disable | Clipped Sine Wave | 3.3V | ±100ppb | -40°C ~ 85°C | 10mA | 10-SMD, No Lead | 10-SMD (5x3.2) | 0.197" L x 0.126" W (5.00mm x 3.20mm) | 0.079" (2.00mm) | https://www.digikey.com/en/products/detail/cts-frequency-controls/535EL25001IT5/10711459
https://www.ctscorp.com/Files/DataSheets/Passives/FCP/TCXO/TCXO-536-datasheet.pdf | //mm.digikey.com/Volume0/opasdata/d220001/medias/images/61/MFG_535-536_top.jpg | 536EL25001IT5 | CTS-Frequency Controls | XTAL OSC TCXO 25.0000MHZ HCMOS | 0 | $25.77 | 500 | Tape & Reel (TR) | 536 | TCXO | 25 MHz | Enable/Disable | HCMOS | 3.3V | ±100ppb | -40°C ~ 85°C | 10mA | 10-SMD, No Lead | 10-SMD (5x3.2) | 0.197" L x 0.126" W (5.00mm x 3.20mm) | 0.079" (2.00mm) | https://www.digikey.com/en/products/detail/cts-frequency-controls/536EL25001IT5/10711019
