DRWJSCHMIDT/T41/K9HZ_KI3P_Reverse_Voltage_Protection/K9HZ_KI3P_50A_Reverse_Voltage_Protection_Kit_X/Reverse_voltage_protection_50A_BOM.xlsx

Quantity | Reference | Description
1 | D1 | Red LED 5.0mm
2 | D2, D3 | 1N4007 1000V 1A Leaded Diode
1 | D4 | Green LED 5.0mm
1 | K1 | RELAY GEN PURPOSE SPST 50A 12V
2 | R1, R2 | 4.7k 1/4W 5% Leaded Carbon Film Resistor
1 | SW1 | 1x2 IDC Male Pins - 2.53mm pitch
1 | PCB | PCB
