DRWJSCHMIDT/T41/T41_V012_Files/T41_V012_Assembled_PCBs/T41_RF_Board_DualClockDaughterBoard_V2_031426/T41_RF_Board_DualClock_Assy_BOM.xlsx

Comment | Designator | Footprint | JLCPCB Part #
0.1uF 50V X7R 0603 SMD | C1, C2, C3, C4, C5 | 0603 | C696359
Ferrite bead 600 mOhm 1A 0603 SMD | L1, L2, L3, L4 | 0603 | C1002
2.2K Ohm 1% 1/8W | R1, R2 | 0603 | C2105704
ECS-TXO53-S3-33-250-BN-TR | Y1 | Oscillator_ECS_TXO53_S3
Clock Generator Si5351A-B-GM | Y3 | QFN-20-1EP_4x4mm_P0.5mm_EP2.7x2.7mm | C22413806
