DRWJSCHMIDT/T41/T41_V012_Files/T41_V012_BOMs/Source Files/T41-RF-board-AttenuatorDaughterBoard-Assy_BOM_NotforAssembly.csv

Id | Designator | Footprint | Quantity | Designation | Manufacturer | Manufacturer Number | JCLPCB Part #
1 | C1 | C_0603_1608Metric | 1 | 10uF 16V SMD | Murata | GRM188R61C106MAALD | C86277
2 | C2 | C_0603_1608Metric | 1 | 0.1uF 50V X7R 0603 SMD | Kemet | C0603C104K5RACTU | C696359
3 | L1 | R_0603_1608Metric | 1 | Ferrite bead 600 mOhm 1A 0603 SMD | Laird Technologies | MI0603J601R-10 | C2441365
4 | R1, R2 | R_0603_1608Metric | 2 | 10K Ohm 1/8W 1% | Vishay | RCA060310K0FKEASR | C161803
5 | U1 | PE4312-QFN-20 | 1 | PE4312C-Z Attenuator 20 Lead 4x4 QFN | pSemi | PE4312C-Z | C500480
