DRWJSCHMIDT/T41/T41_V012_Files/T41_V012_BOMs/Source Files/T41_BPF_Board_BOM_V12.6_02-16-25.xlsx

Sheet: BPF BOM
Quantity | Designator | Description | Mouser P/N | Digikey P/N | TaydaElectronics | Other | Comments
2 | C1, C3 | 470uF 25V Aluminum Capacitor | 667-ECA-1EM471
64 | C2, C4, C5, C6, C7, C8, C9, C10, C11, C12, C13, C14, C15, C16, C17, C18, C19, C20, C21, C22, C23, C24, C25, C26, C27 C41, C90, C91, C97, C98, C100, C101,C107, C108, C190, C191, C197, C198, C200, C201, C207, C208, C290, C291, C297, C298, C300, C301, C307, C308, C400, C401, C407, C408, C500, C501, C507, C508, C600, C601, C607, C608, C700, C701 | 0.1uF 50V SMD 1206 Capacitor | C1206C104K5RACTU
 | C94 | 5.7nF 50V
1 | C94a | 5.6nF 50V | 581-12061C562JAT2A
 | C92, C96 | 3.2nF 50V
1 | C104 | 3.0nF 50V | 581-12062A302JAT2A
 | C194 | 2.5nF 50V
1 | C194a | 2.4nF 50V | 581-12065C242JAT4A
1 | C204 | 2.0nF 50V | 80-C1206C202K5HACTU
 | C294 | 1.9nF 50V
3 | C102, C106, C294a | 1.8nF 50V | 80-C1206C182K1R
4 | C92a, C92b, C96a, C96b | 1.6nF 50V | 80-C1206C162K3HACTU
1 | C304 | 1.3nF 50V | 80-C1206C132J1G
4 | C192, C196, C202, C206 | 1.2nF 50V | 80-C1206C122J5G
2 | C292, C296 | 1.0nF 50V | 80-C1206C102K5R
2 | C302, C306 | 750pF 50V | 80-C1206C751J5G
1 | C404 | 680pF 50V | 791-1206B681K500CT
 | C93, C95 | 580pF 50V
1 | C504 | 510pF 50V | 80-C1206C511J5HAUTO
2 | C402, C406 | 390pF 50V | 80-C1206C391K1HACTU
 | C604 | 380pF 50V
2 | C93a, C95a | 330pF 50V | 80-C1206C331J5G
4 | C103, C105, C502, C506 | 300pF 50V | 80-C1206C301J5G
2 | C93b, C95b | 250pF 50V | 581-12061A251FAT2A
2 | C602, C606 | 240pF 50V | 80-C1206C241J5G
1 | C604b | 200pF 50V | 80-C1206C201J5HAUTO
 | C193, C195 | 195pF 50V
3 | C203, C205, C604a | 180pF 50V | 80-C1206C181J1G
2 | C193b, C195b | 120pF 50V | 80-C1206C121J5GAC
3 | C94b, C194b, C294b | 100pF 50V | 80-C1206C101K1G
4 | C303, C305, C193a, C195a | 75pF 50V | 581-12065A750JAT2A
2 | C293, C295 | 68pF 50V | 80-C1206C680J5HACTU
2 | C403, C405 | 51pF 50V | 80-C1206C510J5HACTU
2 | C503, C505 | 43pF 50V | 80-C1206C430J5G
2 | C603, C605 | 13pF 50V | 80-C1206C130F1HACTU
4 | D1, D2, D3, D4 | BAS70H,115 Diodes | 771-BAS70H-T/R
4 | J1, J2, J5, J6 | SMA Female Coax Connector | 712-CONSMA001-G
1 | J3 | 2-Position Molex Terminal Block | 538-39880-4302
1 | J4 | IDC2x5 Male Box Connector |  |  | A-2939
1 | L1 | 10uH SMD Incurtor | 70-IFSC2020DER100M01 | 490-10814-1-ND
1 | L2 | Ferrite Bead SMD 1206 600 Ohm | 875-HZ1206E601R-10
2 | L92, L94 | 11 uH |  |  |  | 14"of #28 wire, 15T on FT37-61
2 | L102, L104 | 5.6 uH |  |  |  | 14" of #28 wire, 27T on T37-1
2 | L192, L194 | 5.2 uH |  |  |  | 13" of #28 wire, 26T on T37-1
2 | L202, L204 | 3.9 uH |  |  |  | 12" of #28 wire, 22T on T37-1
2 | L292, L294 | 3.6 uH |  |  |  | 20" of #28 wire, 38T on T37-10
2 | L302, L304 | 2.2 uH |  |  |  | 14" of #28 wire, 25T on T37-6
2 | L91, L95 | 2 uH |  |  |  | 14" of #28 wire, 26T on T37-6
2 | L402, L404 | 1.2 uH |  |  |  | 12" of #28 wire, 21T on T37-10
1 | L93 | 1 uh |  |  |  | 11" of #28 wire, 20T on T37-10
2 | L191, L195 | 840 nH |  |  |  | 10" of #28 wire, 17T on T37-10
2 | L502, L504 | 820 nH |  |  |  | 10" of #28 wire, 17T on T37-10
2 | L101, L105 | 810 nH |  |  |  | 11" of #28 wire, 20T on T37-10
2 | L602, L604 | 720 nH |  |  |  | 11" of #28 wire, 16T on T37-10
2 | L201, L205 | 560 nH |  |  |  | 18" of #28 wire, 32T on T37-0
1 | L103 | 440 nH |  |  |  | 18" of #28 wire, 32T on T37-0
1 | L193 | 400 nH |  |  |  | 6" of #28 wire, 9T on T37-2
1 | L203 | 330 nH |  |  |  | 14" of #28 wire, 23T on T37-0
2 | L291, L295 | 245 nH |  |  |  | 12" of #28 wire, 19T on T37-0
2 | L301, L305 | 220 nH |  |  |  | 11" of #28 wire, 17T on T37-0
2 | L401, L405 | 150 nH |  |  |  | 9" of #28 wire, 14T on T37-0
1 | L293 | 132 nH |  |  |  | 9" of #28 wire, 13T on T37-0
3 | L303, L501, L505 | 120 nH |  |  |  | 9" of #28 wire, 12T on T37-0
2 | L403, L503 | 82 nH |  |  |  | 7" of #28 wire, 10T on T37-0
2 | L601, L605 | 39 nH |  |  |  | 5" of #28 wire, 5T on 1/8" Drill
1 | L603 | 24 nH |  |  |  | 4" of #28 wire, 7T on 1/8" Drill
8 | R1, R2, R3, R4, R5, R6, R7, R8 | 2.2K Ohm SMD 1206 Resistor | 652-CR1206FX-2201ELF
1 | U22 | LM1117-3.3 | 926-LM1117T-3.3/NOPB
1 | U35 | MCP23017-E/SO | 579-MCP23017-E/SO
21 | U1, U3, U4, U6, U7, U9, U10, U12, U13, U15, U16, U18, U19, U21, U24, U25, U27, U28, U30, U31, U36 | MASWS0179 | 937-MASWSS0179-T
11 | U2, U5, U8, U11, U14, U17, U20, U23, U26, U29, U37 | 74LVC1G04GW | 595-SN74LVC1G04DCKR
19 |  | T37-0 Toroid Cores (Tan) |  |  |  | KitsAndParts.Com
6 |  | T37-1 Toroid Cores (Blue) |  |  |  | KitsAndParts.Com
1 |  | T37-2 Toroid Cores (Red) |  |  |  | KitsAndParts.Com
4 |  | T37-6 Toroid Cores (Yellow) |  |  |  | KitsAndParts.Com
13 |  | T37-10 Toroid Cores (Black) |  |  |  | KitsAndParts.Com
2 |  | FT37-61 Toroid Cores (*none*) |  |  |  | KitsAndParts.Com
1 |  | 511" of #28 Transformer Wire |  |  |  | KitsAndParts.Com

Sheet: BPF Coil Design
 | # | Inductance | Designator | T37-1 | T37-2 | T37-7 | T37-6 | T37-10 | T37-17 | T37-0 | FT37-67 | FT37-61 | FT37-43 | FT37-72 | FT37-75 | nH | uH | Selected | T37-0 | T37-10 | T37-2 | T37-6 | T37-1 | FT37-61 | Diff | Wire Per | All |  | Type | Total
AL |  |  |  | 8 | 4 | 3.2 | 3 | 2.5 | 1.5 | 0.49 | 19.7 | 55.3 | 420 | 884 | 2196 | Target | Target | Turns | 0.49 | 2.5 | 4.0 | 3 | 8 | 55 | PCT | Core - in | Cores |  | Cores | Number
FL |  |  |  | 0.15 | 0.25 | 1 | 3 | 15 | 20 | 50 |  |  |  |  |  |  |  |  | 50 | 15 | 0.25 | 3 | 0.15 |  |  | 0.52 | In
FH |  |  |  | 3 | 10 | 25 | 40 | 100 | 200 | 350 |  |  |  |  |  |  |  |  | 350 | 100 | 10 | 40 | 3
 |  |  |  | Blue | Red | White | Yellow | Black | Blue/Yel | Tan | none | none | none | none | none
Turns | 1 | 24 nH | L603 | 1.7 | 2.4 | 2.7 | 2.8 | 3.1 | 4.0 | 7.0 | 1.1 | 0.7 | 0.2 | 0.2 | 0.1 | 24 | 0.024 | 7 | 24.01 |  |  |  |  |  | 0.04166666667% | 4.0 | 4.0 |  | T37-0 | 19
 | 2 | 39 nH | L601, L605 | 2.2 | 3.1 | 3.5 | 3.6 | 3.9 | 5.1 | 8.9 | 1.4 | 0.8 | 0.3 | 0.2 | 0.1 | 39 | 0.039 | 9 | 39.69 |  |  |  |  |  | 1.8% | 5.0 | 10.0 |  | T37-1 | 6
 | 2 | 82 nH | L403, L503 | 3.2 | 4.5 | 5.1 | 5.2 | 5.7 | 7.4 | 12.9 | 2.0 | 1.2 | 0.4 | 0.3 | 0.2 | 82 | 0.082 | 13 | 82.81 |  |  |  |  |  | 1.0% | 7.0 | 14.0 |  | T37-2 | 1
 | 3 | 120 nH | L303, L501, L505 | 3.9 | 5.5 | 6.1 | 6.3 | 6.9 | 8.9 | 15.6 | 2.5 | 1.5 | 0.5 | 0.4 | 0.2 | 120 | 0.12 | 16 | 125.44 |  |  |  |  |  | 4.5% | 9.0 | 27.0 |  | T37-6 | 4
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
 | 2 | 11 uH | L92, L94 | 37.1 | 52.4 | 58.6 | 60.6 | 66.3 | 85.6 | 149.8 | 23.6 | 14.1 | 5.1 | 3.5 | 2.2 | 11000 | 11 | 14 |  |  |  |  |  | 10780 | -2.0% | 8.0 | 16.0
 | 45 |  |  |  |  |  |  |  |  |  |  |  |  |  |  |  |  |  |  |  |  |  |  |  |  |  | 511.1 | = | 42.6 | Feet # 26 or #28

Sheet: Sheet1
Band | Inductor | Type | Color | Turns | Diff | Turns | Type
160M | L091 | T37-6 | Yellow | 25 | -1 | 26 | T37-6
 | L092 | FT37-10 | *none* | 15 | 1 | 14 | FT37-61 | ???
 | L093 | T37-10 | Black | 20 | 0 | 20 | T37-10
 | L094 | FT37-10 | *none* | 15 | 1 | 14 | FT37-61 | ???
 | L095 | T37-6 | Yellow | 25 | -1 | 26 | T37-6
80M | L101 | T37-10 | Black | 18 | -2 | 20 | T37-10
 | L102 | T37-1 | Blue | 26 | 0 | 26 | T37-1
 | L103 | T37-0 | Tan | 30 | -4 | 34 | T37-0
 | L104 | T37-1 | Blue | 26 | 0 | 26 | T37-1
 | L105 | T37-10 | Black | 18 | -2 | 20 | T37-10
60M | L191 | T37-10 | Black | 17 | -1 | 18 | T37-10
 | L192 | T37-1 | Blue | 25 | 0 | 25 | T37-1
 | L193 | T37-2 | Red | 9 | -1 | 10 | T37-2
 | L194 | T37-1 | Blue | 25 | 0 | 25 | T37-1
 | L195 | T37-10 | Black | 17 | -1 | 18 | T37-10
40M | L201 | T37-0 | Tan | 29 | -5 | 34 | T37-0
 | L202 | T37-1 | Blue | 21 | -1 | 22 | T37-1
 | L203 | T37-0 | Tan | 22 | -4 | 26 | T37-0
 | L204 | T37-1 | Blue | 21 | -1 | 22 | T37-1
 | L205 | T37-0 | Tan | 29 | -5 | 34 | T37-0
30M | L291 | T37-0 | Tan | 19 | -3 | 22 | T37-0
 | L292 | T37-10 | Black | 37 | -1 | 38 | T37-10
 | L293 | T37-0 | Tan | 11 | -5 | 16 | T37-0
 | L294 | T37-10 | Black | 37 | -1 | 38 | T37-10
 | L295 | T37-0 | Tan | 19 | -3 | 22 | T37-0
20M | L301 | T37-0 | Tan | 18 | -3 | 21 | T37-0
 | L302 | T37-6 | Yellow | 26 | -1 | 27 | T37-6
 | L303 | T37-0 | Tan | 12 | -4 | 16 | T37-0
 | L304 | T37-6 | Yellow | 26 | -1 | 27 | T37-6
 | L305 | T37-0 | Tan | 18 | -3 | 21 | T41-0
17M / 15M | L401 | T37-0 | Tan | 15 | -2 | 17 | T37-0
 | L402 | T37-10 | Black | 20 | -2 | 22 | T37-10
 | L403 | T37-0 | Tan | 12 | -1 | 13 | T37-0
 | L404 | T37-10 | Black | 20 | -2 | 22 | T37-10
 | L405 | T37-0 | Tan | 15 | -2 | 17 | T37-0
12M / 10M | L501 | T37-0 | Tan | 14 | -2 | 16 | T37-0
 | L502 | T37-10 | Black | 18 | 0 | 18 | T37-10
 | L503 | T37-0 | Tan | 12 | -1 | 13 | T37-0
 | L504 | T37-10 | Black | 18 | 0 | 18 | T37-10
 | L505 | T37-0 | Tan | 14 | -2 | 16 | T37-0
6M | L601 | 1/8" Dia Drill | *none* | 5 | 0 | 5 | 1/8" Dia Drill
 | L602 | 5/16" Dia Drill | *none* | 13 | 0 | 13 | 5/16" Dia Drill
 | L603 | 1/8" Dia Drill | *none* | 3 | 0 | 3 | 1/8" Dia Drill
 | L604 | 5/16" Dia Drill | *none* | 13 | 0 | 13 | 5/16" Dia Drill
 | L605 | 1/8" Dia Drill | *none* | 5 | 0 | 5 | 1/8" Dia Drill

Sheet: Before 021625
Quantity | Coils | Target L | New Winding Instruction | Updated 02-16-25
2 | L92, L94 | 11 uH | 14"of #28 wire, 15T on FT37-61 | changed from 14
2 | L102, L104 | 5.6 uH | 14" of #28 wire, 27T on T37-1 | Changed from 26
2 | L192, L194 | 5.2 uH | 13" of #28 wire, 26T on T37-1 | Changed from 25
2 | L202, L204 | 3.9 uH | 12" of #28 wire, 22T on T37-1 | ok
2 | L292, L294 | 3.6 uH | 20" of #28 wire, 38T on T37-10 | ok
2 | L302, L304 | 2.2 uH | 14" of #28 wire, 25T on T37-6 | Changed from 27
2 | L91, L95 | 2 uH | 14" of #28 wire, 26T on T37-6 | Changed from 25
2 | L402, L404 | 1.2 uH | 12" of #28 wire, 21T on T37-10 | Changed from 22
1 | L93 | 1 uh | 11" of #28 wire, 20T on T37-10 | ok
2 | L191, L195 | 840 nH | 10" of #28 wire, 17T on T37-10 | Changed from 18
2 | L502, L504 | 820 nH | 10" of #28 wire, 17T on T37-10 | Changed from 18
2 | L101, L105 | 810 nH | 11" of #28 wire, 20T on T37-10 | Changed from 18
2 | L602, L604 | 720 nH | 11" of #28 wire, 16T on T37-10 | Changed from 11" of #28 wire, 13T on 5/16" Drill
2 | L201, L205 | 560 nH | 18" of #28 wire, 32T on T37-0 | Changed from 34
1 | L103 | 440 nH | 18" of #28 wire, 32T on T37-0 | Changed from 30
1 | L193 | 400 nH | 6" of #28 wire, 9T on T37-2 | Changed from 10
1 | L203 | 330 nH | 14" of #28 wire, 23T on T37-0 | Changed from 26
2 | L291, L295 | 245 nH | 12" of #28 wire, 19T on T37-0 | Changed from 22
2 | L301, L305 | 220 nH | 11" of #28 wire, 17T on T37-0 | Changed from 21
2 | L401, L405 | 150 nH | 9" of #28 wire, 14T on T37-0 | Changed from 17
1 | L293 | 132 nH | 9" of #28 wire, 13T on T37-0 | Changed from 16
3 | L303, L501, L505 | 120 nH | 9" of #28 wire, 12T on T37-0 | Changed from 16
2 | L403, L503 | 82 nH | 7" of #28 wire, 10T on T37-0 | Changed from 13
2 | L601, L605 | 39 nH | 5" of #28 wire, 5T on 1/8" Drill | Changed from 3
1 | L603 | 24 nH | 4" of #28 wire, 7T on 1/8" Drill | Changed from 5
