DRWJSCHMIDT/T41/T41_V012_Files/T41_V012_BOMs/Source Files/T41_SDT_WA2MZE_partial_Digikey_Part_Numbers.xlsx

description | Manufacturer | part number | Digikey Part number | unit price | quantity | extension
1:1 CORE & WIRE TRANSFORMER, 0.1 | MCL | ADT1-1+ | 3157-ADT1-1+CT-ND | $5.11 | 1 | $5.11
1:2 CORE & WIRE TRANSFORMER, 0.4 | MCL | ADT2-1T+ | 3157-ADT2-1T+CT-ND | $6.44 | 1 | $6.44
IC MUX/DEMUX 2 X 4:1 16TSSOP | TI | SN74CBTLV3253PWR | 296-9133-1-ND | $0.60 | 4 | $2.40
IC AMP CELLULAR 0HZ-4GHZ SC70-6 | MCL | PSA-8A+ | 3157-PSA-8A+CT-ND | $4.48 | 1 | $4.48
IC INVERTER 1CH 1-INP 5TSSOP | Nexperia | 74LVC1G04GW | 1727-2871-1-ND | $0.28 | 3 | $0.84
IC OPAMP GP 2 CIRCUIT 8SOIC | STM | MC33078YDT | 497-10224-1-ND | $1.60 | 4 | $6.40
CRYSTAL 25.0000MHZ 8PF SMD | NDK | NX5032GA-25.000000MHZ-LN-CD-1 | 644-LNCD1-25MCT-ND | $0.61 | 1 | $0.61
Bipolar (BJT) Transistor NPN | OnSemi | 2n3904BU | 2N3904FS-ND | $0.24 | 10 | $2.39
Bipolar (BJT) Transistor PNP | onSemi | 2n3906BU | 2N3906FS-ND | $0.23 | 10 | $2.30
0.1uF 50V 1206 SMD CAP | Kemet | C1206C104K5RAC7800 | 399-C1206C104K5RAC7800CT-ND | 0.0398 | 50 | $1.99
1uF 25V 1206 SMD CAP | Kemet | c1206c105k3rac7800 | 399-C1206C105K3RACTUCT-ND | 0.158 | 10 | $1.58
10nF 0.01uF 50V 1206 SMD CAP | Kemet | C1206C103K5RAC | 399-C1206C103K5RACTUCT-ND | 0.122 | 10 | $1.22
10uF 16V 1206 SMD CAP | Kemet | C1206C106M3P | 399-C1206C106M3PAC7800CT-ND | 0.1248 | 50 | $6.24
68pF 50V 1206 SMD CAP | Kemet | C1206C680J5G | 399-C1206C680J5GAC7800CT-ND | 0.227 | 10 | $2.27
2.2nF 50V 1206 SMD CAP | Kemet | C1206C222K5RAC | 399-C1206C222K5RAC7800CT-ND | 0.14 | 10 | $1.40
3.3uF 16V 1206 SMD CAP | Kemet | C1206C335K4R | 399-C1206C335K4RAC7800CT-ND | 0.214 | 10 | $2.14
TERMINAL BLOCK, SCREW TYPE, 5.08 | CUI devices | TB006-508-02BE | 102-6191-ND | 0.86 | 1 | $0.86
DIODE GEN PURP 75V 150MA SOD323 | Diodes INC | 1N4148WS-7-F | 1N4148WS-FDICT-ND | 0.121 | 10 | $1.21
BS170 Nch MOS FET TO-92 | OnSemi | BS170 | BS170-ND | 0.289 | 10 | $2.89
2N7000 Nch MOS FET TO-92 | OnSemi | 2n7000 | 2N7000BU-ND | 0.276 | 10 | $2.76
MOSFET P-CH 60V 90A TO220AB | Vishay | sup90p06-09L-E3 | SUP90P06-09L-E3-ND | 5.35 | 1 | $5.35
DAC, Audio 16, 24, 32 b 384k PCM 20-TSSOP | TI | PCM5102APW | 296-41603-5-ND | 4.39 | 1 | $4.39
IC ADC/AUDIO 24BIT 96K 14TSSOP | TI | PCM1808PWR | 296-26307-1-ND | 1.55 | 1 | $1.55
Orange-Red 625nm LED Indication - Discrete 2.1V 1206 | Dialight | 5990220007f | 350-4361-1-ND | 0.157 | 10 | $1.57
DIODE GEN PURP 50V 1A SMA | Diodes INC | S1A-13-F | S1A-FDICT-ND | 0.167 | 10 | $1.67
470uF 25V 1206 SMD CAP | Panasonic | ECA-1EM471 | ECA-1EM471 | 0.323 | 10 | $3.23
10 µH Shielded Drum Core, Wirewound Inductor 3.1 A 45mOhm | murata | 1264EY-100M=P3 | 490-10814-1-ND | 0.33 | 3 | $0.99
36.5 Ohms ±1% 0.25W, 1/4W Chip Resistor 1206 | Vishay | CRCW120636R5FKEA | 541-36.5FCT-ND | 0.048 | 10 | $0.48
49.9 Ohms ±1% 0.25W, 1/4W Chip Resistor 1206 | Vishay | CRCW120649R9FKEA | 541-49.9FCT-ND | 0.048 | 10 | $0.48
53.6 Ohms ±1% 0.25W, 1/4W Chip Resistor 1206 | Vishay | CRCW120653R6FKEA | 541-53.6FCT-ND | 0.048 | 10 | $0.48
100 Ohms ±1% 0.25W, 1/4W Chip Resistor 1206 | Vishay | CRCW1206100RFKEAC | 541-3982-1-ND | 0.045 | 10 | $0.45
150 Ohms ±1% 0.25W, 1/4W Chip Resistor 1206 | Vishay | CRCW1206150RFKEAC | 541-4177-1-ND | 0.045 | 10 | $0.45
220 Ohms ±1% 0.25W, 1/4W Chip Resistor 1206 | Vishay | CRCW1206220RFKEB | 541-CRCW1206220RFKEBCT-ND | 0.048 | 10 | $0.48
RES SMD 350 OHM 0.1% 1/4W 1206 | Vishay | D55342E07B350ART5 | 764-D55342E07B350ART5CT-ND | 4.7 | 1 | $4.70
RES SMD 500 OHM 0.05% 1/4W 1206 | Vishay | TNPU1206500RAZEN00 | 541-3306-1-ND | 3.63 | 3 | $10.89
787 Ohms ±1% 0.25W, 1/4W Chip Resistor 1206 | Vishay | CRCW1206787RFKTA | 541-CRCW1206787RFKTACT-ND | 0.089 | 10 | $0.89
1.2 kOhms ±1% 0.25W, 1/4W Chip Resistor 1206 | Vishay | CRCW12061K20FKEA | 541-1.20KFCT-ND | 0.048 | 10 | $0.48
2 kOhms ±1% 0.25W, 1/4W Chip Resistor 1206 | Vishay | CRCW12062K00FKEA | 541-2.00KFCT-ND | 0.048 | 10 | $0.48
2.2 kOhms ±1% 0.25W, 1/4W Chip Resistor 1206 | Vishay | CRCW12062K20FKEA | 541-2.20KFCT-ND | 0.048 | 10 | $0.48
5.1 kOhms ±1% 0.25W, 1/4W Chip Resistor | Vishay | CRCW12065K10FKEA | 541-5.10KFCT-ND | 0.048 | 10 | $0.48
RES SMD 10K OHM 1% 1/4W 1206 | Vishay | CRCW120610K0FKEB | 541-CRCW120610K0FKEBCT-ND | 0.048 | 20 | $0.96
RES SMD 100K OHM 1% 1/4W 1206 | Vishay | CRCW1206100KFKEB | 541-CRCW1206100KFKEBCT-ND | 0.048 | 10 | $0.48
RES SMD 470 OHM 1% 1/4W 1206 | Vishay | CRCW1206470RFKEA | 541-470FCT-ND | 0.048 | 10 | $0.48
RES SMD 1K OHM 1% 1/4W 1206 | Vishay | CRCW12061K00FKEA | 541-1.00KFCT-ND | 0.048 | 10 | $0.48
CONN JACK STEREO 3.5MM R/A | CUI devices | SJ1-3514N | CP1-3514N-ND | 1.33 | 5 | $6.65
FIXED IND 1.5UH 50MA 500MOHM SMD | Vishay | ILSB1206ER1R5K | 541-ILSB1206ER1R5KCT-ND | 0.171 | 10 | $1.71
IC RF SWITCH SPDT 2GHZ SOT26 | macom | MASWSS0179TR-3000 | 1465-1387-1-ND | 1.1 | 1 | $1.10
Linear Voltage Regulator IC Positive Fixed 1 Output 150mA TO-92 | diodes inc | AP7381-50V-A | AP7381-50V-ADICT-ND | 0.46 | 2 | $0.92
 |  |  |  |  | sub total | $108.28
 |  |  |  |  | tariff | $1.23
 |  |  |  |  | extended | $109.51
 |  |  |  |  | MA Tax | $6.84
 |  |  |  |  | total | $116.35
ship to:
