DRWJSCHMIDT/T41/T41_V012_Files/T41_V012_Assembled_PCBs_V12.8/Files/T41-Single-PE4312-Attenuator-daughterboard_031426/T41-Single-PE4312-Attenuator-daughterboard-Assy_BOM.xlsx

Comment | Designator | Footprint | JLCPCB Part #
10uF 50V SMD | C1 | 0603 | C86277
0.1uF 50V X7R 0603 SMD | C2 | 0603 | C696359
Ferrite bead 600 mOhm 1.3A 0603 SMD | L1 | 0603 | C85833
10K Ohm 1/8W 0.1% | R1, R2 | 0603 | C95204
PE4312C-Z Attenuator 20 Lead 4x4 QFN | U1 | PE4312-QFN-20 | C500480
