DRWJSCHMIDT/T41/T41_V012_Files/T41_V012_Assembled_PCBs_V12.8/Files/T41-si5351A-B-GM-Oscillator-daughterboard-090826/T41-si5351A-B-GM-Oscillator_daughterboard-Assy_BOM.xlsx

Comment | Designator | Footprint | JLCPCB Part #
0.1uF 50V X7R 0603 SMD | C1, C2, C3, C4, C5 | 0603 | C696359
Ferrite bead 600 mOhm 1A 0603 SMD | L1, L2, L3, L4 | 0603 | C160980
si5351A-B-M 20 Lead 4x4 QFN | U1 | QFN-20-1EP | C1519890
TC80E-25.000-DTAKA SMD 3225 | U4 | SMD 3225 | C3003285
