DRWJSCHMIDT/T41/T41_V012_Files/T41_V012_BPF_Design_Files/K9HZ_T41_BPF_Design_Files/WJS T41 BPF Design.xlsx

Sheet: T41_BPF
 | Recommended Freq. Range** | Average | Tolerance | Tolerance | Rec. Freq.
Type | Toroids.Info (2018 ARRL) | AL | Pct. (+) | Pct. (-) | Min | Max | Color | OD | ID | Height |  | T41 V12.6 BPF Inductors
FT37-61 | .2 MHz - 10 MHz (.2M-10M) | 55.300 | 25% | 25% | .2 MHz | 10 MHz | Dull Black | 0.375 | 0.187 | 0.125 |  |  |  |  |  |  |  |  | Using |  |  | Designed | As Built &
FT37-67 | .5 MHz - 30 MHz (15M-25M) | 17.600 | 35% | 25% | .5 MHz | 30 MHz | Dull Black | 0.375 | 0.187 | 0.125 |  |  | From Elsie |  |  |  |  |  | avg AL | Calc. Turn |  | @ avg AL | Measured
T37-0 | 50 MHz - 300 MHz (100M - 300M) | 0.490 | 5% | 5% | 50 MHz | 300 MHz | Tan/Tan | 0.375 | 0.205 | 0.128 |  |  | (assuming C's as built) |  |  | Recommended |  |  | calculated | uH Range |  | calculated | (& corrected) | Approx Wire | Enamel | Approximate
T37-1 | 150 KHz - 3 MHz (.5M-5M) | 8.000 | 10% | 10% | .15 MHz | 3 MHz | Blue/Clear | 0.375 | 0.205 | 0.128 | Band | BPF Inductor | Inductance (uH) | Center Mhz | Toroid | Min F | Max F | Color | turns | Low | High | Turns | Turns | Length (in.) | Wire Gauge | Air Coil Diam | Air Coil Len | Value | Turns | Core
T37-10 | 15 MHz - 100 MHz (30M - 100M) | 2.500 | 5% | 5% | 15 MHz | 100 MHz | Black/Clear | 0.375 | 0.205 | 0.128 | 160 | L091 | 2.1700 | 1.9 | T37-7 | 1 MHz | 25 MHz | White/Clear | 26.0 | 25.4 | 26.7 | 26 | 26.03268919 | 14 | 28 |  |  | 2 uH | 26 | T37-6
T37-17 | 20 MHz - 200 MHz (40M - 180M) | 1.500 | 5% | 5% | 20 MHz | 200 MHz | Blue/Yellow | 0.375 | 0.205 | 0.128 |  | L092 | 12.0000 |  | FT37-67 | .5 MHz | 30 MHz | Dull Black | 26.1 | 22.6 | 30.3 | 26 | 26.47617233 | 17 | 28 |  |  | 11 uH | 15 | FT37-61
T37-2 | 250 KHz - 10 MHz (2M- 30M) | 4.000 | 5% | 5% | .25 MHz | 10 MHz | Red/Clear | 0.375 | 0.205 | 0.128 |  | L093 | 1.2200 |  | T37-1 | .15 MHz | 3 MHz | Blue/Clear | 12.3 | 11.7 | 13.0 | 12 | 12.33360418 | 8 | 28 |  |  | 1 uh | 20 | T37-10
T37-6 | 3 MHz - 40 MHz (10M - 50M) | 3.000 | 5% | 5% | 3 MHz | 40 MHz | Yellow/Clear | 0.375 | 0.205 | 0.128 |  | L094 | 12.0000 |  | FT37-67 | .5 MHz | 30 MHz | Dull Black | 26.1 | 22.6 | 30.3 | 26 | 26.47617233 | 17 | 28 |  |  | 11 uH | 15 | FT37-61
T37-7 | 1 MHz - 25 MHz (7M - 35M) | 3.200 | 5% | 5% | 1 MHz | 25 MHz | White/Clear | 0.375 | 0.205 | 0.128 |  | L095 | 2.1700 |  | T37-7 | 1 MHz | 25 MHz | White/Clear | 26.0 | 25.4 | 26.7 | 26 | 26.03268919 | 16 | 28 |  |  | 2 uH | 26 | T37-6
T50-0 | 50 MHz - 300 MHz (100M - 300M) | 0.640 | 5% | 5% | 50 MHz | 300 MHz | Tan/Tan | 0.375 | 0.205 | 0.128 | 80 | L101 | 1.0000 | 3.75 | T37-2 | .25 MHz | 10 MHz | Red/Clear | 15.8 | 15.4 | 16.2 | 16 | 15.80644338 | 10 | 28 |  |  | 810 nH | 20 | T37-10
T50-1 | 150 KHz - 3 MHz (.5M-5M) | 10.000 | 10% | 10% | .15 MHz | 3 MHz | Blue/Clear | 0.375 | 0.205 | 0.128 |  | L102 | 6.0000 |  | FT37-67 | .5 MHz | 30 MHz | Dull Black | 18.5 | 16.0 | 21.5 | 18 | 18.72148099 | 12 | 28 |  |  | 5.6 uH | 27 | T37-1
T50-10 | 15 MHz - 100 MHz (30M - 100M) | 3.100 | 5% | 5% | 15 MHz | 100 MHz | Black/Clear | 0.375 | 0.205 | 0.128 |  | L103 | 0.6000 |  | T37-6 | 3 MHz | 40 MHz | Yellow/Clear | 14.1 | 13.8 | 14.5 | 14 | 14.13771275 | 9 | 28 |  |  | 440 nH | 32 | T37-0
T50-17 | 20 MHz - 200 MHz (40M - 180M) | 1.800 | 5% | 5% | 20 MHz | 200 MHz | Blue/Yellow | 0.375 | 0.205 | 0.128 |  | L104 | 6.0000 |  | FT37-67 | .5 MHz | 30 MHz | Dull Black | 18.5 | 16.0 | 21.5 | 18 | 18.72148099 | 12 | 28 |  |  | 5.6 uH | 27 | T37-1
T50-2 | 250 KHz - 10 MHz (2M- 30M) | 4.900 | 5% | 5% | .25 MHz | 10 MHz | Red/Clear | 0.375 | 0.205 | 0.128 |  | L105 | 1.0000 |  | T37-2 | .25 MHz | 10 MHz | Red/Clear | 15.8 | 15.4 | 16.2 | 16 | 15.80644338 | 10 | 28 |  |  | 810 nH | 20 | T37-10
T50-6 | 3 MHz - 40 MHz (10M - 50M) | 4.000 | 5% | 5% | 3 MHz | 40 MHz | Yellow/Clear | 0.375 | 0.205 | 0.128 | 60 | L191 | 0.7350 | 5.3585 | T37-7 | 1 MHz | 25 MHz | White/Clear | 15.2 | 14.8 | 15.5 | 15 | 14 | 9 | 28 |  |  | 840 nH | 17 | T37-10
T50-7 | 1 MHz - 25 MHz (7M - 35M) | 4.300 | 5% | 5% | 1 MHz | 25 MHz | White/Clear | 0.375 | 0.205 | 0.128 |  | L192 | 4.5200 |  | FT37-67 | .5 MHz | 30 MHz | Dull Black | 16.0 | 13.9 | 18.6 | 16 | 16.2492677 | 11 | 28 |  |  | 5.2 uH | 26 | T37-1
T68-1 | 150 KHz - 3 MHz (.5M-5M) | 11.500 | 10% | 10% | .15 MHz | 3 MHz | Blue/Clear | 0.69 | 0.37 | 0.19 |  | L193 | 0.3525 |  | T37-6 | 3 MHz | 40 MHz | Yellow/Clear | 10.8 | 10.6 | 11.1 | 11 | 10.83635163 | 7 | 28 |  |  | 400 nH | 9 | T37-2
T68-10 | 15 MHz - 100 MHz (30M - 100M) | 3.200 | 5% | 5% | 15 MHz | 100 MHz | Black/Clear | 0.69 | 0.37 | 0.19 |  | L194 | 4.5200 |  | FT37-67 | .5 MHz | 30 MHz | Dull Black | 16.0 | 13.9 | 18.6 | 16 | 16.2492677 | 11 | 28 |  |  | 5.2 uH | 26 | T37-1
T68-17 | 20 MHz - 200 MHz (40M - 180M) | 2.100 | 5% | 5% | 20 MHz | 200 MHz | Blue/Yellow | 0.69 | 0.37 | 0.19 |  | L195 | 0.7350 |  | T37-7 | 1 MHz | 25 MHz | White/Clear | 15.2 | 14.8 | 15.5 | 15 | 14 | 9 | 28 |  |  | 840 nH | 17 | T37-10
T68-2 | 250 KHz - 10 MHz (2M- 30M) | 5.700 | 5% | 5% | .25 MHz | 10 MHz | Red/Clear | 0.69 | 0.37 | 0.19 | 40 | L201 | 0.4129 | 7.15 | T37-2 | .25 MHz | 10 MHz | Red/Clear | 10.2 | 9.9 | 10.4 | 10 | 10.156793 | 6 | 28 |  |  | 560 nH | 32 | T37-0
T68-6 | 3 MHz - 40 MHz (10M - 50M) | 4.700 | 5% | 5% | 3 MHz | 40 MHz | Yellow/Clear | 0.69 | 0.37 | 0.19 |  | L202 | 2.7520 |  | T37-2 | .25 MHz | 10 MHz | Red/Clear | 26.2 | 25.6 | 26.9 | 26 | 26.22155089 | 16 | 28 |  |  | 3.9 uH | 22 | T37-1
T68-7 | 1 MHz - 25 MHz (7M - 35M) | 5.200 | 5% | 5% | 1 MHz | 25 MHz | White/Clear | 0.69 | 0.37 | 0.19 |  | L203 | 0.2477 |  | T37-6 | 3 MHz | 40 MHz | Yellow/Clear | 9.1 | 8.9 | 9.3 | 9 | 9.08377841 | 6 | 28 |  |  | 330 nH | 23 | T37-0
 | **(FT values are for when toroid used as high-Q inductor) |  |  |  |  |  |  |  |  |  |  | L204 | 2.7520 |  | T37-2 | .25 MHz | 10 MHz | Red/Clear | 26.2 | 25.6 | 26.9 | 26 | 26.22155089 | 16 | 28 |  |  | 3.9 uH | 22 | T37-1
 |  |  |  |  |  |  |  |  |  |  |  | L205 | 0.4129 |  | T37-2 | .25 MHz | 10 MHz | Red/Clear | 10.2 | 9.9 | 10.4 | 10 | 10.156793 | 6 | 28 |  |  | 560 nH | 32 | T37-0
 |  |  |  |  |  |  |  |  |  |  | 30 | L291 | 0.2471 | 10.125 | T37-6 | 3 MHz | 40 MHz | Yellow/Clear | 9.1 | 8.8 | 9.3 | 9 | 9.07276999 | 6 | 28 |  |  | 245 nH | 19 | T37-0
AWG Enamel Wire Diam |  |  |  |  |  |  |  |  |  |  |  | L292 | 3.6340 |  | T37-7 | 1 MHz | 25 MHz | White/Clear | 33.7 | 32.8 | 34.5 | 34 | 33.68849641 | 21 | 28 |  |  | 3.6 uH | 38 | T37-10
20 | 0.8128 | mm |  |  |  |  |  |  |  |  |  | L293 | 0.1305 |  | Air Core Coil |  |  | 5 turns on .25" form | 22 # ~1/4" long coil |  |  | 5.502363129 | 5 | 5 | 22 | 0.2500 | 0.2500 | 132 nH | 13 | T37-0
22 | 0.644 | mm |  |  |  |  |  |  |  |  |  | L294 | 3.6340 |  | T37-7 | 1 MHz | 25 MHz | White/Clear | 33.7 | 32.8 | 34.5 | 34 | 33.68849641 | 21 | 28 |  |  | 3.6 uH | 38 | T37-10
24 | 0.511 | mm |  |  |  |  |  |  |  |  |  | L295 | 0.2471 |  | T37-6 | 3 MHz | 40 MHz | Yellow/Clear | 9.1 | 8.8 | 9.3 | 9 | 9.07276999 | 6 | 28 |  |  | 245 nH | 19 | T37-0
26 | 0.405 | mm |  |  |  |  |  |  |  |  | 20 | L301 | 0.1693 | 14.175 | Air Core Coil |  |  | 6 turns on .25" form | 22 # ~1/4" + long coil |  |  | 6.479691351 | 6 | 6 | 22 | 0.2500 | 0.2750 | 220 nH | 17 | T37-0
28 | 0.321 | mm |  |  |  |  |  |  |  |  |  | L302 | 1.6930 |  | T37-7 | 1 MHz | 25 MHz | White/Clear | 23.0 | 22.4 | 23.6 | 23 | 22.99416511 | 14 | 28 |  |  | 2.2 uH | 25 | T37-6
30 | 0.255 | mm |  |  |  |  |  |  |  |  |  | L303 | 0.0977 |  | Air Core Coil |  |  | 6 turns on 3/16" form | 24 # ~1/2" long coil |  |  | 7.145945237 | 6 | 5 | 24 | 0.1875 | 0.3750 | 120 nH | 12 | T37-0
32 | 0.202 | mm |  |  |  |  |  |  |  |  |  | L304 | 1.6930 |  | T37-7 | 1 MHz | 25 MHz | White/Clear | 23.0 | 22.4 | 23.6 | 23 | 22.99416511 | 14 | 28 |  |  | 2.2 uH | 25 | T37-6
 |  |  |  |  |  |  |  |  |  |  |  | L305 | 0.1693 |  | Air Core Coil |  |  | 6 turns on .25" form | 22 # ~1/4" + long coil |  |  | 6.479691351 | 6 | 6 | 22 | 0.2500 | 0.2750 | 220 nH | 17 | T37-0
Approximate |  |  |  |  |  |  |  |  |  |  | 17/15 | L401 | 0.1665 | 19.759 | Air Core Coil |  |  | 6 turns on .25" form | 22 # ~1/4" +long coil |  |  | 6.425885153 | 6 | 6 | 22 | 0.2500 | 0.2750 | 150 nH | 14 | T37-0
Air Core Coil Formula |  |  |  |  |  |  |  |  |  |  |  | L402 | 1.2730 |  | T37-7 | 1 MHz | 25 MHz | White/Clear | 19.9 | 19.4 | 20.4 | 20 | 19.93899976 | 12 | 28 |  |  | 1.2 uH | 21 | T37-10
 |  |  |  |  |  |  |  |  |  |  |  | L403 | 0.0955 |  | Air Core Coil |  |  | 6 turns on 3/16" form | 24 # ~3/16" + long coil |  |  | 6.248911016 | 6 | 5 | 24 | 0.1875 | 0.2750 | 82 nH | 10 | T37-0
 |  |  |  |  |  |  |  |  |  |  |  | L404 | 1.2730 |  | T37-7 | 1 MHz | 25 MHz | White/Clear | 19.9 | 19.4 | 20.4 | 20 | 19.93899976 | 12 | 28 |  |  | 1.2 uH | 21 | T37-10
 |  |  |  |  |  |  |  |  |  |  |  | L405 | 0.1665 |  | Air Core Coil |  |  | 6 turns on .25" form | 22 # ~1/4" + long coil |  |  | 6.425885153 | 6 | 6 | 22 | 0.2500 | 0.2750 | 150 nH | 14 | T37-0
n = sqrt ((L * (18d + 40l) / (d^2)) |  |  |  |  |  |  |  |  |  |  | 12/10 | L501 | 0.1133 | 27.295 | Air Core Coil |  |  | 5 turns on .25" form | 22 # ~1/2" long coil |  |  | 5.94555296 | 5 | 5 | 22 | 0.2500 | 0.3750 | 120 nH | 12 | T37-0
 |  |  |  |  |  |  |  |  |  |  |  | L502 | 0.7910 |  | T37-17 | 20 MHz | 200 MHz | Blue/Yellow | 23.0 | 22.4 | 23.5 | 23 | 22 | 14 | 28 |  |  | 820 nH | 17 | T37-10
 |  |  |  |  |  |  |  |  |  |  |  | L503 | 0.0667 |  | Air Core Coil |  |  | 4 turns on 3/16" form | 22 # ~3/8" long coil |  |  | 5.904393844 | 5 | 4 | 22 | 0.1875 | 0.3750 | 82 nH | 10 | T37-0
L = | uH |  |  |  |  |  |  |  |  |  |  | L504 | 0.7910 |  | T37-17 | 20 MHz | 200 MHz | Blue/Yellow | 23.0 | 22.4 | 23.5 | 23 | 22 | 14 | 28 |  |  | 820 nH | 17 | T37-10
d = | coil diameter (in) |  |  |  |  |  |  |  |  |  |  | L505 | 0.1133 |  | Air Core Coil |  |  | 5 turns on .25" form | 22 # ~1/2" long coil |  |  | 5.94555296 | 5 | 5 | 22 | 0.2500 | 0.3750 | 120 nH | 12 | T37-0
n = | number of turns |  |  |  |  |  |  |  |  |  | 6 | L601 | 0.0360 | 52 | Air Core Coil |  |  | 3 turns on .25" form | 24 # spread coil |  |  | 3.756594202 | 3 | 4 | 24 | 0.2500 | 0.5000 | 39 nH | 5 | 1/8" Drill
l = | coil length (in) |  |  |  |  |  |  |  |  |  |  | L602 | 0.6670 |  | T37-17 | 20 MHz | 200 MHz | Blue/Yellow | 21.1 | 20.6 | 21.6 | 21 | 20 | 13 | 28 |  |  | 720 nH | 16 | T37-10
 |  |  |  |  |  |  |  |  |  |  |  | L603 | 0.0200 |  | Air Core Coil |  |  | 3 turns on 3/16" form | 24 # spread coil |  |  | 3.646611822 | 3 | 3 | 24 | 0.1875 | 0.5000 | 24 nH | 7 | 1/8" Drill
 |  |  |  |  |  |  |  |  |  |  |  | L604 | 0.6670 |  | T37-17 | 20 MHz | 200 MHz | Blue/Yellow | 21.1 | 20.6 | 21.6 | 21 | 20 | 13 | 28 |  |  | 720 nH | 16 | T37-10
 |  |  |  |  |  |  |  |  |  |  |  | L605 | 0.0390 |  | Air Core Coil |  |  | 3 turns on .25" form | 24 # spread coil |  |  | 3.909987212 | 3 | 4 | 24 | 0.2500 | 0.5000 | 39 nH | 5 | 1/8" Drill

Sheet: Sheet2
 | Recommended Freq. Range** | Average | Tolerance | Tolerance | Rec. Freq.
Type | Toroids.Info (2018 ARRL) | AL | Pct. (+) | Pct. (-) | Min | Max | Color | OD | ID | Height |  | AE0AM T41 V12.6 BPF Inductors
FT37-61 | .2 MHz - 10 MHz (.2M-10M) | 55.300 | 25% | 25% | .2 MHz | 10 MHz | Dull Black | 0.375 | 0.187 | 0.125 |  |  |  |  |  |  | As Built &
FT37-67 | .5 MHz - 30 MHz (15M-25M) | 17.600 | 35% | 25% | .5 MHz | 30 MHz | Dull Black | 0.375 | 0.187 | 0.125 |  |  | From Elsie |  |  | Toroid | Measured | Approx | Enamel
T37-0 | 50 MHz - 300 MHz (100M - 300M) | 0.490 | 5% | 5% | 50 MHz | 300 MHz | Tan/Tan | 0.375 | 0.205 | 0.128 |  | BPF | (C's as built) | Center |  | Material | (& corrected) | Wire | Wire
T37-1 | 150 KHz - 3 MHz (.5M-5M) | 8.000 | 10% | 10% | .15 MHz | 3 MHz | Blue/Clear | 0.375 | 0.205 | 0.128 | Band | Inductor | Inductance (uH) | Mhz | Toroid | Color | Turns | Length (in.) | Gauge
T37-10 | 15 MHz - 100 MHz (30M - 100M) | 2.500 | 5% | 5% | 15 MHz | 100 MHz | Black/Clear | 0.375 | 0.205 | 0.128 | 160 | L091 | 2.1700 | 1.9 | T37-7 | White/Clear | 26.03268919 | 14 | 28
T37-17 | 20 MHz - 200 MHz (40M - 180M) | 1.500 | 5% | 5% | 20 MHz | 200 MHz | Blue/Yellow | 0.375 | 0.205 | 0.128 |  | L092 | 12.0000 |  | FT37-67 | Dull Black | 26.47617233 | 17 | 28
T37-2 | 250 KHz - 10 MHz (2M- 30M) | 4.000 | 5% | 5% | .25 MHz | 10 MHz | Red/Clear | 0.375 | 0.205 | 0.128 |  | L093 | 1.2200 |  | T37-1 | Blue/Clear | 12.33360418 | 8 | 28
T37-6 | 3 MHz - 40 MHz (10M - 50M) | 3.000 | 5% | 5% | 3 MHz | 40 MHz | Yellow/Clear | 0.375 | 0.205 | 0.128 |  | L094 | 12.0000 |  | FT37-67 | Dull Black | 26.47617233 | 17 | 28
T37-7 | 1 MHz - 25 MHz (7M - 35M) | 3.200 | 5% | 5% | 1 MHz | 25 MHz | White/Clear | 0.375 | 0.205 | 0.128 |  | L095 | 2.1700 |  | T37-7 | White/Clear | 26.03268919 | 16 | 28
T50-0 | 50 MHz - 300 MHz (100M - 300M) | 0.640 | 5% | 5% | 50 MHz | 300 MHz | Tan/Tan | 0.375 | 0.205 | 0.128 | 80 | L101 | 1.0000 | 3.75 | T37-2 | Red/Clear | 15.80644338 | 10 | 28
T50-1 | 150 KHz - 3 MHz (.5M-5M) | 10.000 | 10% | 10% | .15 MHz | 3 MHz | Blue/Clear | 0.375 | 0.205 | 0.128 |  | L102 | 6.0000 |  | FT37-67 | Dull Black | 18.72148099 | 12 | 28
T50-10 | 15 MHz - 100 MHz (30M - 100M) | 3.100 | 5% | 5% | 15 MHz | 100 MHz | Black/Clear | 0.375 | 0.205 | 0.128 |  | L103 | 0.6000 |  | T37-6 | Yellow/Clear | 14.13771275 | 9 | 28
T50-17 | 20 MHz - 200 MHz (40M - 180M) | 1.800 | 5% | 5% | 20 MHz | 200 MHz | Blue/Yellow | 0.375 | 0.205 | 0.128 |  | L104 | 6.0000 |  | FT37-67 | Dull Black | 18.72148099 | 12 | 28
T50-2 | 250 KHz - 10 MHz (2M- 30M) | 4.900 | 5% | 5% | .25 MHz | 10 MHz | Red/Clear | 0.375 | 0.205 | 0.128 |  | L105 | 1.0000 |  | T37-2 | Red/Clear | 15.80644338 | 10 | 28
T50-6 | 3 MHz - 40 MHz (10M - 50M) | 4.000 | 5% | 5% | 3 MHz | 40 MHz | Yellow/Clear | 0.375 | 0.205 | 0.128 | 60 | L191 | 0.7350 | 5.3585 | T37-7 | White/Clear | 14 | 9 | 28
T50-7 | 1 MHz - 25 MHz (7M - 35M) | 4.300 | 5% | 5% | 1 MHz | 25 MHz | White/Clear | 0.375 | 0.205 | 0.128 |  | L192 | 4.5200 |  | FT37-67 | Dull Black | 16.2492677 | 11 | 28
T68-1 | 150 KHz - 3 MHz (.5M-5M) | 11.500 | 10% | 10% | .15 MHz | 3 MHz | Blue/Clear | 0.69 | 0.37 | 0.19 |  | L193 | 0.3525 |  | T37-6 | Yellow/Clear | 10.83635163 | 7 | 28
T68-10 | 15 MHz - 100 MHz (30M - 100M) | 3.200 | 5% | 5% | 15 MHz | 100 MHz | Black/Clear | 0.69 | 0.37 | 0.19 |  | L194 | 4.5200 |  | FT37-67 | Dull Black | 16.2492677 | 11 | 28
T68-17 | 20 MHz - 200 MHz (40M - 180M) | 2.100 | 5% | 5% | 20 MHz | 200 MHz | Blue/Yellow | 0.69 | 0.37 | 0.19 |  | L195 | 0.7350 |  | T37-7 | White/Clear | 14 | 9 | 28
T68-2 | 250 KHz - 10 MHz (2M- 30M) | 5.700 | 5% | 5% | .25 MHz | 10 MHz | Red/Clear | 0.69 | 0.37 | 0.19 | 40 | L201 | 0.4129 | 7.15 | T37-2 | Red/Clear | 10.156793 | 6 | 28
T68-6 | 3 MHz - 40 MHz (10M - 50M) | 4.700 | 5% | 5% | 3 MHz | 40 MHz | Yellow/Clear | 0.69 | 0.37 | 0.19 |  | L202 | 2.7520 |  | T37-2 | Red/Clear | 26.22155089 | 16 | 28
T68-7 | 1 MHz - 25 MHz (7M - 35M) | 5.200 | 5% | 5% | 1 MHz | 25 MHz | White/Clear | 0.69 | 0.37 | 0.19 |  | L203 | 0.2477 |  | T37-6 | Yellow/Clear | 9.08377841 | 6 | 28
 | **(FT values are for when toroid used as high-Q inductor) |  |  |  |  |  |  |  |  |  |  | L204 | 2.7520 |  | T37-2 | Red/Clear | 26.22155089 | 16 | 28
 |  |  |  |  |  |  |  |  |  |  |  | L205 | 0.4129 |  | T37-2 | Red/Clear | 10.156793 | 6 | 28
 |  |  |  |  |  |  |  |  |  |  | 30 | L291 | 0.2471 | 10.125 | T37-6 | Yellow/Clear | 9.07276999 | 6 | 28
AWG Enamel Wire Diam |  |  |  |  |  |  |  |  |  |  |  | L292 | 3.6340 |  | T37-7 | White/Clear | 33.68849641 | 21 | 28
20 | 0.8128 | mm |  |  |  |  |  |  |  |  |  | L293 | 0.1305 |  | Air Core Coil | 5 turns; .25" form; ~1/4" long | 5 | 5 | 22
22 | 0.644 | mm |  |  |  |  |  |  |  |  |  | L294 | 3.6340 |  | T37-7 | White/Clear | 33.68849641 | 21 | 28
24 | 0.511 | mm |  |  |  |  |  |  |  |  |  | L295 | 0.2471 |  | T37-6 | Yellow/Clear | 9.07276999 | 6 | 28
26 | 0.405 | mm |  |  |  |  |  |  |  |  | 20 | L301 | 0.1693 | 14.175 | Air Core Coil | 6 turns; .25" form; ~1/4+" long | 6 | 6 | 22
28 | 0.321 | mm |  |  |  |  |  |  |  |  |  | L302 | 1.6930 |  | T37-7 | White/Clear | 22.99416511 | 14 | 28
30 | 0.255 | mm |  |  |  |  |  |  |  |  |  | L303 | 0.0977 |  | Air Core Coil | 6 turns; 3/16" form; ~1/2" long | 6 | 5 | 24
32 | 0.202 | mm |  |  |  |  |  |  |  |  |  | L304 | 1.6930 |  | T37-7 | White/Clear | 22.99416511 | 14 | 28
 |  |  |  |  |  |  |  |  |  |  |  | L305 | 0.1693 |  | Air Core Coil | 6 turns; .25" form; ~1/4+" long | 6 | 6 | 22
Approximate |  |  |  |  |  |  |  |  |  |  | 17/15 | L401 | 0.1665 | 19.759 | Air Core Coil | 6 turns; .25" form; ~1/4+" long | 6 | 6 | 22
Air Core Coil Formula |  |  |  |  |  |  |  |  |  |  |  | L402 | 1.2730 |  | T37-7 | White/Clear | 19.93899976 | 12 | 28
 |  |  |  |  |  |  |  |  |  |  |  | L403 | 0.0955 |  | Air Core Coil | 6 turns; 3/16" form; ~3/16+" long | 6 | 5 | 24
 |  |  |  |  |  |  |  |  |  |  |  | L404 | 1.2730 |  | T37-7 | White/Clear | 19.93899976 | 12 | 28
 |  |  |  |  |  |  |  |  |  |  |  | L405 | 0.1665 |  | Air Core Coil | 6 turns; .25" form; ~1/4+" long | 6 | 6 | 22
n = sqrt ((L * (18d + 40l) / (d^2)) |  |  |  |  |  |  |  |  |  |  | 12/10 | L501 | 0.1133 | 27.295 | Air Core Coil | 5 turns; .25" form; ~1/2" long | 5 | 5 | 22
 |  |  |  |  |  |  |  |  |  |  |  | L502 | 0.7910 |  | T37-17 | Blue/Yellow | 22 | 14 | 28
 |  |  |  |  |  |  |  |  |  |  |  | L503 | 0.0667 |  | Air Core Coil | 4 turns; 3/16" form; ~3/8" long | 5 | 4 | 22
L = | uH |  |  |  |  |  |  |  |  |  |  | L504 | 0.7910 |  | T37-17 | Blue/Yellow | 22 | 14 | 28
d = | coil diameter (in) |  |  |  |  |  |  |  |  |  |  | L505 | 0.1133 |  | Air Core Coil | 5 turns; .25" form; ~1/2" long | 5 | 5 | 22
n = | number of turns |  |  |  |  |  |  |  |  |  | 6 | L601 | 0.0360 | 52 | Air Core Coil | 3 turns; .25" form; spread coil | 3 | 4 | 24
l = | coil length (in) |  |  |  |  |  |  |  |  |  |  | L602 | 0.6670 |  | T37-17 | Blue/Yellow | 20 | 13 | 28
 |  |  |  |  |  |  |  |  |  |  |  | L603 | 0.0200 |  | Air Core Coil | 3 turns; 3/16" form; spread coil | 3 | 3 | 24
 |  |  |  |  |  |  |  |  |  |  |  | L604 | 0.6670 |  | T37-17 | Blue/Yellow | 20 | 13 | 28
 |  |  |  |  |  |  |  |  |  |  |  | L605 | 0.0390 |  | Air Core Coil | 3 turns; .25" form; spread coil | 3 | 4 | 24

Sheet: Sheet1
 | From Elsie |  | From Elsie |  | From Elsie
BPF | (C's as built)* | BPF | (C's as built)* | BPF | (C's as built)
Inductor | Inductance (uH) | Inductor | Inductance (uH) | Inductor | Inductance (uH)
L091 | 2.1700 | L201 | 0.4129 | L401 | 0.1665
L092 | 12.0000 | L202 | 2.7520 | L402 | 1.2730
L093 | 1.2200 | L203 | 0.2477 | L403 | 0.0955
L094 | 12.0000 | L204 | 2.7520 | L404 | 1.2730
L095 | 2.1700 | L205 | 0.4129 | L405 | 0.1665
L101 | 1.0000 | L291 | 0.2471 | L501 | 0.1133
L102 | 6.0000 | L292 | 3.6340 | L502 | 0.7910
L103 | 0.6000 | L293 | 0.1305 | L503 | 0.0667
L104 | 6.0000 | L294 | 3.6340 | L504 | 0.7910
L105 | 1.0000 | L295 | 0.2471 | L505 | 0.1133
L191 | 0.7350 | L301 | 0.1693 | L601 | 0.0360
L192 | 4.5200 | L302 | 1.6930 | L602 | 0.6670
L193 | 0.3525 | L303 | 0.0977 | L603 | 0.0200
L194 | 4.5200 | L304 | 1.6930 | L604 | 0.6670
L195 | 0.7350 | L305 | 0.1693 | L605 | 0.0390
 | * C92,C96 = 3.2nf |  | * C294 = 1.9nf
 | (on AI6YM RF Board) |  | (on AI6YM RF Board)
 | (these are 3.1nf |  | (this is shown as 1.6nf
 | on K9HZ RF Board) |  | on K9HZ RF Board)

Sheet: Sheet3
Desig | Value | Turns | Core | # | Descr
L91 | 2 uH | 26 | T37-6 | 1 | 14" of #28 wire, 26T on T37-6
L92 | 11 uH | 15 | FT37-61 | 2 | 14"of #28 wire, 15T on FT37-61
L93 | 1 uh | 20 | T37-10 | 3 | 11" of #28 wire, 20T on T37-10
L94 | 11 uH | 15 | FT37-61 | 4 | 14"of #28 wire, 15T on FT37-61
L95 | 2 uH | 26 | T37-6 | 5 | 14" of #28 wire, 26T on T37-6
L101 | 810 nH | 20 | T37-10 | 6 | 11" of #28 wire, 20T on T37-10
L102 | 5.6 uH | 27 | T37-1 | 7 | 14" of #28 wire, 27T on T37-1
L103 | 440 nH | 32 | T37-0 | 8 | 18" of #28 wire, 32T on T37-0
L104 | 5.6 uH | 27 | T37-1 | 9 | 14" of #28 wire, 27T on T37-1
L105 | 810 nH | 20 | T37-10 | 10 | 11" of #28 wire, 20T on T37-10
L191 | 840 nH | 17 | T37-10 | 11 | 10" of #28 wire, 17T on T37-10
L192 | 5.2 uH | 26 | T37-1 | 12 | 13" of #28 wire, 26T on T37-1
L193 | 400 nH | 9 | T37-2 | 13 | 6" of #28 wire, 9T on T37-2
L194 | 5.2 uH | 26 | T37-1 | 14 | 13" of #28 wire, 26T on T37-1
L195 | 840 nH | 17 | T37-10 | 15 | 10" of #28 wire, 17T on T37-10
L201 | 560 nH | 32 | T37-0 | 16 | 18" of #28 wire, 32T on T37-0
L202 | 3.9 uH | 22 | T37-1 | 17 | 12" of #28 wire, 22T on T37-1
L203 | 330 nH | 23 | T37-0 | 18 | 14" of #28 wire, 23T on T37-0
L204 | 3.9 uH | 22 | T37-1 | 19 | 12" of #28 wire, 22T on T37-1
L205 | 560 nH | 32 | T37-0 | 20 | 18" of #28 wire, 32T on T37-0
L291 | 245 nH | 19 | T37-0 | 21 | 12" of #28 wire, 19T on T37-0
L292 | 3.6 uH | 38 | T37-10 | 22 | 20" of #28 wire, 38T on T37-10
L293 | 132 nH | 13 | T37-0 | 23 | 9" of #28 wire, 13T on T37-0
L294 | 3.6 uH | 38 | T37-10 | 24 | 20" of #28 wire, 38T on T37-10
L295 | 245 nH | 19 | T37-0 | 25 | 12" of #28 wire, 19T on T37-0
L301 | 220 nH | 17 | T37-0 | 26 | 11" of #28 wire, 17T on T37-0
L302 | 2.2 uH | 25 | T37-6 | 27 | 14" of #28 wire, 25T on T37-6
L303 | 120 nH | 12 | T37-0 | 28 | 9" of #28 wire, 12T on T37-0
L304 | 2.2 uH | 25 | T37-6 | 29 | 14" of #28 wire, 25T on T37-6
L305 | 220 nH | 17 | T37-0 | 30 | 11" of #28 wire, 17T on T37-0
L401 | 150 nH | 14 | T37-0 | 31 | 9" of #28 wire, 14T on T37-0
L402 | 1.2 uH | 21 | T37-10 | 32 | 12" of #28 wire, 21T on T37-10
L403 | 82 nH | 10 | T37-0 | 33 | 7" of #28 wire, 10T on T37-0
L404 | 1.2 uH | 21 | T37-10 | 34 | 12" of #28 wire, 21T on T37-10
L405 | 150 nH | 14 | T37-0 | 35 | 9" of #28 wire, 14T on T37-0
L501 | 120 nH | 12 | T37-0 | 36 | 9" of #28 wire, 12T on T37-0
L502 | 820 nH | 17 | T37-10 | 37 | 10" of #28 wire, 17T on T37-10
L503 | 82 nH | 10 | T37-0 | 38 | 7" of #28 wire, 10T on T37-0
L504 | 820 nH | 17 | T37-10 | 39 | 10" of #28 wire, 17T on T37-10
L505 | 120 nH | 12 | T37-0 | 40 | 9" of #28 wire, 12T on T37-0
L601 | 39 nH | 5 | 1/8" Drill | 41 | 5" of #28 wire, 5T on 1/8" Drill
L602 | 720 nH | 16 | T37-10 | 42 | 11" of #28 wire, 16T on T37-10
L603 | 24 nH | 7 | 1/8" Drill | 43 | 4" of #28 wire, 7T on 1/8" Drill
L604 | 720 nH | 16 | T37-10 | 44 | 11" of #28 wire, 16T on T37-10
L605 | 39 nH | 5 | 1/8" Drill | 45 | 5" of #28 wire, 5T on 1/8" Drill

Sheet: Sheet4
L091 | 1 | T37-7 | 1
L092 | 2 | FT37-67 | 1
L093 | 3 | T37-1 | 1
L094 | 4 | FT37-67 | 1
L095 | 5 | T37-7 | 1
L101 | 6 | T37-2 | 1
L102 | 7 | FT37-67 | 1
L103 | 8 | T37-6 | 1
L104 | 9 | FT37-67 | 1
L105 | 10 | T37-2 | 1
L191 | 11 | T37-7 | 1
L192 | 12 | FT37-67 | 1
L193 | 13 | T37-6 | 1
L194 | 14 | FT37-67 | 1
L195 | 15 | T37-7 | 1
L201 | 16 | T37-2 | 1
L202 | 17 | T37-2 | 1
L203 | 18 | T37-6 | 1
L204 | 19 | T37-2 | 1
L205 | 20 | T37-2 | 1
L291 | 21 | T37-6 | 1
L292 | 22 | T37-7 | 1
L293 | 23 | Air Core Coil
L294 | 24 | T37-7 | 1
L295 | 25 | T37-6 | 1
L301 | 26 | Air Core Coil
L302 | 27 | T37-7 | 1
L303 | 28 | Air Core Coil
L304 | 29 | T37-7 | 1
L305 | 30 | Air Core Coil
L401 | 31 | Air Core Coil
L402 | 32 | T37-7 | 1
L403 | 33 | Air Core Coil
L404 | 34 | T37-7 | 1
L405 | 35 | Air Core Coil
L501 | 36 | Air Core Coil
L502 | 37 | T37-17 | 1
L503 | 38 | Air Core Coil
L504 | 39 | T37-17 | 1
L505 | 40 | Air Core Coil
L601 | 41 | Air Core Coil
L602 | 42 | T37-17 | 1
L603 | 43 | Air Core Coil
L604 | 44 | T37-17 | 1
L605 | 45 | Air Core Coil
