DRWJSCHMIDT/T41/T41_3D_Printed_Stuff/KM5GT_V12_Modifications/Main_Fan_Bracket_KM5GT_V12.FCStd

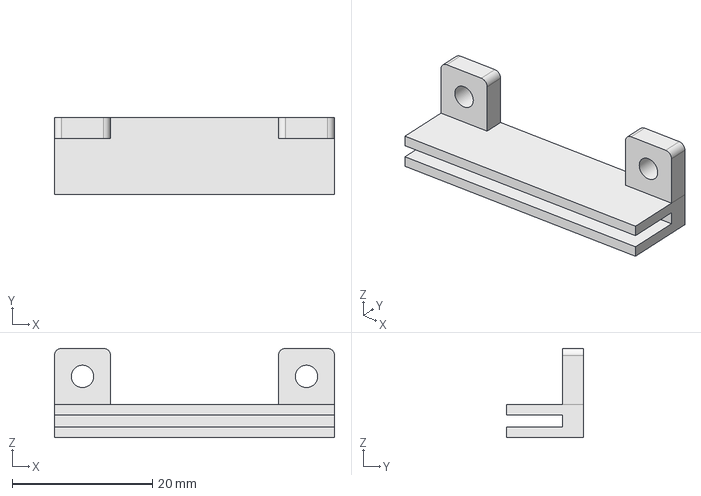
[picture p140: CAD file, 2024-07-15]
T41_3D_Printed_Stuff/KM5GT_V12_Modifications/Main_Fan_Bracket_KM5GT_V12.FCStd
40.0 x 11.0 x 12.8 mm
