DRWJSCHMIDT/T41/T41_3D_Printed_Stuff/V010_5_in_Case_Stl_Files/T41 Front left panel V010-Front Panel full.stl

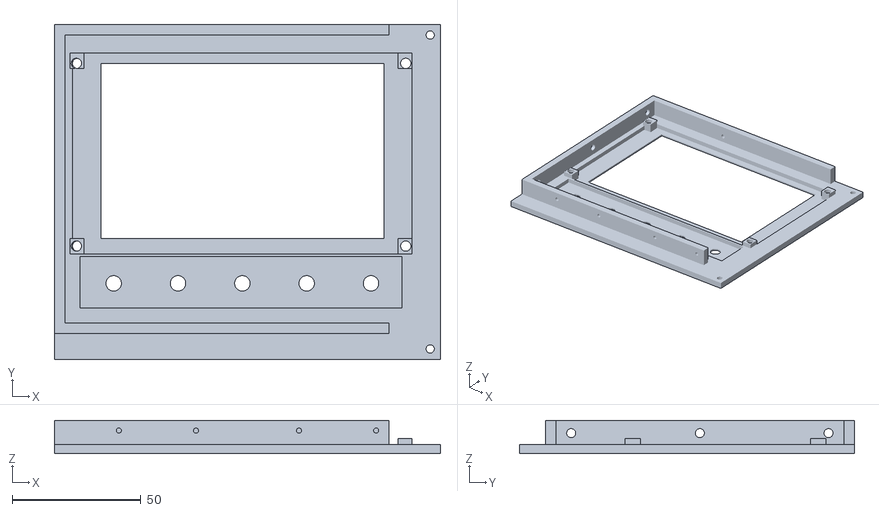
[picture p142: CAD file, 2024-02-22]
T41_3D_Printed_Stuff/V010_5_in_Case_Stl_Files/T41 Front left panel V010-Front Panel full.stl
150.0 x 130.0 x 13.0
