DRWJSCHMIDT/T41/T41_3D_Printed_Stuff/BOard Mounting Brackets/Board_Mounting_Bracket_PCB_V25.stl

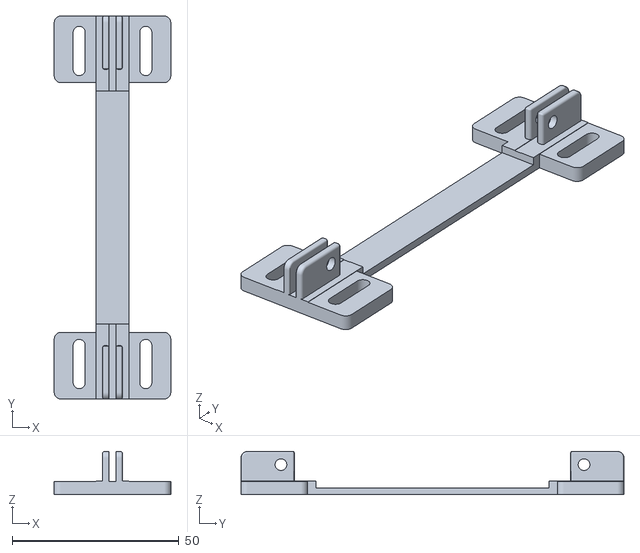
[picture p143: CAD file, 2026-09-15]
T41_3D_Printed_Stuff/BOard Mounting Brackets/Board_Mounting_Bracket_PCB_V25.stl
35.0 x 115.0 x 13.0
