DRWJSCHMIDT/T41/T41_3D_Printed_Stuff/KF5N_T41_V10_V11_Case/Side_Right_Panel_KF5N.FCStd

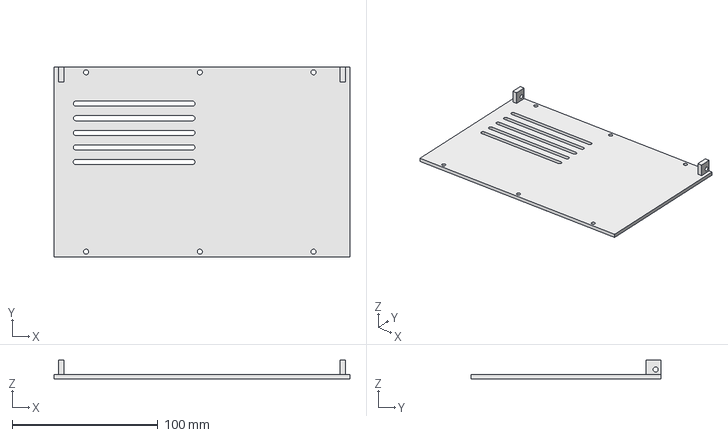
[picture p145: CAD file, 2024-07-15]
T41_3D_Printed_Stuff/KF5N_T41_V10_V11_Case/Side_Right_Panel_KF5N.FCStd
203.0 x 130.0 x 13.0 mm
