DRWJSCHMIDT/T41/T41_3D_Printed_Stuff/Knobs for dual encoders/knob_innter.stl

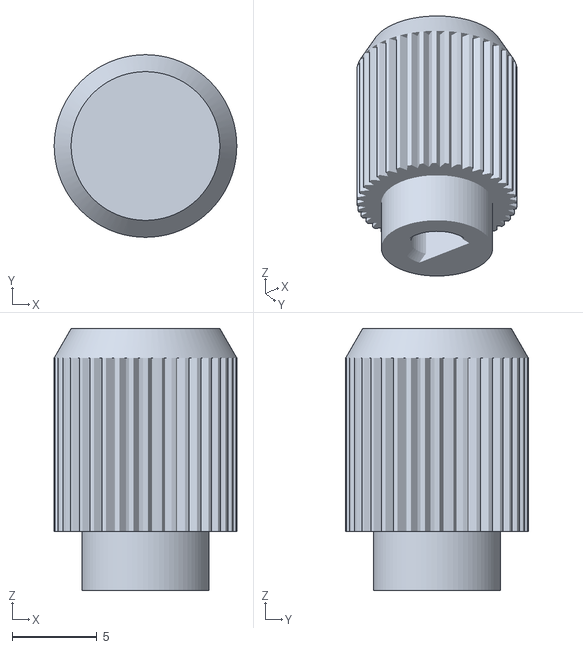
[picture p146: CAD file, 2025-02-06]
T41_3D_Printed_Stuff/Knobs for dual encoders/knob_innter.stl
10.8 x 10.8 x 15.5
