DRWJSCHMIDT/T41/T41_3D_Printed_Stuff/STL_Files_From_Larry_Acklin/ZulkitFrontRightPanel 2.stl

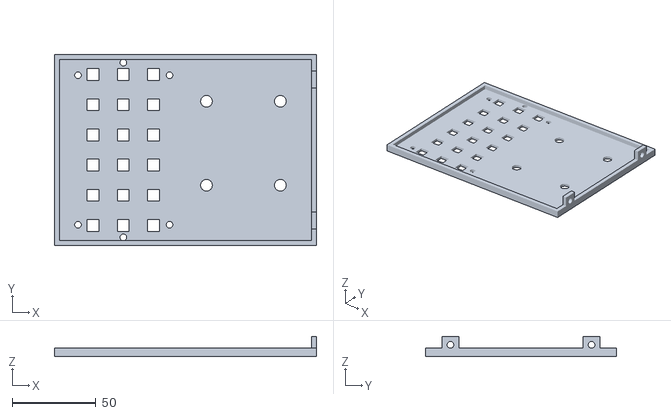
[picture p147: CAD file, 2026-08-09]
T41_3D_Printed_Stuff/STL_Files_From_Larry_Acklin/ZulkitFrontRightPanel 2.stl
156.0 x 114.0 x 12.0
