DRWJSCHMIDT/T41/T41_3D_Printed_Stuff/V010_5_in_Case_Stl_Files/T41 Back Right Panel V010.stl

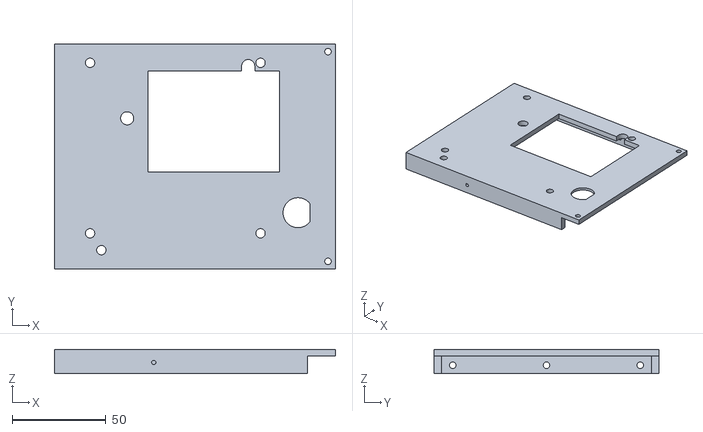
[picture p148: CAD file, 2024-02-22]
T41_3D_Printed_Stuff/V010_5_in_Case_Stl_Files/T41 Back Right Panel V010.stl
150.0 x 120.0 x 13.0
