DRWJSCHMIDT/T41/T41_3D_Printed_Stuff/V010_5_in_Display_ Case_FreeCad_Files/T41 Base Right  V010.FCStd

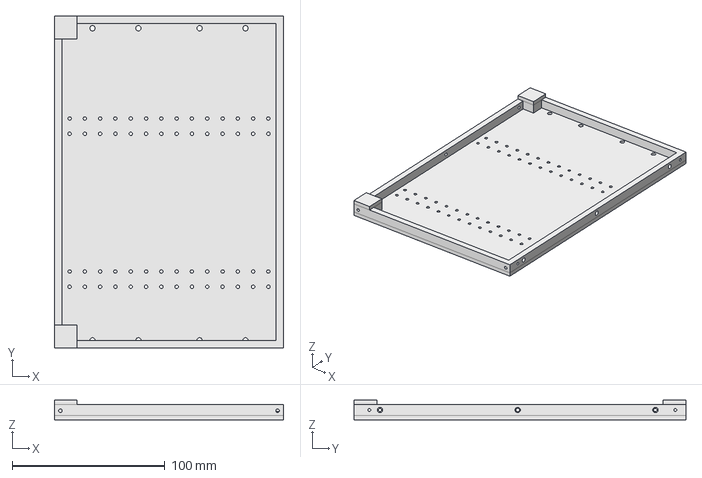
[picture p149: CAD file, 2024-02-22]
T41_3D_Printed_Stuff/V010_5_in_Display_ Case_FreeCad_Files/T41 Base Right V010.FCStd
150.0 x 217.0 x 13.0 mm
