DRWJSCHMIDT/T41/T41_3D_Printed_Stuff/V011_7_in_Display_Case_Files/Screen_Shield_box.3mf

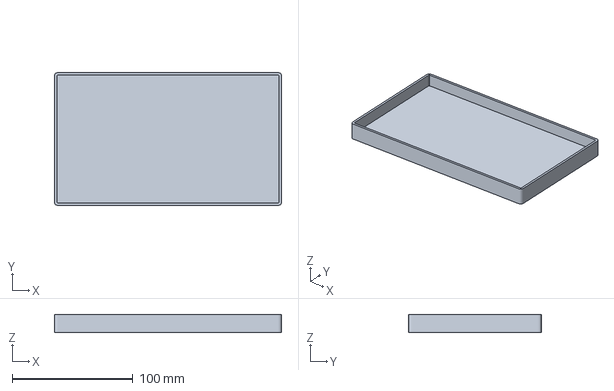
[picture p150: CAD file, 2026-08-09]
T41_3D_Printed_Stuff/V011_7_in_Display_Case_Files/Screen_Shield_box.3mf
188.0 x 110.0 x 15.0 mm
