DRWJSCHMIDT/T41/T41_3D_Printed_Stuff/V011_7_in_Display_Case_Stl_Files/T41 7in Top Left Panel Speaker Vents V011-Body.stl

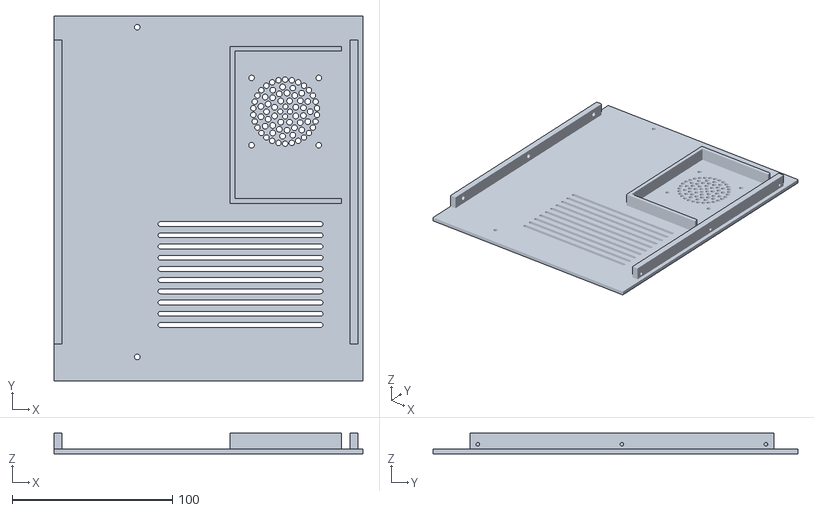
[picture p151: CAD file, 2024-02-22]
T41_3D_Printed_Stuff/V011_7_in_Display_Case_Stl_Files/T41 7in Top Left Panel Speaker Vents V011-Body.stl
193.0 x 228.0 x 13.0
