DRWJSCHMIDT/T41/T41_3D_Printed_Stuff/V012_Front_Panel_With_Callsign/T41 Front Panel With Call Sign.3mf

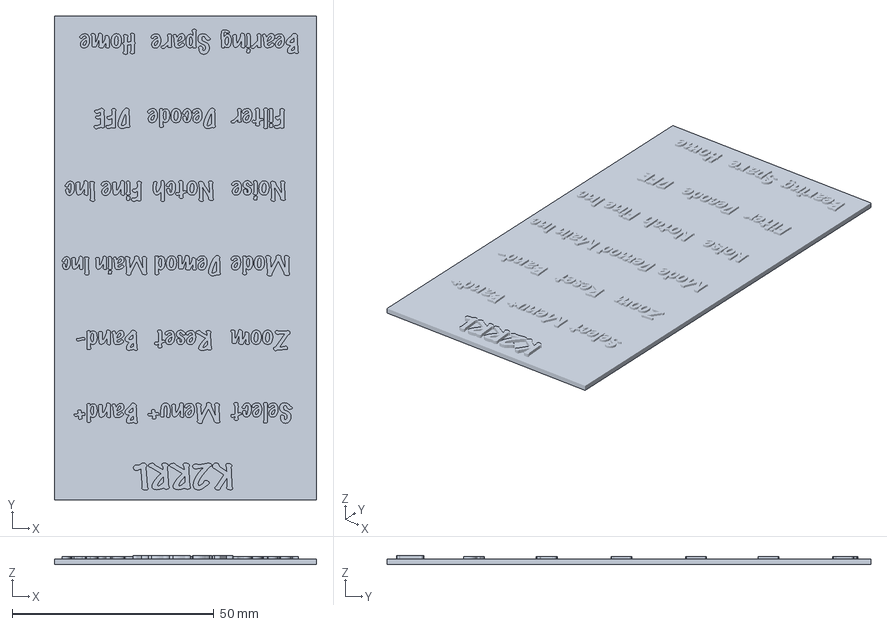
[picture p152: CAD file, 2026-07-25]
T41_3D_Printed_Stuff/V012_Front_Panel_With_Callsign/T41 Front Panel With Call Sign.3mf
65.0 x 120.0 x 2.24 mm
