DRWJSCHMIDT/T41/T41_3D_Printed_Stuff/Vxxx_Fan_Brackets/fanBracket-Fillet001_24mm.stl

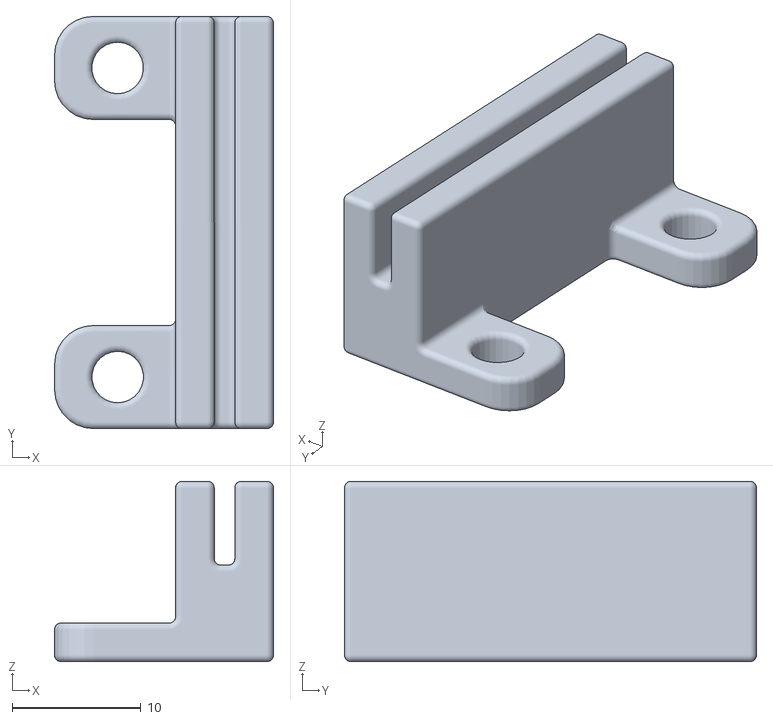
[picture p153: CAD file, 2024-02-26]
T41_3D_Printed_Stuff/Vxxx_Fan_Brackets/fanBracket-Fillet001_24mm.stl
17.0 x 32.0 x 14.0
