DRWJSCHMIDT/T41/T41_Displays_For_T41_Radios/T41_KiCad_Library/3D_models/031-203-RFX.stp

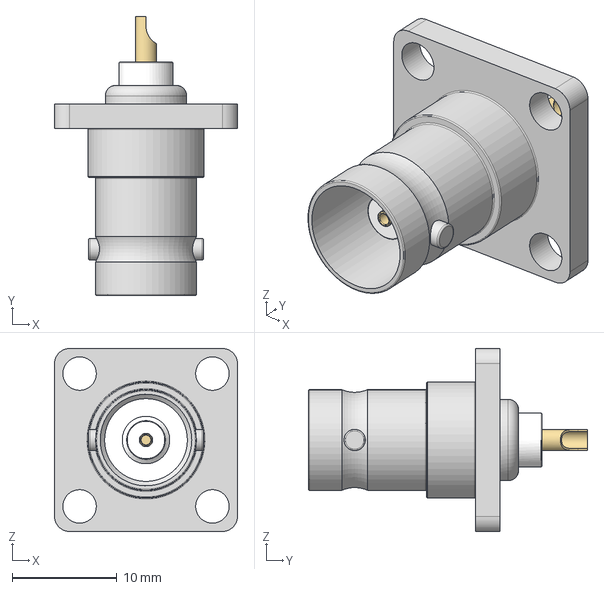
[picture p154: CAD file, 2025-12-29]
T41_Displays_For_T41_Radios/T41_KiCad_Library/3D_models/031-203-RFX.stp
17.5 x 26.7 x 17.5 mm
