DRWJSCHMIDT/T41/T41_KiCad_Library/3D_models/SI5341A-D-GM.step

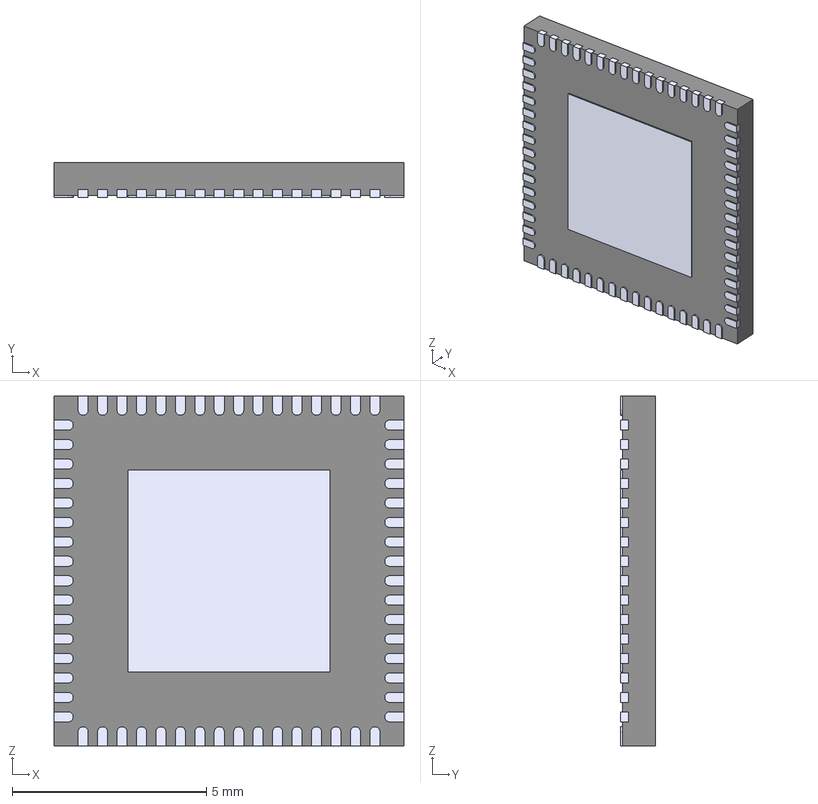
[picture p155: CAD file, 2026-01-07]
T41_KiCad_Library/3D_models/SI5341A-D-GM.step
9.00 x 0.9 x 9.00 mm
Body_Solid1
Body001_Solid1
Array_Solid1 x 16
Array001_Solid2 x 15
Body002_Solid1
Array002_Solid1 x 16
Array003_Solid2 x 15
Body003_Solid1
Body004_Solid1
