DRWJSCHMIDT/T41/T41_3D_Printed_Stuff/BPF Core Holders/toroid_holder_bottom_tray.stl

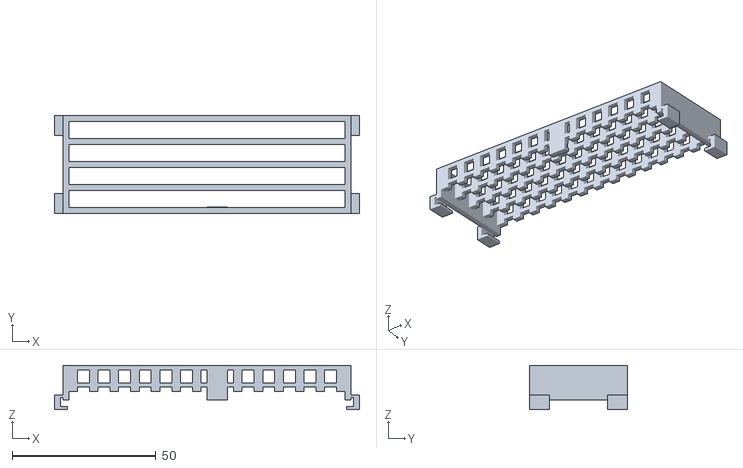
[picture p156: CAD file, 2026-09-12]
T41_3D_Printed_Stuff/BPF Core Holders/toroid_holder_bottom_tray.stl
106.0 x 34.0 x 15.3
