DRWJSCHMIDT/T41/T41_3D_Printed_Stuff/KM5GT_V12_Modifications/Base_Right_KF5N.FCStd

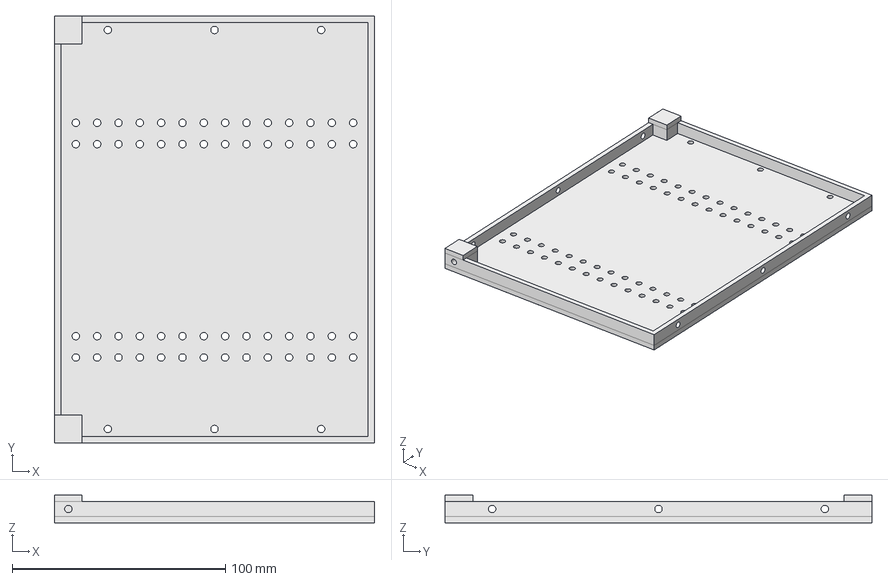
[picture p158: CAD file, 2024-07-15]
T41_3D_Printed_Stuff/KM5GT_V12_Modifications/Base_Right_KF5N.FCStd
150.0 x 200.0 x 13.0 mm
