DRWJSCHMIDT/T41/T41_3D_Printed_Stuff/Knobs for dual encoders/ALPS_Concentric_Knobs_3.3mf

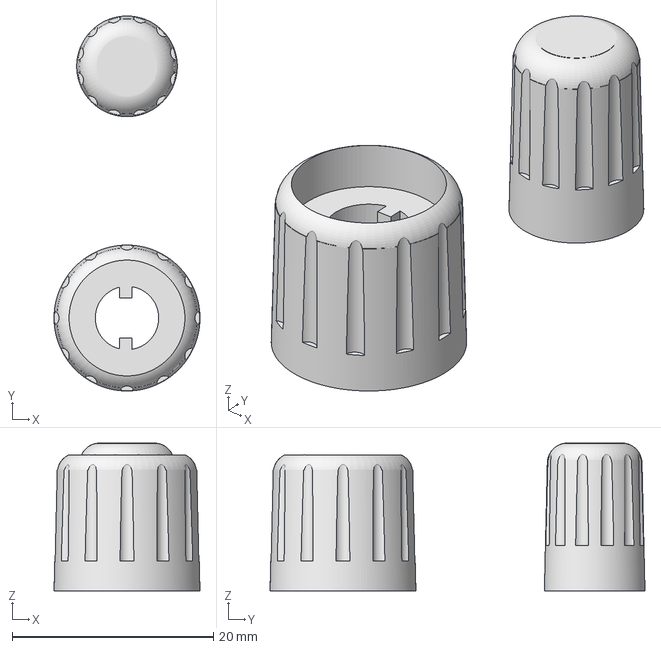
[picture p159: CAD file, 2025-02-06]
T41_3D_Printed_Stuff/Knobs for dual encoders/ALPS_Concentric_Knobs_3.3mf
14.5 x 37.2 x 14.7 mm
