DRWJSCHMIDT/T41/T41_3D_Printed_Stuff/STL_Files_From_Larry_Acklin/ZulkitFrontLeftPanel.stl

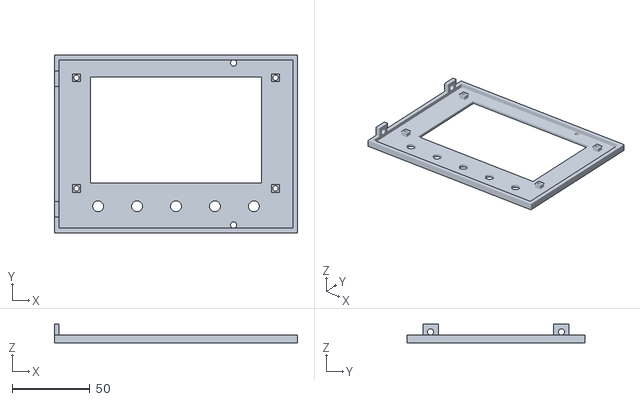
[picture p160: CAD file, 2026-08-09]
T41_3D_Printed_Stuff/STL_Files_From_Larry_Acklin/ZulkitFrontLeftPanel.stl
156.0 x 114.0 x 12.0
