DRWJSCHMIDT/T41/T41_3D_Printed_Stuff/V010_5_in_Case_Stl_Files/T41 Foot V010-Body.stl

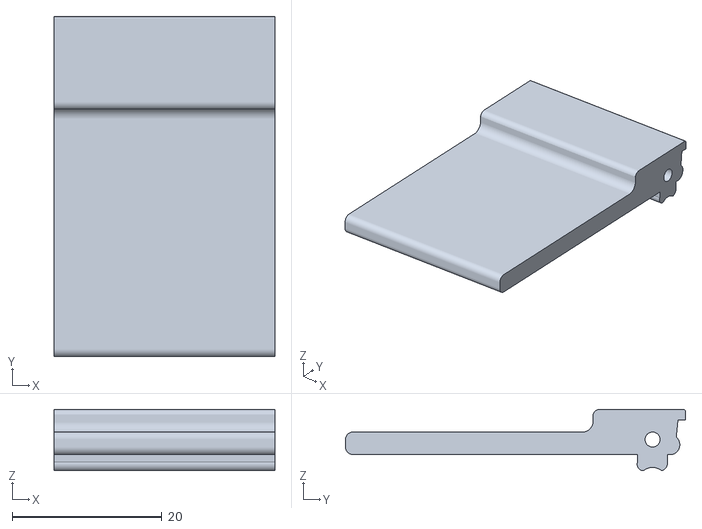
[picture p161: CAD file, 2024-02-22]
T41_3D_Printed_Stuff/V010_5_in_Case_Stl_Files/T41 Foot V010-Body.stl
29.5 x 45.4 x 8.21
