DRWJSCHMIDT/T41/T41_3D_Printed_Stuff/V010_5_in_Display_ Case_FreeCad_Files/T41 Top Right Panel Vents V010.FCStd

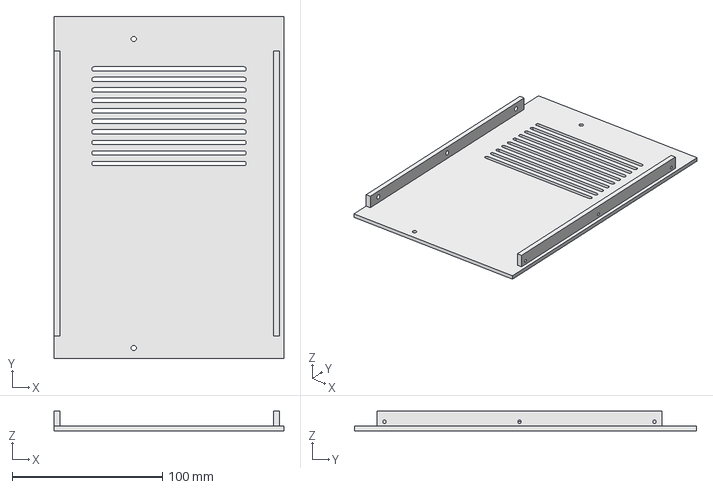
[picture p162: CAD file, 2024-02-22]
T41_3D_Printed_Stuff/V010_5_in_Display_ Case_FreeCad_Files/T41 Top Right Panel Vents V010.FCStd
153.0 x 228.0 x 13.0 mm
