DRWJSCHMIDT/T41/T41_3D_Printed_Stuff/V011_7_in_Display_Case_Files/T41 7IN Back Right Panel V011.FCStd

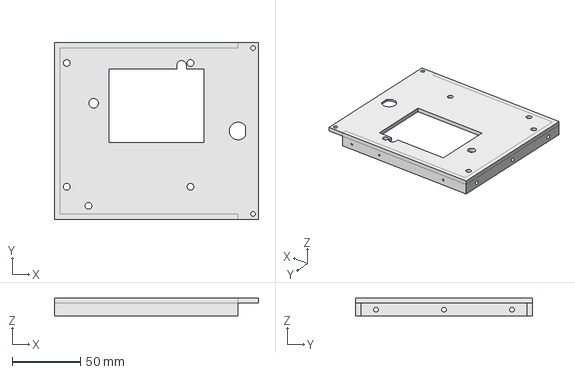
[picture p163: CAD file, 2024-02-22]
T41_3D_Printed_Stuff/V011_7_in_Display_Case_Files/T41 7IN Back Right Panel V011.FCStd
150.0 x 130.0 x 13.0 mm
