DRWJSCHMIDT/T41/T41_Displays_For_T41_Radios/T41_KiCad_Library/3D_models/HFD4_relay.step

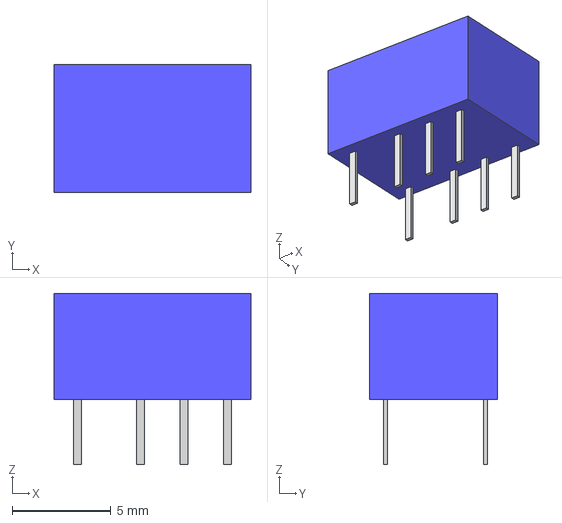
[picture p165: CAD file, 2024-07-24]
T41_Displays_For_T41_Radios/T41_KiCad_Library/3D_models/HFD4_relay.step
10.0 x 6.50 x 8.70 mm
