DRWJSCHMIDT/T41/T41_KiCad_Library/3D_models/RD100HHF1C.3mf

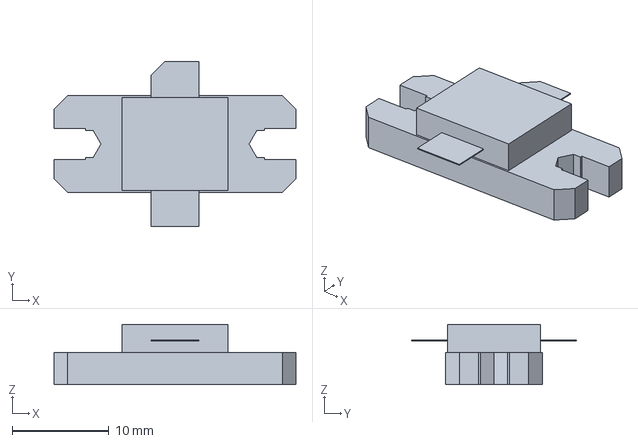
[picture p166: CAD file, 2026-01-03]
T41_KiCad_Library/3D_models/RD100HHF1C.3mf
25.0 x 17.0 x 6.20 mm
