DRWJSCHMIDT/T41/T41_3D_Printed_Stuff/KM5GT_V12_Modifications/KM5GT_Board_Mounting_Bracket_V12.FCStd

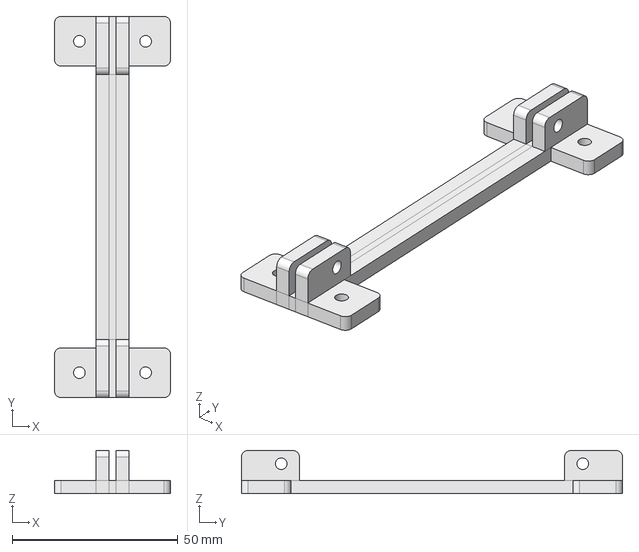
[picture p168: CAD file, 2024-07-15]
T41_3D_Printed_Stuff/KM5GT_V12_Modifications/KM5GT_Board_Mounting_Bracket_V12.FCStd
35.0 x 115.0 x 13.0 mm
