DRWJSCHMIDT/T41/T41_3D_Printed_Stuff/Knobs for dual encoders/knob_inner_crs.stl

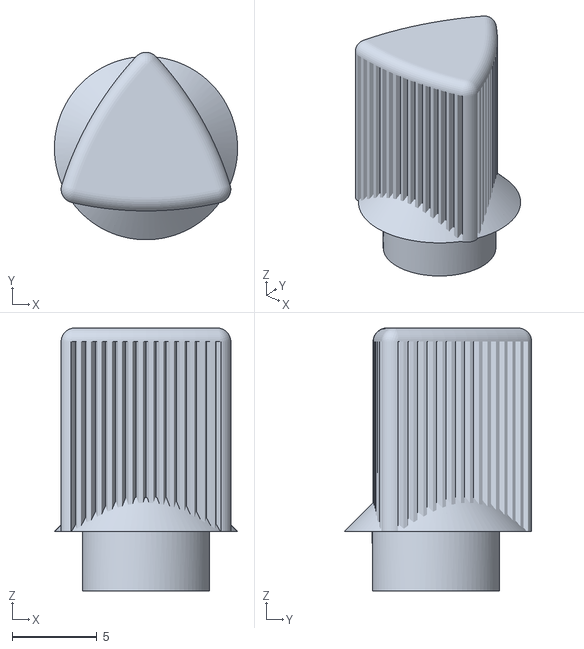
[picture p169: CAD file, 2025-02-06]
T41_3D_Printed_Stuff/Knobs for dual encoders/knob_inner_crs.stl
10.8 x 11.0 x 15.5
