DRWJSCHMIDT/T41/T41_3D_Printed_Stuff/V010_5_in_Display_ Case_FreeCad_Files/PS PCB Mounting Bracket.FCStd

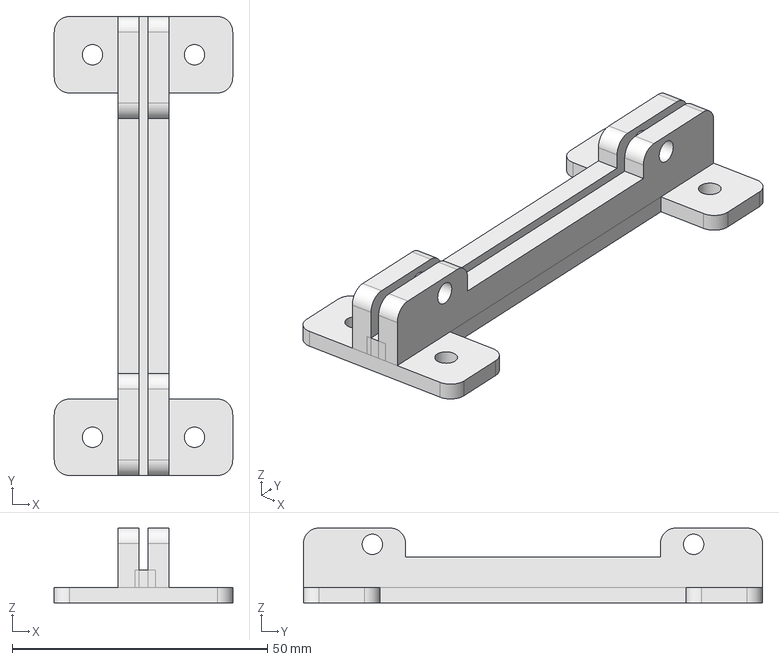
[picture p170: CAD file, 2024-02-22]
T41_3D_Printed_Stuff/V010_5_in_Display_ Case_FreeCad_Files/PS PCB Mounting Bracket.FCStd
35.0 x 90.0 x 14.7 mm
