DRWJSCHMIDT/T41/T41_Displays_For_T41_Radios/T41_KiCad_Library/3D_models/EA-T220-38E.stp

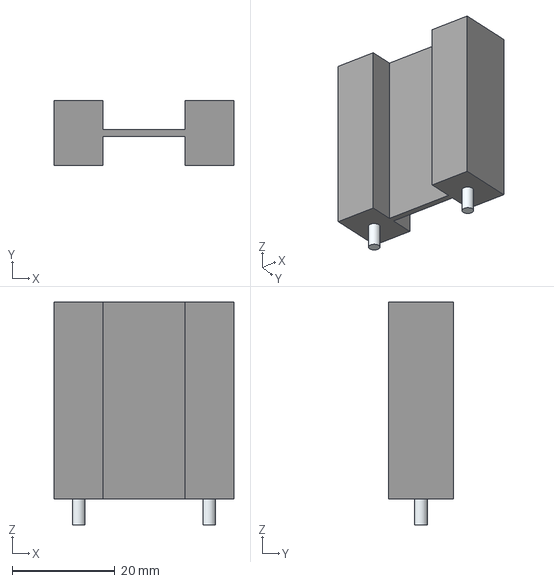
[picture p171: CAD file, 2024-02-26]
T41_Displays_For_T41_Radios/T41_KiCad_Library/3D_models/EA-T220-38E.stp
35.0 x 12.7 x 43.5 mm
Leads x 2
