DRWJSCHMIDT/T41/T41_3D_Printed_Stuff/KF5N_T41_V10_V11_Case/PS_PCB_Mounting_Bracket_KF5N.FCStd

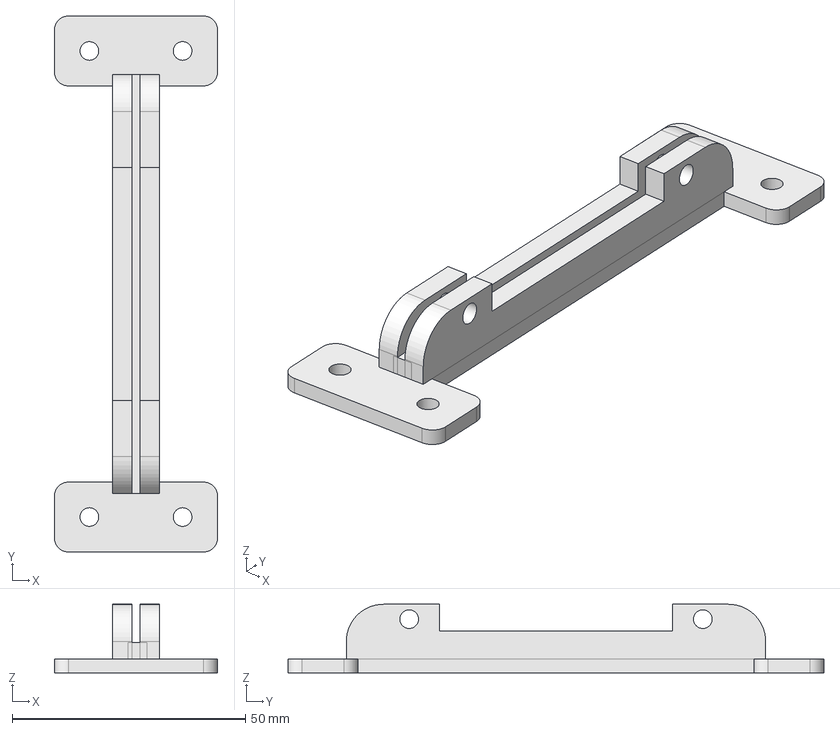
[picture p172: CAD file, 2024-07-15]
T41_3D_Printed_Stuff/KF5N_T41_V10_V11_Case/PS_PCB_Mounting_Bracket_KF5N.FCStd
35.0 x 115.0 x 14.7 mm
