DRWJSCHMIDT/T41/T41_3D_Printed_Stuff/KM5GT_V12_Modifications/Front_left_panel_KF5N_KM5GT_V12.FCStd

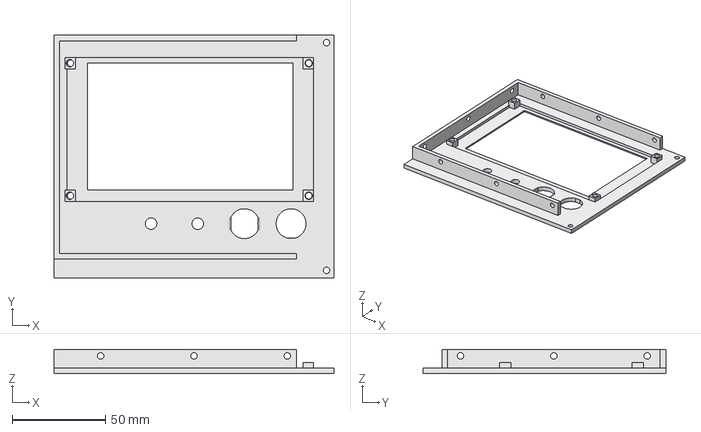
[picture p173: CAD file, 2024-07-15]
T41_3D_Printed_Stuff/KM5GT_V12_Modifications/Front_left_panel_KF5N_KM5GT_V12.FCStd
150.0 x 130.0 x 13.0 mm
