DRWJSCHMIDT/T41/T41_3D_Printed_Stuff/Knobs for dual encoders/knob_outer.stl

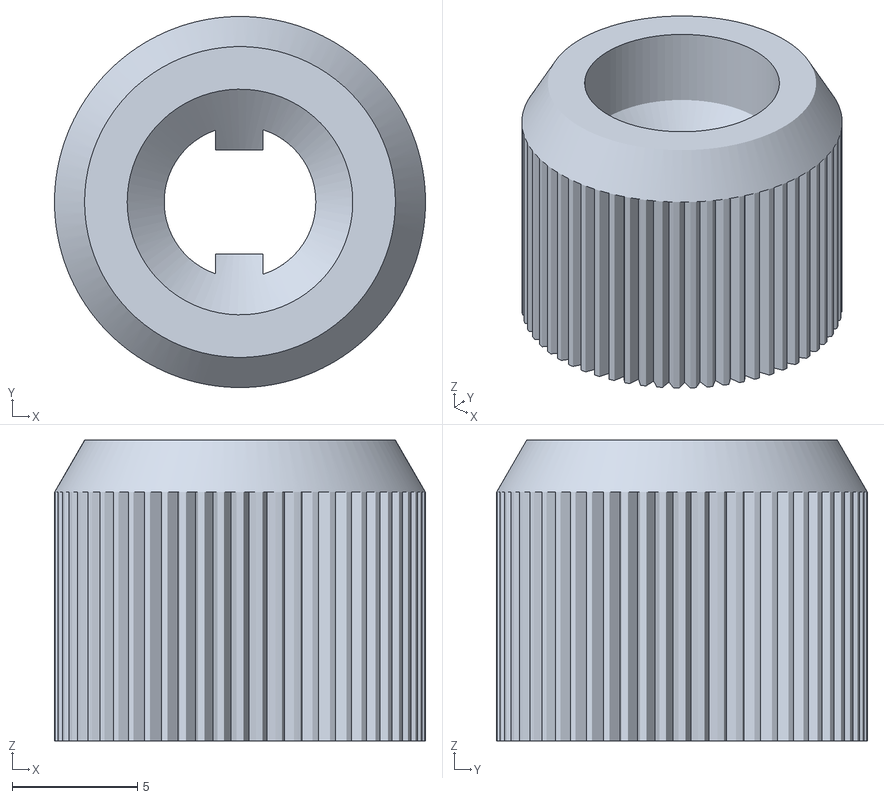
[picture p174: CAD file, 2025-02-06]
T41_3D_Printed_Stuff/Knobs for dual encoders/knob_outer.stl
14.8 x 14.8 x 12.0
