DRWJSCHMIDT/T41/T41_3D_Printed_Stuff/V010_5_in_Display_ Case_FreeCad_Files/Speaker Box V10.FCStd

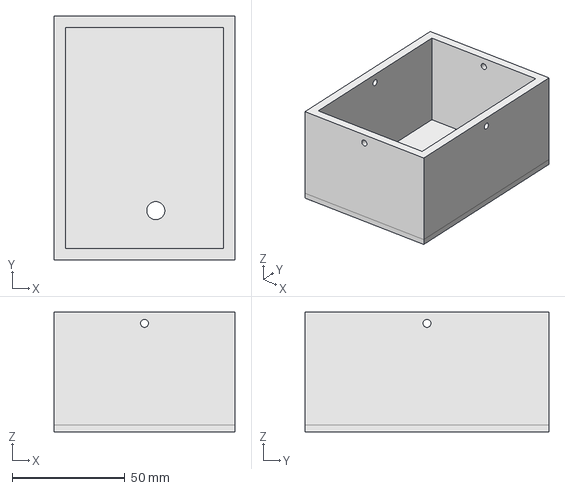
[picture p176: CAD file, 2024-02-22]
T41_3D_Printed_Stuff/V010_5_in_Display_ Case_FreeCad_Files/Speaker Box V10.FCStd
80.0 x 108.0 x 53.0 mm
