DRWJSCHMIDT/T41/T41_Displays_For_T41_Radios/T41_KiCad_Library/3D_models/FT37-toroid.step

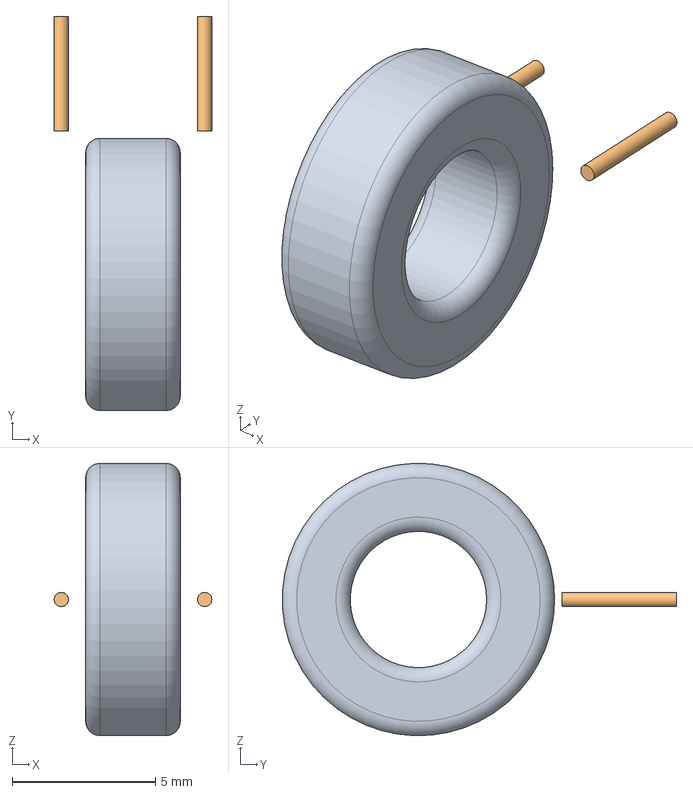
[picture p178: CAD file, 2024-01-27]
T41_Displays_For_T41_Radios/T41_KiCad_Library/3D_models/FT37-toroid.step
5.50 x 13.7 x 9.50 mm
