DRWJSCHMIDT/T41/T41_3D_Printed_Stuff/KF5N_T41_V10_V11_Case/Speaker_Front_KF5N.FCStd

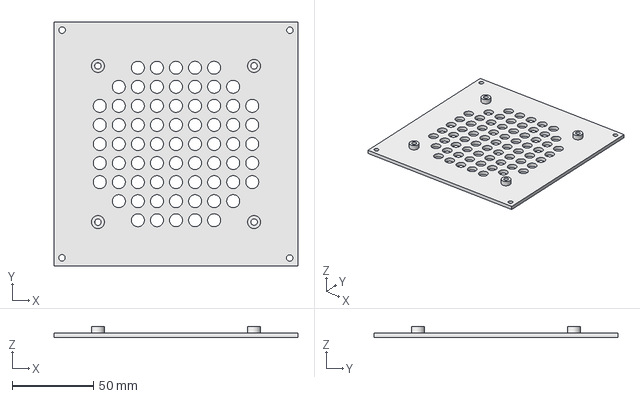
[picture p179: CAD file, 2024-07-15]
T41_3D_Printed_Stuff/KF5N_T41_V10_V11_Case/Speaker_Front_KF5N.FCStd
150.0 x 150.0 x 7.00 mm
