DRWJSCHMIDT/T41/T41_3D_Printed_Stuff/KM5GT_V12_Modifications/Switch_Matrix_Spacer_KM5GT_V12.FCStd

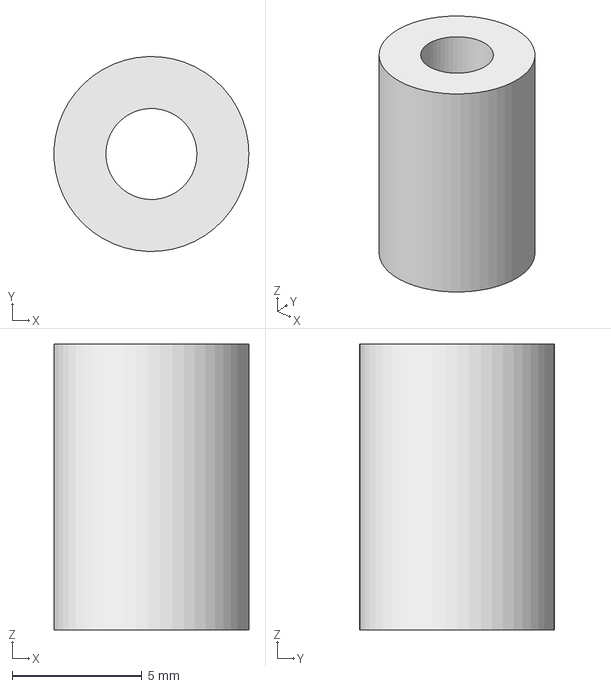
[picture p180: CAD file, 2024-07-15]
T41_3D_Printed_Stuff/KM5GT_V12_Modifications/Switch_Matrix_Spacer_KM5GT_V12.FCStd
7.49 x 7.50 x 11.0 mm
