DRWJSCHMIDT/T41/T41_Displays_For_T41_Radios/T41_KiCad_Library/3D_models/HF41F-12-ZS.step

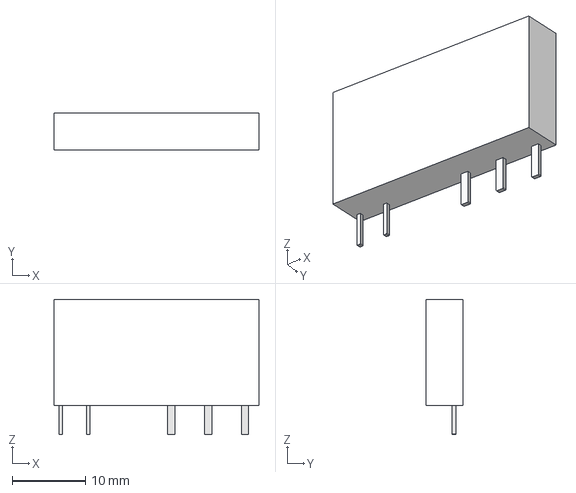
[picture p182: CAD file, 2024-01-24]
T41_Displays_For_T41_Radios/T41_KiCad_Library/3D_models/HF41F-12-ZS.step
28.0 x 5.00 x 18.5 mm
