DRWJSCHMIDT/T41/T41_3D_Printed_Stuff/V010_5_in_Display_ Case_FreeCad_Files/Mounting Bracket V010.FCStd

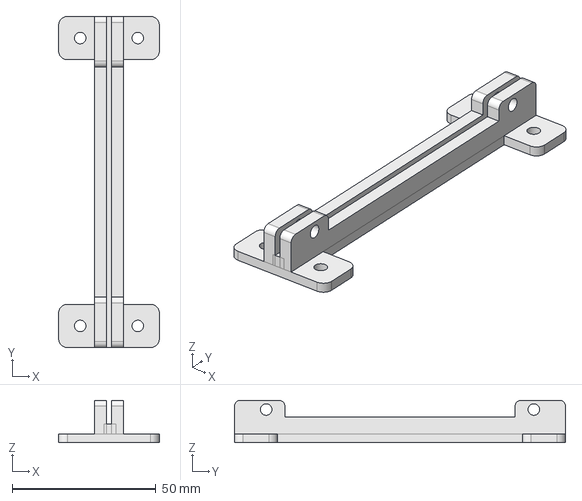
[picture p183: CAD file, 2024-02-22]
T41_3D_Printed_Stuff/V010_5_in_Display_ Case_FreeCad_Files/Mounting Bracket V010.FCStd
35.0 x 115.0 x 14.7 mm
