DRWJSCHMIDT/T41/T41_3D_Printed_Stuff/V011_7_in_Display_Case_Stl_Files/T41 7IN Front Right Panel V011-Front PanelRl.stl

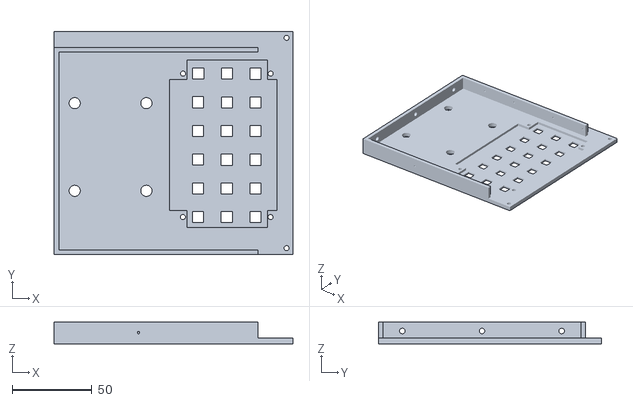
[picture p184: CAD file, 2024-02-22]
T41_3D_Printed_Stuff/V011_7_in_Display_Case_Stl_Files/T41 7IN Front Right Panel V011-Front PanelRl.stl
150.0 x 140.0 x 13.5
