DRWJSCHMIDT/T41/T41_Displays_For_T41_Radios/T41_KiCad_Library/3D_models/T68-6-toroid.step

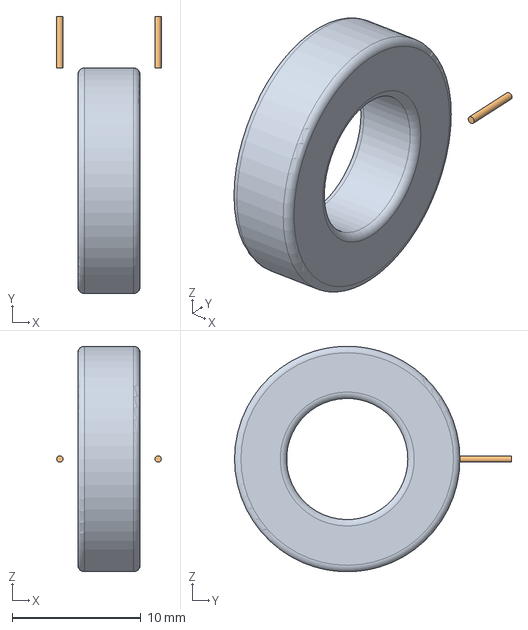
[picture p185: CAD file, 2024-01-24]
T41_Displays_For_T41_Radios/T41_KiCad_Library/3D_models/T68-6-toroid.step
8.12 x 21.5 x 17.5 mm
