DRWJSCHMIDT/T41/T41_3D_Printed_Stuff/KM5GT_V12_Modifications/Front_Right_Panel_KF5N_KM5GT_v12.FCStd

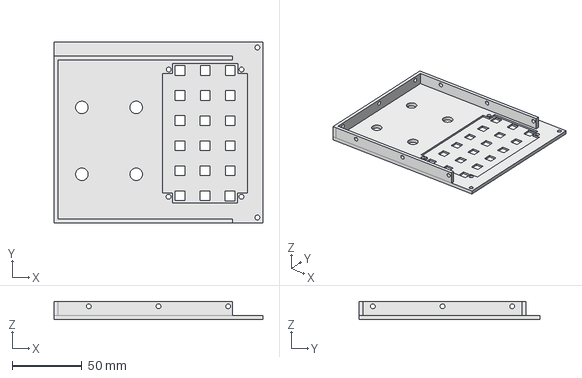
[picture p186: CAD file, 2024-07-15]
T41_3D_Printed_Stuff/KM5GT_V12_Modifications/Front_Right_Panel_KF5N_KM5GT_v12.FCStd
150.0 x 130.0 x 13.0 mm
