DRWJSCHMIDT/T41/T41_3D_Printed_Stuff/V010_5_in_Display_ Case_FreeCad_Files/T41 Front Right Panel V010.FCStd

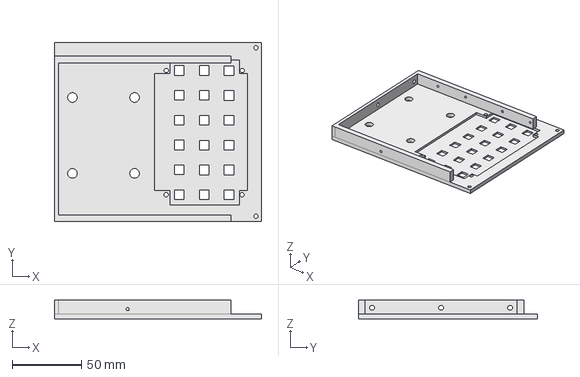
[picture p187: CAD file, 2024-02-22]
T41_3D_Printed_Stuff/V010_5_in_Display_ Case_FreeCad_Files/T41 Front Right Panel V010.FCStd
150.0 x 130.0 x 13.5 mm
