DRWJSCHMIDT/T41/T41_3D_Printed_Stuff/KF5N_T41_V10_V11_Case/Top_Cover_Half_KF5N.FCStd

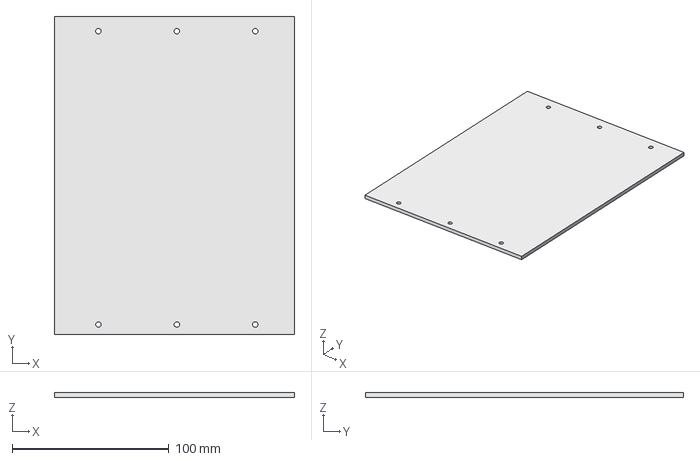
[picture p189: CAD file, 2024-07-15]
T41_3D_Printed_Stuff/KF5N_T41_V10_V11_Case/Top_Cover_Half_KF5N.FCStd
153.0 x 203.0 x 3.00 mm
