DRWJSCHMIDT/T41/T41_3D_Printed_Stuff/V010_5_in_Case_Stl_Files/T41 Side Left Panel V010-Body.stl

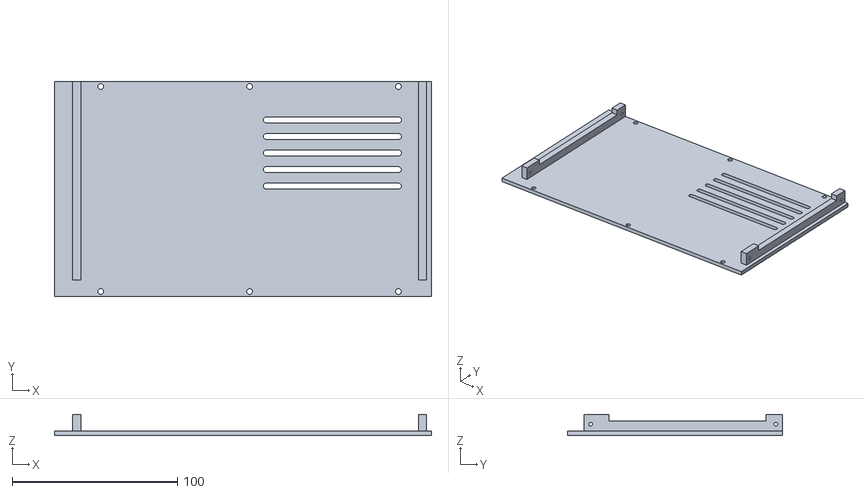
[picture p190: CAD file, 2024-02-22]
T41_3D_Printed_Stuff/V010_5_in_Case_Stl_Files/T41 Side Left Panel V010-Body.stl
228.0 x 130.0 x 13.0
