DRWJSCHMIDT/T41/T41_3D_Printed_Stuff/V010_5_in_Case_Stl_Files/T41 stand V010-Body.stl

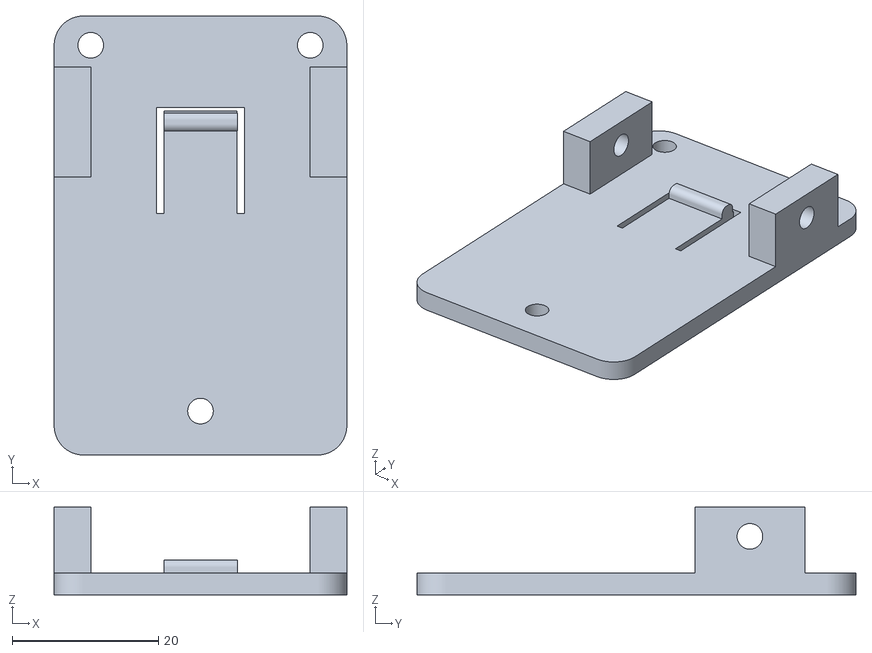
[picture p193: CAD file, 2024-02-22]
T41_3D_Printed_Stuff/V010_5_in_Case_Stl_Files/T41 stand V010-Body.stl
40.0 x 60.0 x 12.0
