DRWJSCHMIDT/T41/T41_3D_Printed_Stuff/KF5N_T41_V10_V11_Case/Back_Left_Panel_KF5N.FCStd

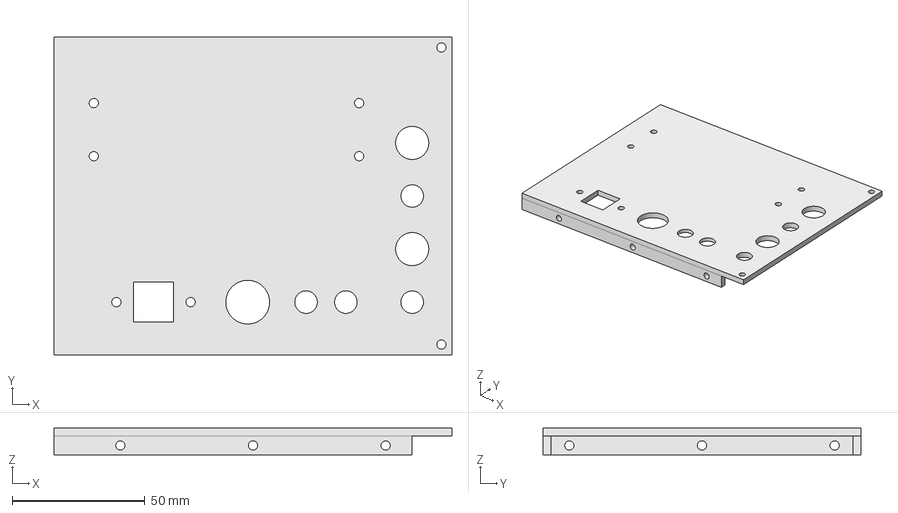
[picture p194: CAD file, 2024-07-15]
T41_3D_Printed_Stuff/KF5N_T41_V10_V11_Case/Back_Left_Panel_KF5N.FCStd
150.0 x 120.0 x 10.0 mm
