DRWJSCHMIDT/T41/T41_3D_Printed_Stuff/V011_7_in_Display_Case_Stl_Files/T41 7inBack left panel V011-Back Panel  L.stl

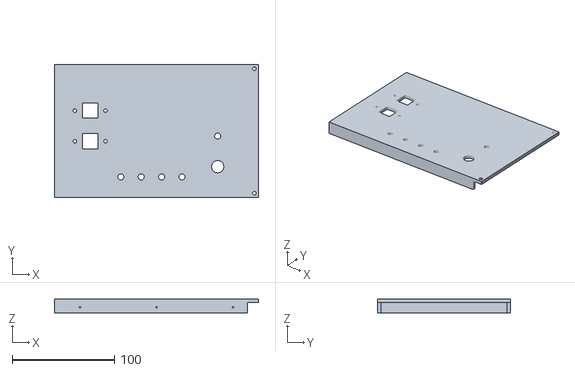
[picture p195: CAD file, 2024-02-22]
T41_3D_Printed_Stuff/V011_7_in_Display_Case_Stl_Files/T41 7inBack left panel V011-Back Panel L.stl
200.0 x 130.0 x 13.5
