DRWJSCHMIDT/T41/T41_3D_Printed_Stuff/KF5N_T41_V10_V11_Case/Microphone Test Cutout.FCStd

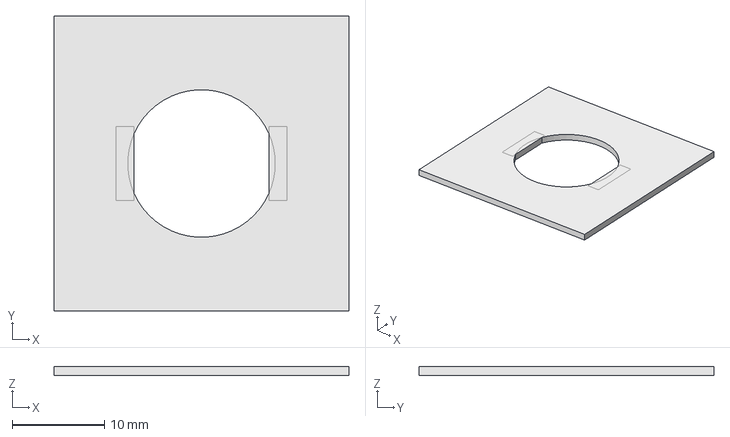
[picture p196: CAD file, 2024-07-15]
T41_3D_Printed_Stuff/KF5N_T41_V10_V11_Case/Microphone Test Cutout.FCStd
32.0 x 32.0 x 1.00 mm
