DRWJSCHMIDT/T41/(list of files, cad)

Other CAD files:
T41_3D_Printed_Stuff/V010_5_in_Case_Stl_Files/T41 Base Left V010-Body.stl
T41_3D_Printed_Stuff/V011_7_in_Display_Case_Files/T41 7in Top Left Panel Speaker Vents V011.FCStd
T41_3D_Printed_Stuff/V011_7_in_Display_Case_Stl_Files/T41 7IN Back Right Panel V011-Back Panel r.stl
T41_3D_Printed_Stuff/V011_7_in_Display_Case_Files/T41 Top Right Panel Vents V011.FCStd
T41_3D_Printed_Stuff/V010_5_in_Case_Stl_Files/Speaker Box V10-Body.stl
T41_3D_Printed_Stuff/V011_7_in_Display_Case_Files/T41 7in Base Left V011.FCStd
T41_3D_Printed_Stuff/KF5N_T41_V10_V11_Case/Side_Left_Panel_KF5N.FCStd
T41_3D_Printed_Stuff/KM5GT_V12_Modifications/Base_Left_KF5N.FCStd
T41_3D_Printed_Stuff/V010_5_in_Case_Stl_Files/PS PCB Mounting Bracket-Body V010.stl
T41_3D_Printed_Stuff/KF5N_T41_V10_V11_Case/Base_Left_KF5N.FCStd
T41_3D_Printed_Stuff/V010_5_in_Case_Stl_Files/Mounting Bracket V010-Body.stl
T41_3D_Printed_Stuff/V011_7_in_Display_Case_Files/T41 7in Front left panelV011.FCStd
T41_3D_Printed_Stuff/V010_5_in_Display_ Case_FreeCad_Files/T41 Base Left V010.FCStd
T41_3D_Printed_Stuff/V011_7_in_Display_Case_Files/T41 Base Right V011.FCStd
T41_3D_Printed_Stuff/KF5N_T41_V10_V11_Case/Front_left_panel_KF5N v01.FCStd
T41_3D_Printed_Stuff/V010_5_in_Case_Stl_Files/T41 Top Left Panel Speaker Vents V010-Body.stl
T41_3D_Printed_Stuff/V010_5_in_Display_ Case_FreeCad_Files/T41 Side Left Panel V010.FCStd
T41_3D_Printed_Stuff/V011_7_in_Display_Case_Files/T41 7in Side Left PanelV011.FCStd
T41_3D_Printed_Stuff/KF5N_T41_V10_V11_Case/Front_left_panel_KF5N.FCStd
T41_3D_Printed_Stuff/V010_5_in_Case_Stl_Files/T41 Base Right V010-Body.stl
T41_3D_Printed_Stuff/V010_5_in_Display_ Case_FreeCad_Files/T41 Back Left Panel V010.FCStd
T41_3D_Printed_Stuff/V011_7_in_Display_Case_Files/T41 Side Right Panel V011.FCStd
T41_3D_Printed_Stuff/V011_7_in_Display_Case_Stl_Files/T41 Top Right Panel Vents V011-Body.stl
T41_3D_Printed_Stuff/V010_5_in_Display_ Case_FreeCad_Files/T41 Side Right Panel V010.FCStd
T41_3D_Printed_Stuff/V011_7_in_Display_Case_Files/Speaker Box V011.FCStd
T41_3D_Printed_Stuff/V011_7_in_Display_Case_Stl_Files/T41 Base Right V011-Body.stl
T41_3D_Printed_Stuff/V010_5_in_Case_Stl_Files/T41 Top Right Panel Vents V010-Body.stl
T41_3D_Printed_Stuff/V011_7_in_Display_Case_Files/T41 7in Side Right Panel V011.FCStd
T41_3D_Printed_Stuff/V010_5_in_Display_ Case_FreeCad_Files/T41 stand V010.FCStd
T41_3D_Printed_Stuff/V011_7_in_Display_Case_Files/T41 7inBack left panel V011.FCStd
T41_3D_Printed_Stuff/V011_7_in_Display_Case_Stl_Files/Speaker Box V011-Body.stl
T41_3D_Printed_Stuff/V010_5_in_Display_ Case_FreeCad_Files/T41 Front left panel V010.FCStd
T41_3D_Printed_Stuff/V011_7_in_Display_Case_Files/T41 7IN Front Right Panel V011.FCStd
T41_3D_Printed_Stuff/KF5N_T41_V10_V11_Case/Front_Right_Panel_KF5N.FCStd
T41_3D_Printed_Stuff/V010_5_in_Case_Stl_Files/T41 Front Right Panel V010-Front PanelRl.stl
T41_3D_Printed_Stuff/V010_5_in_Display_ Case_FreeCad_Files/T41 Foot V010.FCStd
T41_3D_Printed_Stuff/KF5N_T41_V10_V11_Case/Boost_2_Mounting_Bracket_KF5N.FCStd
T41_3D_Printed_Stuff/V010_5_in_Display_ Case_FreeCad_Files/T41 Back Right Panel V010.FCStd
T41_3D_Printed_Stuff/KM5GT_V12_Modifications/Base_Left_KF5N.stl
T41_3D_Printed_Stuff/KM5GT_V12_Modifications/Base_Right_KF5N.stl
T41_3D_Printed_Stuff/KM5GT_V12_Modifications/Front_Right_Panel_KF5N_KM5GT_v12.stl
T41_3D_Printed_Stuff/KM5GT_V12_Modifications/Front_left_panel_KF5N_KM5GT_V12.stl
T41_3D_Printed_Stuff/KM5GT_V12_Modifications/KM5GT_Board_Mounting_Bracket_V12.stl
T41_3D_Printed_Stuff/KM5GT_V12_Modifications/Main_Fan_Bracket_KM5GT_V12.stl
T41_3D_Printed_Stuff/KM5GT_V12_Modifications/Switch_Matrix_Spacer_KM5GT_V12.stl
T41_3D_Printed_Stuff/V010_5_in_Display_ Case_FreeCad_Files/BNC washer.FCStd
T41_3D_Printed_Stuff/V011_7_in_Display_Case_Files/T41 7in Top Left Panel Speaker Vents V008.FCStd
T41_3D_Printed_Stuff/V011_7_in_Display_Case_Stl_Files/T41 7in Top Left Panel Speaker Vents V008-Body.stl
T41_Displays_For_T41_Radios/T41_KiCad_Library/3D_models/HFD4_relay.3mf
T41_Displays_For_T41_Radios/T41_KiCad_Library/3D_models/HFD4_relay.stl
T41_KiCad_Library/3D_models/HFD4_relay.3mf
T41_KiCad_Library/3D_models/HFD4_relay.stl
T41_KiCad_Library/3D_models/RD100HHF1C.stl
