DRWJSCHMIDT/T41/T41_3D_Printed_Stuff/KF5N_T41_V10_V11_Case/README.txt

This is an alternative set of Freecad files for the T41 Software Designed Transceiver Project which were modified by Greg KF5N.

This case design is a bit smaller than the original.  It should fit on stock Ender 3 series 3D printers.

  This software is made available under the GNU GPL v3 license agreement. If commercial use of this
  software is planned, we would appreciate it if the interested parties get written approval
  from Jack Purdum, W8TEE, and Al Peter, AC8GY.

  Any and all other commercial uses, written or implied, are forbidden without written permission from
   from Jack Purdum, W8TEE, and Al Peter, AC8GY.
