DRWJSCHMIDT/T41/T41_V012_Files/T41_V012_Assembled_PCBs_V12.8/Fixit Card.pdf

INSTRUCTIONS FOR FIXING THE T41 RF BOARD ATTENUATORS: REMOVE THE PARTS IN BOARD POSITIONS L1 and C1. LEAVE THE CAP IN POSITION C2. PLACE THE PART BELOW MARKED L1 IN THE SPOT MARKED L1 ON THE BOARD. PLACE THE PART BELOW MARKED C2 IN THE SPOT MARKED C1. CAP C1 IS ALREADY IN THE SPOT ON THE BOARD MARKED C2 SO LEAVE IT ALONE! C1 CAPS ARE PROVIDED FOR COMPLETENESS.
C1 | C2 | L1
