DRWJSCHMIDT/T41/T41_3D_Printed_Stuff/Microphone/W4YN Microphone Instructions.pdf

1

bill@wjschmidt.com

From: | SoftwareControlledHamRadio@groups.io on behalf of Tim via groups.io
| <w4yn=Arrl.net@groups.io>
Sent: | Sunday, January 4, 2026 1:36 PM
To: | SoftwareControlledHamRadio@groups.io
Subject: | Re: [SoftwareControlledHamRadio] Microphone

[Edited Message Follows]

I need to make a bill of materials and some assembly instructions. Stay tuned.

### 3 mm inserts qty 5 https://www.amazon.com/dp/B0D475LRH3?ref_=ppx_hzsearch_conn_dt_b_fed_asin_title_1&th=1

3x12 hex head qty 2
3x8 hex head qty 3

### 6 mm mic element (I sometimes use 10mm)

DigiKey part number
668-POM-2722L-ND
1/8" TRS plug and shielded
wire. https://www.amazon.com/dp/B08TSX116N?ref=ppx_yo2ov_dt_b_fed_asin_title&th=1 Nice shielded jumper 8' makes 2 mic cords

Micro Switch https://www.amazon.com/dp/B07NVD4YZZ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

You will need a soldering iron adapter for heat and install 3 mm inserts work fast keep insert square to housing
You may have to file some excess material that is pushed up inserting inserts

Mic Body is PLA or ABS or PETG
Strain relief is TPU

After printing you will need to remove support from Mic cavity and use exacto knife to free up PTT lever. Heating blade helps.

Install the 5 Hex inserts using soldering iron and adaptor, heat to around 175 degrees
Install micro switch with 2 3x12 hex head screws
Push Mic into recess (When I use 10mm Mic element I back bore the mic recess in milling machine 10mm dia x 9mm deep)
Maybe someone can modify STL for 10mm option just easy for me to do in mill.
Push cord thru strain relief.
attach wires to mic and micro switch

2

On wiring V12 has a jack for Mic and PTT using 1/8 TRS jacks.
Keeps mic ground and PTT chassis ground isolated.
I kept the 1/8 TRS PTT jack but changed Mic jack to TRRS and jumped the PTT to second ring on TRRS jack.
You will need a TRRS jumper instead of the TRS shown
above https://www.amazon.com/dp/B0DHCGR2KN?ref_=ppx_hzsearch_conn_dt_b_fed_asin_title_4

Tim
_._,_._,_

Groups.io Links:

You receive all messages sent to this group.

View/Reply Online (#36075) | Reply to Group | Reply to Sender | Mute This Topic | New Topic

https://groups.io/g/SoftwareControlledHamRadio/wiki

Your Subscription | Contact Group Owner | Unsubscribe [bill@wjschmidt.com]
_._,_._,_
