DRWJSCHMIDT/T41/T41_3D_Printed_Stuff/BPF Core Holders/BPF Core Holder Pictures.docx

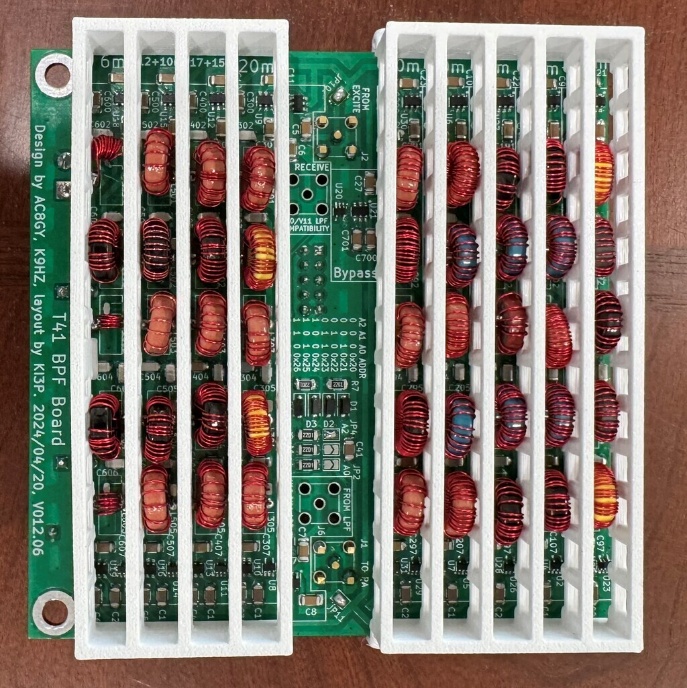
[picture p295: figure]
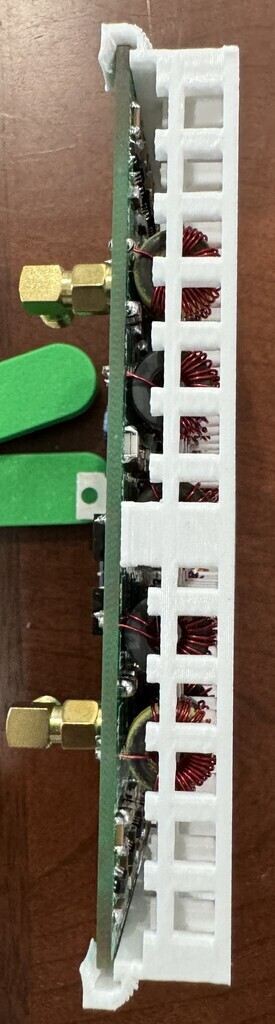
[picture p296: figure]
