DRWJSCHMIDT/T41/T41_3D_Printed_Stuff/Microphone/Maker Link in note.pdf

1

Dr. William J. Schmidt

From: | SoftwareControlledHamRadio@groups.io on behalf of Ashley Davison via groups.io
| <ashleytiger=sky.com@groups.io>
Sent: | Sunday, January 4, 2026 7:22 AM
To: | SoftwareControlledHamRadio@groups.io
Subject: | Re: [SoftwareControlledHamRadio] Microphone

Here is the link Dr William.

https://www.printables.com/model/818548-handheld-ppt-ham-microphone-for-trusdx-usdx

Ashley G0PFD
_._,_._,_

Groups.io Links:

You receive all messages sent to this group.

View/Reply Online (#36071) | Reply to Group | Reply to Sender | Mute This Topic | New Topic

https://groups.io/g/SoftwareControlledHamRadio/wiki

Your Subscription | Contact Group Owner | Unsubscribe [bill@wjschmidt.com]
_._,_._,_
