DRWJSCHMIDT/T41/K9HZ_Front_Panel_Boards/K9HZ_Front_Panel_Assembly_Manuals/K9HZ_Front_Panel_Boards_Addressing_07-07-24.JPG

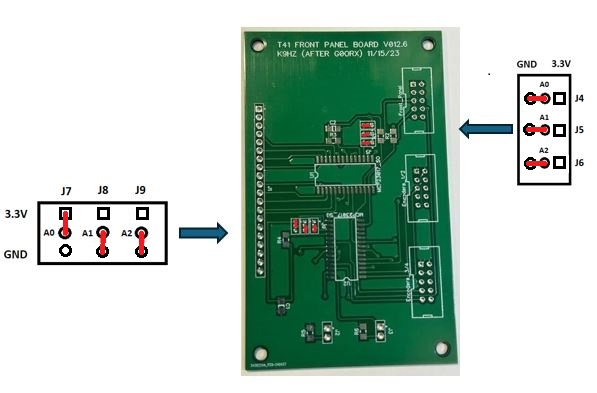
K9HZ_Front_Panel_Boards/K9HZ_Front_Panel_Assembly_Manuals/K9HZ_Front_Panel_Boards_Addressing_07-07-24.JPG
