DRWJSCHMIDT/T41/T41_3D_Printed_Stuff/Microphone/Microphone Pic 1.webp

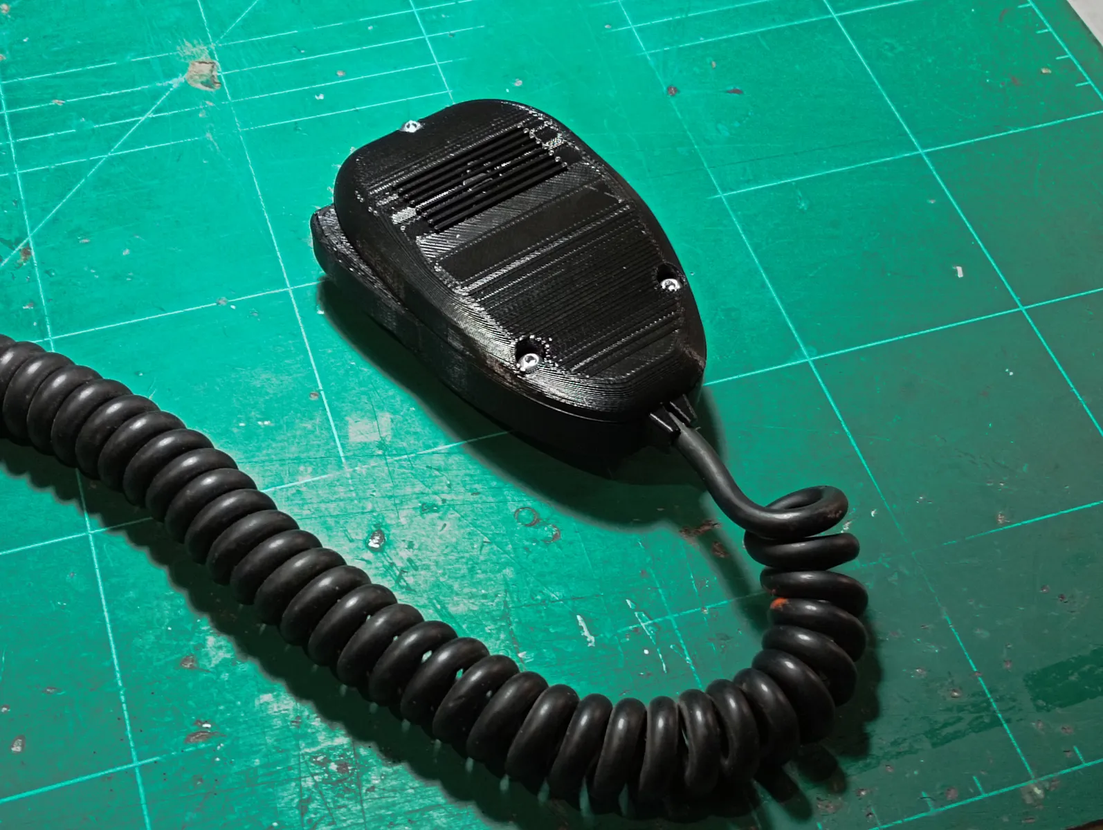
T41_3D_Printed_Stuff/Microphone/Microphone Pic 1.webp
