DRWJSCHMIDT/T41/T41_3D_Printed_Stuff/Vxxx_Fan_Brackets/24mm_fan_mount.jpg

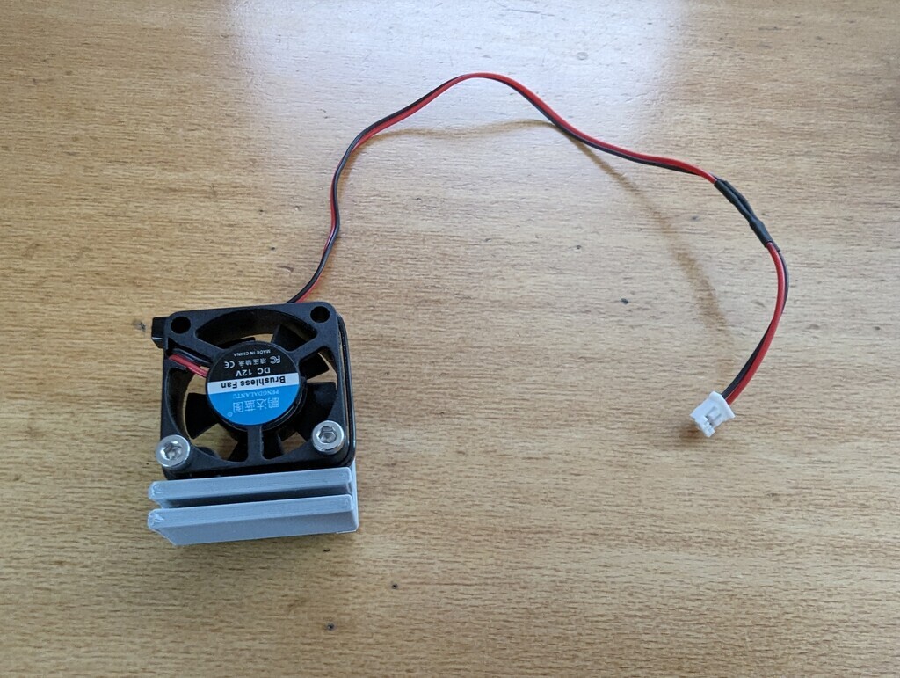
T41_3D_Printed_Stuff/Vxxx_Fan_Brackets/24mm_fan_mount.jpg
