DRWJSCHMIDT/T41/T41_V012_Files/T41_V012_PCB_Pictures/T41_V012_Main_Build_Pic_6.jpg

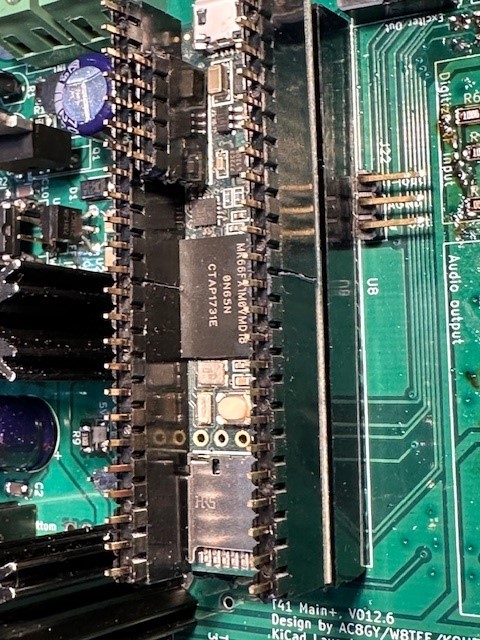
T41_V012_Files/T41_V012_PCB_Pictures/T41_V012_Main_Build_Pic_6.jpg
