DRWJSCHMIDT/T41/T41_V012_Files/T41_V012_QC_Logs/T41_BPF_Testing_Report_041224_K9HZ.docx

T41 BPF Board Prototype Testing Report

Board Rev Version | Tester | Date
V12.06 03/09/2024 | Bill K9HZ | 04/12/2024

Test #1 – Board Voltage: 3.3V.

Connected board to 12V supply at J3, measure voltage between regulator output and GND at TP15.

Measurement: Voltage measured = 3.285 VDC

RESULT OF TEST #1 –> PASS.

Test #2 – I2C Address Test: 0x24 for BPF #1

A. Solder JP4 closed. JP3 and JP2 remain open for 0x24 address.
B. Compile and load “I2CScan” utility into T41 V12 Main board Teensy processor.
C. Connect “BANDS” cable from V12 Main to BPF #1.
D. Connect 12V to Main board and BPF #1 board.
E. Observe Scanned addresses:

Scanning Wire ...

I2C device found at address 0x0A ! [Correct Address for Teensy Audio Hat]

done

Scanning Wire1 ...

No I2C devices found

Scanning Wire ...

Scanning Wire2 ...

I2C device found at address 0x24 ! [Correct Address for #1 BPF MCP23017]

done

RESULT OF TEST #2 –> PASS.

TEST #3 – Filter Attenuation Test, Each Band

A. Compile and load “BPFTest” program into T41 V12 Main board Teensy processor.
B. Connect Rigol 3030E Spectrum Analyzer input to the J5 “To Receive” connector,
C. Connect the SA Tracking Generator signal to J6, the “From LPF” connector.
D. Set the span of the SA to 1 MHz-150 MHz.
E. Test each band 160M, 80M, 60M, 40M, 30M, 20M, 17M/15M, 12M/10M, 6M and Bypass. Save and publish scan.
F. From scans, determine Upper/ Lower second and third harmonic dB reduction values.

RESULTS OF TEST #3 ->

<Write the code and plots go here>

TEST #4 – Test RXTX Switch.

A. Use setup from TEST #3 except…
B. Connect SA Tracking generator signal to J2 “From Excite” connector.
C. Connect SA Input to J1 “To PA” connector.
D. Test band using “BPFTest” program to 40M.
E. Energize PTT to ground on Main Board.
F. Show result of scan. Should match the scan from 40M above.

RESULTS OF TEST #4 ->

ERRATA And CHANGES

None.
