DRWJSCHMIDT/T41/T41_V012_Files/T41_V012_Design_Documents/ABX00162-full-pinout.pdf

## JCTL

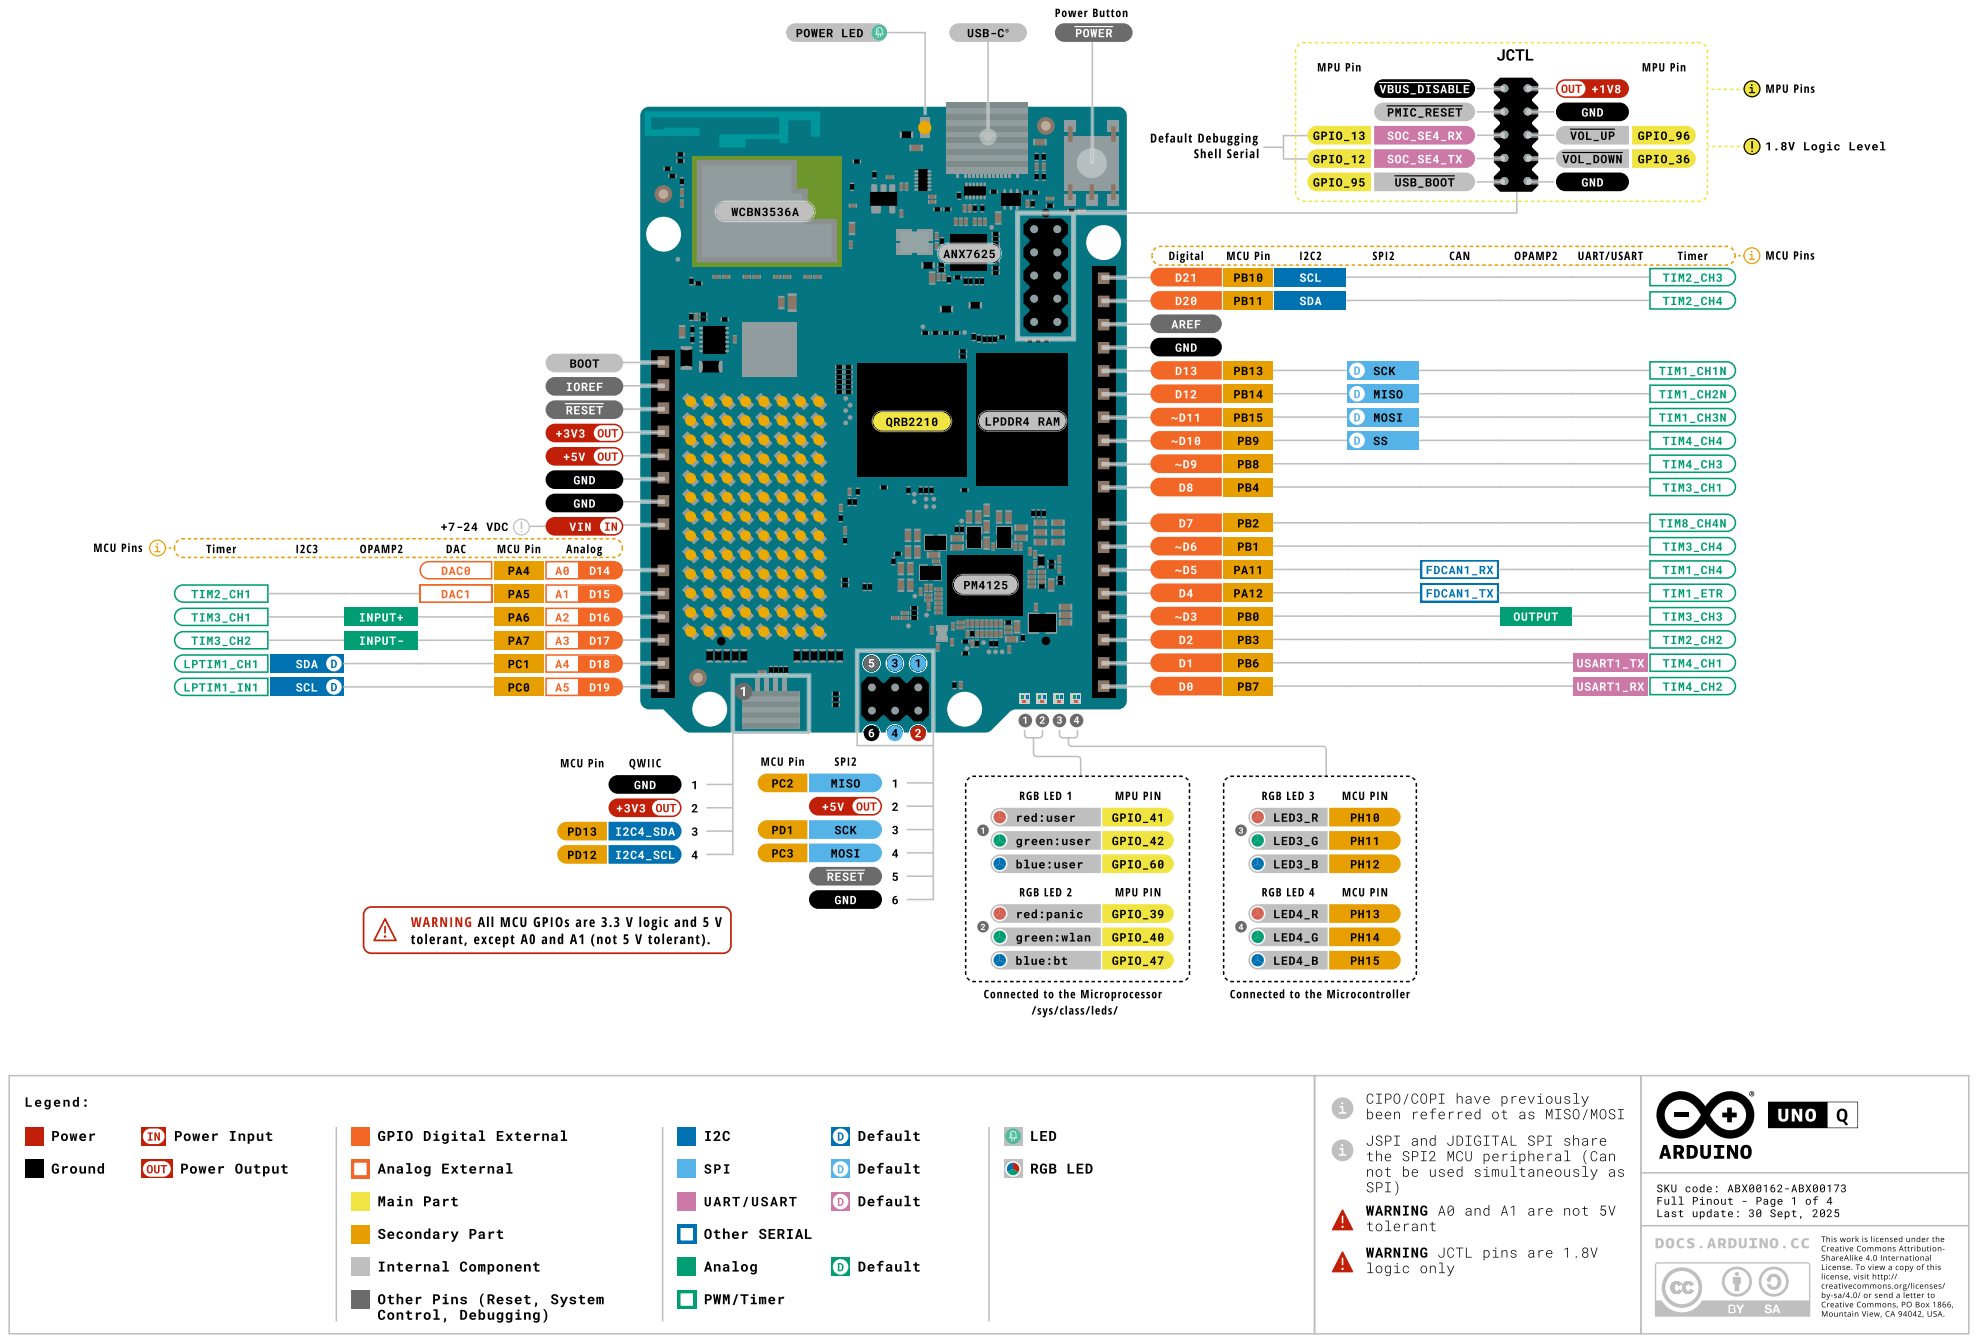
[picture p315: page 1]

WARNING All MCU GP IOs a re 3.3 V logic and 5 V
tole ran t, excep t A0 and A1 (no t 5 V tole ran t).

CIPO/COPI have previously
been referred ot as MISO/MOSI

JSPI and JDIGITAL SPI share
the SPI2 MCU peripheral (Can

not be used simultaneously as
SPI)

WARNING A0 and A1 are not 5V
tolerant

DOCS.ARDUINO.CC This work is licensed under the

WARNING JCTL pins are 1.8V
logic only

License. To view a copy of this

Other Pins (Reset, System
Control, Debugging)

by-sa/4.0/ or send a letter to

Creative Commons, PO Box 1866,
Mountain View, CA 94042, USA.

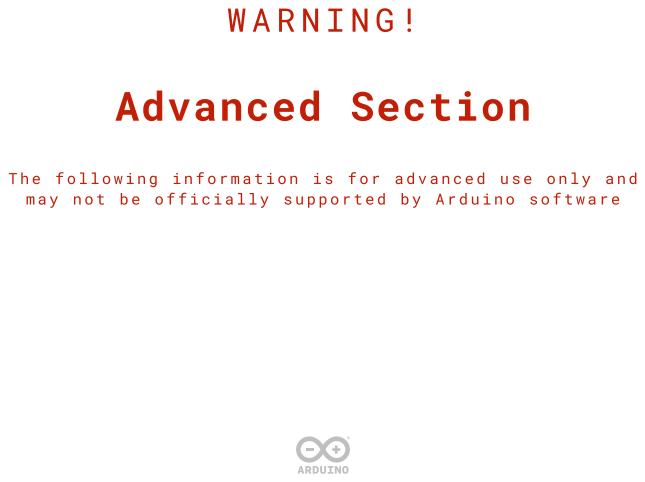
[picture p316: page 2]
Advanced Section

# LED Matrix 8x13

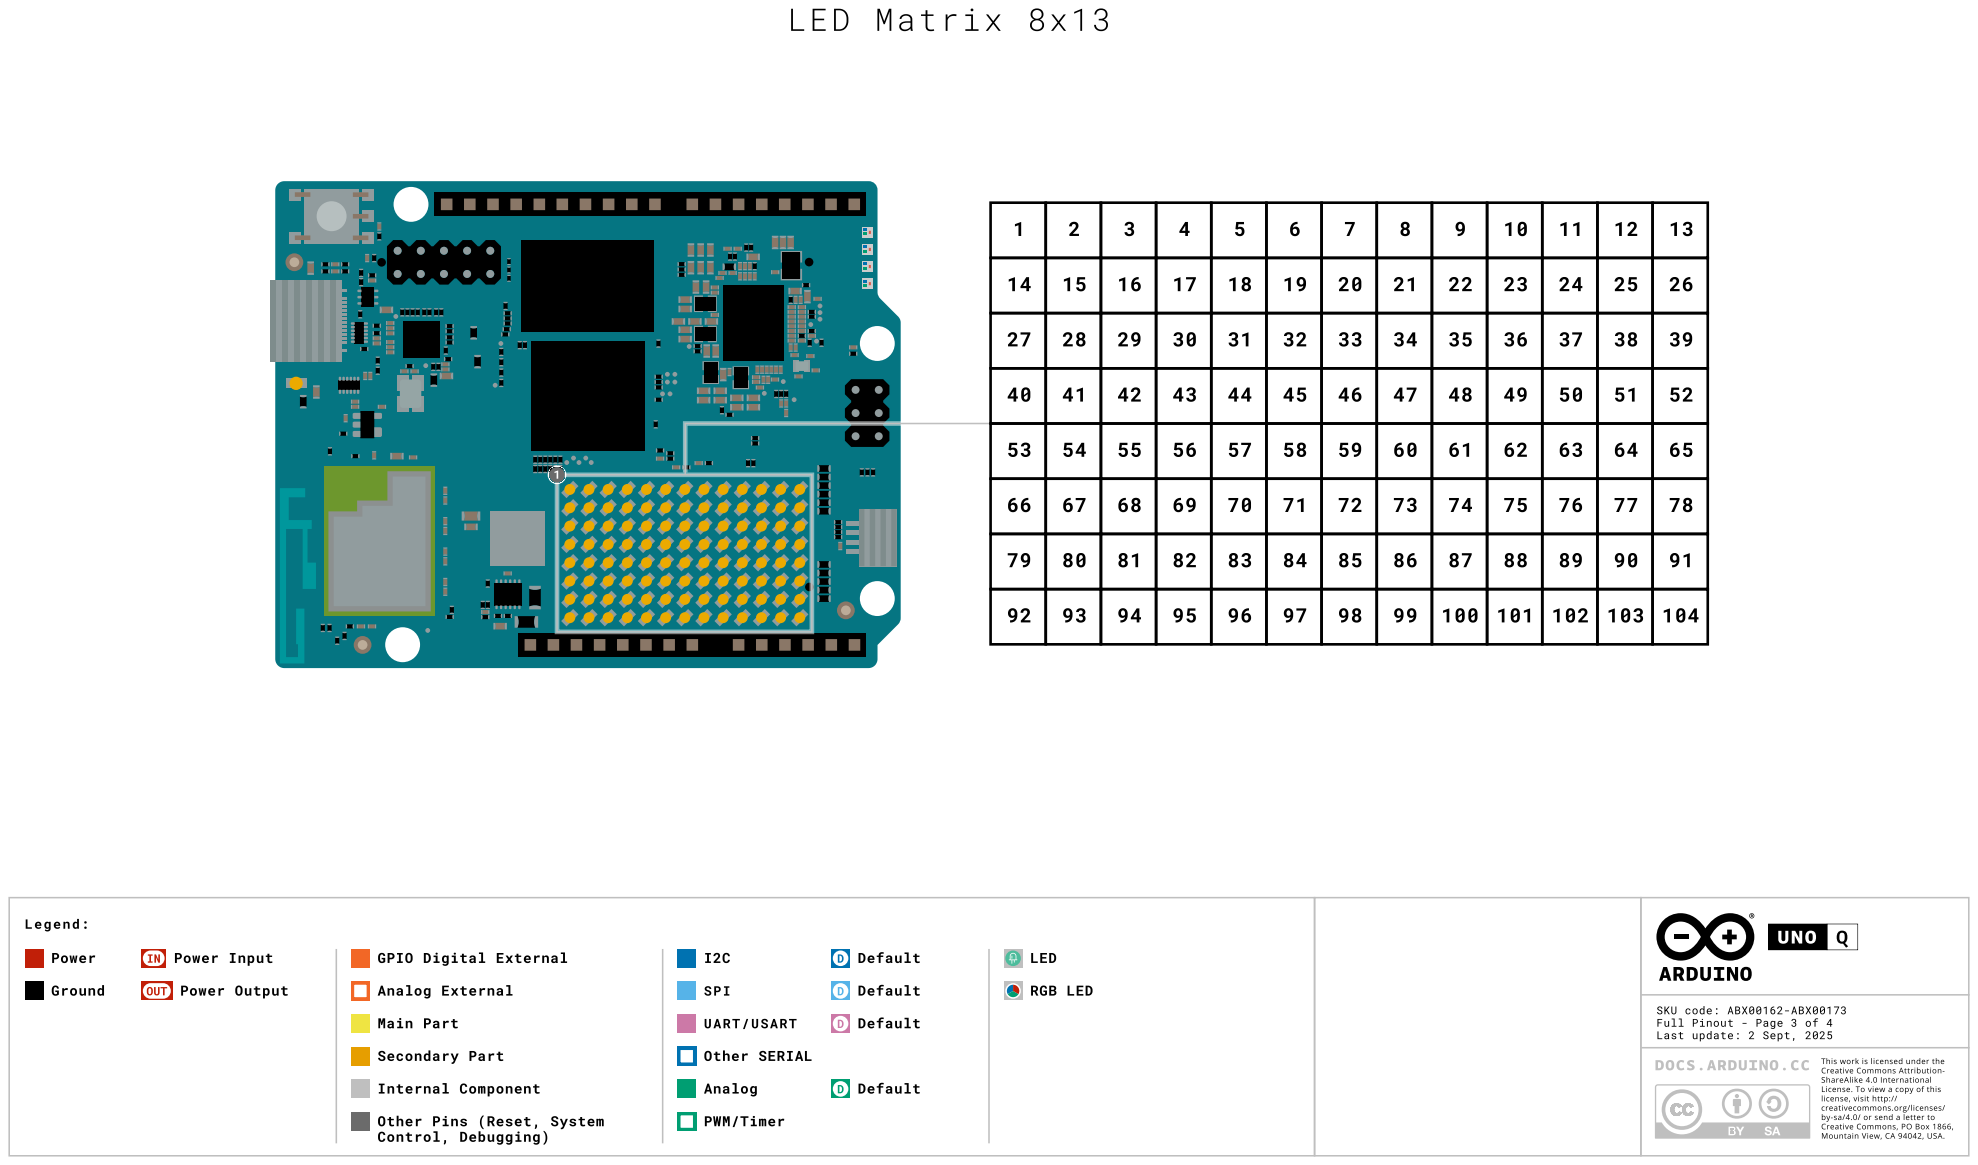
[picture p317: page 3]
Power; Power Input; Ground; Power Output; Analog External; Main Part; Default; Analog; LED; RGB LED; UNO

GPIO Digital External

SKU code: ABX00162-ABX00173
Full Pinout - Page 3 of 4
Last update: 2 Sept, 2025

Other Pins (Reset, System
Control, Debugging)

JMISC | JMEDIA
MCU Pins | MPU Pins

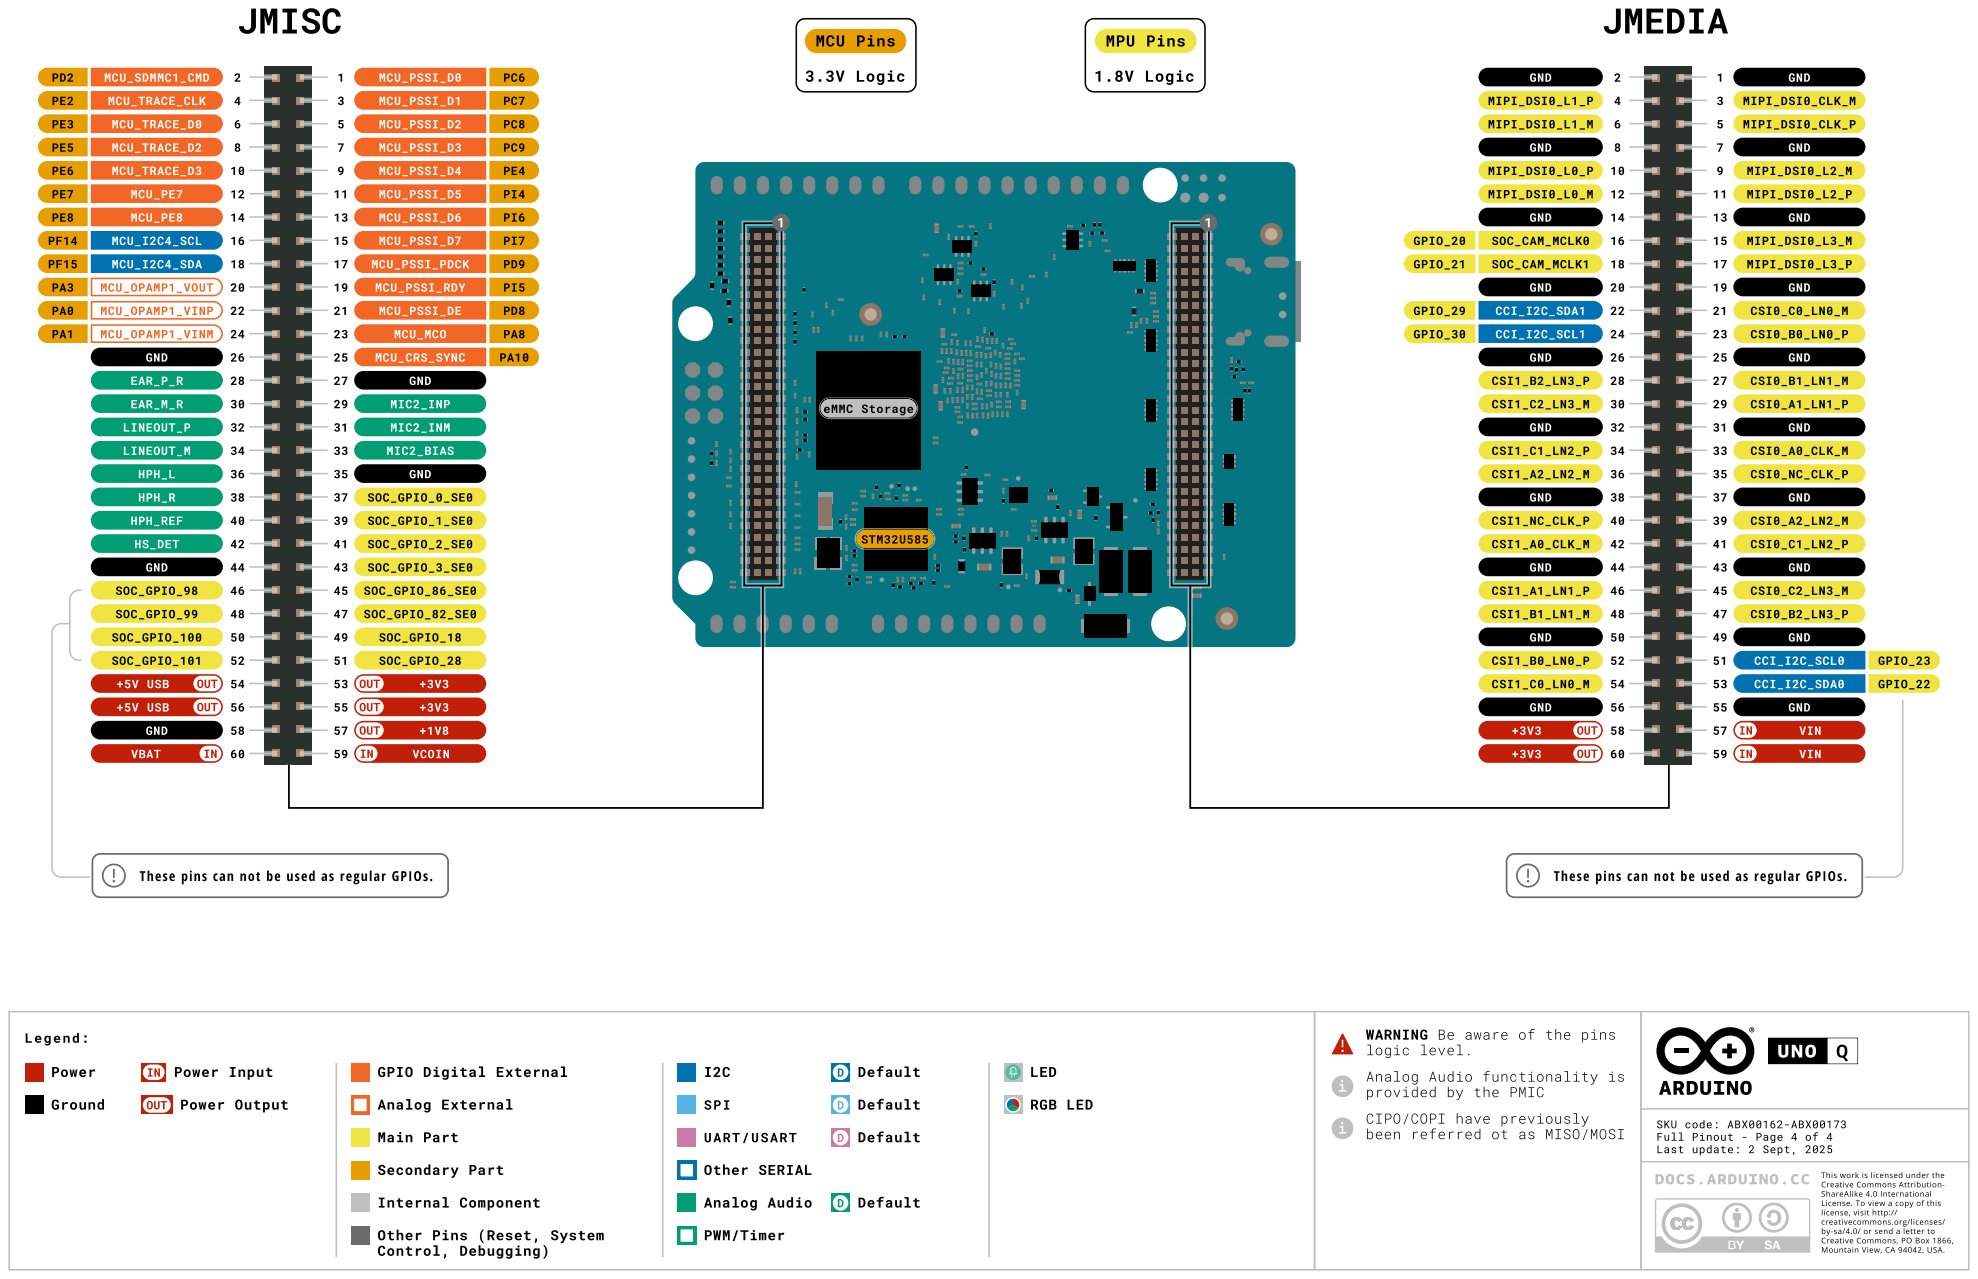
[picture p318: page 4]
MCU_PSSI_D0; MCU_PSSI_D1; MCU_PSSI_D2; MCU_PSSI_D3; MCU_PSSI_D4; MCU_PSSI_D5; MCU_PSSI_D6; MCU_PSSI_D7; MCU_PSSI_PDCK; MCU_PSSI_RDY; MCU_PSSI_DE; MCU_MCO; MCU_CRS_SYNC; GND; MIC2_INP; MIC2_INM; MIC2_BIAS; SOC_GPIO_0_SE0; SOC_GPIO_1_SE0; SOC_GPIO_2_SE0; SOC_GPIO_3_SE0; SOC_GPIO_86_SE0; SOC_GPIO_82_SE0; SOC_GPIO_18; SOC_GPIO_28; VCOIN; MCU_SDMMC1_CMD; MCU_TRACE_CLK; MCU_TRACE_D0; MCU_TRACE_D2; MCU_TRACE_D3; MCU_PE7; MCU_PE8; MCU_I2C4_SCL; MCU_I2C4_SDA; MCU_OPAMP1_VOUT; MCU_OPAMP1_VINP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

WARNING Be aware of the pins
logic level.

GPIO Digital External

Analog Audio functionality is
provided by the PMIC

CIPO/COPI have previously
been referred ot as MISO/MOSI

SKU code: ABX00162-ABX00173
Last update: 2 Sept, 2025

Other Pins (Reset, System
Control, Debugging)
