DRWJSCHMIDT/T41/T41_V012_Files_01-15-24/T41_V012_Schematic_PDFs/T41_RF_Board_Schematic_(Atn)_V012.6_12-30-23_Diptrace.pdf

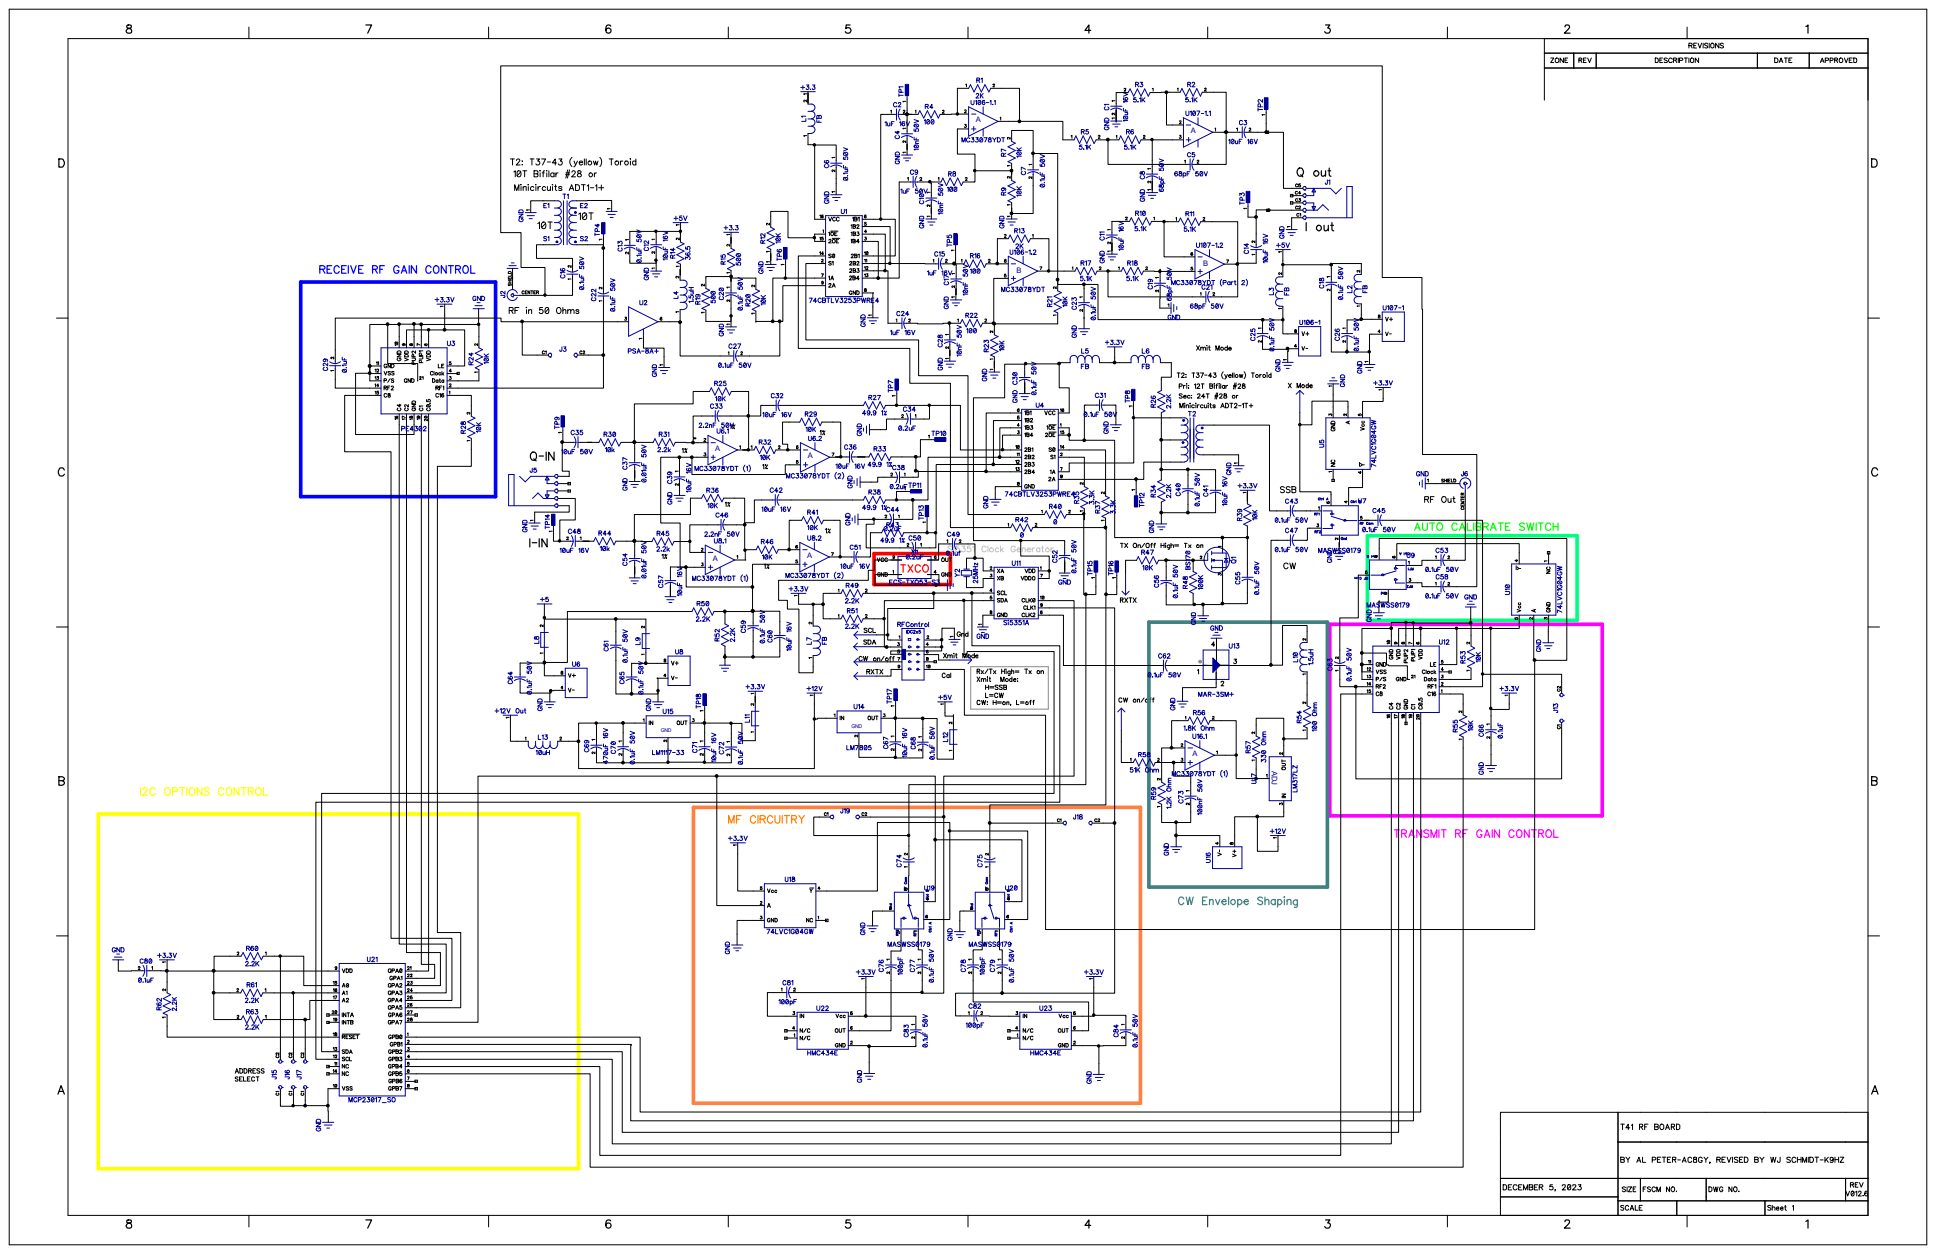
[picture p319: page 1]
GND; ADJ A
