DRWJSCHMIDT/T41/T41_V012_Files/T41_V012_Schematic_PDFs/T41_RF_Board_Schematic_V12.8_Second_Receiver_092626.pdf

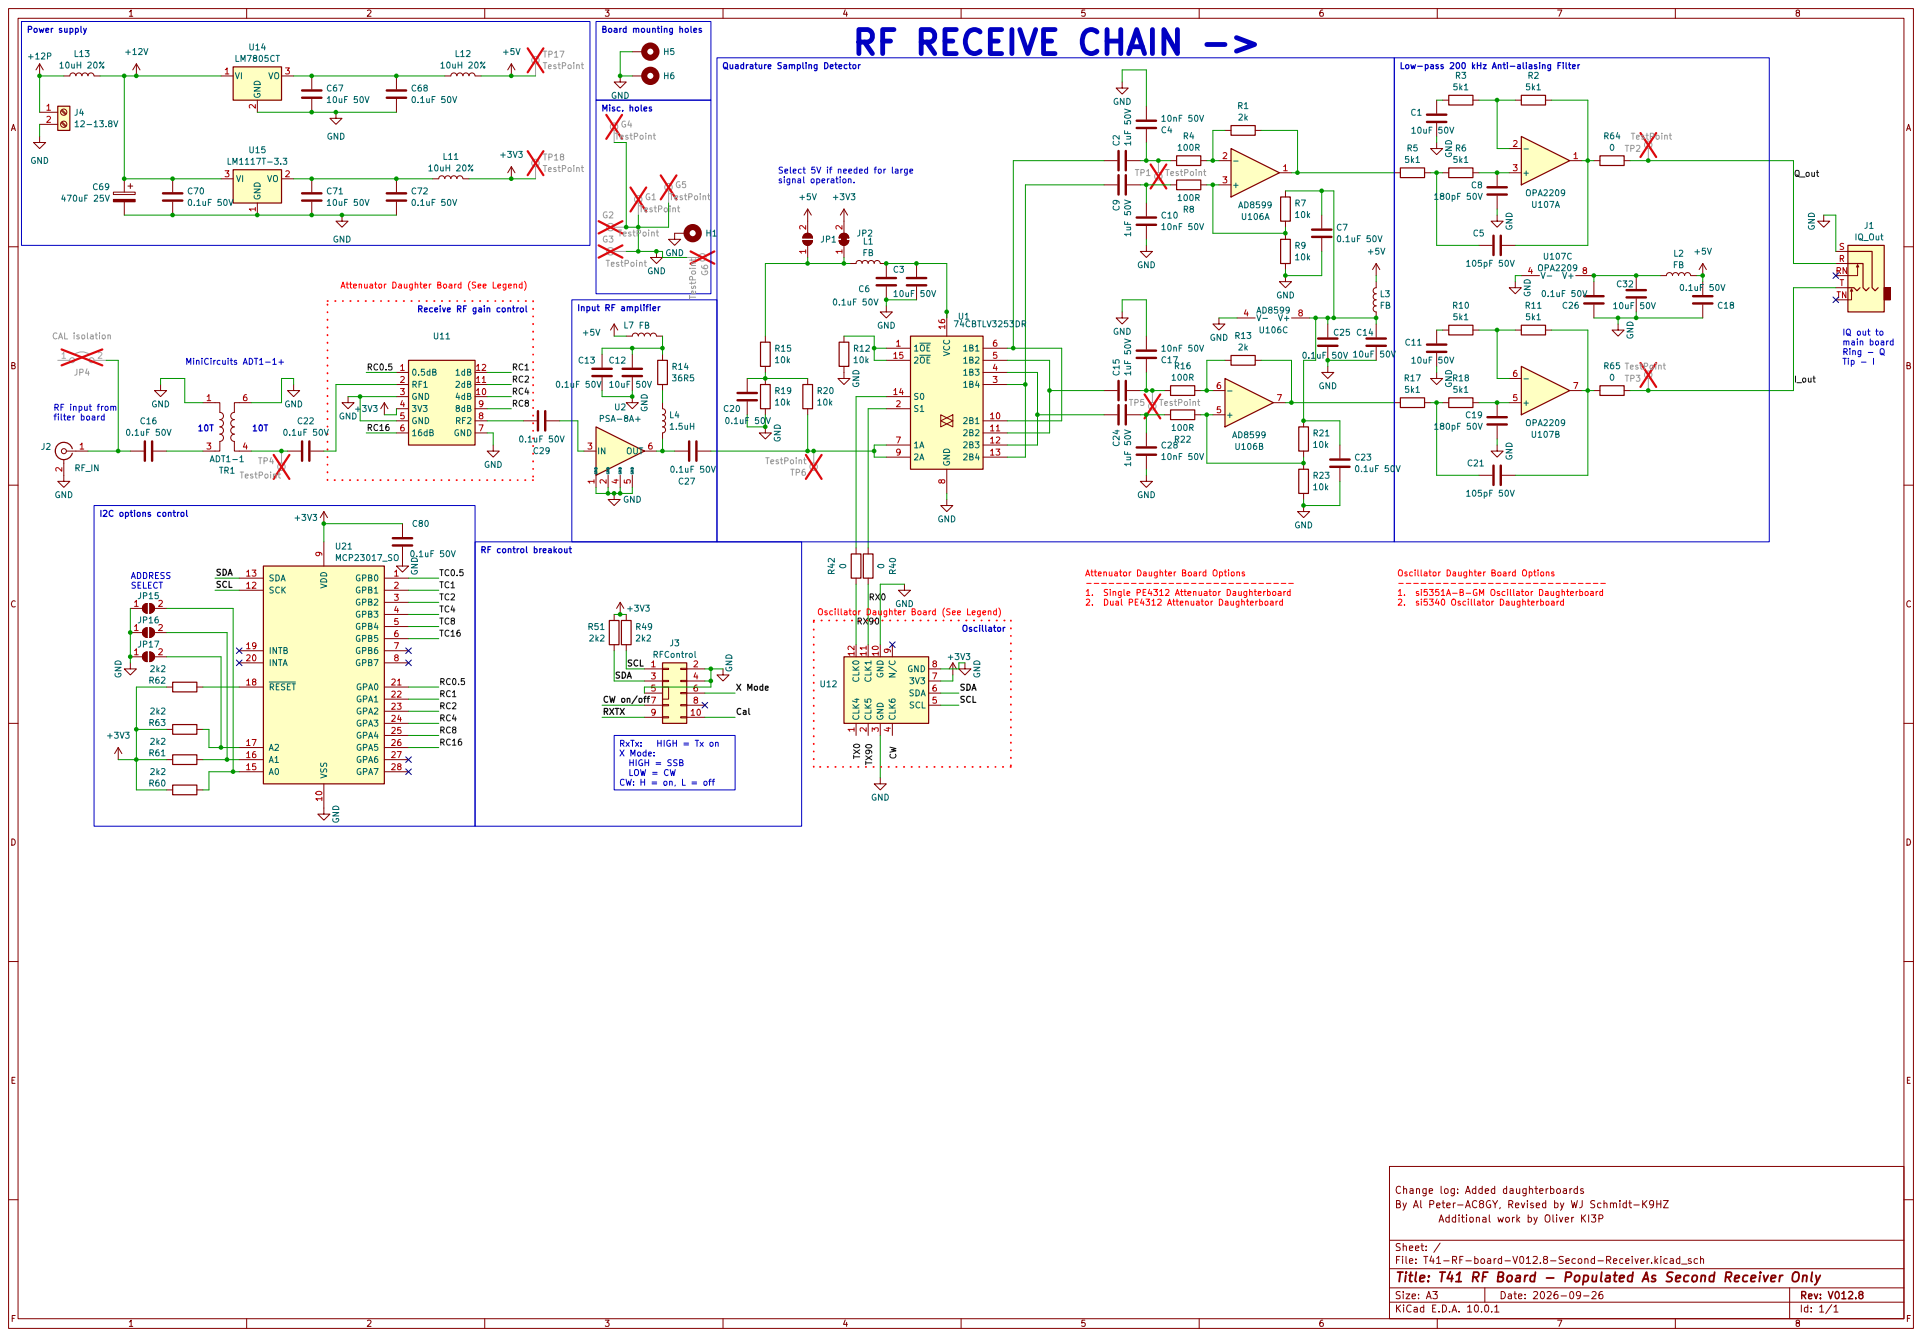
[picture p320: page 1]
