DRWJSCHMIDT/T41/T41_V012_Files/T41_V012_Schematic_PDFs/T41_Single_PE4312_Attenuator_daughterboard_Schematic_070726.pdf

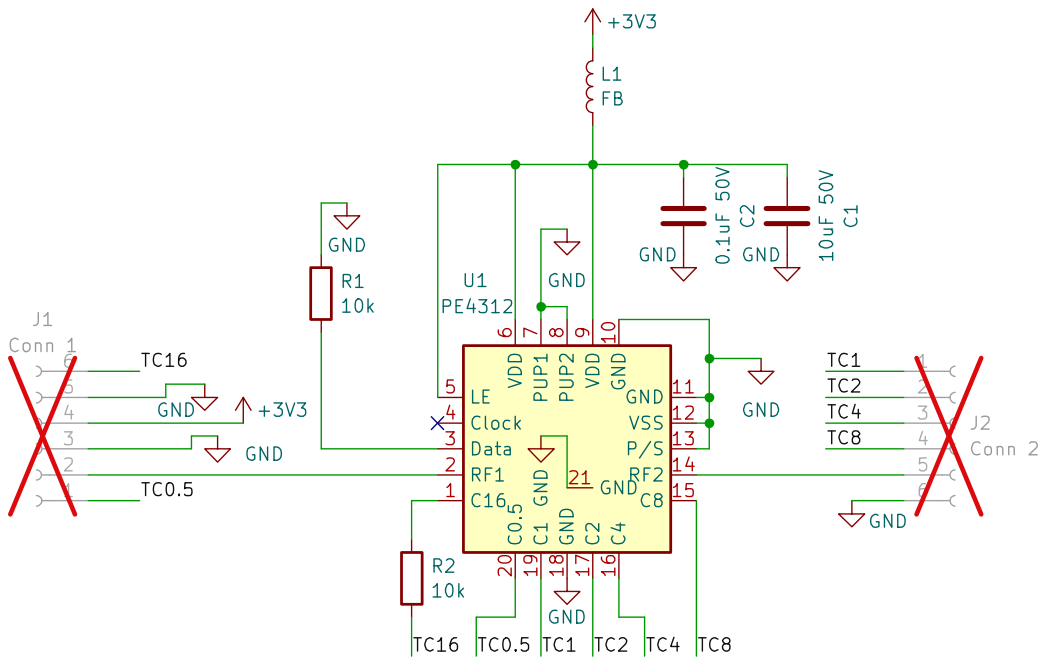
[picture p322: page 1]
