DRWJSCHMIDT/T41/T41_V012_Files/T41_V012_Schematic_PDFs/T41-Dual_PE4312_Attenuator_daughterboard_Schematic_042526.pdf

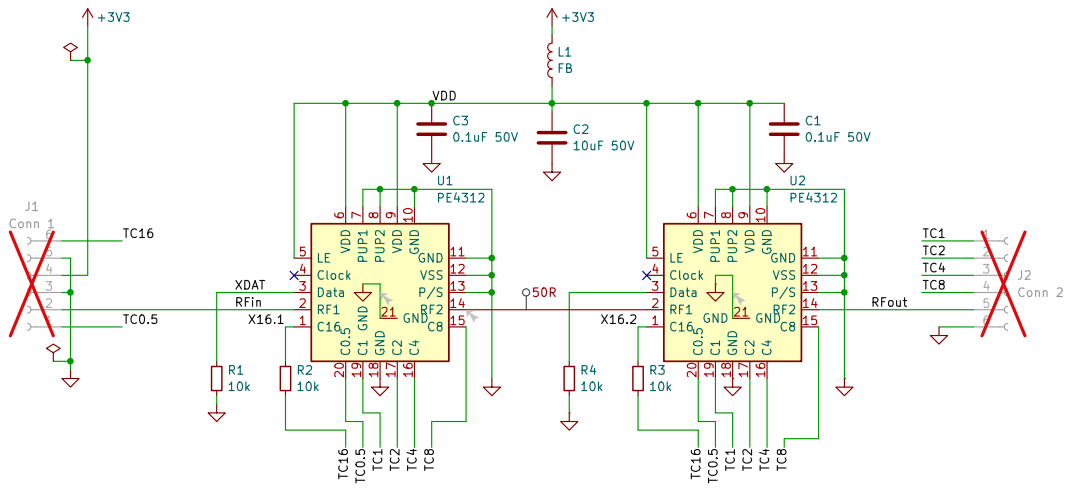
[picture p323: page 1]
