DRWJSCHMIDT/T41/T41_V012_Files/T41_V012_Schematic_PDFs/T41_RF_Board_Schematic_V12.8_042526.pdf

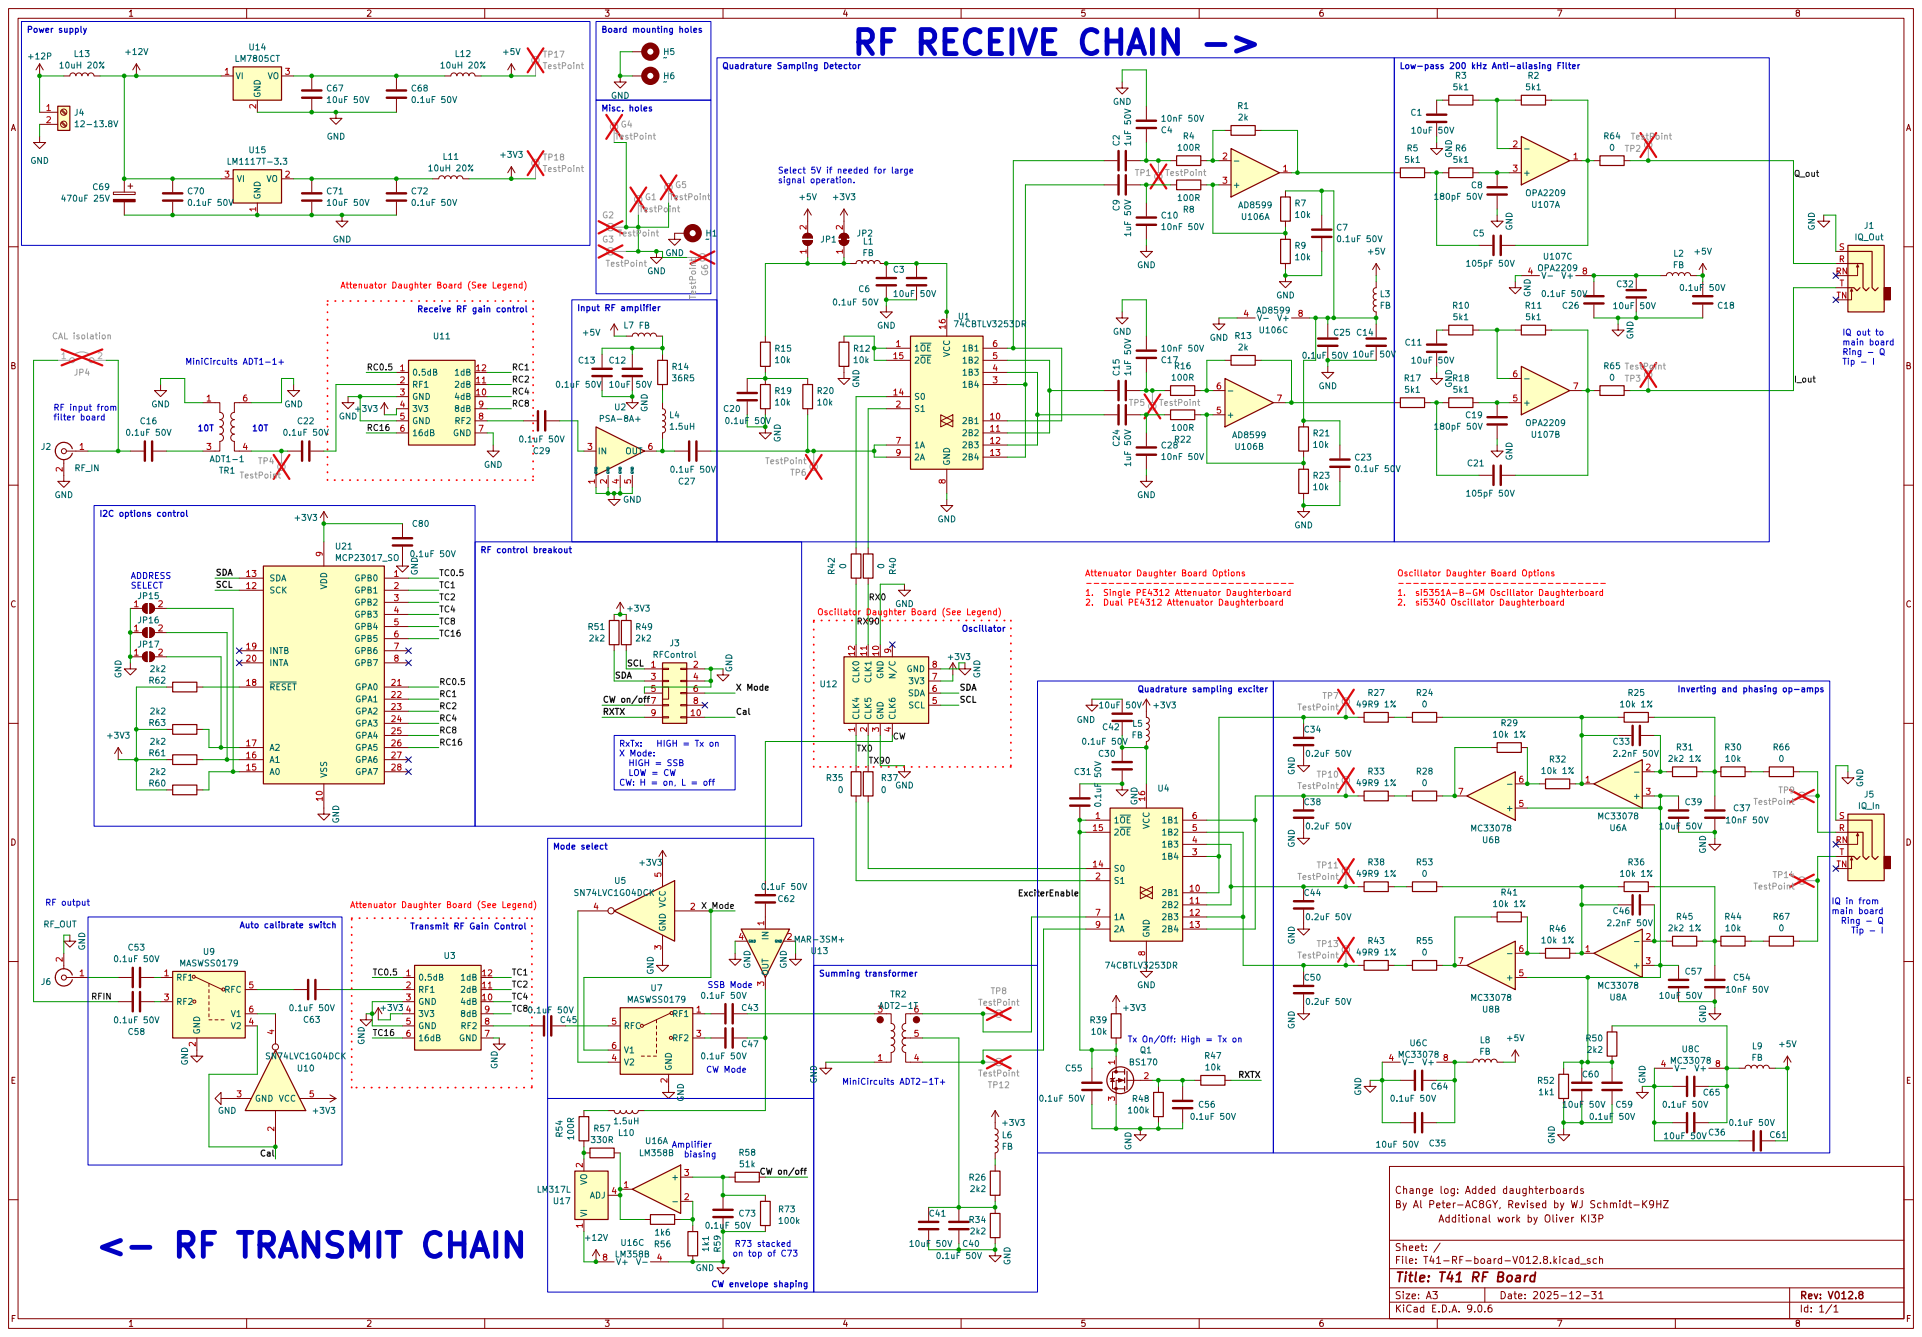
[picture p324: page 1]
