DRWJSCHMIDT/T41/T41_V012_Files/T41_V012_Schematic_PDFs/T41_si5351A-B-GM_Oscillator_daughterboard_042526.pdf

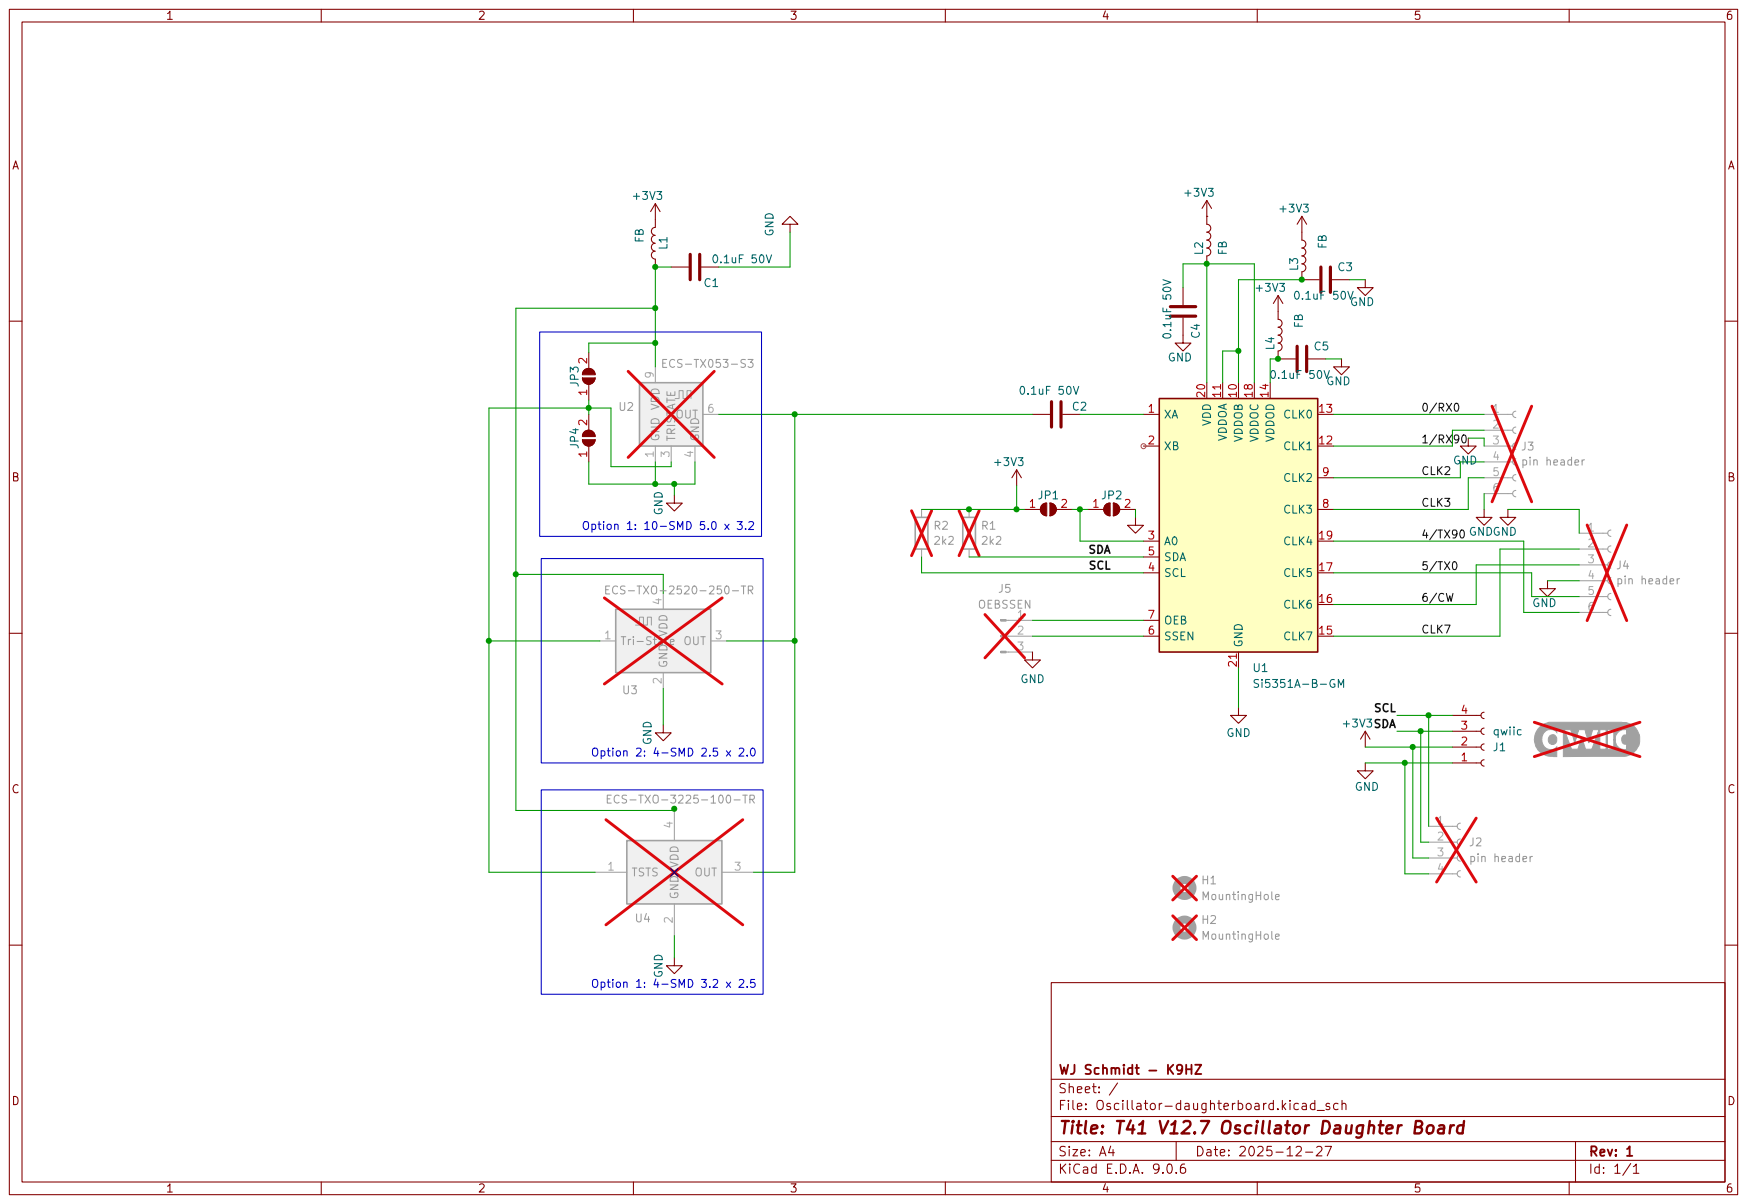
[picture p325: page 1]
