DRWJSCHMIDT/T41/T41_3D_Printed_Stuff/Microphone/Microphone Original Author Page.pdf

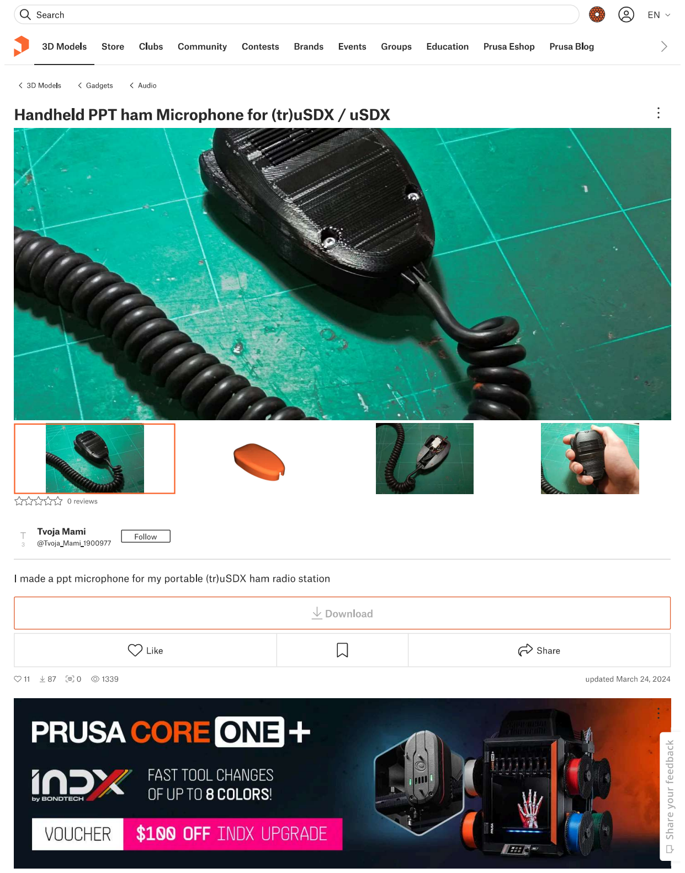
[picture p326: page 1]

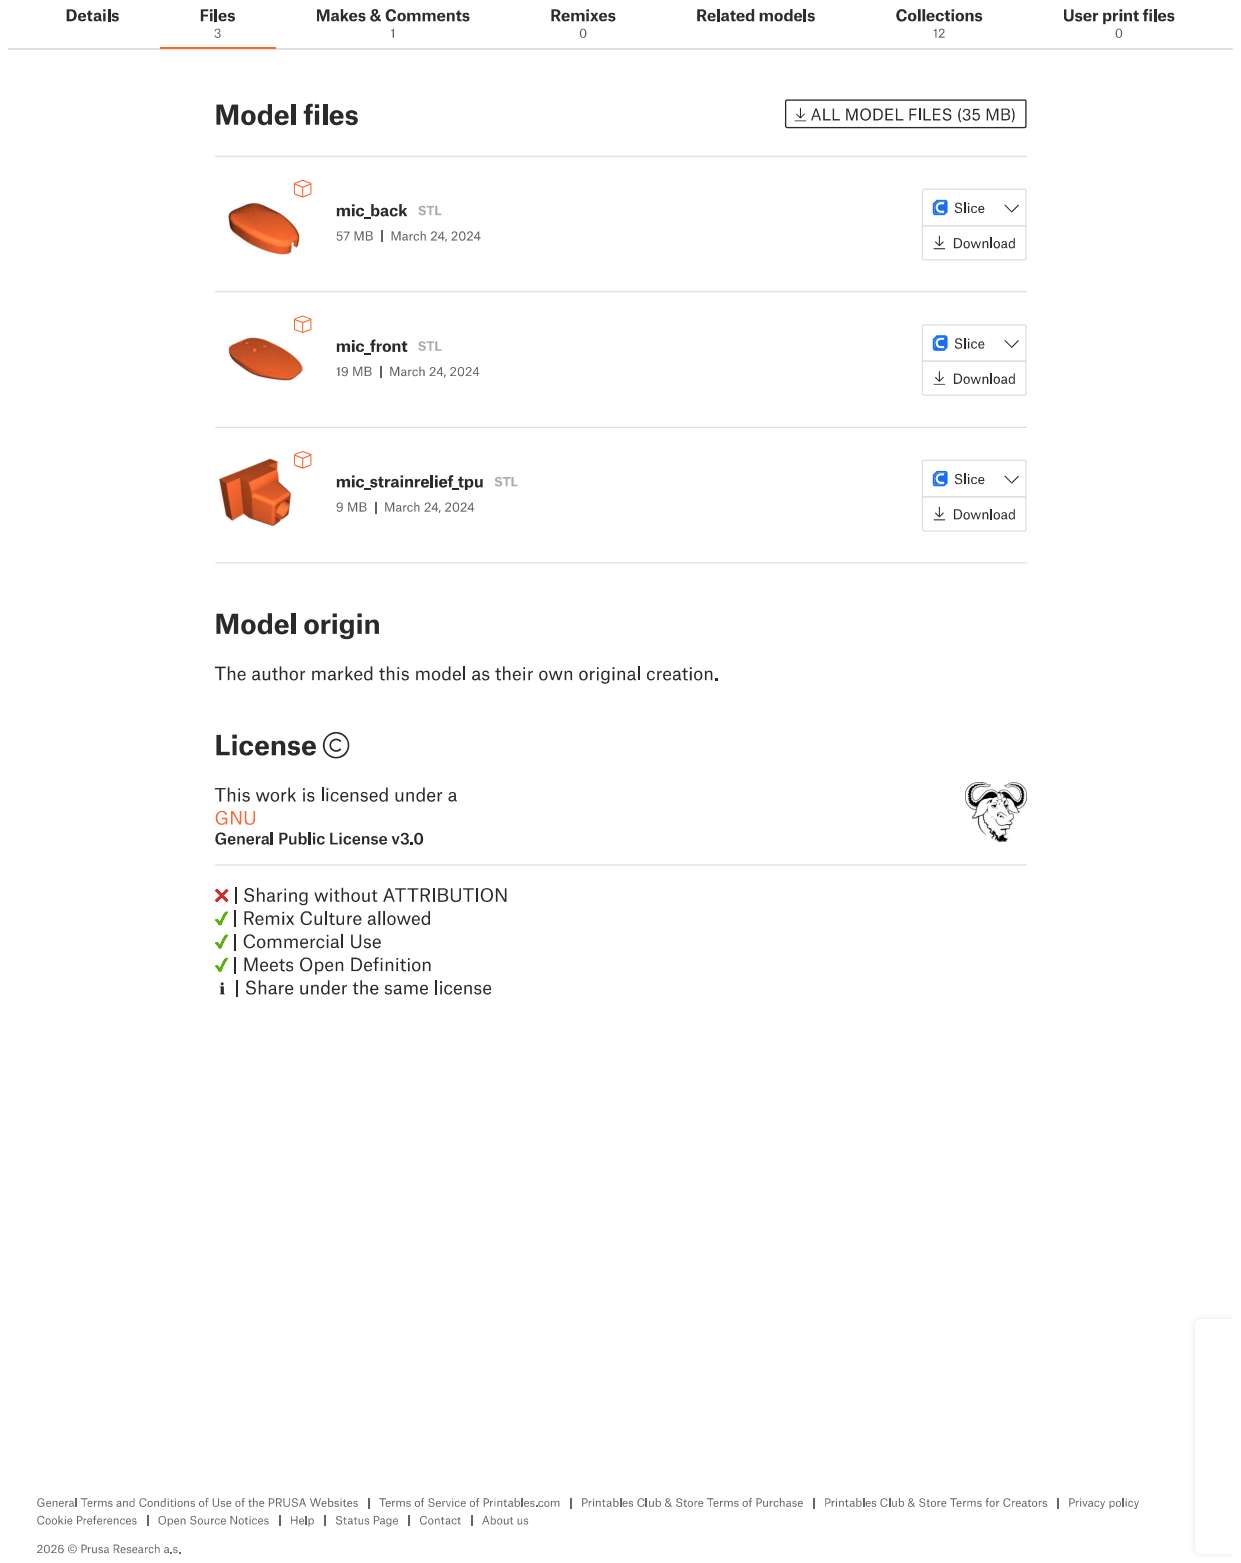
[picture p327: page 2]

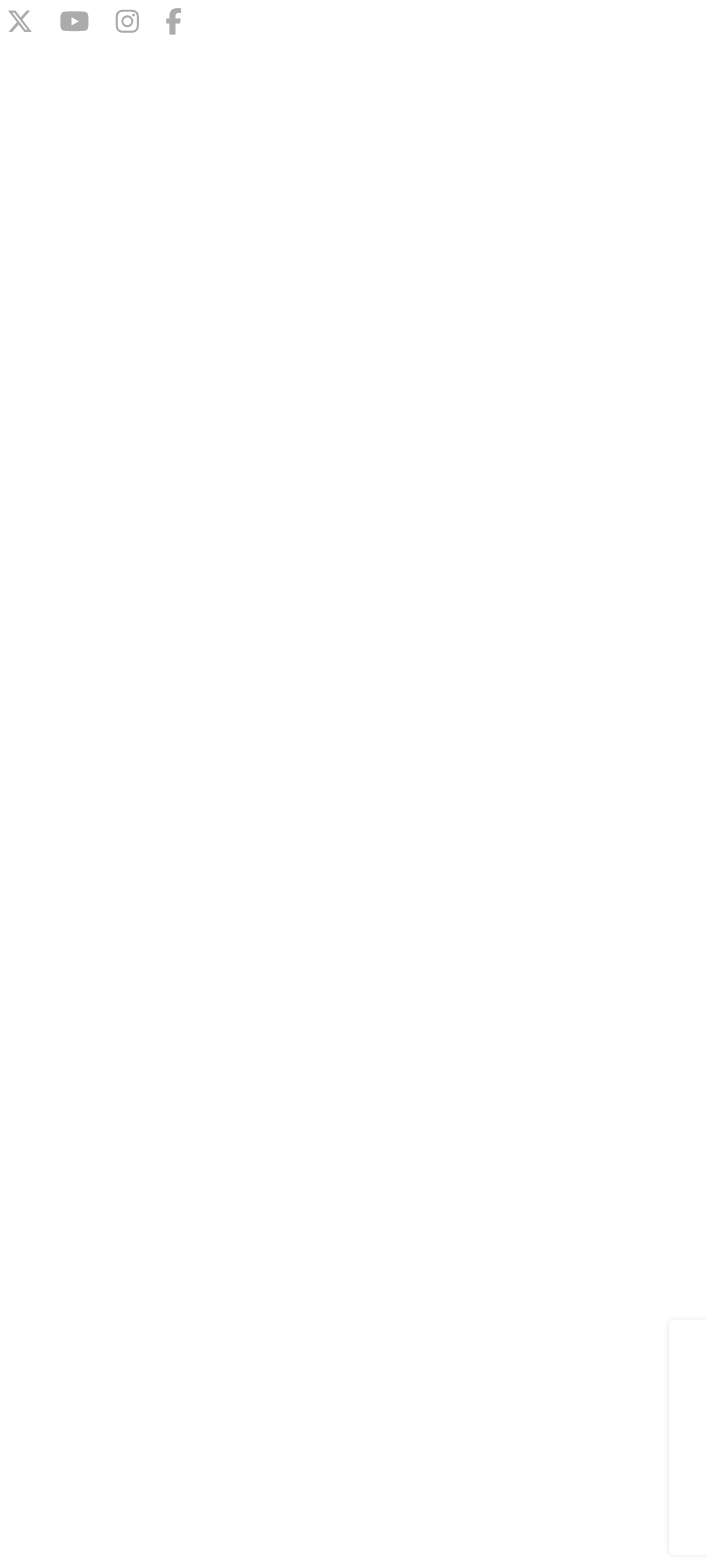
[picture p328: page 3]
