DRWJSCHMIDT/T41/T41_V012_Files/T41_V012_Schematic_PDFs/T41_Single_PE4312_Attenuator_Daughterboard_Schematic_042526.pdf

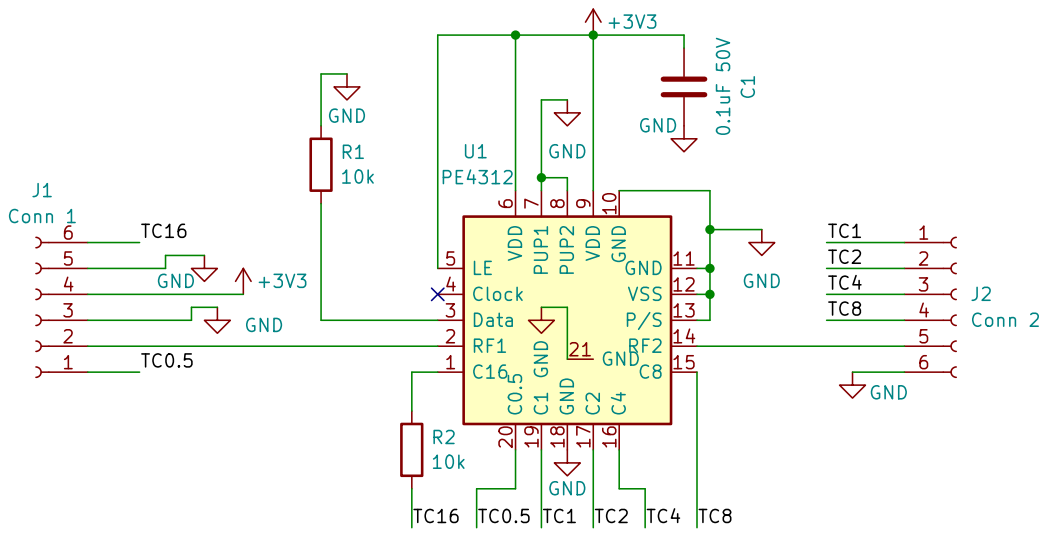
[picture p329: page 1]
