DRWJSCHMIDT/T41/T41_V012_Mini_Files/T41_V012_Mini_Schematics_PDFs/T41_V012_Mini_Main+RF_Board_122825.pdf

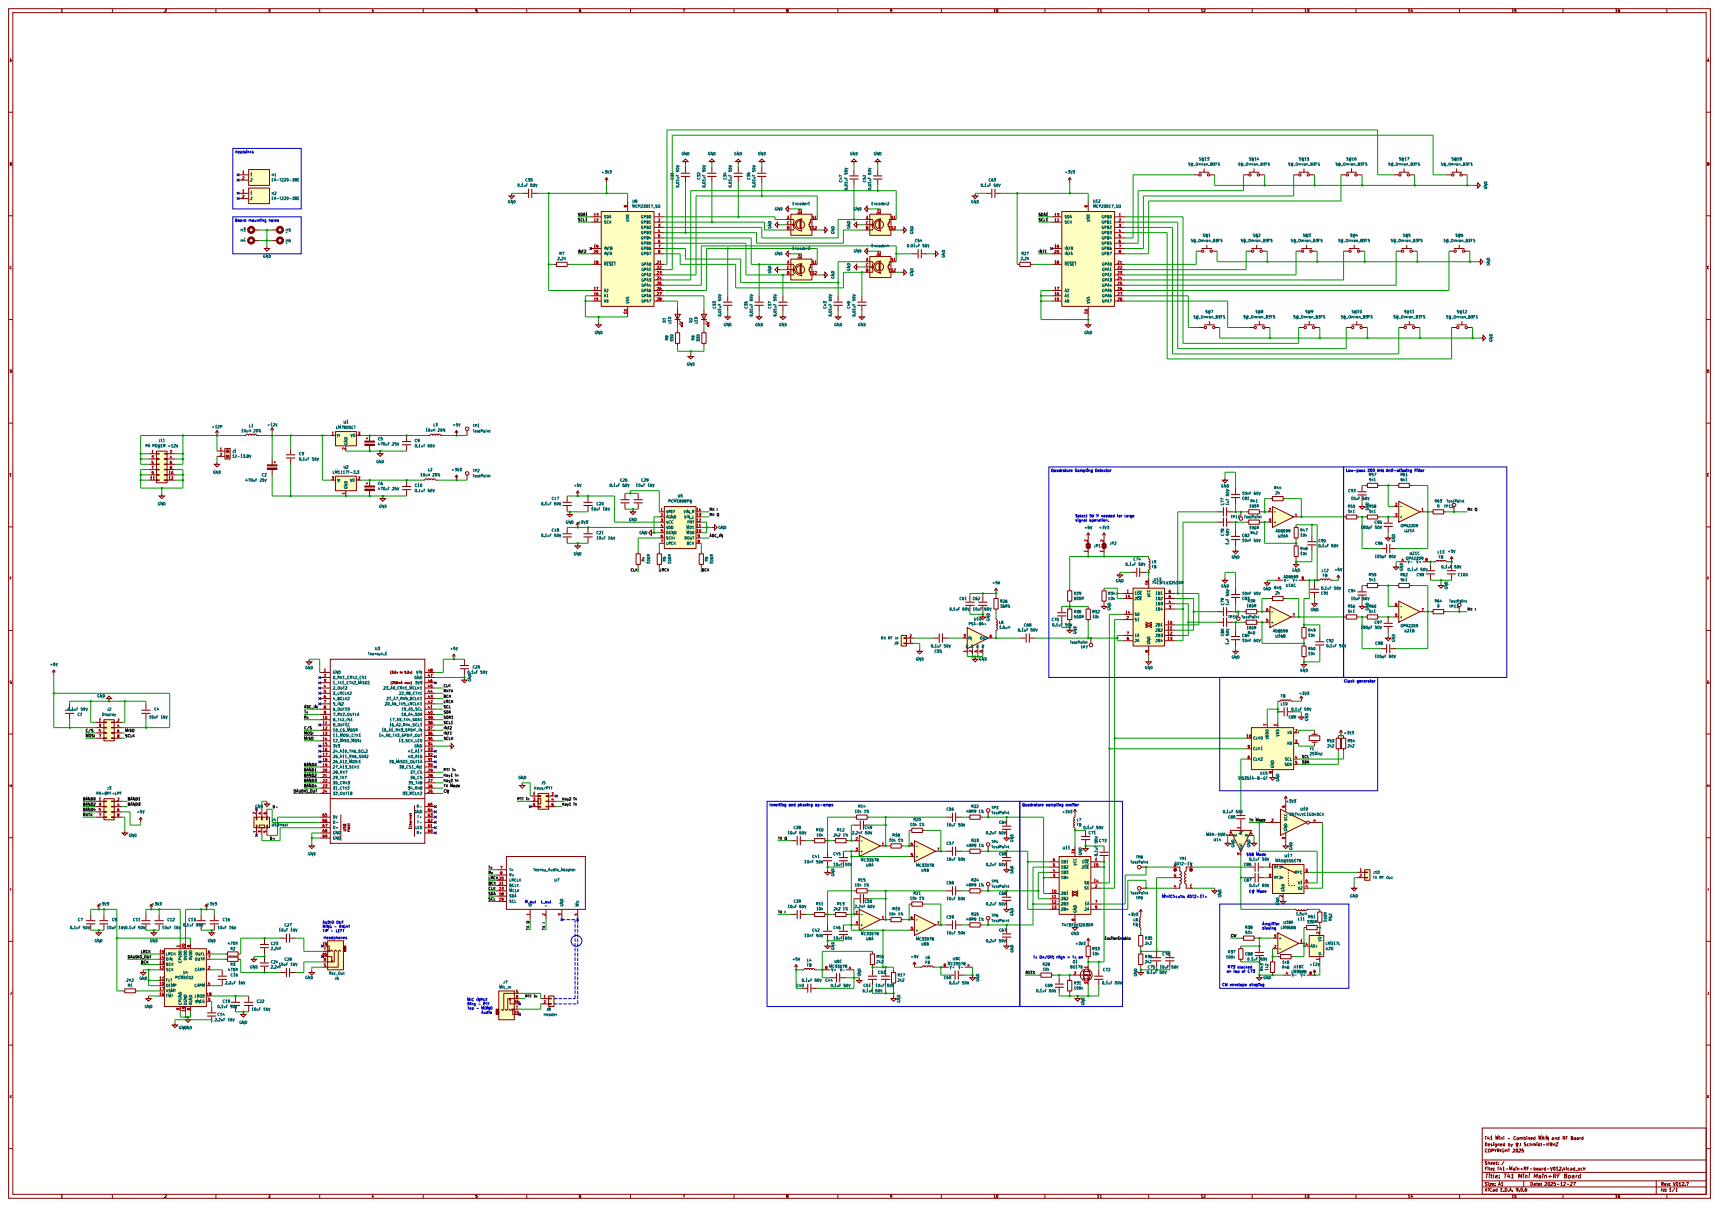
[picture p330: page 1]
