DRWJSCHMIDT/T41/T41_V012_Files/T41_V012_Schematic_PDFs/Front Panel Example By KI3P.pdf

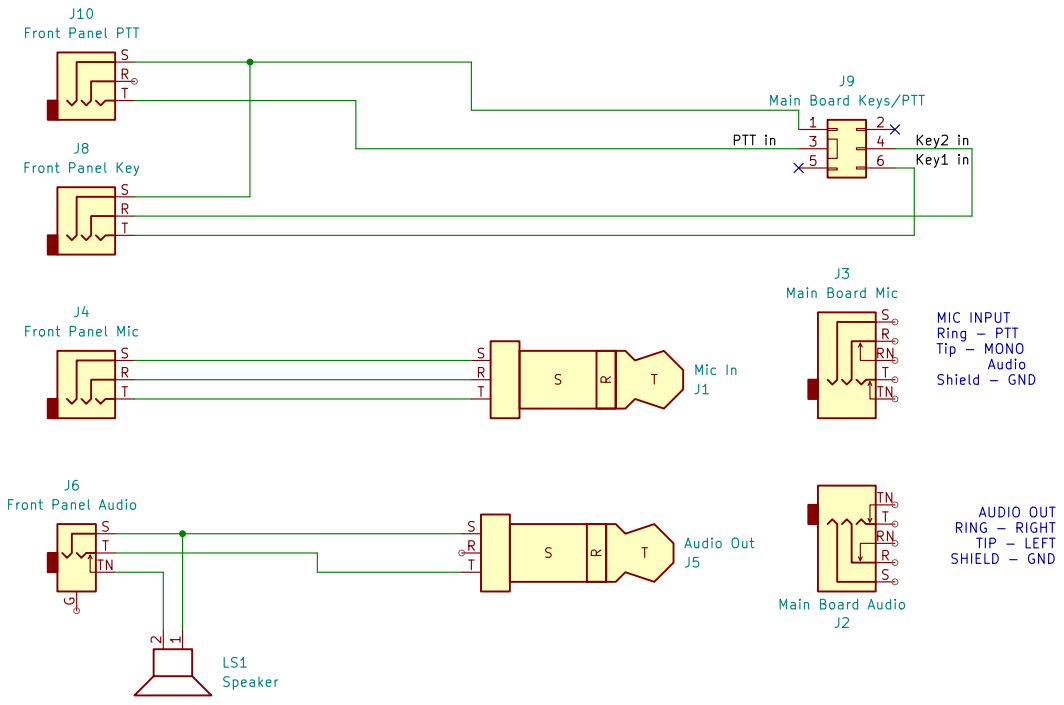
[picture p338: page 1]
