DRWJSCHMIDT/T41/T41_V012_Files/T41_V012_Schematic_PDFs/T41_RF_Board_Schematic_V12.7_020925.pdf

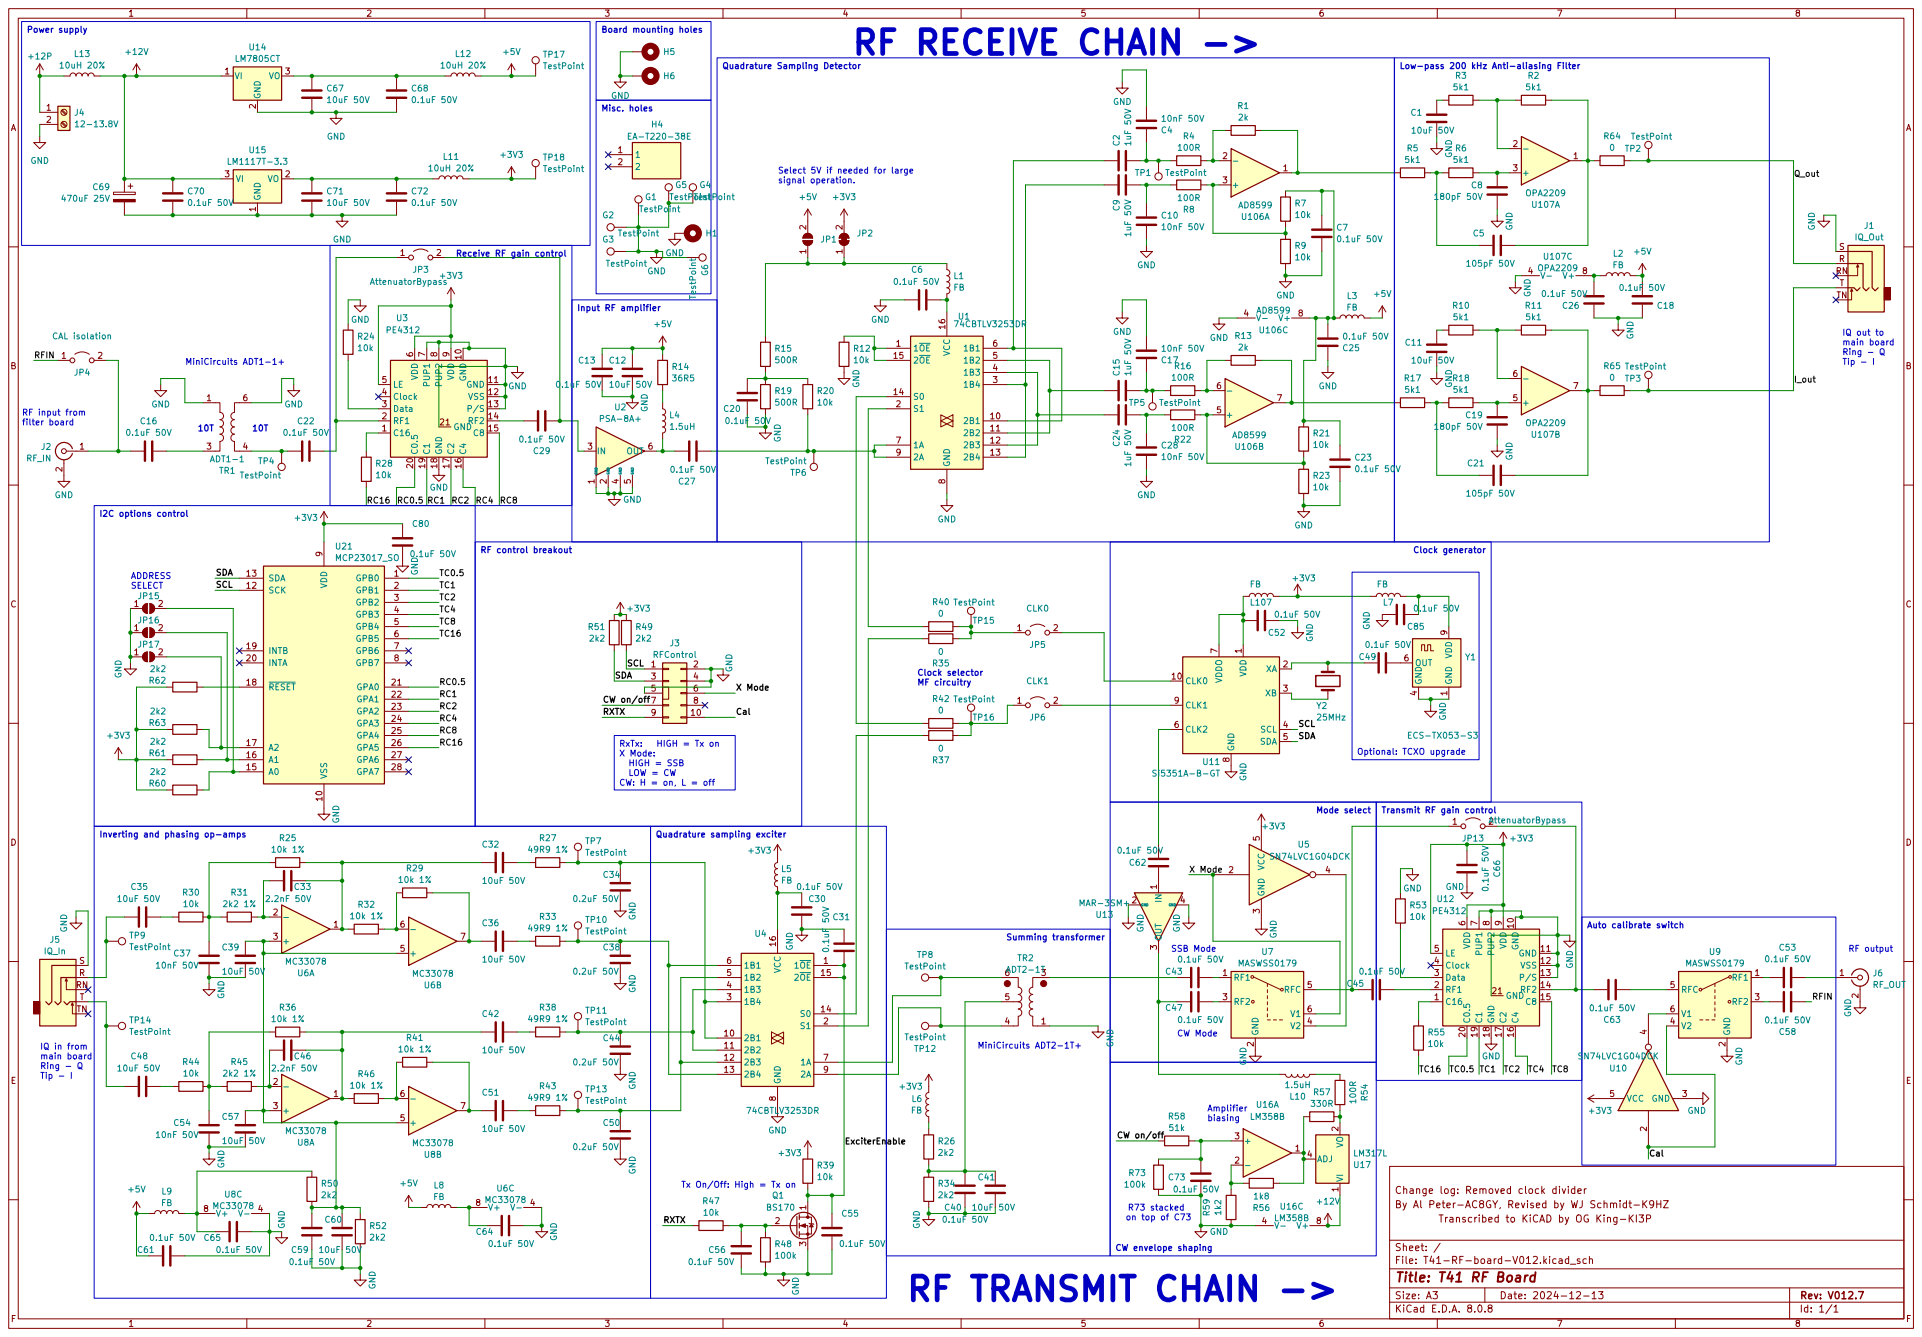
[picture p339: page 1]
