DRWJSCHMIDT/T41/T41_V012_Files/T41_V012_Schematic_PDFs/T41_Display_Adapter_3.3V_Only_V2.00_02-06-25.pdf

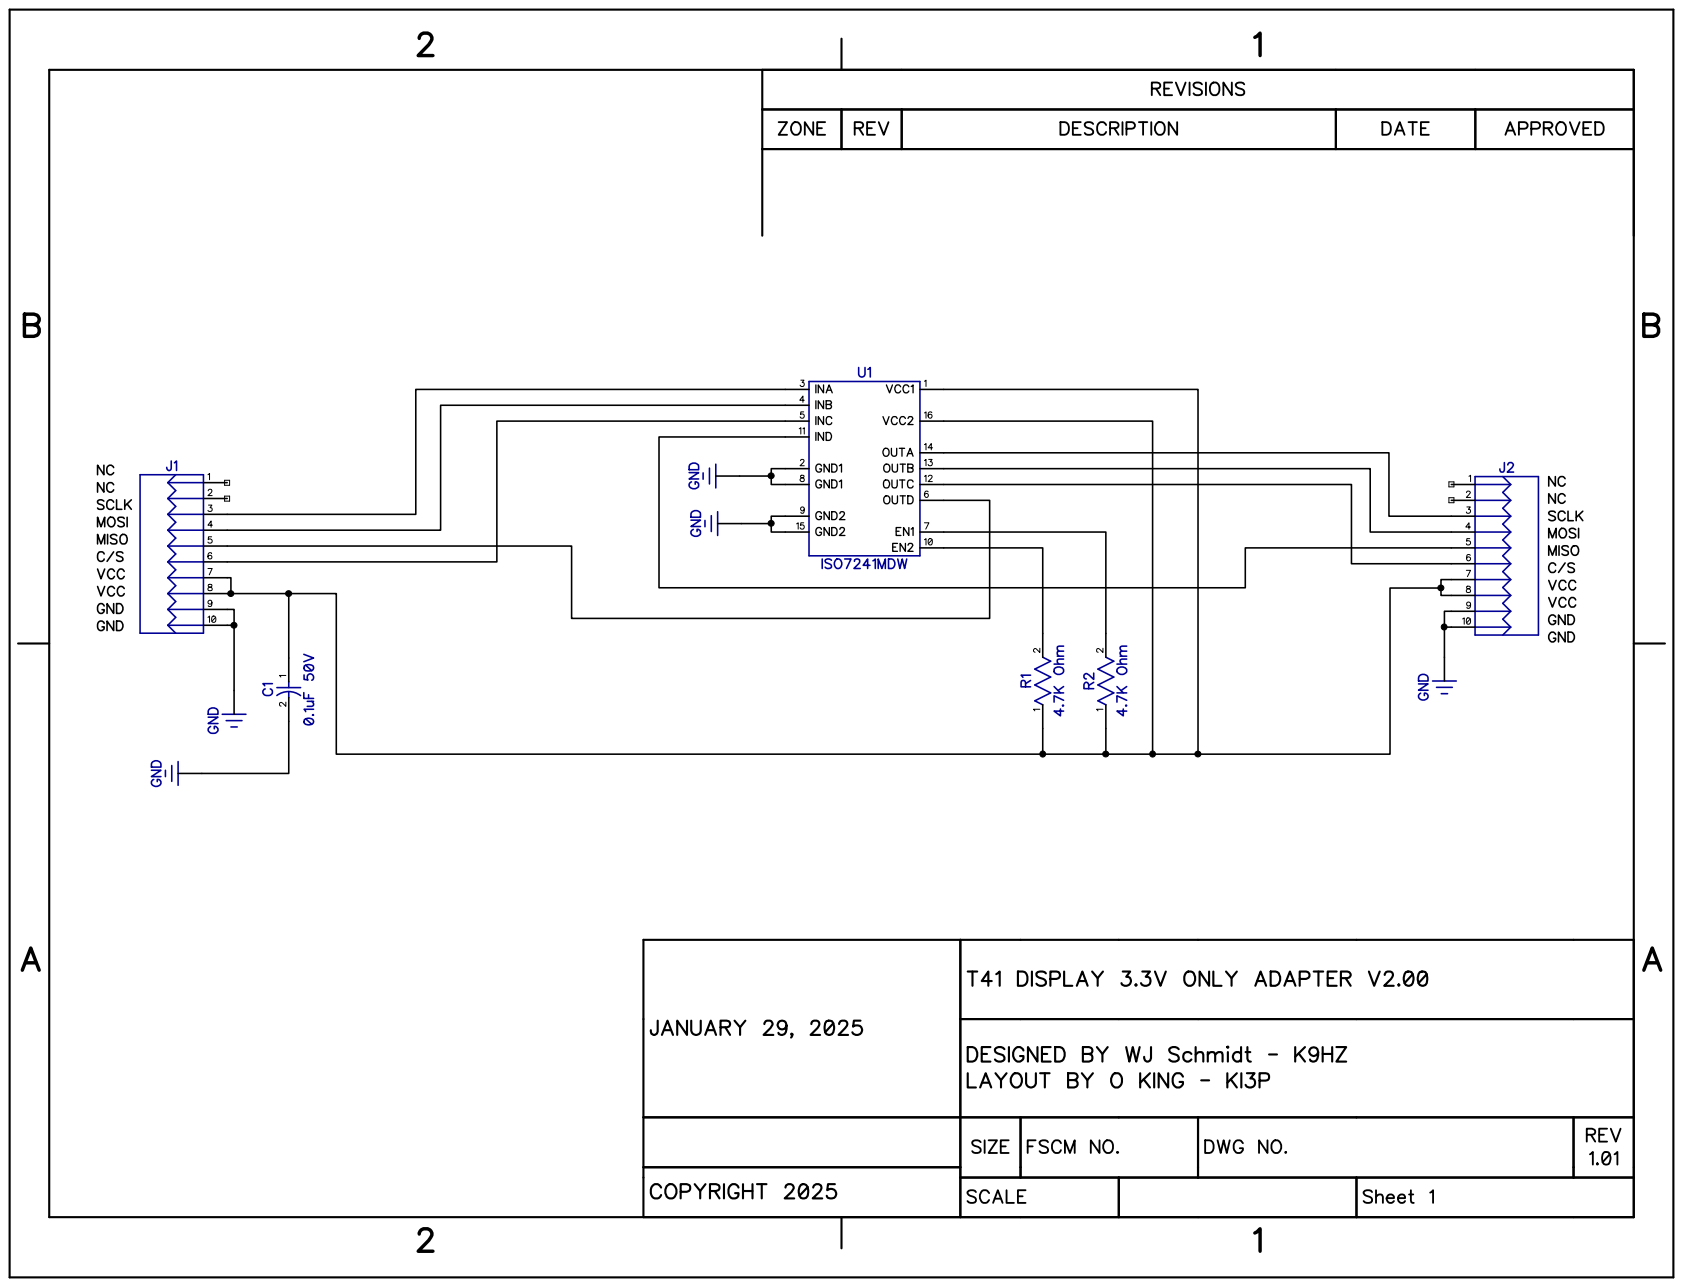
[picture p341: page 1]
