DRWJSCHMIDT/T41/T41_V012_Files/T41_V012_Schematic_PDFs/T41_BPF_Board_V12.6_Schematic-KiCad-08-25-24.pdf

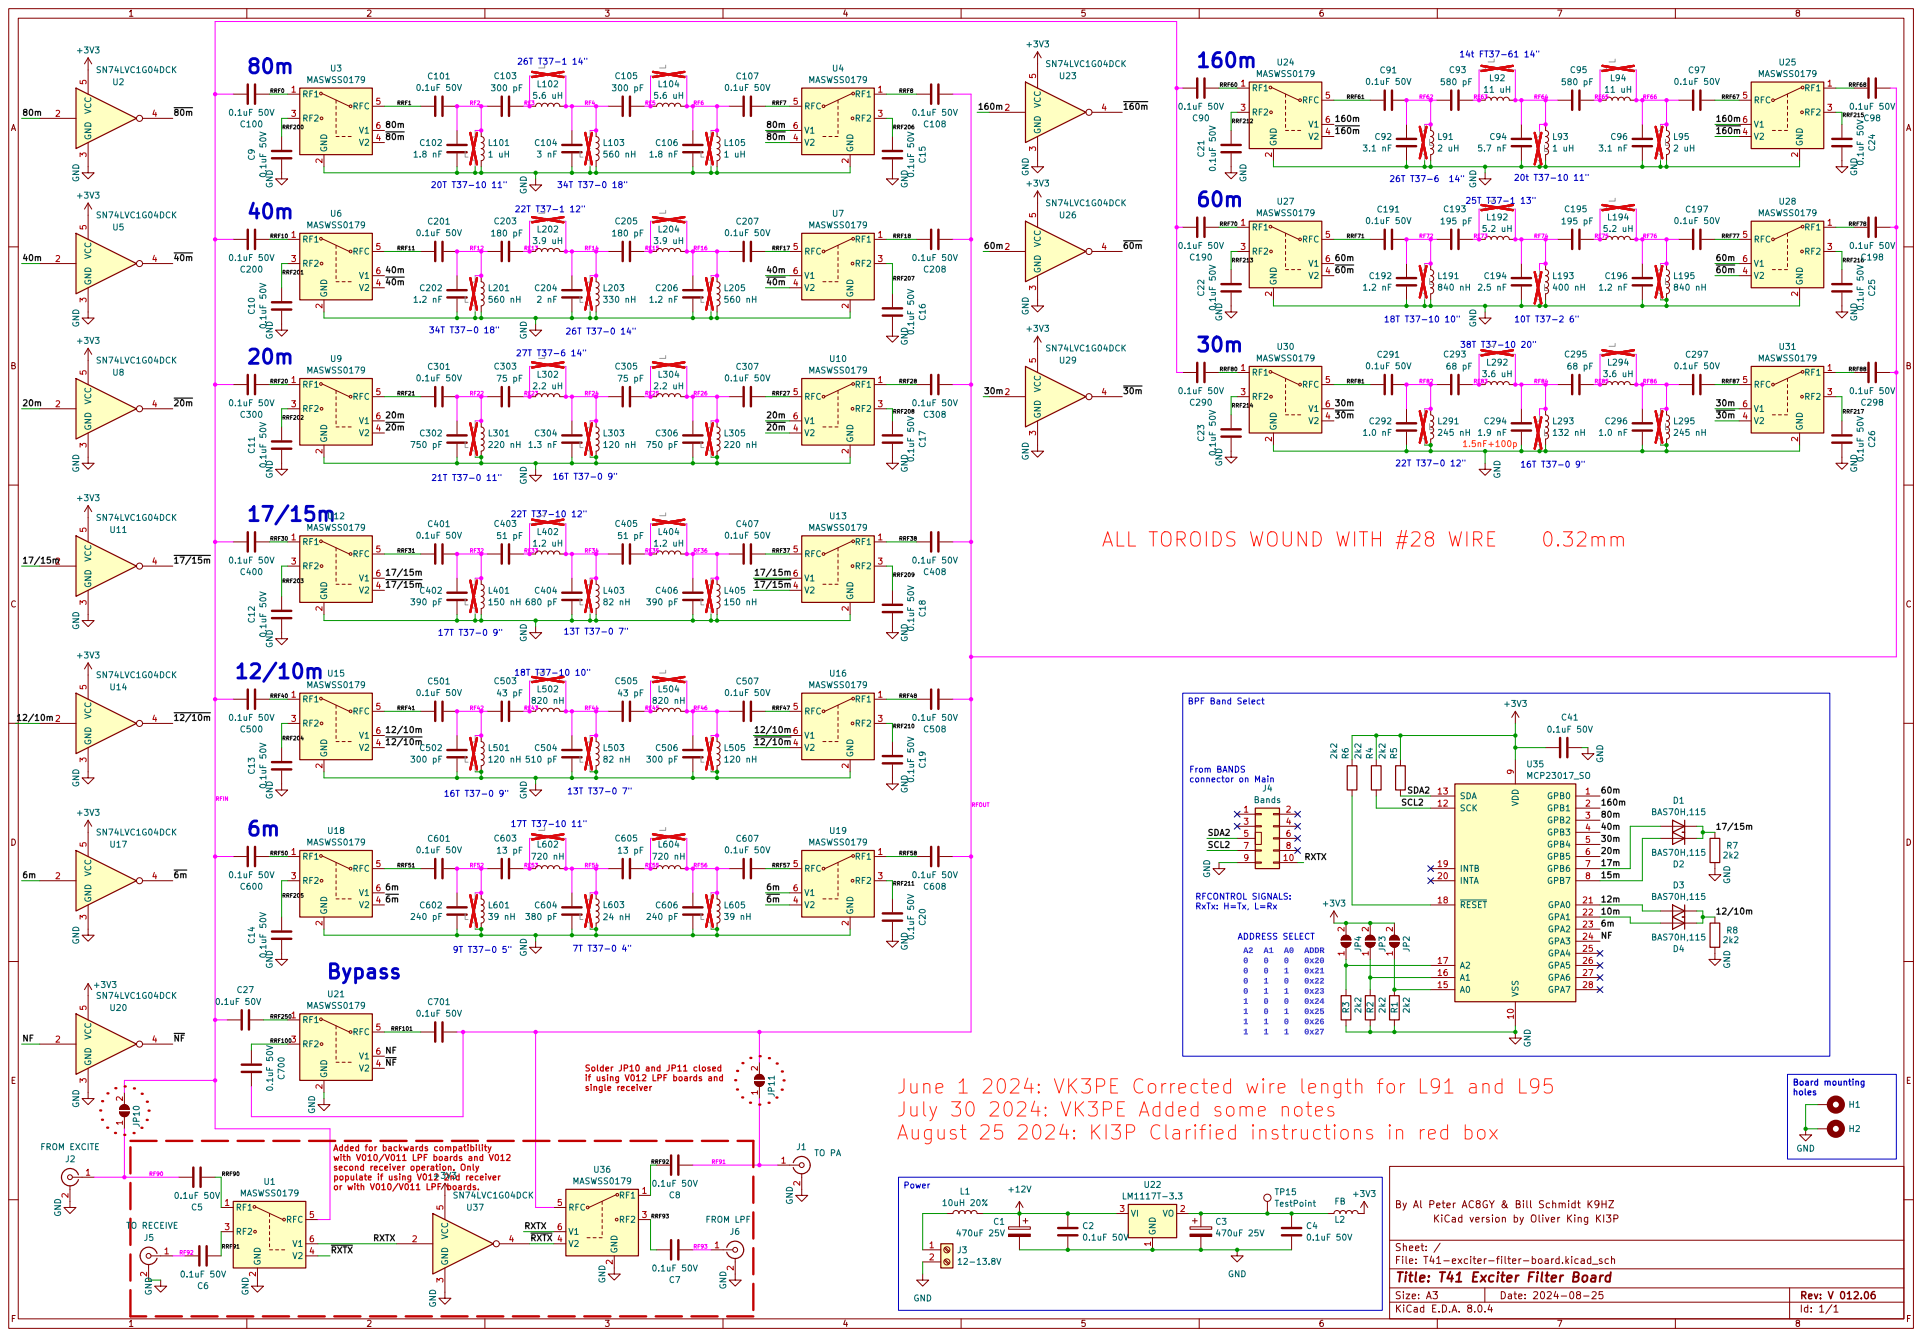
[picture p342: page 1]
