DRWJSCHMIDT/T41/T41_V012_Files_01-15-24/T41_V012_Schematic_PDFs/T41_RF_Board_Schematic_V012.6_09-07-24_KiCad.pdf

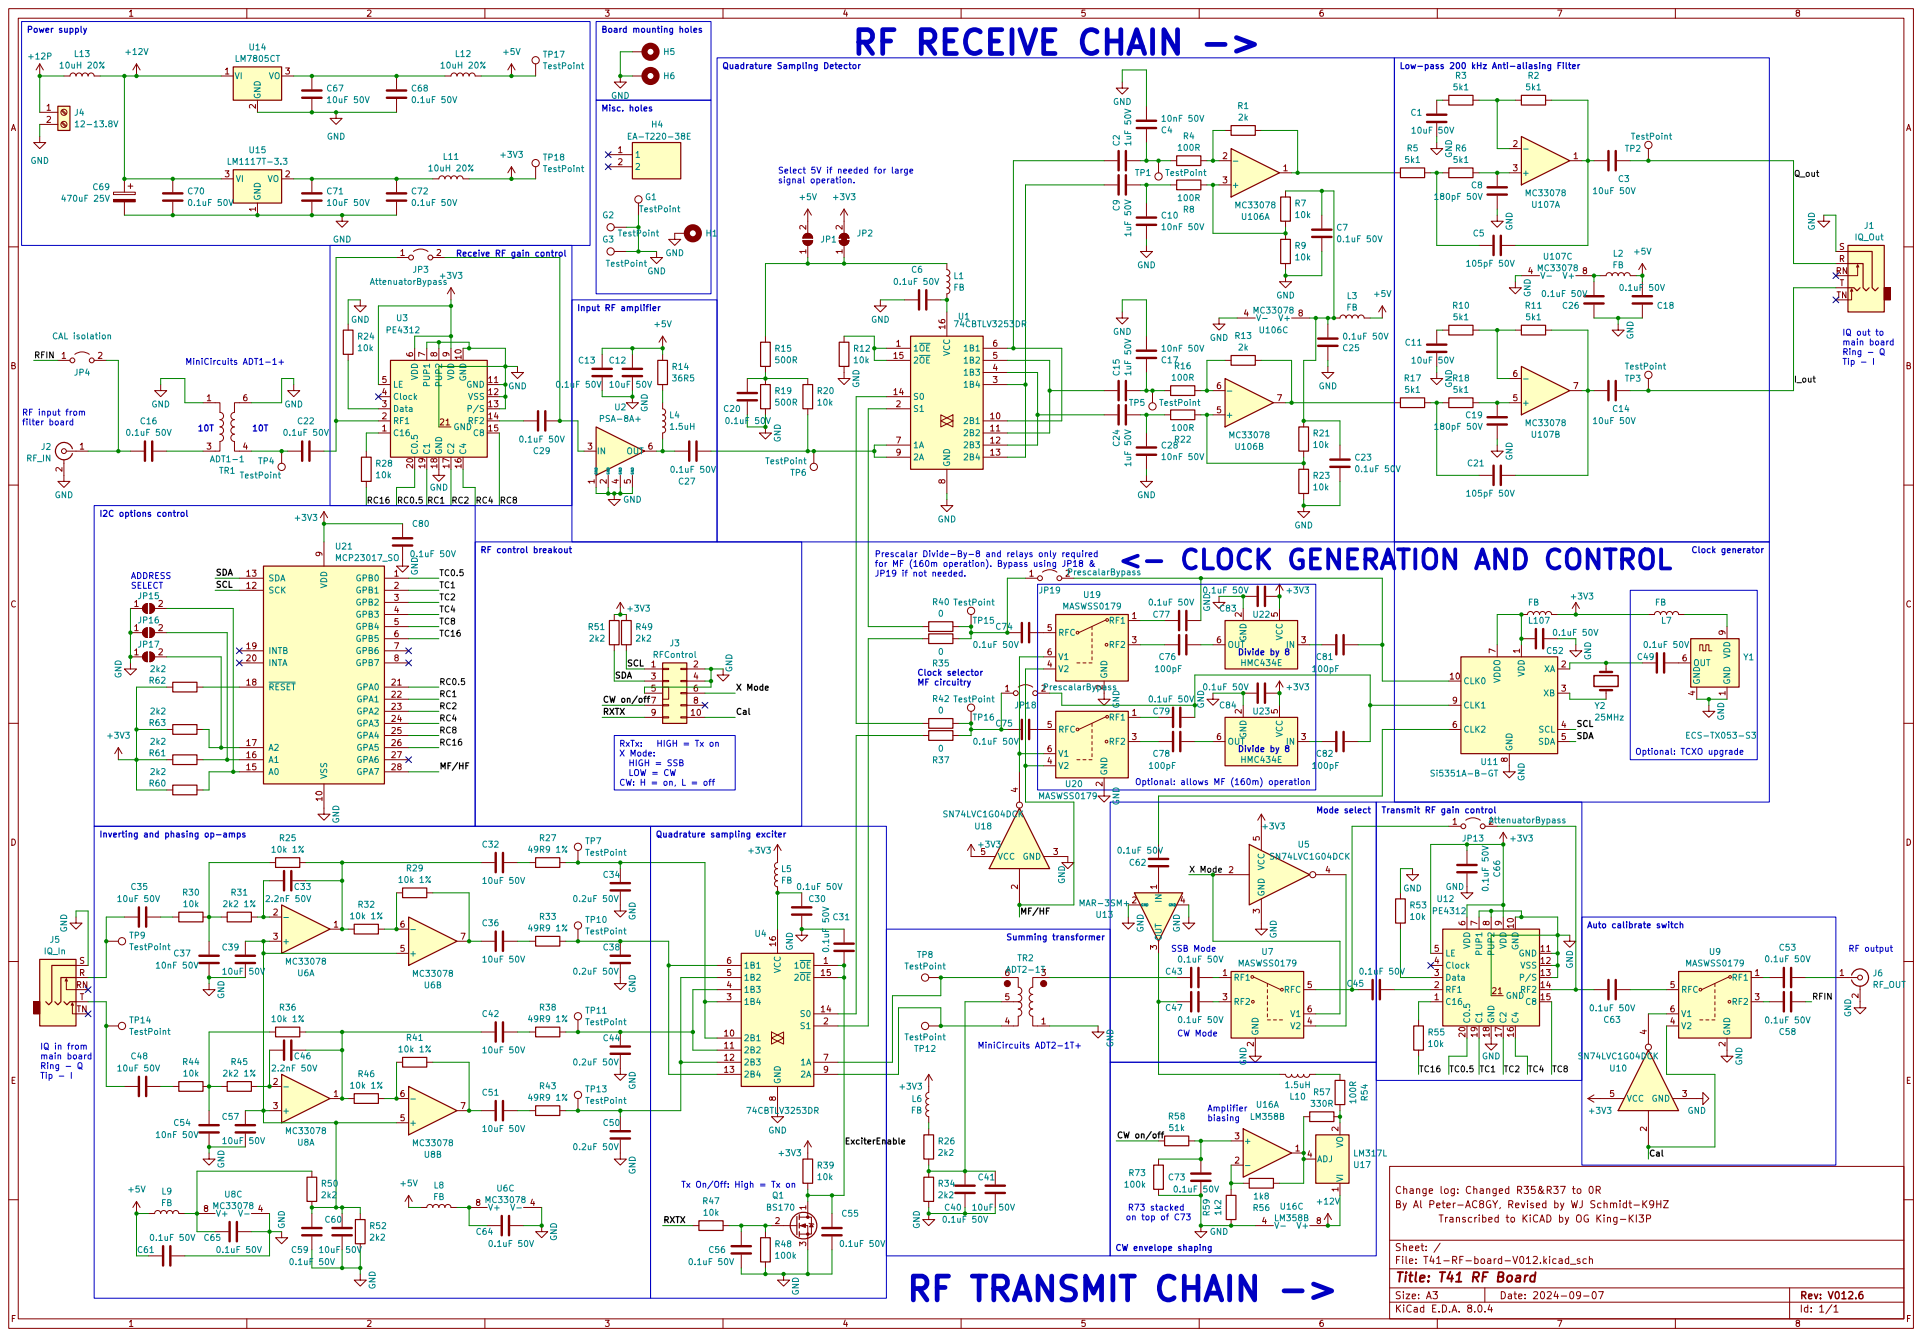
[picture p343: page 1]
