DRWJSCHMIDT/T41/T41_V012_Files_01-15-24/T41_V012_Schematic_PDFs/T41_Display_Adapter_Preliminary_V1.00_07-13-24.pdf

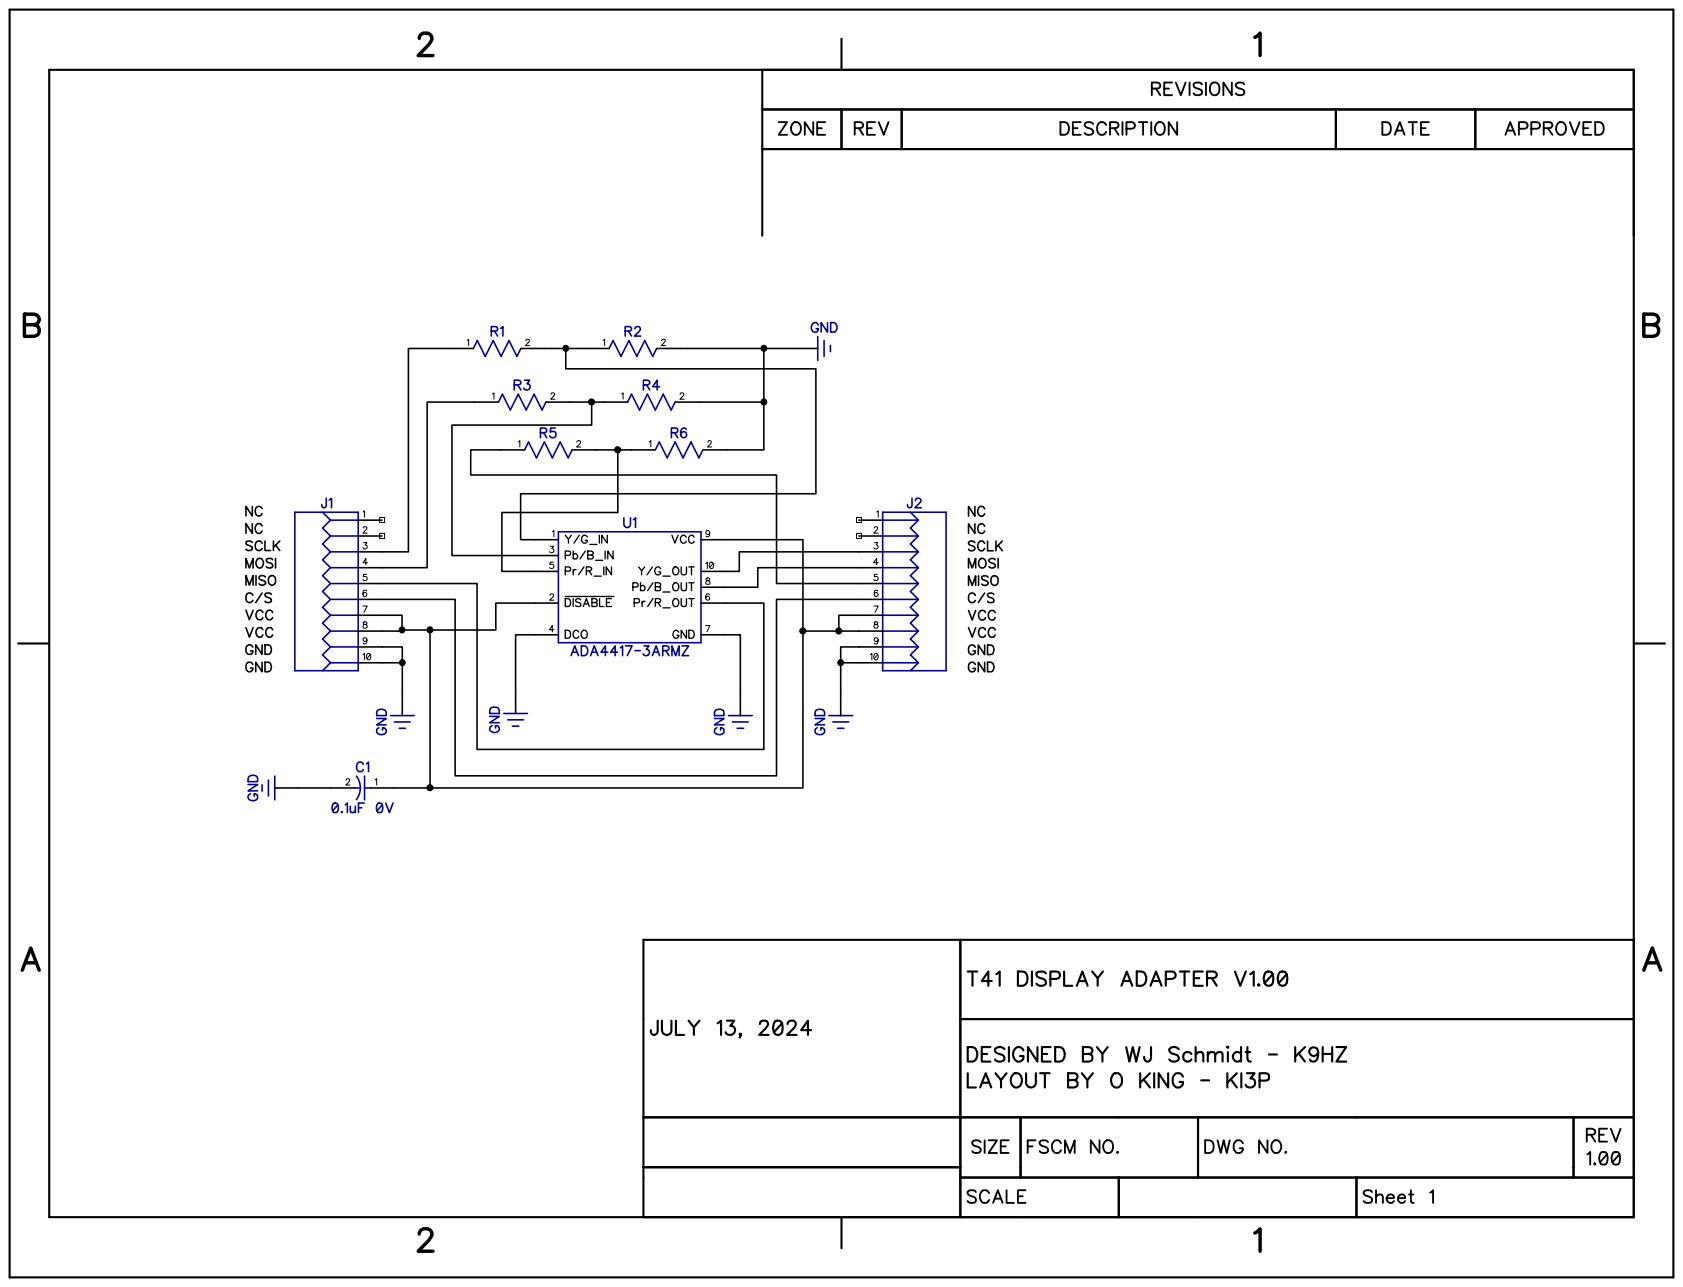
[picture p345: page 1]
