DRWJSCHMIDT/T41/T41_V012_Files/T41_V012_PCB_Mechanical_Drawings/K9HZ_Teensy Hat_Offset_Board_Dimensions_Top_V012.6_06-10-24.pdf

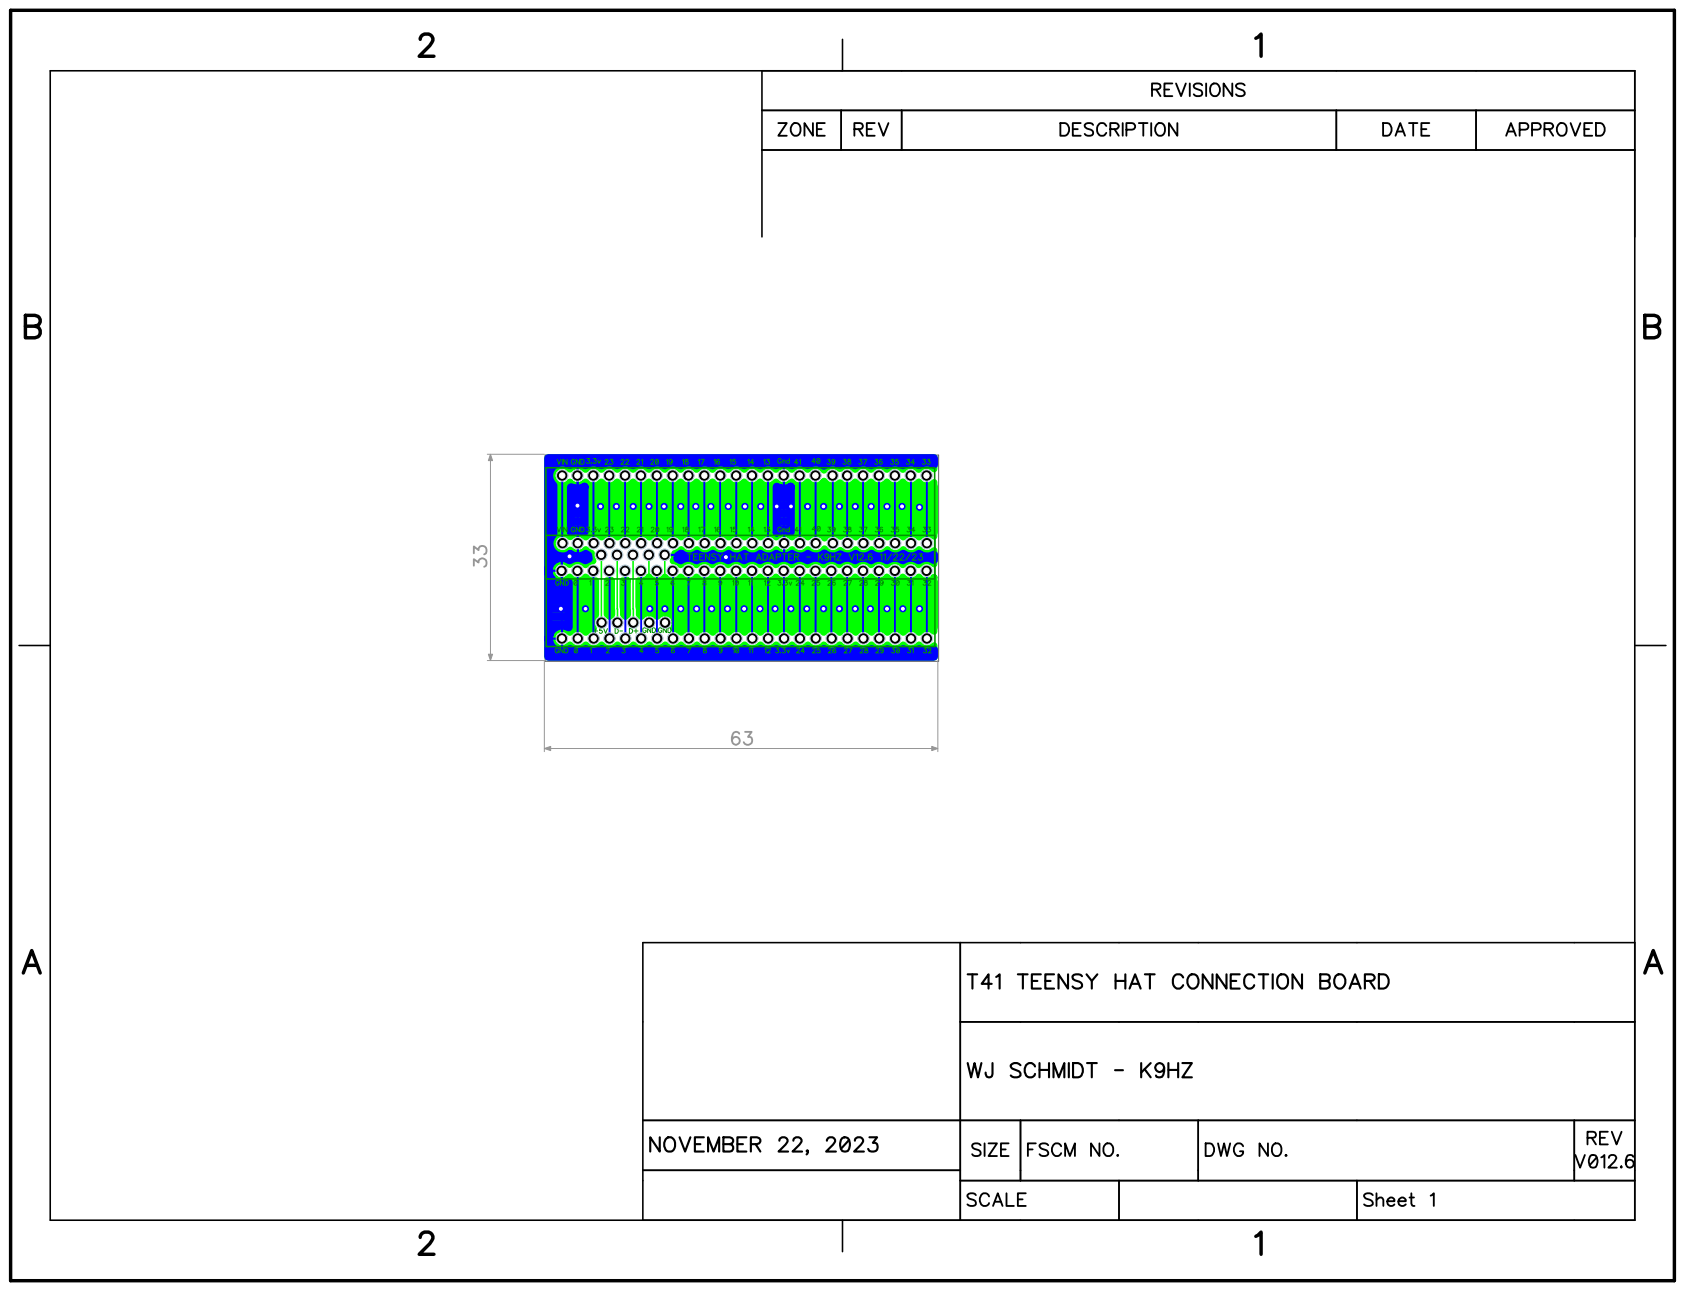
[picture p346: page 1]
