DRWJSCHMIDT/T41/T41_V012_Files/T41_V012_PCB_Mechanical_Drawings/T41-BPF-Board-V012_Dimensions_06-07-24.pdf

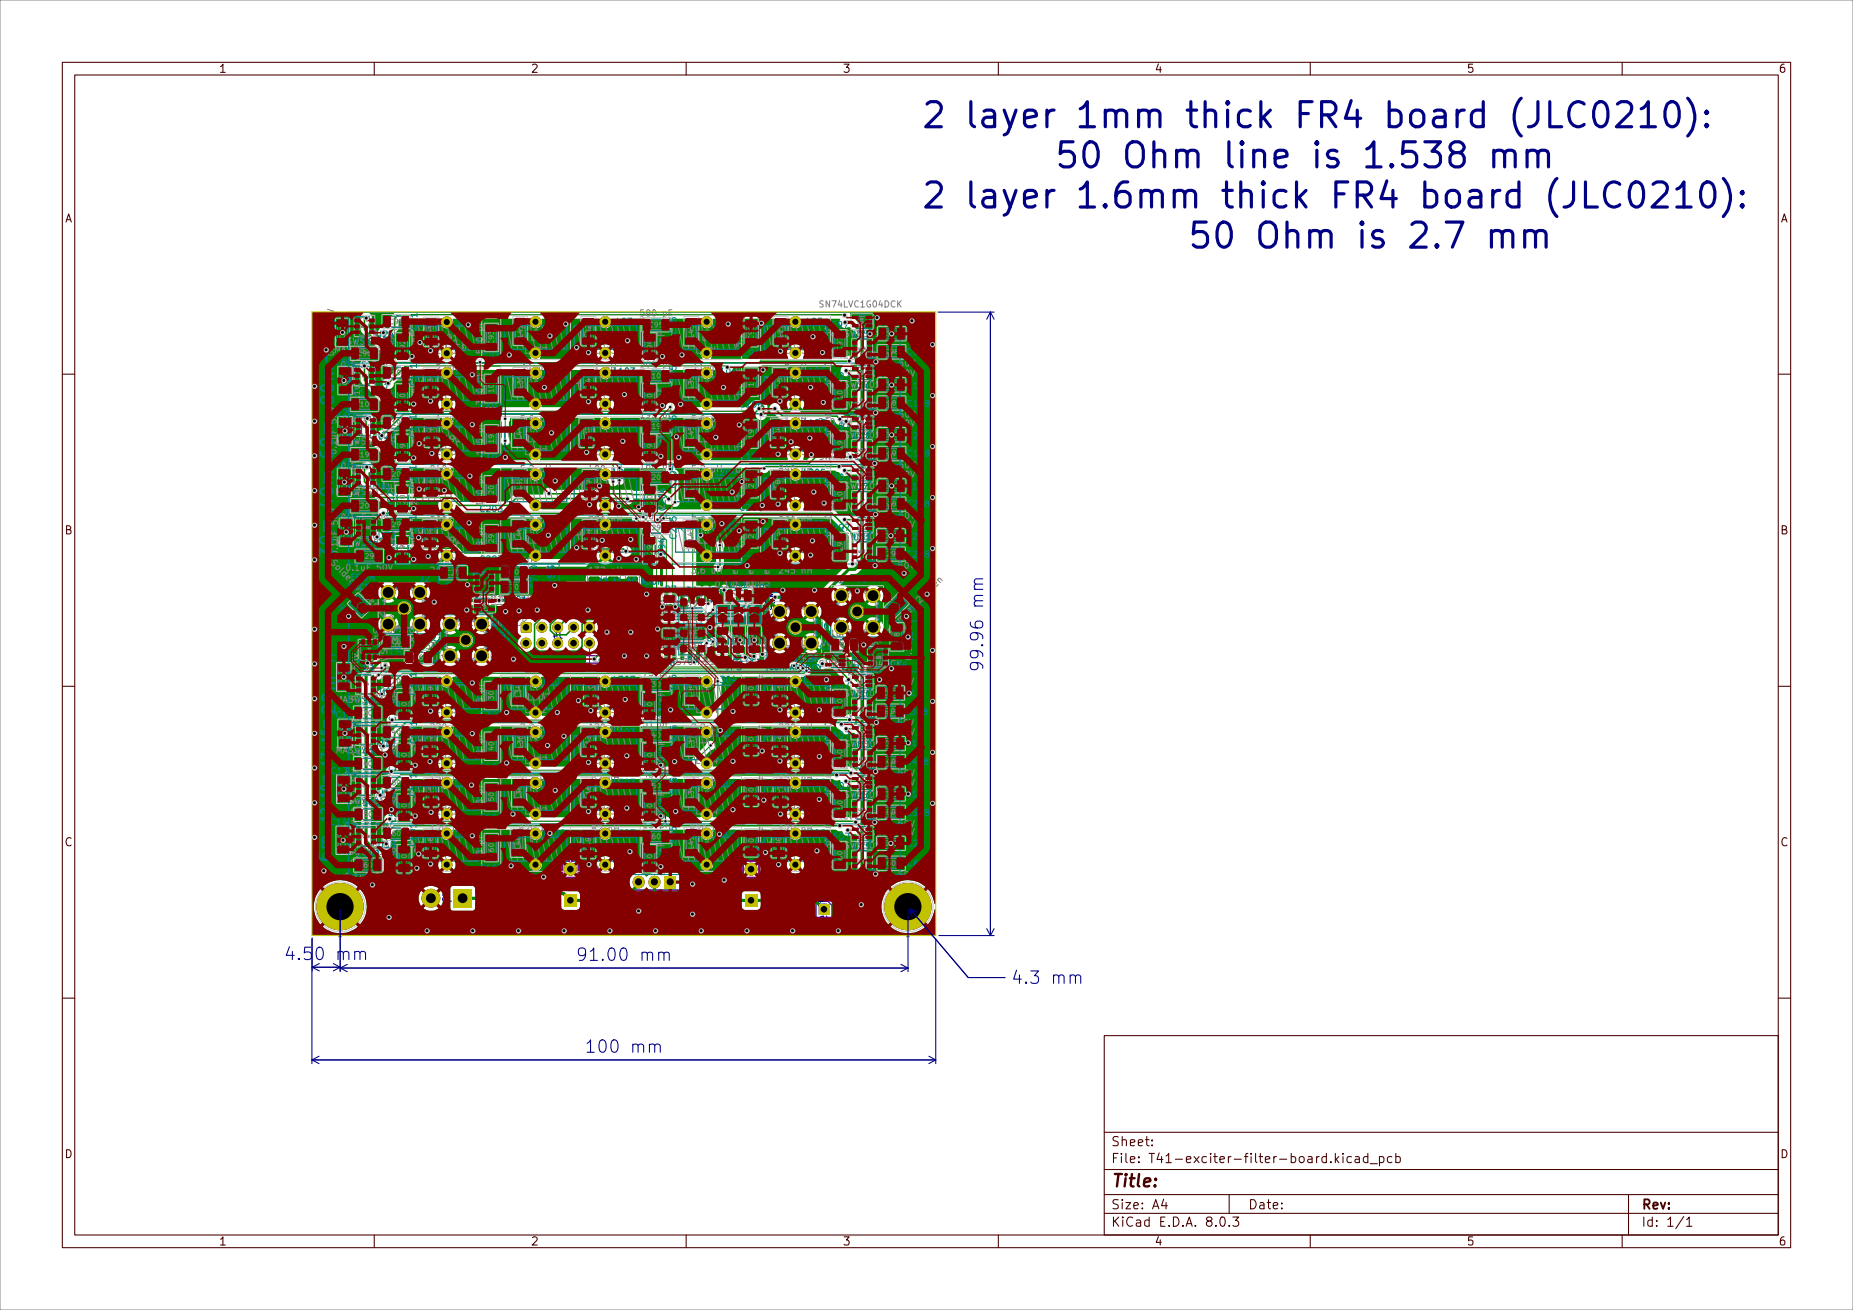
[picture p347: page 1]
