DRWJSCHMIDT/T41/T41_V012_Files/T41_V012_Schematic_PDFs/T41_Main_Board_Schematic_V012.6_04-26-24_KiCad.pdf

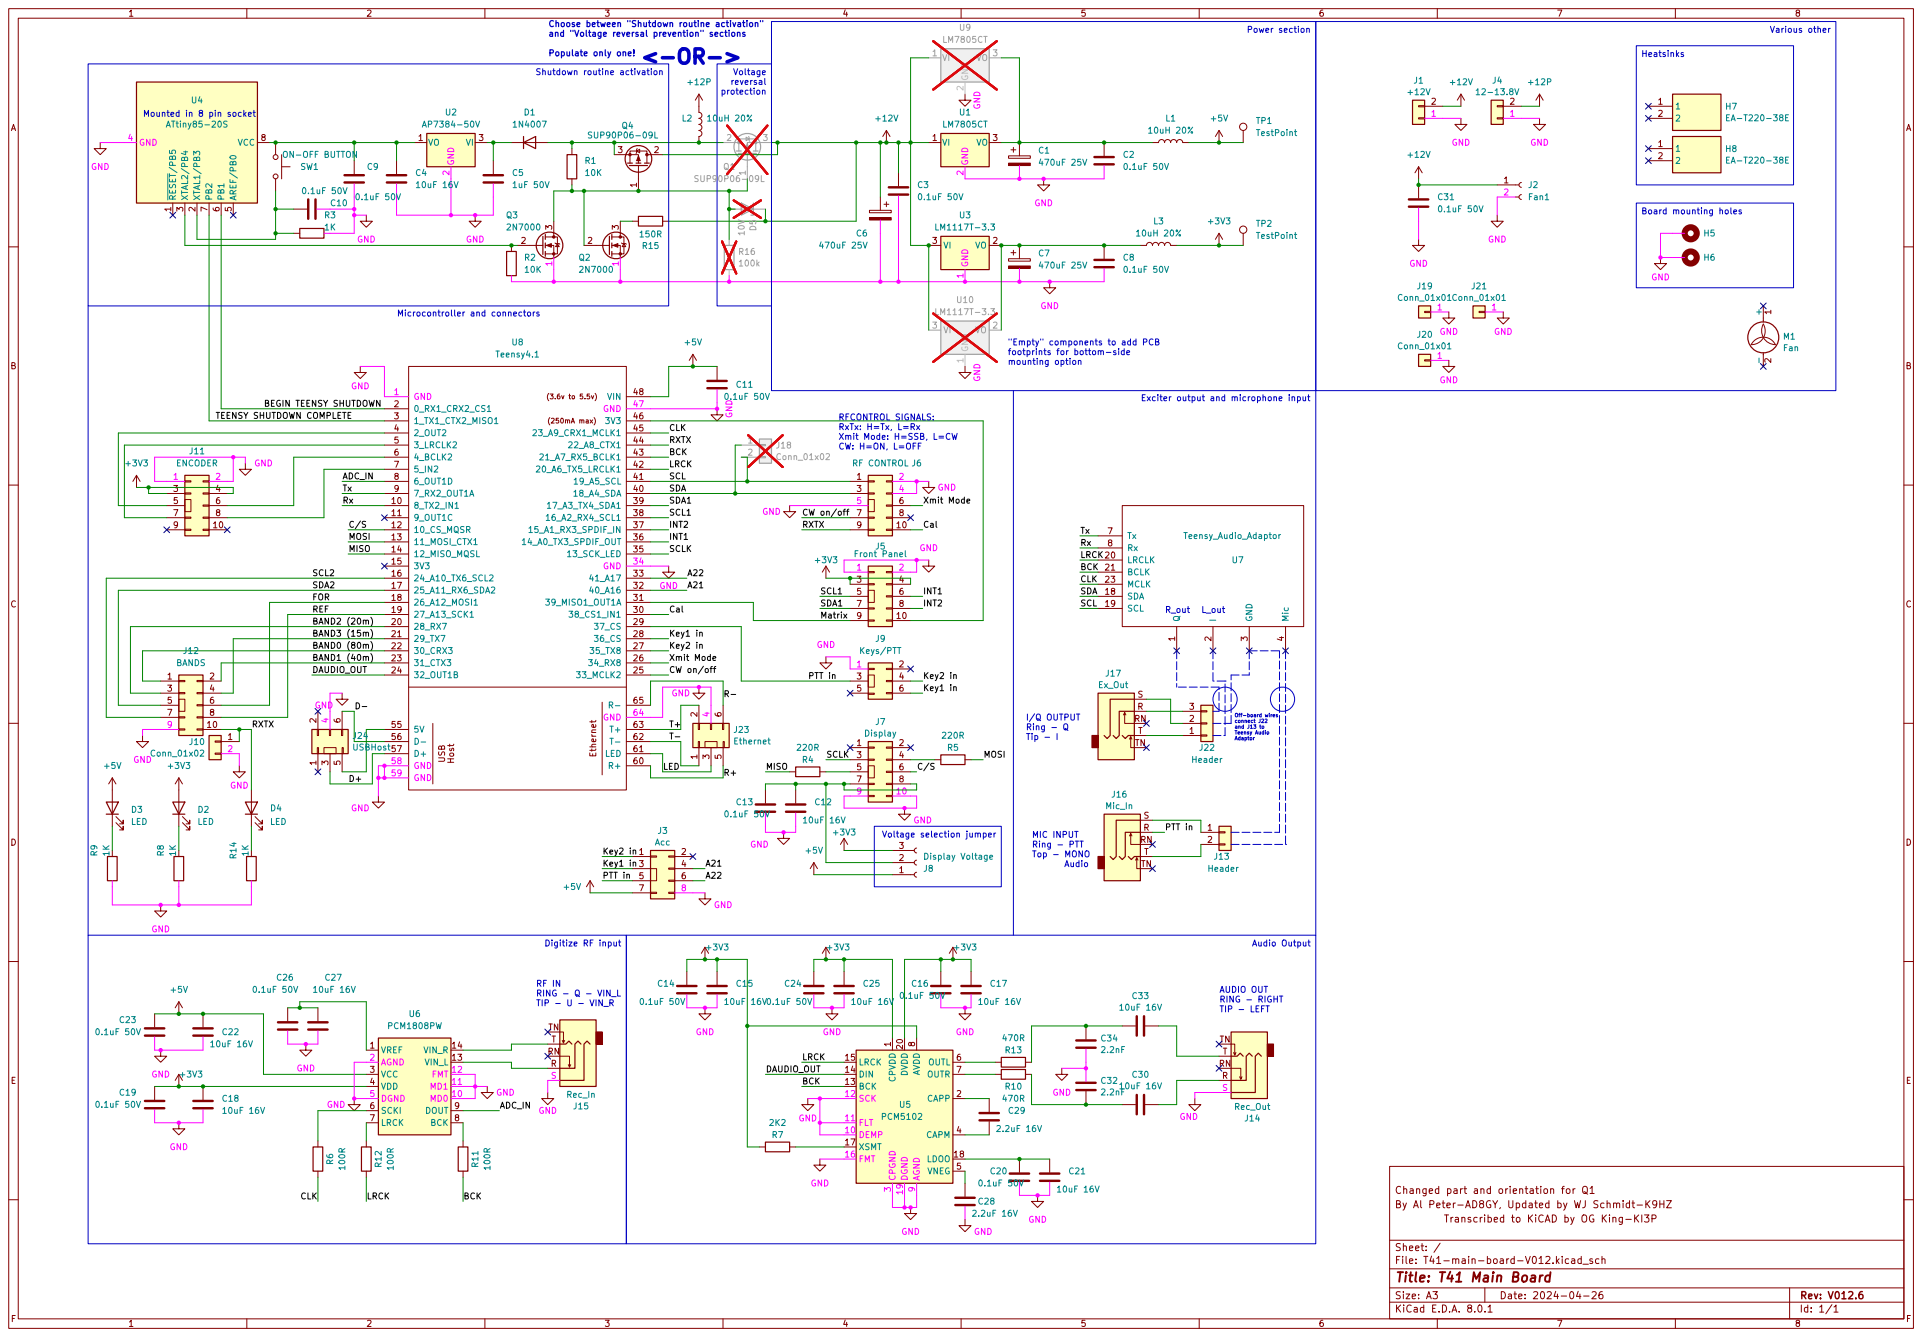
[picture p351: page 1]
