DRWJSCHMIDT/T41/T41_V012_Files/T41_V012_Schematic_PDFs/T41_Second_RX_Adapter_Board_Schematic_V12.6_KiCad_041424.pdf

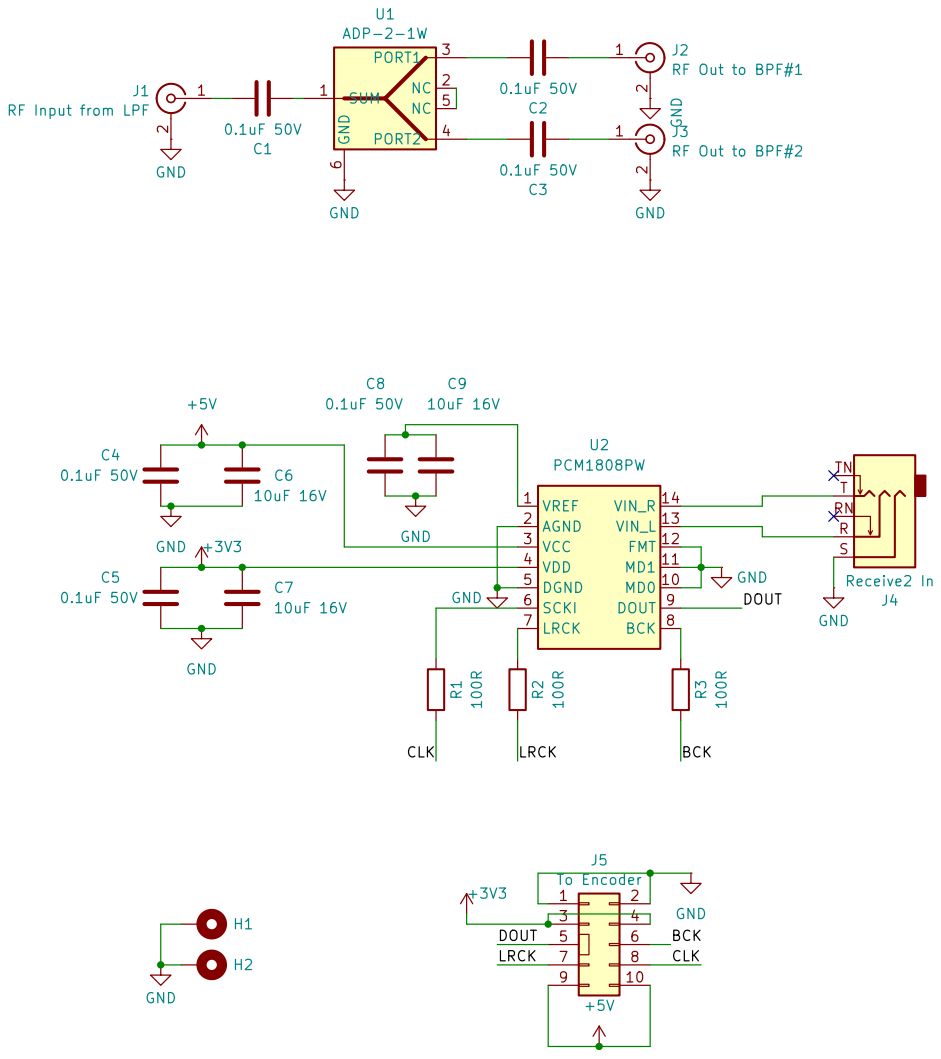
[picture p352: page 1]
