DRWJSCHMIDT/T41/T41_V012_Files_01-15-24/T41_V012_Schematic_PDFs/T41_Second_RX_Adapter_Board_Schematic_V12.6_041424.pdf

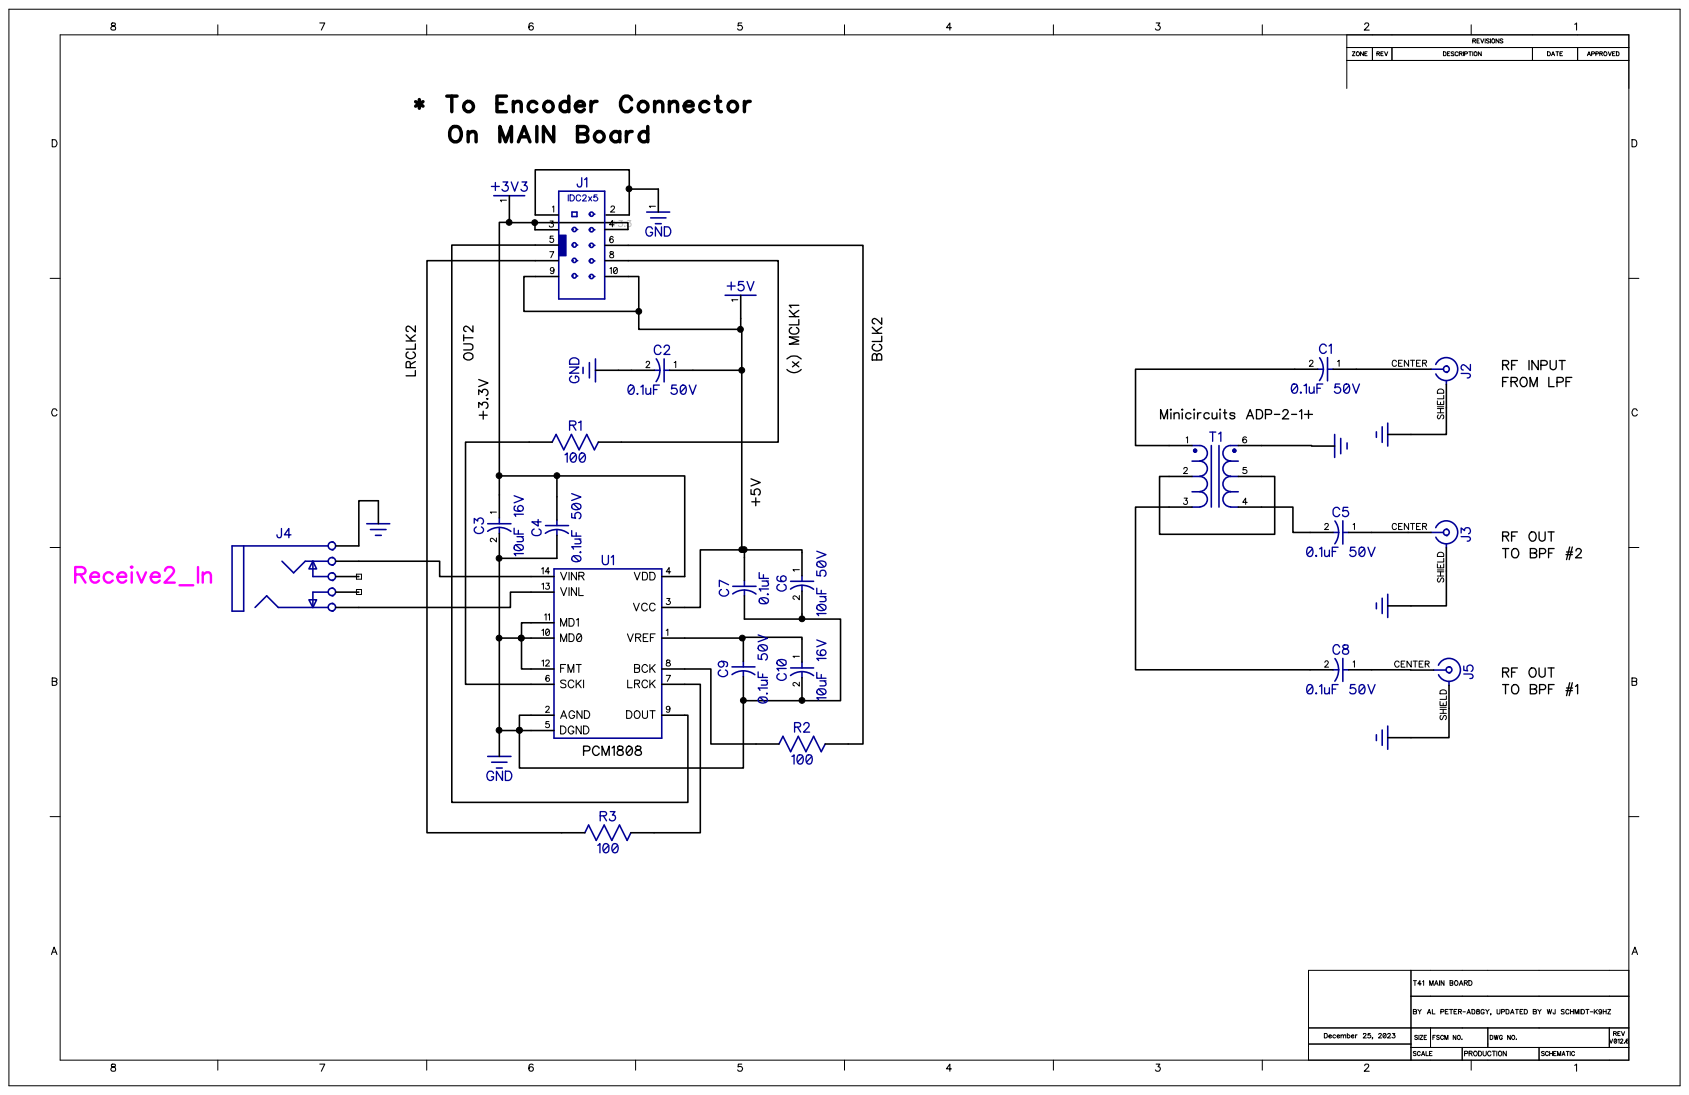
[picture p353: page 1]
