DRWJSCHMIDT/T41/T41_V012_Files_01-15-24/T41_V012_Schematic_PDFs/T41_RF_Board_Schematic_V012.6_04-08-24_KiCad.pdf

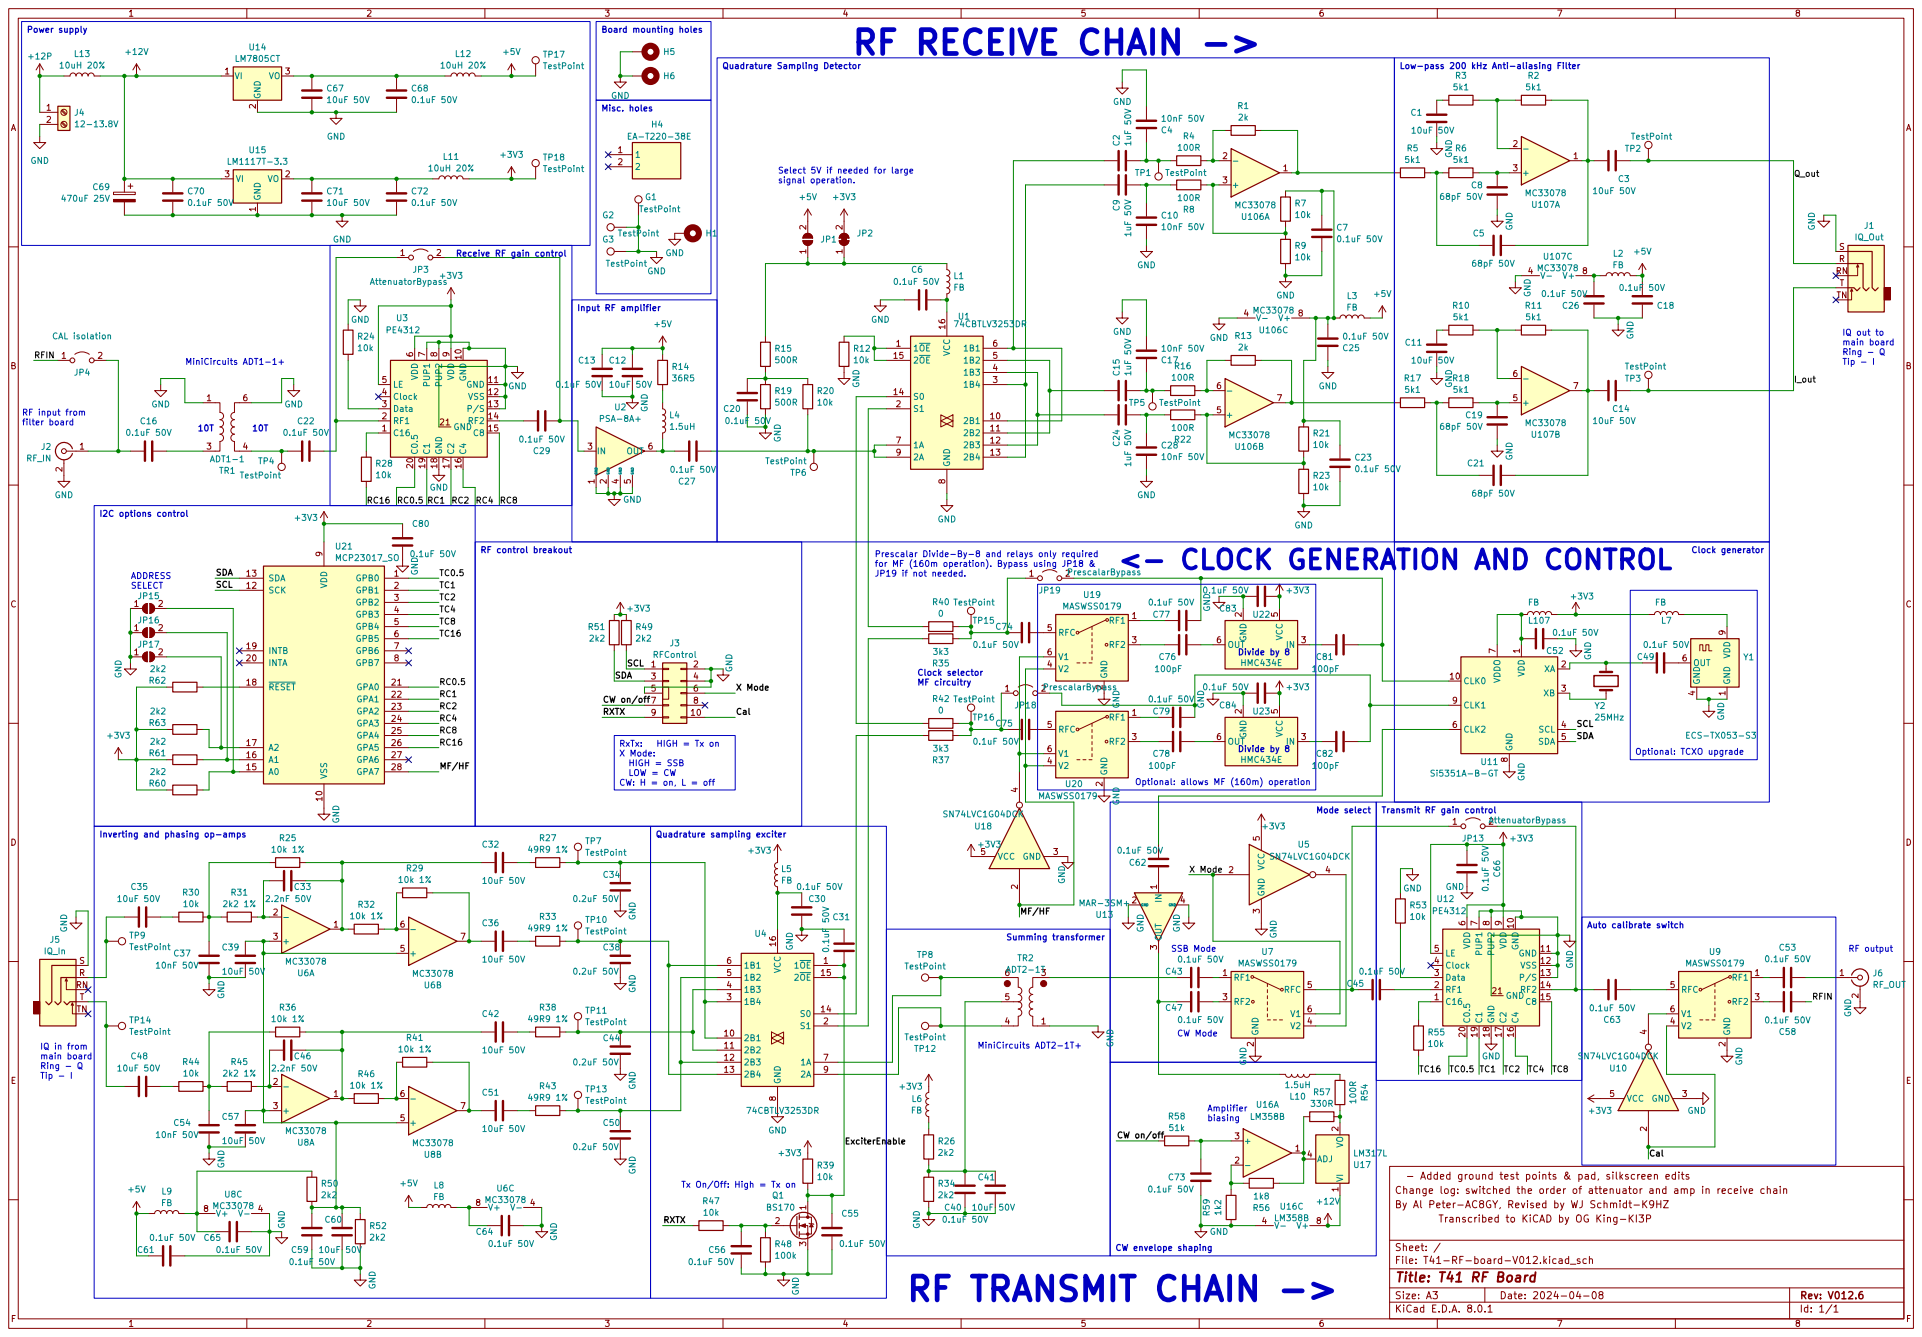
[picture p354: page 1]
