DRWJSCHMIDT/T41/T41_V012_Files_01-15-24/T41_V012_Schematic_PDFs/T41_BPF_Board_V12.6_Schematic-KiCad-03-09-24.pdf

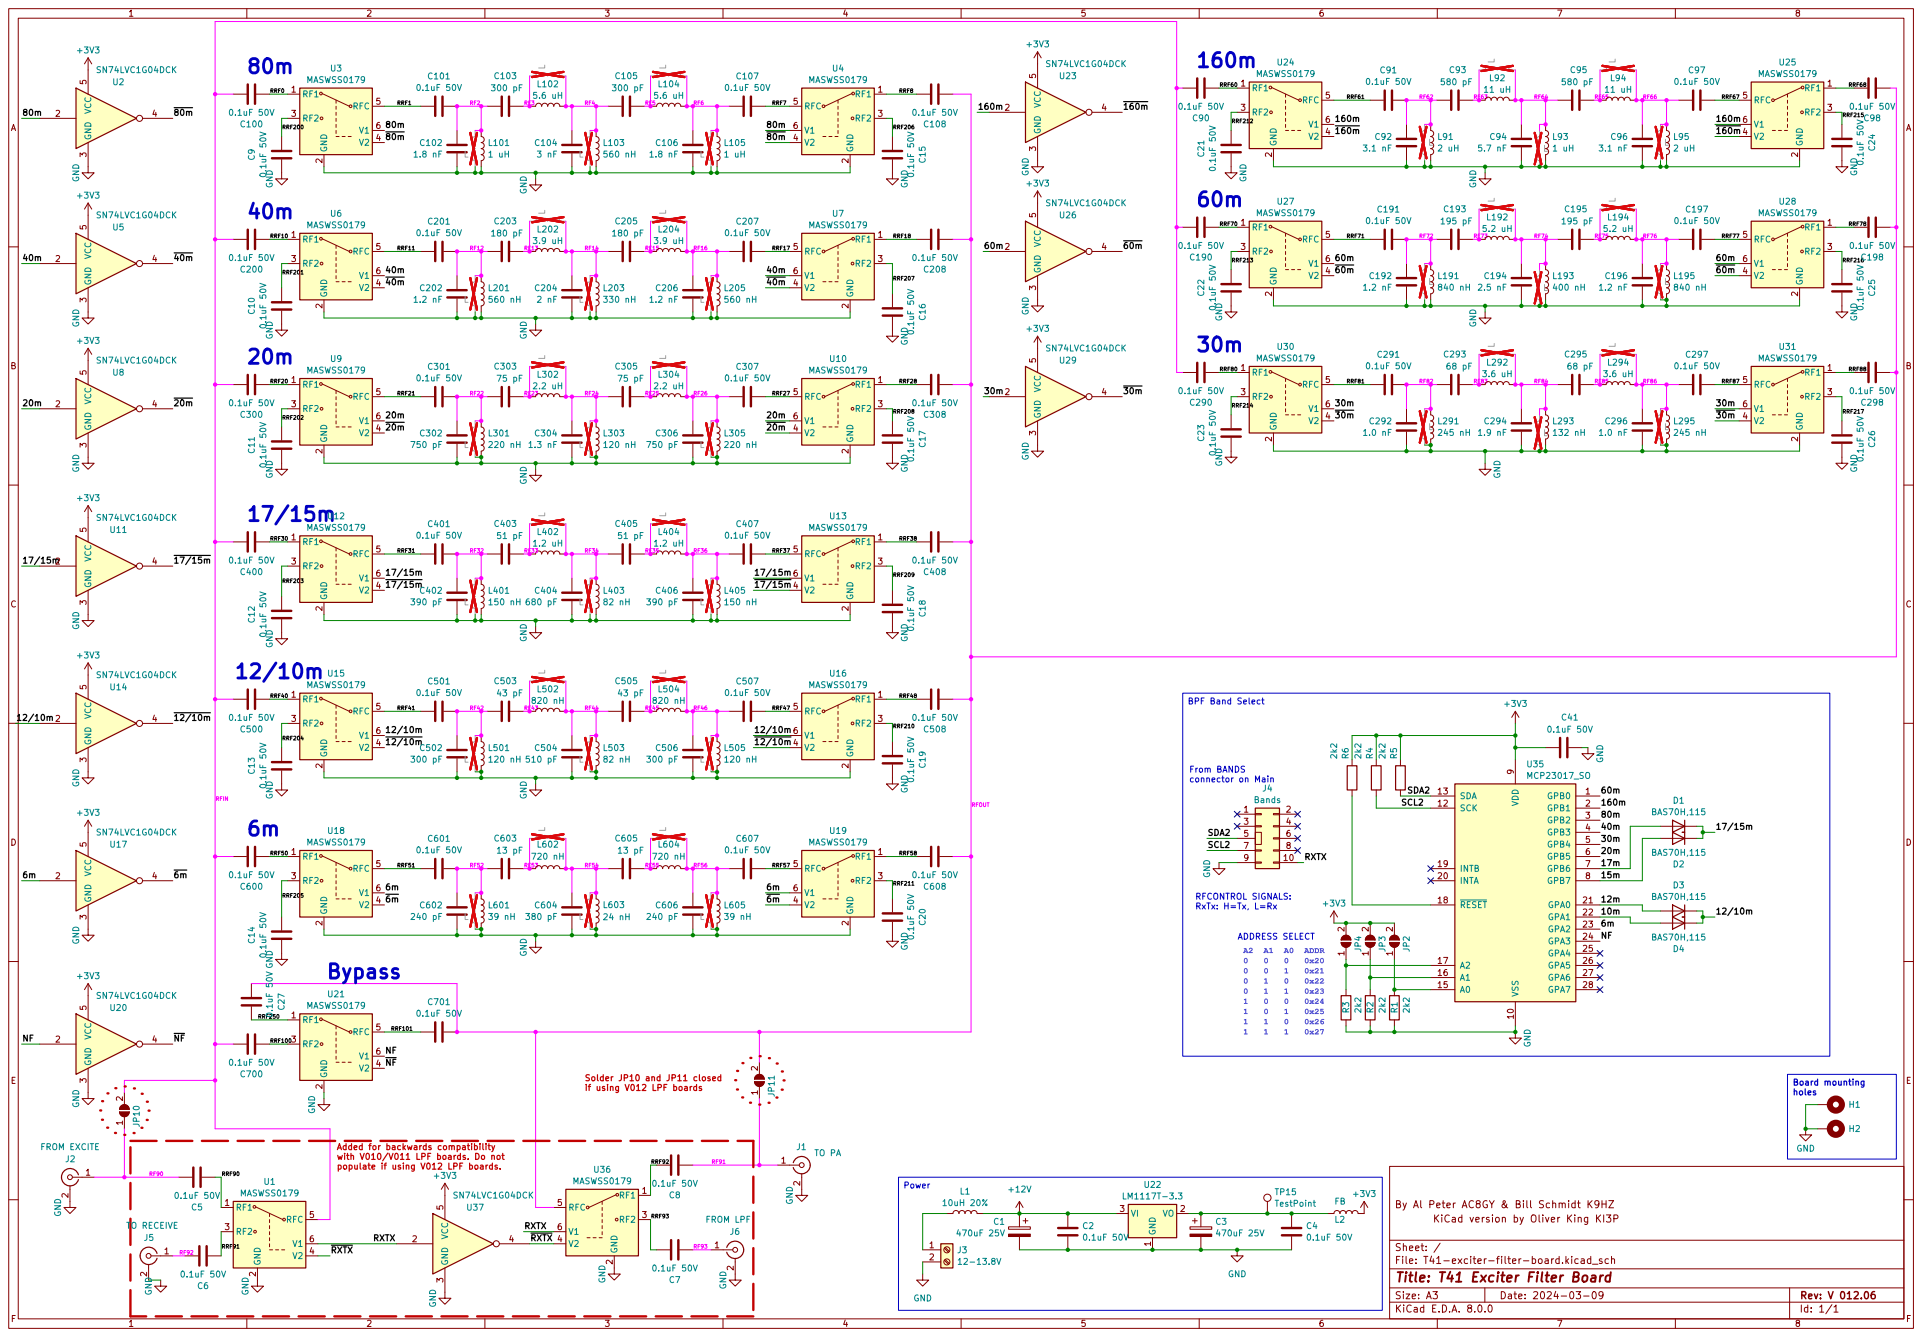
[picture p355: page 1]
