DRWJSCHMIDT/T41/K9HZ_LPF_Module/K9HZ_LPF_V1.00_Schematic_PDFs/K9HZ_LPF-Board_Schematic_V1.00_01-04-24_DipTrace.pdf

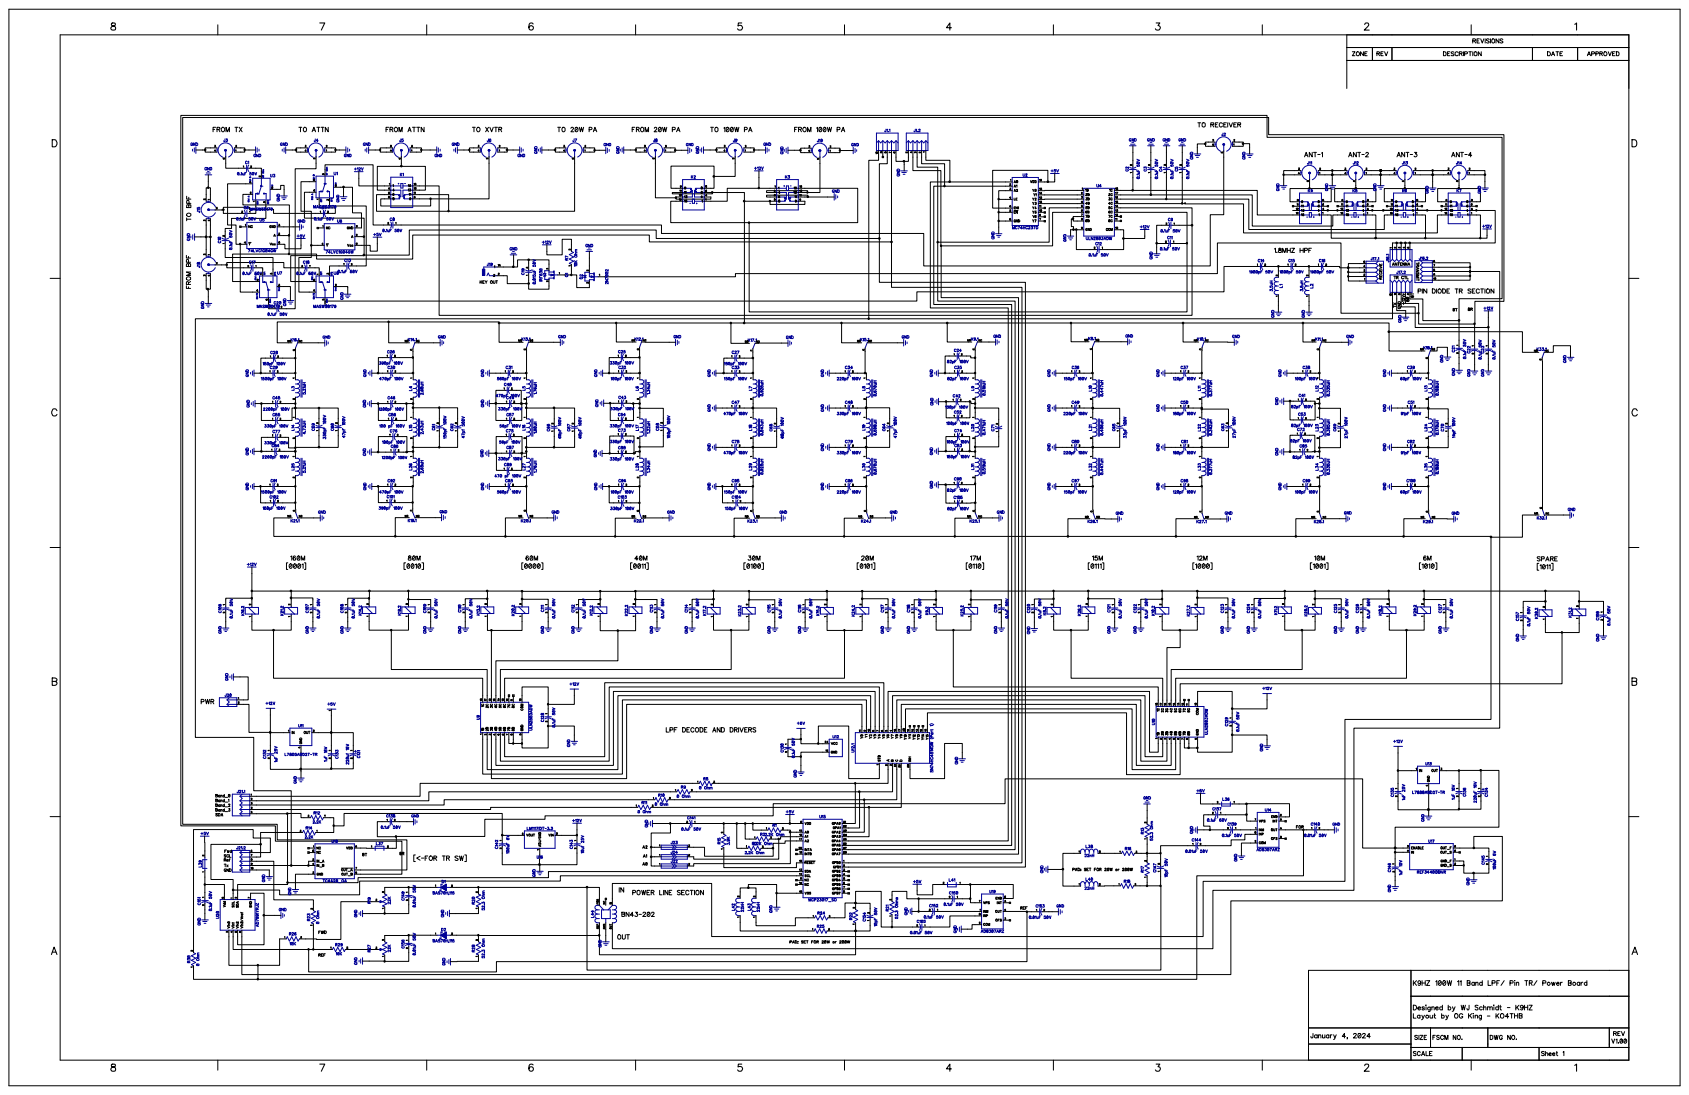
[picture p358: page 1]
