DRWJSCHMIDT/T41/T41_V012_Files_01-15-24/T41_V012_Schematic_PDFs/T41_BPF_Board_V12.6_Schematic-KiCad-_01-26-24.pdf

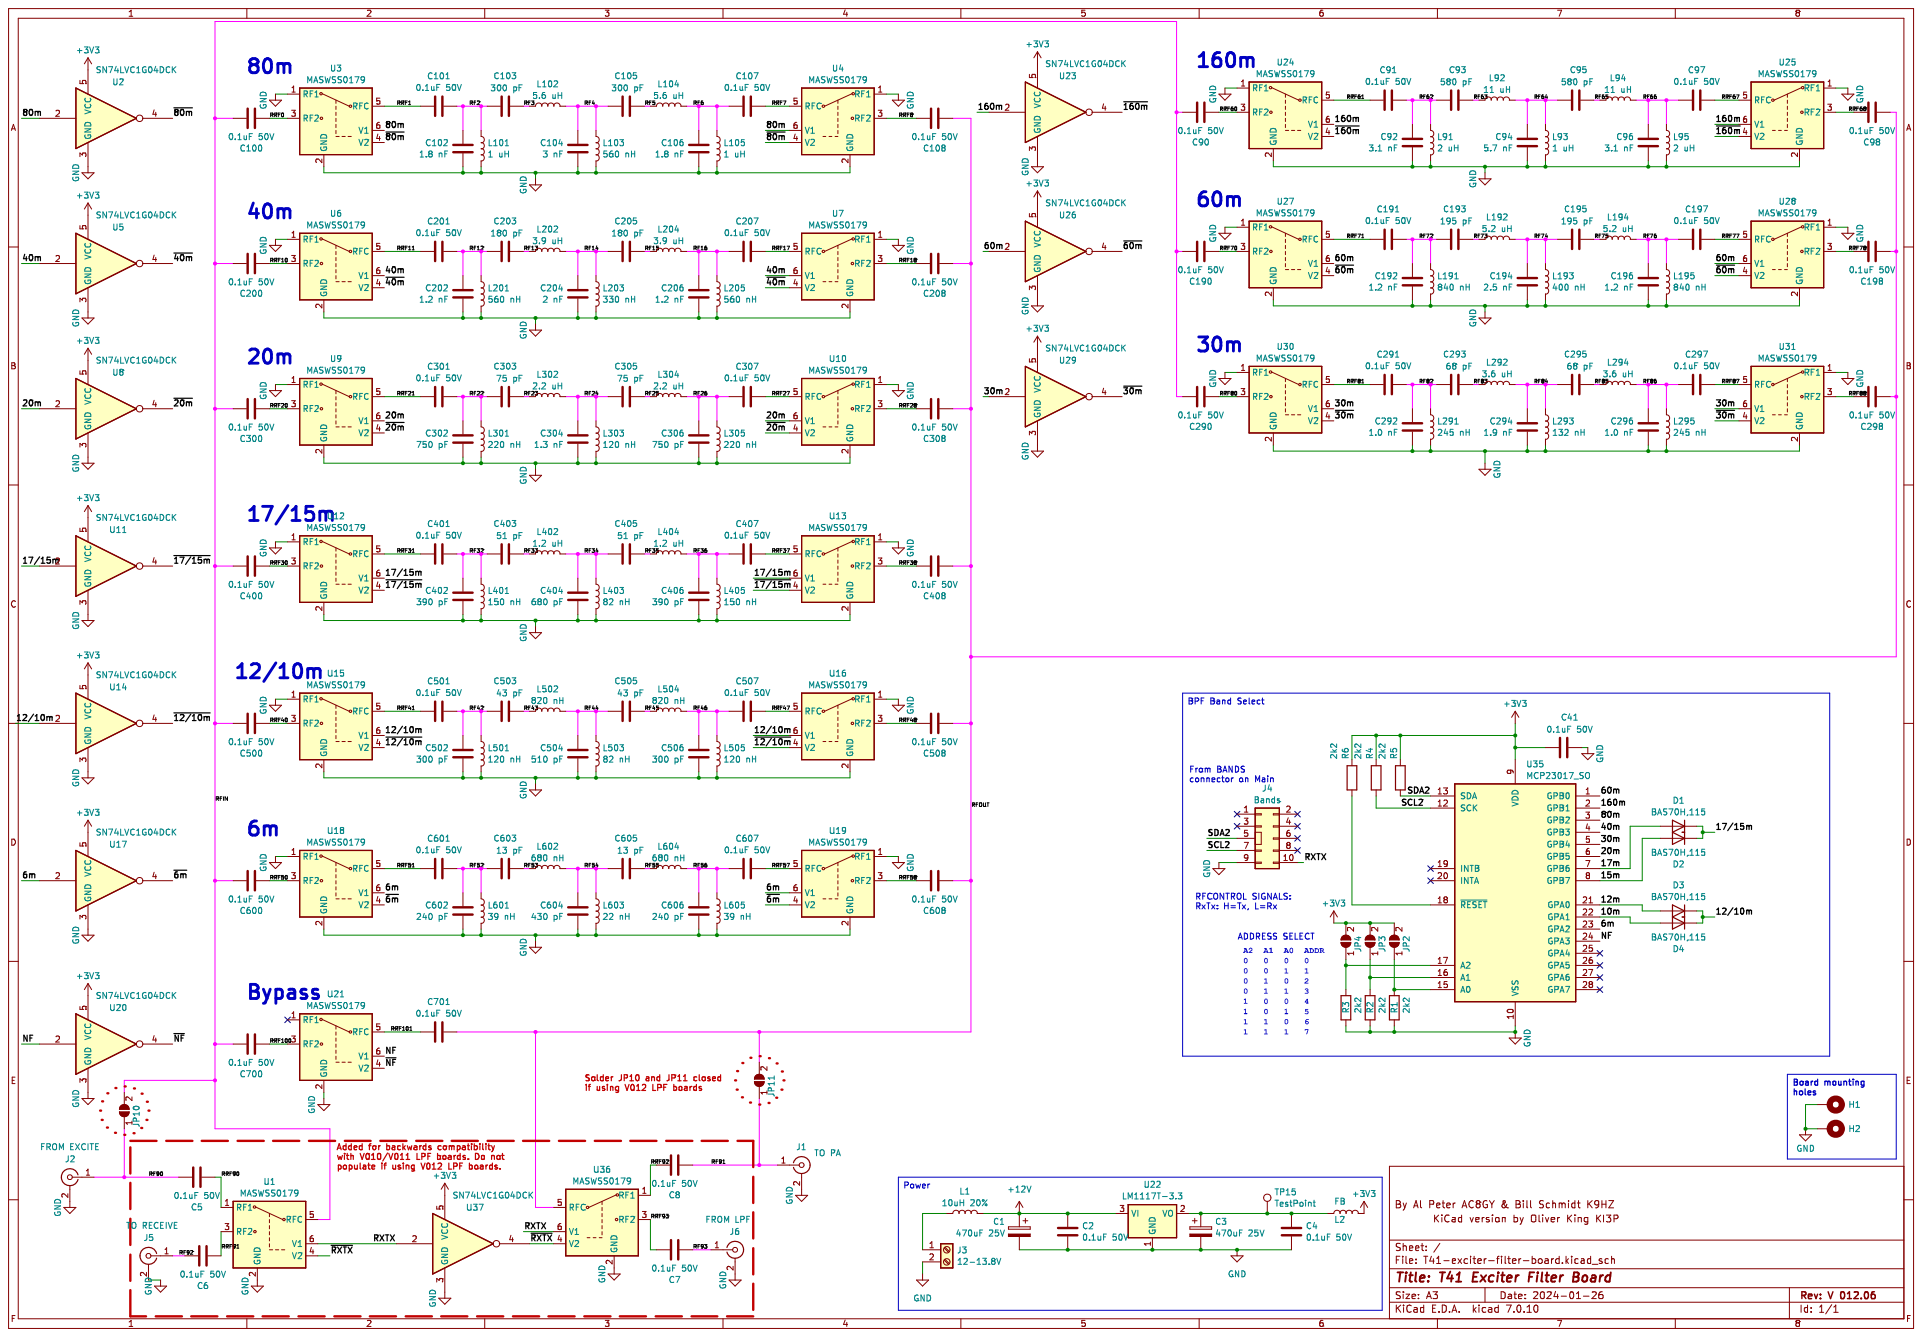
[picture p359: page 1]
