DRWJSCHMIDT/T41/K9HZ_LPF_Module/K9HZ_LPF_V1.00_Schematic_PDFs/K9HZ_LPF-Board_Schematic_V1.00_01-14-24_KiCad.pdf

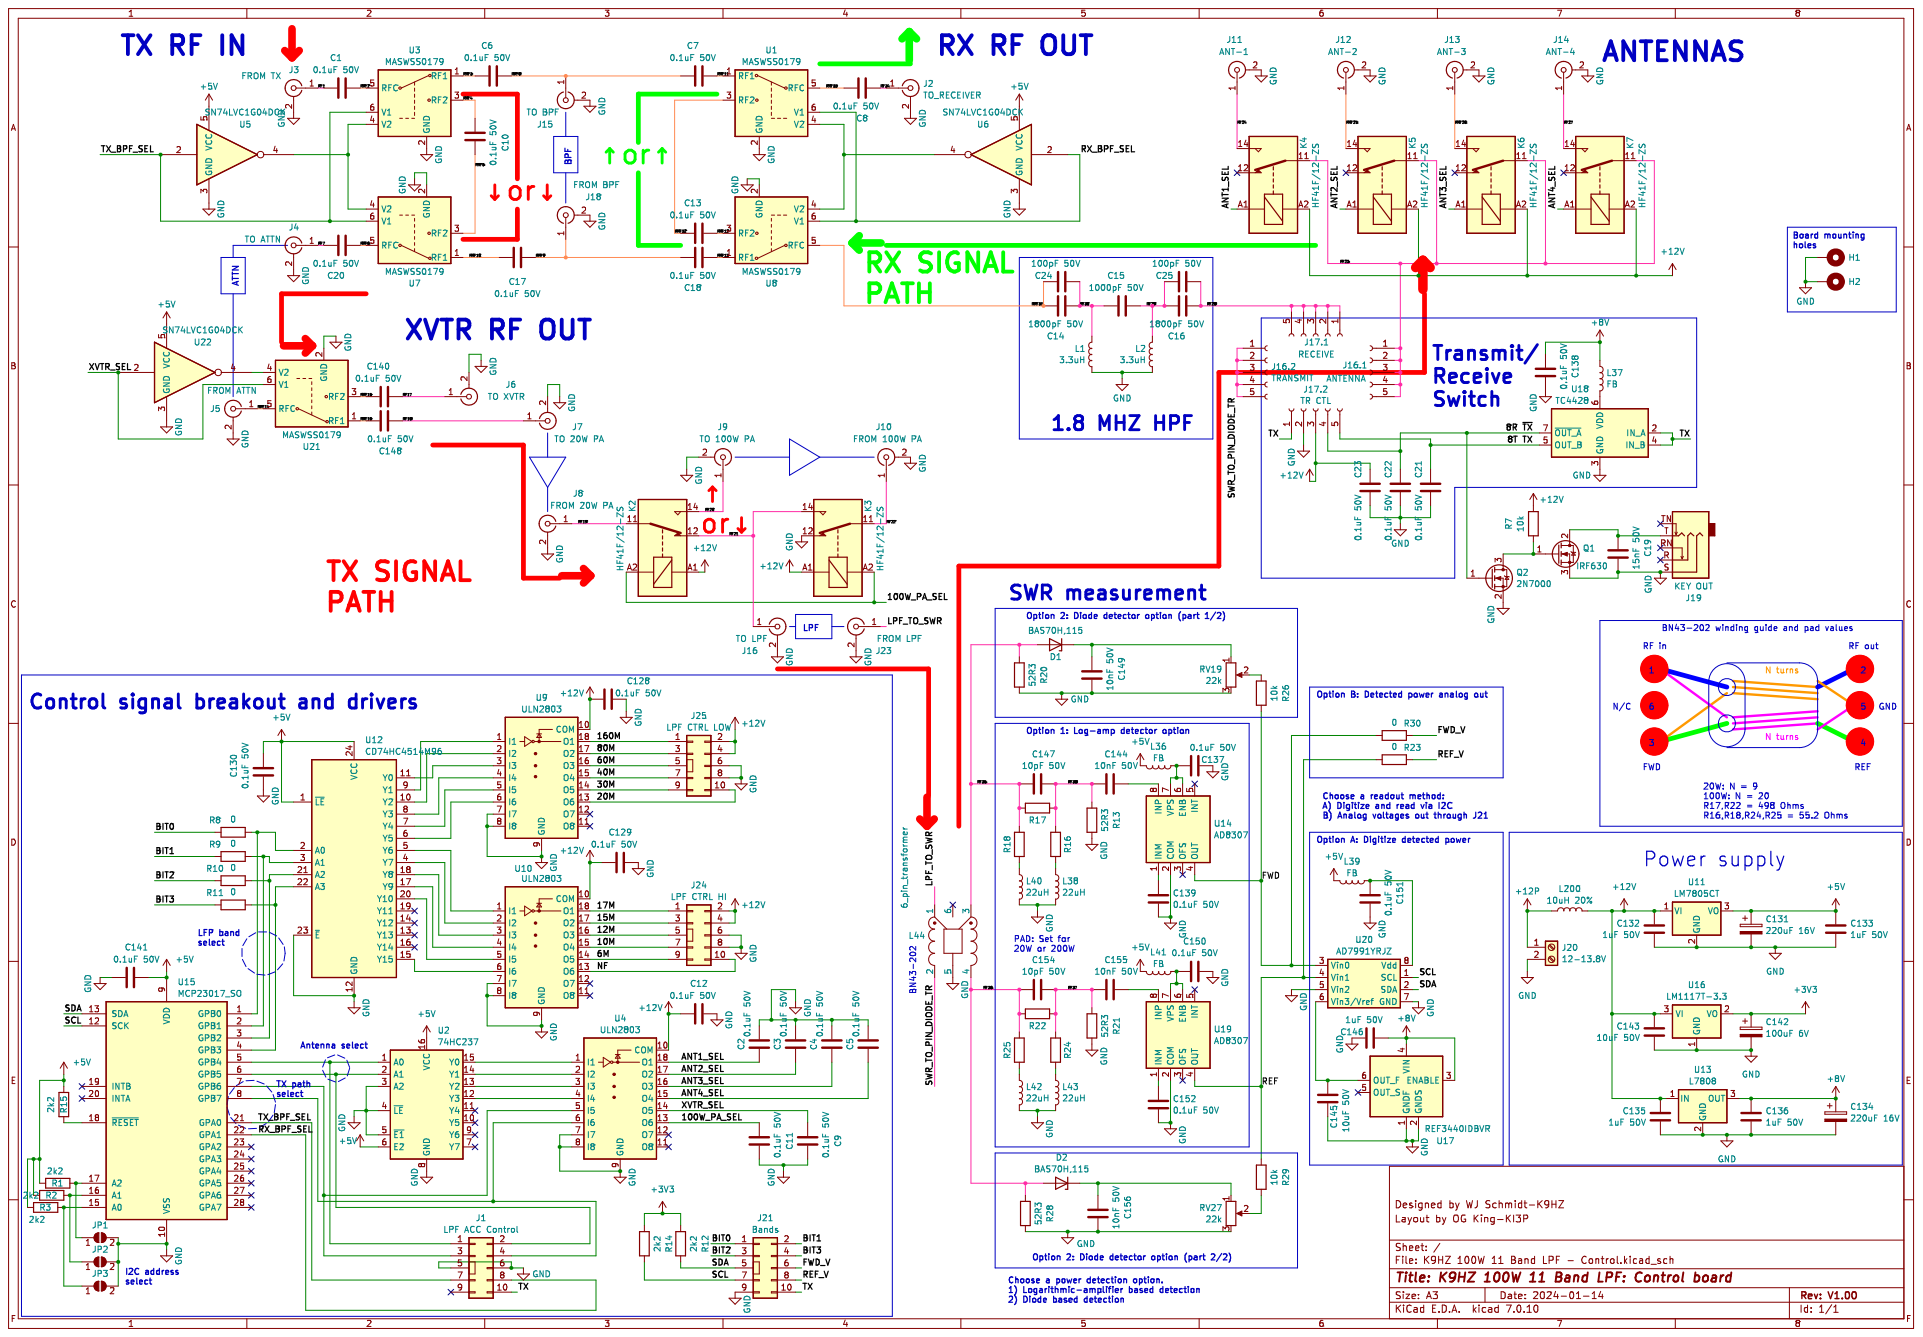
[picture p360: page 1]
