DRWJSCHMIDT/T41/K9HZ_LPF_Module/K9HZ_LPF_V1.00_Schematic_PDFs/K9HZ_LPF-Carrier_Relay_Board_Schematic_V1.00_01-16-24_KiCad.pdf

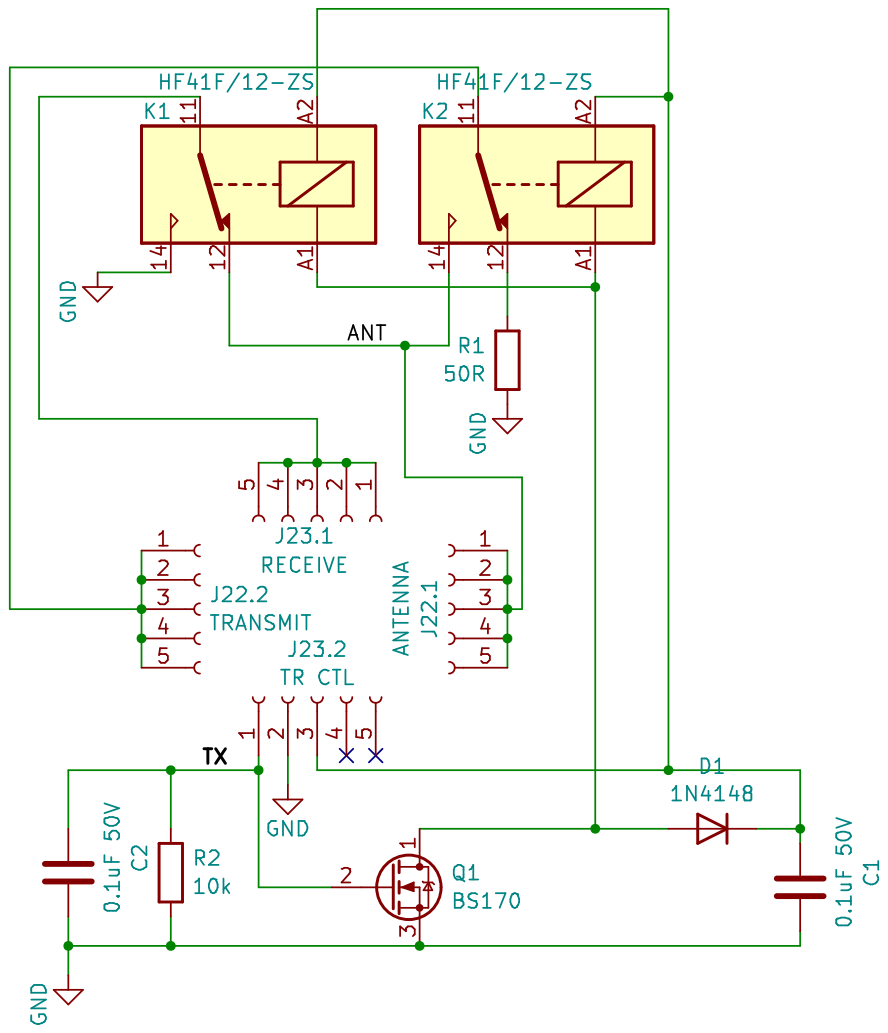
[picture p361: page 1]
