DRWJSCHMIDT/T41/K9HZ_Front_Panel_Boards/G0ORX Original Front Panel Files/FrontPanel_Schematic.pdf

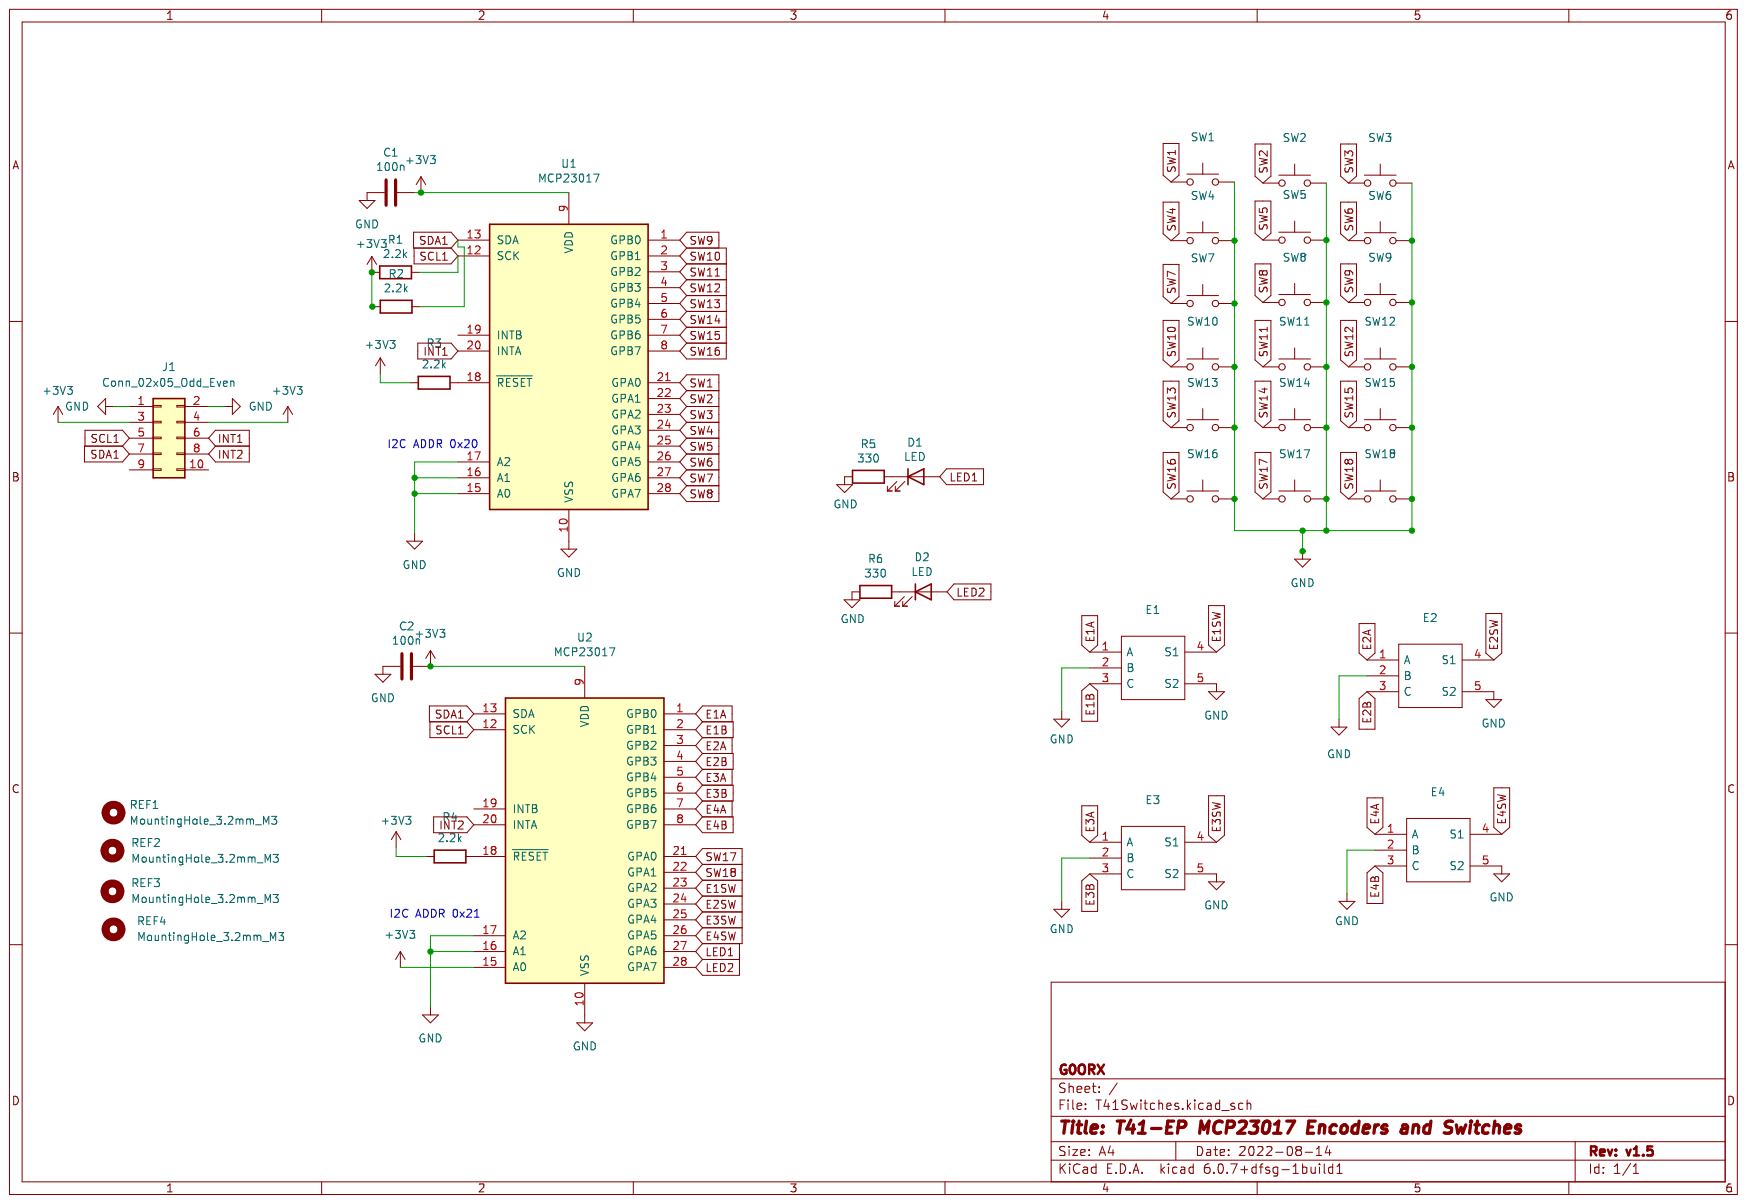
[picture p362: page 1]
