DRWJSCHMIDT/T41/K9HZ_LPF_Module/K9HZ_LPF_V1.00_Schematic_PDFs/K9HZ_LPF-Carrier_Relay_Board_Schematic_V1.00_01-04-24.pdf

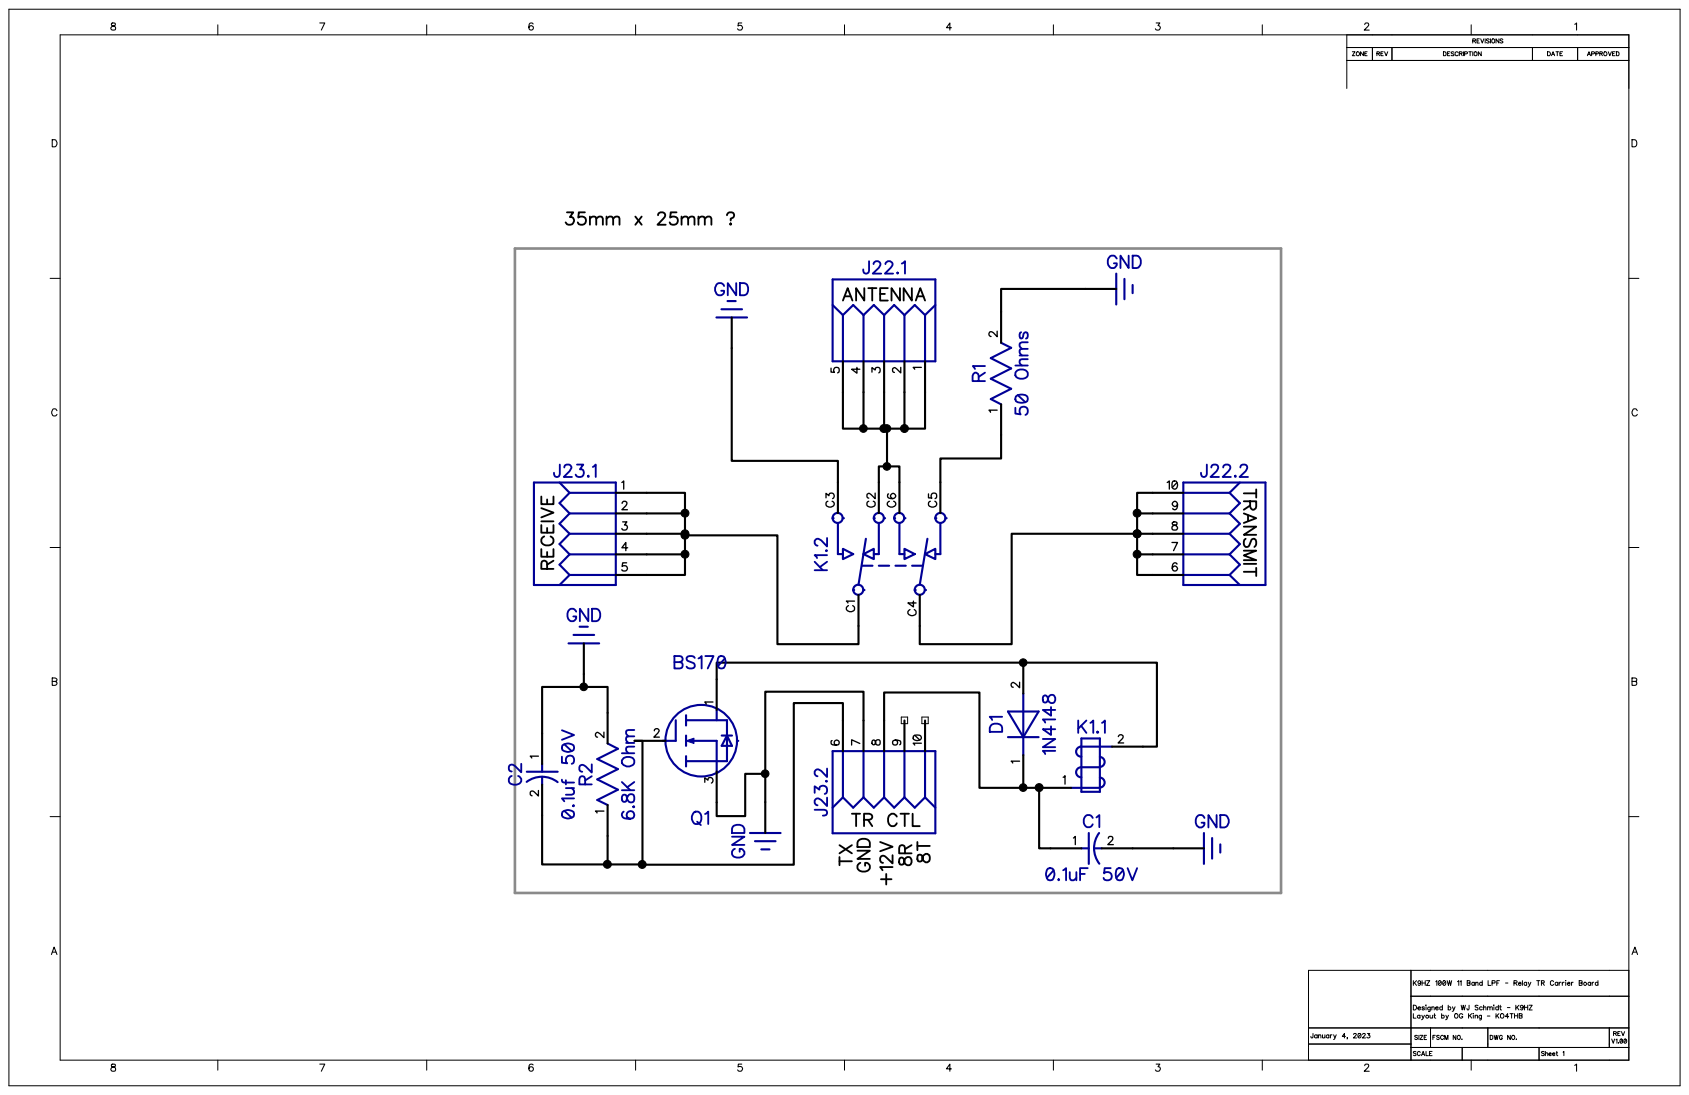
[picture p363: page 1]
