DRWJSCHMIDT/T41/T41_V012_Files/T41_V012_BPF_Design_Files/K9HZ_T41_BPF_Design_Files/T41_BPF_160M_Plot_V12.6_03-07-24_Actual.pdf

# Untitled

## Transmission, dB

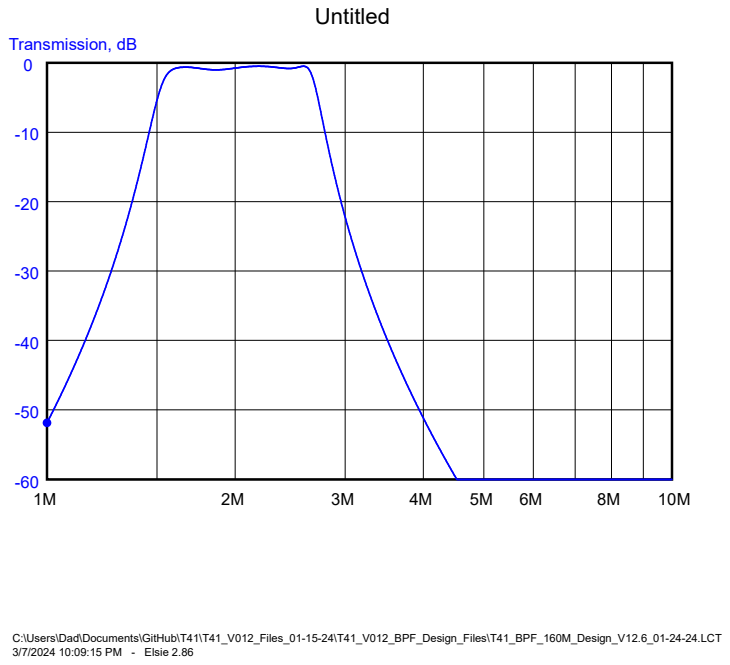
[picture p366: page 1]

C:\Users\Dad\Documents\GitHub\T41\T41_V012_Files_01-15-24\T41_V012_BPF_Design_Files\T41_BPF_160M_Design_V12.6_01-24-24.LCT
3/7/2024 10:09:15 PM - Elsie 2.86
