DRWJSCHMIDT/T41/(list of files, drawings)

Other design files:
T41_V010_Files/T41_V010_PCBs/T41_Front_Panel_SW_V010.dip
T41_V010_Files/T41_V010_PCBs/T41_Main_V010.dip
T41_V010_Files/T41_V010_PCBs/T41_PA_V010.dip
T41_V010_Files/T41_V010_PCBs/T41_Power_Supply_V010.dip
T41_V010_Files/T41_V010_PCBs/T41_QSD_V010.dip
T41_V010_Files/T41_V010_PCBs/T41_QSE_V010.dip
T41_V010_Files/T41_V010_PCBs/T41_V010_PCBs_DipTrace/T41_Front_Panel_Switch_Matrix_V010.dip
T41_V010_Files/T41_V010_PCBs/T41_V010_PCBs_DipTrace/T41_Main_V010.dip
T41_V010_Files/T41_V010_PCBs/T41_V010_PCBs_DipTrace/T41_PA_V010.dip
T41_V010_Files/T41_V010_PCBs/T41_V010_PCBs_DipTrace/T41_Power_Supply_V010.dip
T41_V010_Files/T41_V010_PCBs/T41_V010_PCBs_DipTrace/T41_QSD_V010.dip
T41_V010_Files/T41_V010_PCBs/T41_V010_PCBs_DipTrace/T41_QSE_V010.dip
T41_V010_Files/T41_V010_PCBs/T41_V010_PCBs_DipTrace/T41_Xmit_Filter_Module_Daughter_V010.dip
T41_V010_Files/T41_V010_PCBs/T41_V010_PCBs_DipTrace/T41_Xmit_Filter_Modules_V010.dip
T41_V010_Files/T41_V010_PCBs/T41_Xmit_Filter_Module_Daughter_V010.dip
T41_V010_Files/T41_V010_PCBs/T41_xmit_Filter_Modules_V010.dip
T41_V010_Files/T41_V010_Schematics/T41_DC_Power_Supply_V010.dch
T41_V010_Files/T41_V010_Schematics/T41_Front_Panel_Switch_Matrix_V010.dch
T41_V010_Files/T41_V010_Schematics/T41_Main_Board_V010.dch
T41_V010_Files/T41_V010_Schematics/T41_Power_Amp_V010.dch
T41_V010_Files/T41_V010_Schematics/T41_QSD_V010.dch
T41_V010_Files/T41_V010_Schematics/T41_QSE_V010.dch
T41_V010_Files/T41_V010_Schematics/T41_V010_Schematics_DipTrace/T41_DC_Power_Supply_V010.dch
T41_V010_Files/T41_V010_Schematics/T41_V010_Schematics_DipTrace/T41_Front_Panel_Switch_Matrix_V010.dch
T41_V010_Files/T41_V010_Schematics/T41_V010_Schematics_DipTrace/T41_Main_Board_V010.dch
T41_V010_Files/T41_V010_Schematics/T41_V010_Schematics_DipTrace/T41_Power_Amp_V010.dch
T41_V010_Files/T41_V010_Schematics/T41_V010_Schematics_DipTrace/T41_QSD_V010.dch
T41_V010_Files/T41_V010_Schematics/T41_V010_Schematics_DipTrace/T41_QSE_V010.dch
T41_V010_Files/T41_V010_Schematics/T41_V010_Schematics_DipTrace/T41_Xmit_Filter_Schematic_V010.dch
T41_V010_Files/T41_V010_Schematics/T41_Xmit_Filter_Schematic_V010.dch
T41_V011_Files/PCBs/T41_Front_Panel_SW_V011.dip
T41_V011_Files/PCBs/T41_Main_V011.dip
T41_V011_Files/PCBs/T41_PA_V011.dip
T41_V011_Files/PCBs/T41_Power_Supply_V011.dip
T41_V011_Files/PCBs/T41_QSD_V011.dip
T41_V011_Files/PCBs/T41_QSE_V011.dip
T41_V011_Files/PCBs/T41_Xmit_Filter_Module_Daughter_V011.dip
T41_V011_Files/PCBs/T41_xmit_Filter_V011.dip
T41_V011_Files/Schematics/T41_DC_Power_Supply_V011.dch
T41_V011_Files/Schematics/T41_Front_Panel_Switch_Matrix_V011.dch
T41_V011_Files/Schematics/T41_Main_Board_V011.dch
T41_V011_Files/Schematics/T41_Power_Amp_V011.dch
T41_V011_Files/Schematics/T41_QSD_V011.dch
T41_V011_Files/Schematics/T41_QSE_V011.dch
T41_V011_Files/Schematics/T41_Xmit_Filter_Schematic_V011.dch
T41_V011_Files/T41_V011_PCBs/T41_V011_PCBs_DipTrace/T41 Audio V013B 07-24-22.dip
T41_V011_Files/T41_V011_PCBs/T41_V011_PCBs_DipTrace/T41 Exciter V011 Quad 07-12-22.dip
T41_V011_Files/T41_V011_PCBs/T41_V011_PCBs_DipTrace/T41 Front Panel SW V011 07 -11-22.dip
T41_V011_Files/T41_V011_PCBs/T41_V011_PCBs_DipTrace/T41 Front Panel SW V011.dip
T41_V011_Files/T41_V011_PCBs/T41_V011_PCBs_DipTrace/T41 Main V011 07-12-22.dip
T41_V011_Files/T41_V011_PCBs/T41_V011_PCBs_DipTrace/T41 Main V011.dip
T41_V011_Files/T41_V011_PCBs/T41_V011_PCBs_DipTrace/T41 PA V011 07-11-22.dip
T41_V011_Files/T41_V011_PCBs/T41_V011_PCBs_DipTrace/T41 PA V011.dip
T41_V011_Files/T41_V011_PCBs/T41_V011_PCBs_DipTrace/T41 Power Supply V011 07-05-22.dip
T41_V011_Files/T41_V011_PCBs/T41_V011_PCBs_DipTrace/T41 Power Supply V011.dip
T41_V011_Files/T41_V011_PCBs/T41_V011_PCBs_DipTrace/T41 QSD V010 06-01-22.dip
T41_V011_Files/T41_V011_PCBs/T41_V011_PCBs_DipTrace/T41 QSD V011.dip
T41_V011_Files/T41_V011_PCBs/T41_V011_PCBs_DipTrace/T41 QSE V011.dip
T41_V011_Files/T41_V011_PCBs/T41_V011_PCBs_DipTrace/T41 Xmit Filter Module Daughter V010.dip
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
