DRWJSCHMIDT/T41/T41_V012_Files/T41_V012_PCBs/T41_V012_PCBs_KiCad/T41-si5351A-B-GM-Oscillator-daughterboard/T41-si5351A-B-GM-Oscillator-daughterboard.kicad_pcb

## KiCad design T41_V012_Files/T41_V012_PCBs/T41_V012_PCBs_KiCad/T41-si5351A-B-GM-Oscillator-daughterboard/T41-si5351A-B-GM-Oscillator-daughterboard.kicad_pcb (2026-09-08)

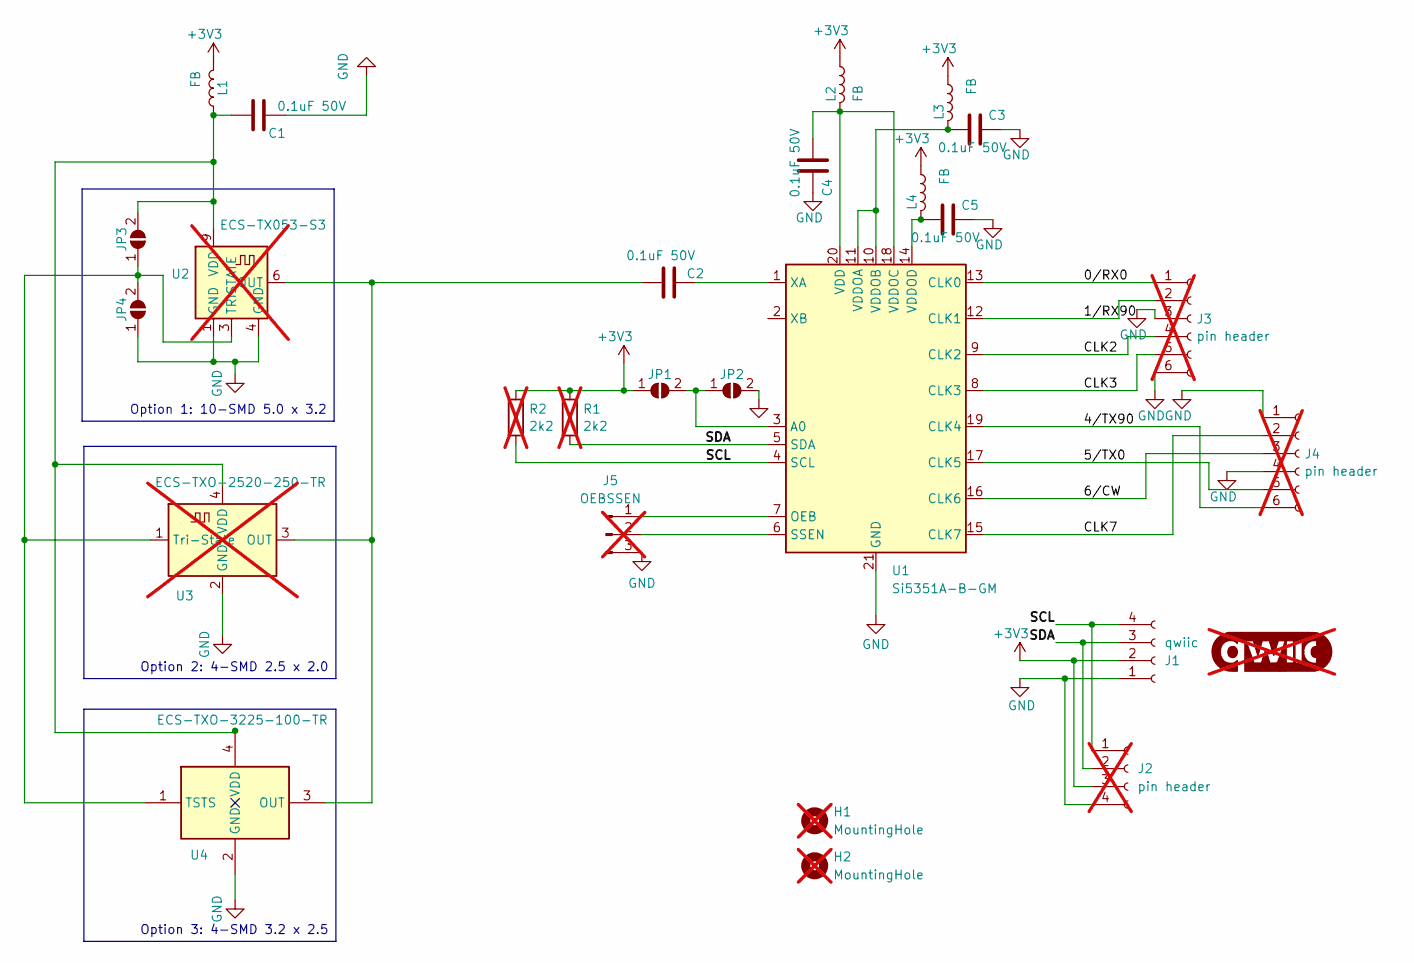
[picture p367: schematic T41-si5351A-B-GM-Oscillator-daughterboard.kicad_sch, T41 V12.7 Oscillator Daughter Board]

Parts:
C1, C2, C3, C4, C5: 0.1uF 50V; C_0603_1608Metric; LCSC C14663
G1: qwiic_Logo; qwiic_4mm; not fitted
H1, H2: MountingHole; MountingHole_2.2mm_M2_DIN965; not fitted
J1: qwiic; JST_SH_SM04B-SRSS-TB_1x04-1MP_P1.00mm_Horizontal; LCSC C160404
J2: pin header; PinHeader_1x04_P2.54mm_Vertical; not fitted
J3, J4: pin header; PinHeader_1x06_P2.54mm_Vertical; not fitted
J5: OEBSSEN; PinHeader_1x03_P2.54mm_Vertical; not fitted
JP1, JP2, JP3, JP4: SolderJumper_2_Open; SolderJumper-2_P1.3mm_Open_TrianglePad1.0x1.5mm
L1, L2, L3, L4: FB; L_0603_1608Metric; LCSC C1002
R1, R2: 2k2; R_0603_1608Metric; LCSC C4190; not fitted
U1: Si5351A-B-GM; QFN-20-1EP_4x4mm_P0.5mm_EP2.7x2.7mm; LCSC C22413806
U2: ECS-TX053-S3; Oscillator_ECS_TXO53_S3; LCSC C18457614; not fitted
U3: ECS-TXO-2520-250-TR; Oscillator_SMD_ECS_2520MV-xxx-xx-4Pin_2.5x2.0mm; not fitted
U4: ECS-TXO-3225-100-TR; ECSTXO3225120TR; Manufacturer_Part_Number ECS-TXO-3225-100-TR

Connections:
+3V3: J1.2, J2.3, JP1.1 (A), L1.2, L2.1, L3.1, L4.1, R1.1, R2.1
/0/RX0: J3.1, U1.13 (CLK0)
/1/RX90: J3.2, U1.12 (CLK1)
/4/TX90: J4.6, U1.19 (CLK4)
/5/TX0: J4.5, U1.17 (CLK5)
/6/CW: J4.3, U1.16 (CLK6)
/CLK2: J3.4, U1.9 (CLK2)
/CLK3: J3.5, U1.8 (CLK3)
/CLK7: J4.2, U1.15 (CLK7)
/SCL: J1.4, J2.1, R2.2, U1.4 (SCL)
/SDA: J1.3, J2.2, R1.2, U1.5 (SDA)
GND: C1.2, C3.2, C4.2, C5.2, J1.1, J2.4, J3.3, J3.6, J4.1, J4.4, J5.3, JP2.2 (B), JP4.1 (A), U1.21 (GND), U2.1 (GND), U2.4 (GND), U3.2 (GND), U4.2 (GND); also elsewhere on the board
unnamed: J5.1, U1.7 (OEB)
unnamed: J5.2, U1.6 (SSEN)
unnamed: JP1.2 (B), JP2.1 (A), U1.3 (A0)
unnamed: JP3.1 (A), JP4.2 (B), U2.3 (TRISTATE), U3.1 (Tri-State), U4.1 (TSTS)
unnamed: C1.1, JP3.2 (B), L1.1, U2.9 (VDD), U3.4 (VDD), U4.4 (VDD)
unnamed: C4.1, L2.2, U1.18 (VDDOC), U1.20 (VDD)
unnamed: C3.1, L3.2, U1.10 (VDDOB), U1.11 (VDDOA)
unnamed: C5.1, L4.2, U1.14 (VDDOD)
unnamed: C2.1, U1.1 (XA)
unnamed 21: C2.2, U2.6 (OUT), U3.3 (OUT), U4.3 (OUT); also elsewhere on the board

Notes on the sheet:
Option 1: 10-SMD 5.0 x 3.2
Option 2: 4-SMD 2.5 x 2.0
Option 3: 4-SMD 3.2 x 2.5

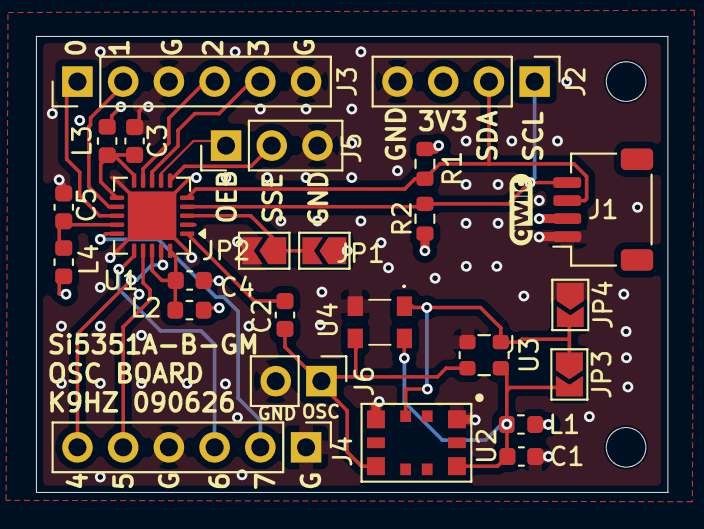
[picture p368: board T41-si5351A-B-GM-Oscillator-daughterboard.kicad_pcb from above]

Board: 4 copper layers, 35.1 x 25.3 mm, 28 parts (0 on the bottom side), 22 nets.

Other parts of the board:
J6: PinHeader_1x02_P2.54mm_Vertical

Their connections:
GND: J6.2; also elsewhere on the board
unnamed 21: J6.1; also elsewhere on the board
