DRWJSCHMIDT/T41/T41_V012_Files/T41_V012_PCBs/T41_V012_PCBs_KiCad/Old FIles/T41-BPF-filter-board-V12.6/T41-exciter-filter-board.kicad_pcb

## KiCad design T41_V012_Files/T41_V012_PCBs/T41_V012_PCBs_KiCad/Old FIles/T41-BPF-filter-board-V12.6/T41-exciter-filter-board.kicad_pcb (2024-04-21, an earlier design)

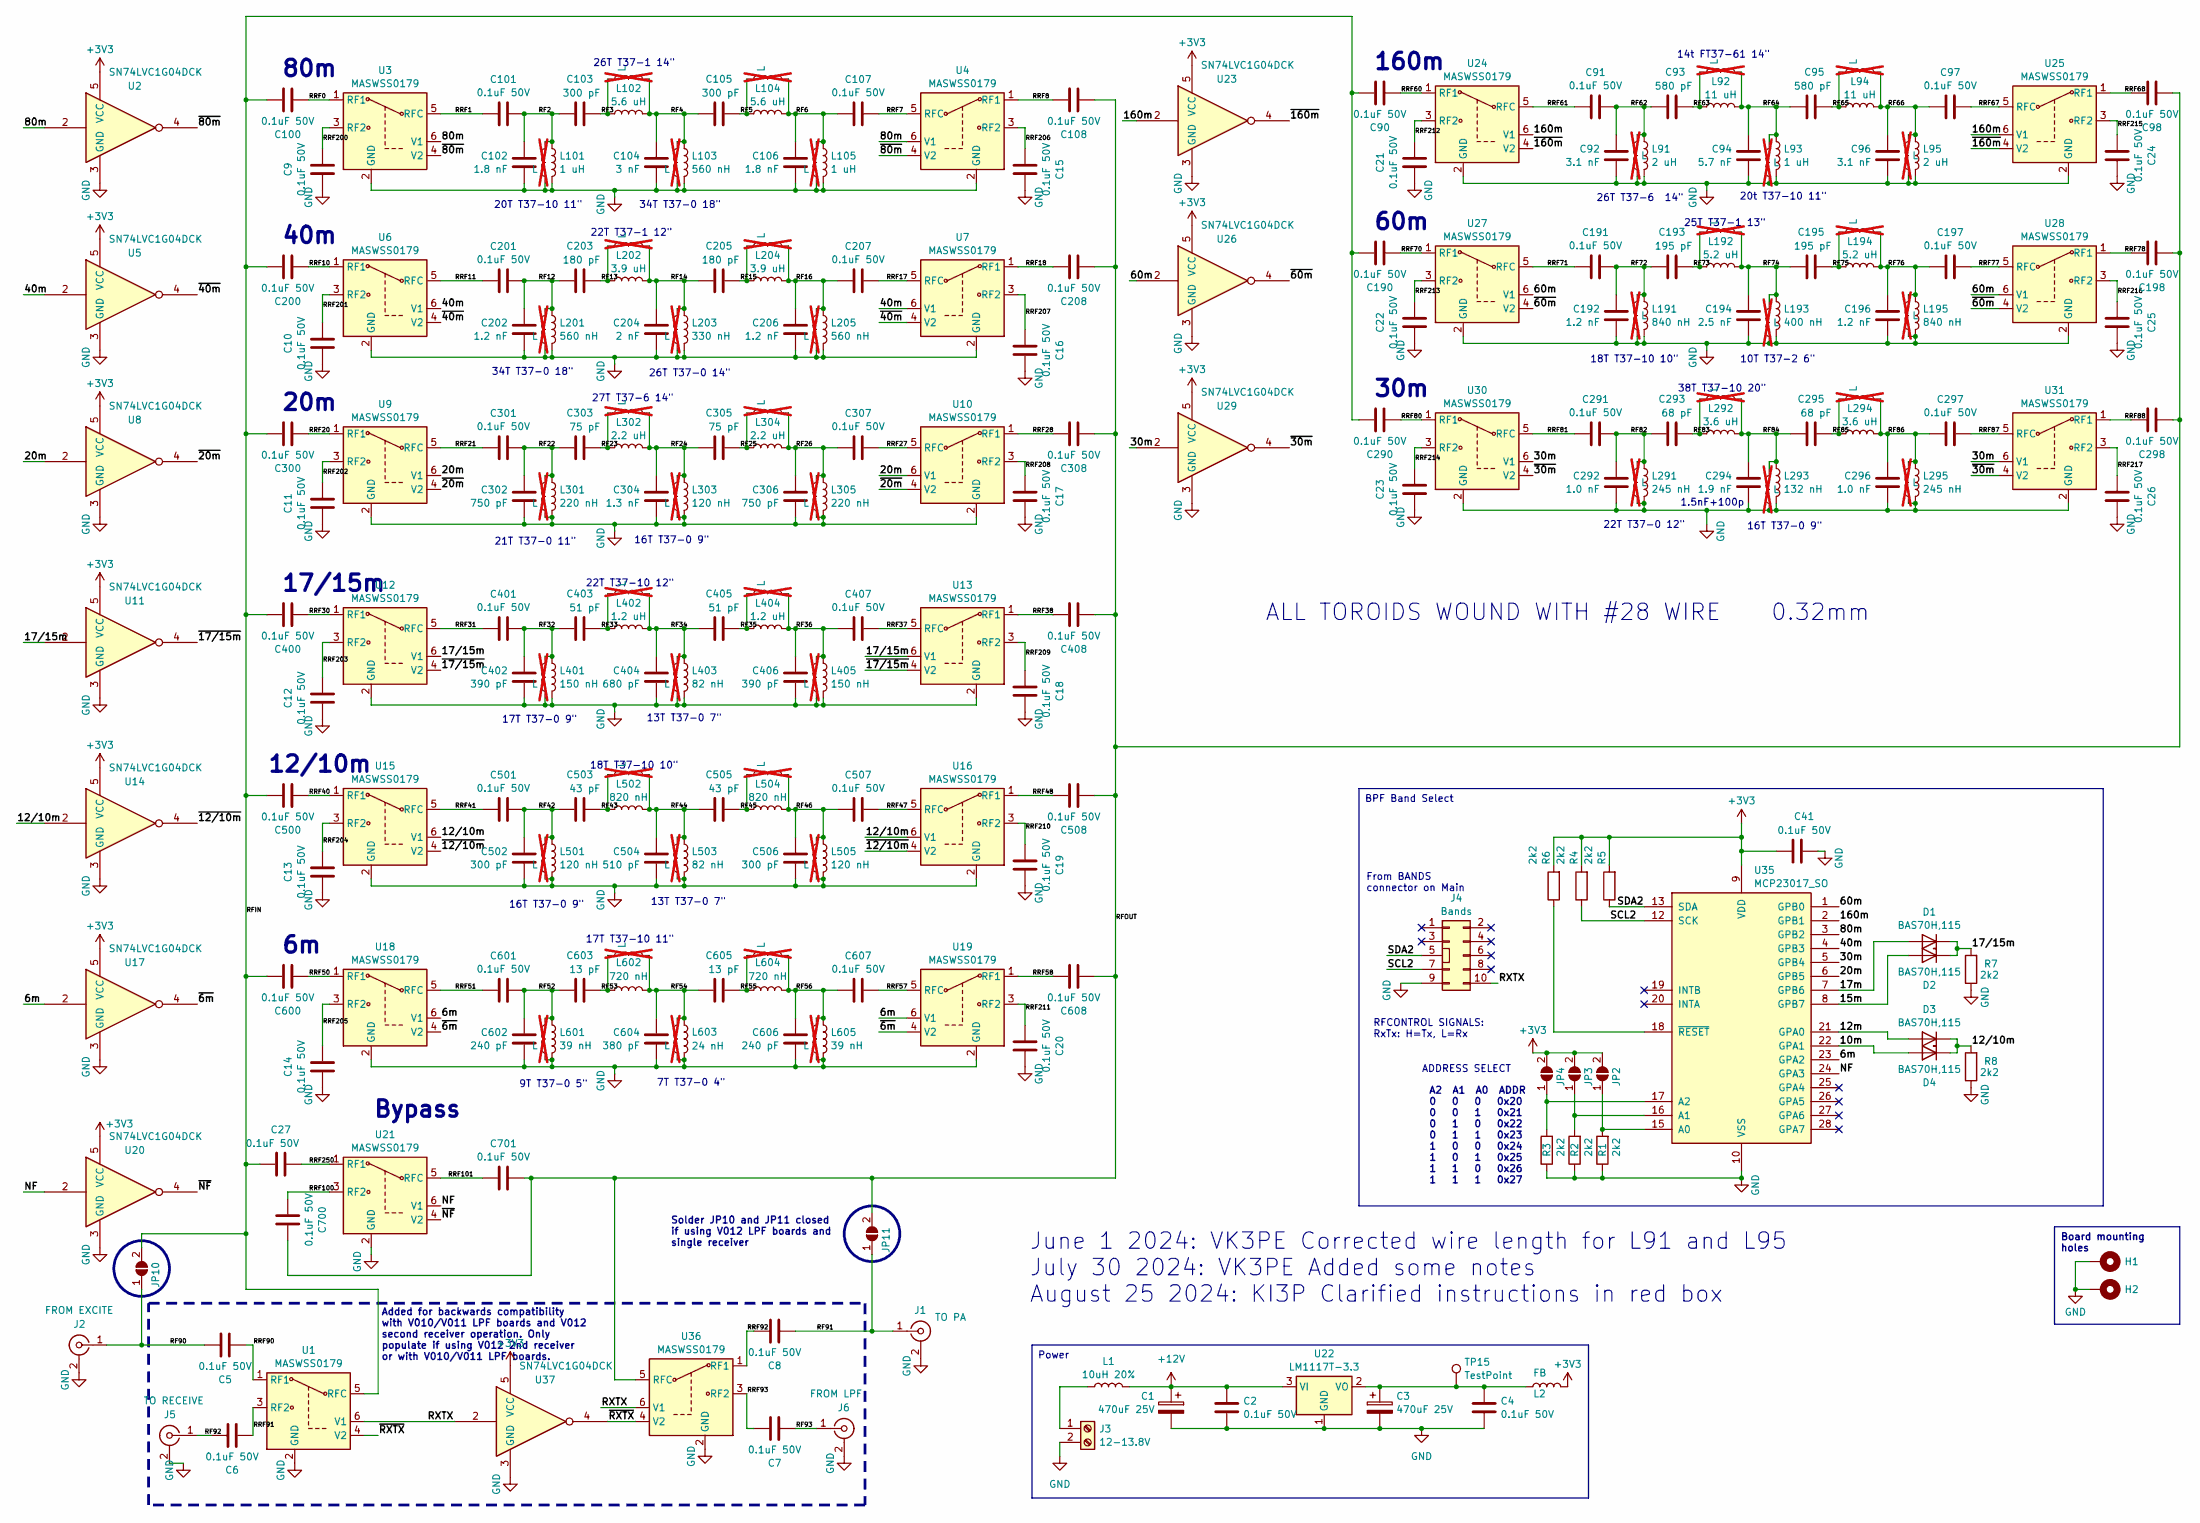
[picture p369: schematic T41-exciter-filter-board.kicad_sch, T41 Exciter Filter Board]

Parts:
C1, C3: 470uF 25V; CP_Radial_D10.0mm_P5.00mm; Mouser Part Number 667-ECA-1EM471
C2, C4, C5, C6, C7, C8, C9, C10, C11, C12, C13, C14, C15, C16, C17, C18, C19, C20, C21, C22, C23, C24, C25, C26, C27, C90, C91, C97, C98, C100, C101, C107, C108, C190, C191, C197, C198, C200, C201, C207, C208, C290, C291, C297, C298, C300, C301, C307, C308, C400, C401, C407, C408, C500, C501, C507, C508, C600, C601, C607, C608, C700, C701: 0.1uF 50V; C_1206_3216Metric; Mouser Part Number C1206C104K5RACTU
C41: 0.1uF 50V; C_1206_3216Metric; Mouser Part Number 581-12065F104K4
C92, C96: 3.1 nF; C_1206_3216Metric
C93, C95: 580 pF; C_1206_3216Metric
C94: 5.7 nF; C_1206_3216Metric
C102, C106: 1.8 nF; C_1206_3216Metric
C103, C105, C502, C506: 300 pF; C_1206_3216Metric
C104: 3 nF; C_1206_3216Metric
C192, C196, C202, C206: 1.2 nF; C_1206_3216Metric
C193, C195: 195 pF; C_1206_3216Metric
C194: 2.5 nF; C_1206_3216Metric
C203, C205: 180 pF; C_1206_3216Metric
C204: 2 nF; C_1206_3216Metric
C292, C296: 1.0 nF; C_1206_3216Metric
C293, C295: 68 pF; C_1206_3216Metric
C294: 1.9 nF; C_1206_3216Metric
C302, C306: 750 pF; C_1206_3216Metric
C303, C305: 75 pF; C_1206_3216Metric
C304: 1.3 nF; C_1206_3216Metric
C402, C406: 390 pF; C_1206_3216Metric
C403, C405: 51 pF; C_1206_3216Metric
C404: 680 pF; C_1206_3216Metric
C503, C505: 43 pF; C_1206_3216Metric
C504: 510 pF; C_1206_3216Metric
C602, C606: 240 pF; C_1206_3216Metric
C603, C605: 13 pF; C_1206_3216Metric
C604: 380 pF; C_1206_3216Metric
D1, D2, D3, D4: BAS70H,115; D_SOD-123F; Mouser Part Number 771-BAS70H-T/R
H1, H2: MountingHole_4.3mm_M4_DIN965_Pad
J1: TO PA; SMA_Amphenol_901-144_Vertical; Mouser Part Number 712-CONSMA001-G
J2: FROM EXCITE; SMA_Amphenol_901-144_Vertical; Mouser Part Number 712-CONSMA001-G
J3: 12-13.8V; TerminalBlock_bornier-2_P5.08mm; Mouser Part Number 538-39880-4302
J4: Bands; IDC-Header_2x05_P2.54mm_Vertical
J5: TO RECEIVE; SMA_Amphenol_901-144_Vertical; Mouser Part Number 712-CONSMA001-G
J6: FROM LPF; SMA_Amphenol_901-144_Vertical; Mouser Part Number 712-CONSMA001-G
JP2, JP3, JP4, JP10, JP11: SolderJumper_2_Open; SolderJumper-2_P1.3mm_Open_TrianglePad1.0x1.5mm
L1: 10uH 20%; L_Bourns-SRN6028; Mouser Part Number 81-1264EY-100MP3
L2: FB; R_1206_3216Metric; Mouser Part Number 875-HZ1206E601R-10
L3, L4, L5, L6, L7, L8, L9, L10, L11, L12, L13, L14, L15, L16, L17, L18, L19, L20, L21, L22, L23, L24, L25, L26, L27, L28, L29, L30, L31, L32, L33, L34, L35, L36, L37, L38, L39, L40, L41, L42, L43, L44, L45, L46, L47: L; L_1206_3216Metric; not fitted
L91, L95: 2 uH; FT37-toroid-vertical
L92, L94: 11 uH; FT37-toroid-vertical
L93, L101, L105: 1 uH; FT37-toroid-vertical
L102, L104: 5.6 uH; FT37-toroid-vertical
L103, L201, L205: 560 nH; FT37-toroid-vertical
L191, L195: 840 nH; FT37-toroid-vertical
L192, L194: 5.2 uH; FT37-toroid-vertical
L193: 400 nH; FT37-toroid-vertical
L202, L204: 3.9 uH; FT37-toroid-vertical
L203: 330 nH; FT37-toroid-vertical
L291, L295: 245 nH; FT37-toroid-vertical
L292, L294: 3.6 uH; FT37-toroid-vertical
L293: 132 nH; FT37-toroid-vertical
L301, L305: 220 nH; FT37-toroid-vertical
L302, L304: 2.2 uH; FT37-toroid-vertical
L303, L501, L505: 120 nH; FT37-toroid-vertical
L401, L405: 150 nH; FT37-toroid-vertical
L402, L404: 1.2 uH; FT37-toroid-vertical
L403, L503: 82 nH; FT37-toroid-vertical
L502, L504: 820 nH; FT37-toroid-vertical
L601, L605: 39 nH; FT37-toroid-vertical
L602, L604: 720 nH; FT37-toroid-vertical
L603: 24 nH; FT37-toroid-vertical
R1, R2, R3, R4, R5, R6, R7, R8: 2k2; R_1206_3216Metric; Mouser Part Number 652-CR1206FX-2201ELF
TP15: TestPoint; PinHeader_1x01_P2.54mm_Vertical
U1, U3, U4, U6, U7, U9, U10, U12, U13, U15, U16, U18, U19, U21, U24, U25, U27, U28, U30, U31, U36: MASWSS0179; MASWSS0179-SOT-26; Mouser Part Number 937-MASWSS0179-T
U2, U5, U8, U11, U14, U17, U20, U23, U26, U29, U37: SN74LVC1G04DCK; SOT-SC70; Mouser Part Number 595-SN74LVC1G04DCKR
U22: LM1117T-3.3; TO-220-3_Vertical; Mouser Part Number 926-LM1117T-3.3/NOPB
U35: MCP23017_SO; SOIC-28W_7.5x17.9mm_P1.27mm; Mouser Part Number 579-MCP23017-E/SO

Connections:
+3V3: C41.2, JP2.2 (B), JP3.2 (B), JP4.2 (B), L2.1, R4.2, R5.2, R6.2, U2.5 (VCC), U5.5 (VCC), U8.5 (VCC), U11.5 (VCC), U14.5 (VCC), U17.5 (VCC), U20.5 (VCC), U23.5 (VCC), U26.5 (VCC), U29.5 (VCC), U35.9 (VDD), U37.5 (VCC)
+12V: C1.1, C2.1, L1.2, U22.3 (VI)
/6m: U17.2, U18.6 (V1), U19.6 (V1), U35.23 (GPA2)
/10m: D4.2 (A), U35.22 (GPA1)
/12m: D3.2 (A), U35.21 (GPA0)
/12/10m: D3.1 (K), D4.1 (K), R8.2, U14.2, U15.6 (V1), U16.6 (V1)
/15m: D2.2 (A), U35.8 (GPB7)
/17m: D1.2 (A), U35.7 (GPB6)
/17/15m: D1.1 (K), D2.1 (K), R7.2, U11.2, U12.6 (V1), U13.6 (V1)
/20m: U8.2, U9.6 (V1), U10.6 (V1), U35.6 (GPB5)
/30m: U29.2, U30.6 (V1), U31.6 (V1), U35.5 (GPB4)
/40m: U5.2, U6.6 (V1), U7.6 (V1), U35.4 (GPB3)
/60m: U26.2, U27.6 (V1), U28.6 (V1), U35.1 (GPB0)
/80m: U2.2, U3.6 (V1), U4.6 (V1), U35.3 (GPB2)
/160m: U23.2, U24.6 (V1), U25.6 (V1), U35.2 (GPB1)
/NF: U20.2, U21.6 (V1), U35.24 (GPA3)
/RF2: C101.2, C102.2, C103.2, L3.1, L101.1
/RF3: C103.1, L30.2, L102.1
/RF4: C104.2, C105.2, L4.1, L30.1, L102.2, L103.1
/RF5: C105.1, L31.2, L104.1
/RF6: C106.2, C107.1, L5.1, L31.1, L104.2, L105.1
/RF12: C201.2, C202.2, C203.2, L6.1, L201.1
/RF13: C203.1, L32.2, L202.1
/RF14: C204.2, C205.2, L7.1, L32.1, L202.2, L203.1
/RF15: C205.1, L33.2, L204.1
/RF16: C206.2, C207.1, L8.1, L33.1, L204.2, L205.1
/RF22: C301.2, C302.2, C303.2, L9.1, L301.1
/RF23: C303.1, L34.2, L302.1
/RF24: C304.2, C305.2, L10.1, L34.1, L302.2, L303.1
/RF25: C305.1, L35.2, L304.1
/RF26: C306.2, C307.1, L11.1, L35.1, L304.2, L305.1
/RF32: C401.2, C402.2, C403.2, L12.1, L401.1
/RF33: C403.1, L36.2, L402.1
/RF34: C404.2, C405.2, L13.1, L36.1, L402.2, L403.1
/RF35: C405.1, L37.2, L404.1
/RF36: C406.2, C407.1, L14.1, L37.1, L404.2, L405.1
/RF42: C501.2, C502.2, C503.2, L15.1, L501.1
/RF43: C503.1, L38.2, L502.1
/RF44: C504.2, C505.2, L16.1, L38.1, L502.2, L503.1
/RF45: C505.1, L39.2, L504.1
/RF46: C506.2, C507.1, L17.1, L39.1, L504.2, L505.1
/RF52: C601.2, C602.2, C603.2, L18.1, L601.1
/RF53: C603.1, L40.2, L602.1
/RF54: C604.2, C605.2, L19.1, L40.1, L602.2, L603.1
/RF55: C605.1, L41.2, L604.1
/RF56: C606.2, C607.1, L20.1, L41.1, L604.2, L605.1
/RF62: C91.2, C92.2, C93.2, L23.1, L91.1
/RF63: C93.1, L42.2, L92.1
/RF64: C94.2, C95.2, L22.1, L42.1, L92.2, L93.1
/RF65: C95.1, L43.2, L94.1
/RF66: C96.2, C97.1, L21.1, L43.1, L94.2, L95.1
/RF72: C191.2, C192.2, C193.2, L26.1, L191.1
/RF73: C193.1, L44.2, L192.1
/RF74: C194.2, C195.2, L25.1, L44.1, L192.2, L193.1
/RF75: C195.1, L45.2, L194.1
/RF76: C196.2, C197.1, L24.1, L45.1, L194.2, L195.1
/RF82: C291.2, C292.2, C293.2, L29.1, L291.1
/RF83: C293.1, L46.2, L292.1
/RF84: C294.2, C295.2, L28.1, L46.1, L292.2, L293.1
/RF85: C295.1, L47.2, L294.1
/RF86: C296.2, C297.1, L27.1, L47.1, L294.2, L295.1
/RF90: C5.1, J2.1 (In), JP10.1 (A)
/RF91: C8.2, J1.1 (In), JP11.1 (A)
/RF92: C6.1, J5.1 (In)
/RF93: C7.2, J6.1 (In)
/RFIN: C27.2, C90.1, C100.1, C190.1, C200.1, C290.1, C300.1, C400.1, C500.1, C600.1, JP10.2 (B), U1.5 (RFC)
/RFOUT: C98.2, C108.2, C198.2, C208.2, C298.2, C308.2, C408.2, C508.2, C608.2, C700.1, C701.2, JP11.2 (B), U36.5 (RFC)
/RRF0: C100.2, U3.1 (RF1)
/RRF1: C101.1, U3.5 (RFC)
/RRF7: C107.2, U4.5 (RFC)
/RRF8: C108.1, U4.1 (RF1)
/RRF10: C200.2, U6.1 (RF1)
/RRF11: C201.1, U6.5 (RFC)
/RRF17: C207.2, U7.5 (RFC)
/RRF18: C208.1, U7.1 (RF1)
/RRF20: C300.2, U9.1 (RF1)
/RRF21: C301.1, U9.5 (RFC)
/RRF27: C307.2, U10.5 (RFC)
/RRF28: C308.1, U10.1 (RF1)
/RRF30: C400.2, U12.1 (RF1)
/RRF31: C401.1, U12.5 (RFC)
/RRF37: C407.2, U13.5 (RFC)
/RRF38: C408.1, U13.1 (RF1)
/RRF40: C500.2, U15.1 (RF1)
/RRF41: C501.1, U15.5 (RFC)
/RRF47: C507.2, U16.5 (RFC)
/RRF48: C508.1, U16.1 (RF1)
/RRF50: C600.2, U18.1 (RF1)
/RRF51: C601.1, U18.5 (RFC)
/RRF57: C607.2, U19.5 (RFC)
/RRF58: C608.1, U19.1 (RF1)
/RRF60: C90.2, U24.1 (RF1)
/RRF61: C91.1, U24.5 (RFC)
/RRF67: C97.2, U25.5 (RFC)
/RRF68: C98.1, U25.1 (RF1)
/RRF70: C190.2, U27.1 (RF1)
/RRF71: C191.1, U27.5 (RFC)
/RRF77: C197.2, U28.5 (RFC)
/RRF78: C198.1, U28.1 (RF1)
/RRF80: C290.2, U30.1 (RF1)
/RRF81: C291.1, U30.5 (RFC)
/RRF87: C297.2, U31.5 (RFC)
/RRF88: C298.1, U31.1 (RF1)
/RRF90: C5.2, U1.1 (RF1)
/RRF91: C6.2, U1.3 (RF2)
/RRF92: C8.1, U36.1 (RF1)
/RRF93: C7.1, U36.3 (RF2)
/RRF100: C700.2, U21.3 (RF2)
/RRF101: C701.1, U21.5 (RFC)
/RRF200: C9.1, U3.3 (RF2)
/RRF201: C10.1, U6.3 (RF2)
/RRF202: C11.1, U9.3 (RF2)
/RRF203: C12.1, U12.3 (RF2)
/RRF204: C13.1, U15.3 (RF2)
/RRF205: C14.1, U18.3 (RF2)
/RRF206: C15.2, U4.3 (RF2)
/RRF207: C16.2, U7.3 (RF2)
/RRF208: C17.2, U10.3 (RF2)
/RRF209: C18.2, U13.3 (RF2)
/RRF210: C19.2, U16.3 (RF2)
/RRF211: C20.2, U19.3 (RF2)
/RRF212: C21.2, U24.3 (RF2)
/RRF213: C22.2, U27.3 (RF2)
/RRF214: C23.2, U30.3 (RF2)
/RRF215: C24.2, U25.3 (RF2)
/RRF216: C25.2, U28.3 (RF2)
/RRF217: C26.2, U31.3 (RF2)
/RRF250: C27.1, U21.1 (RF1)
/RXTX: J4.10, U1.6 (V1), U36.6 (V1), U37.2
/SCL2: J4.7, R4.1, U35.12 (SCK)
/SDA2: J4.5, R5.1, U35.13 (SDA)
/~6m: U17.4, U18.4 (V2), U19.4 (V2)
/~12/10m: U14.4, U15.4 (V2), U16.4 (V2)
/~17/15m: U11.4, U12.4 (V2), U13.4 (V2)
/~20m: U8.4, U9.4 (V2), U10.4 (V2)
/~30m: U29.4, U30.4 (V2), U31.4 (V2)
/~40m: U5.4, U6.4 (V2), U7.4 (V2)
/~60m: U26.4, U27.4 (V2), U28.4 (V2)
/~80m: U2.4, U3.4 (V2), U4.4 (V2)
/~160m: U23.4, U24.4 (V2), U25.4 (V2)
/~NF: U20.4, U21.4 (V2)
/~RXTX: U1.4 (V2), U36.4 (V2), U37.4
GND: C1.2, C2.2, C3.2, C4.2, C9.2, C10.2, C11.2, C12.2, C13.2, C14.2, C15.1, C16.1, C17.1, C18.1, C19.1, C20.1, C21.1, C22.1, C23.1, C24.1, C25.1, C26.1, C41.1, C92.1, C94.1, C96.1, C102.1, C104.1, C106.1, C192.1, C194.1, C196.1, C202.1, C204.1, C206.1, C292.1, C294.1, C296.1, C302.1, C304.1, C306.1, C402.1, C404.1, C406.1, C502.1, C504.1, C506.1, C602.1, C604.1, C606.1, H1.1, H2.1, J1.2 (Ext), J2.2 (Ext), J3.2, J4.9, J5.2 (Ext), J6.2 (Ext), L3.2, L4.2, L5.2, L6.2, L7.2, L8.2, L9.2, L10.2, L11.2, L12.2, L13.2, L14.2, L15.2, L16.2, L17.2, L18.2, L19.2, L20.2, L21.2, L22.2, L23.2, L24.2, L25.2, L26.2, L27.2, L28.2, L29.2, L91.2, L93.2, L95.2, L101.2, L103.2, L105.2, L191.2, L193.2, L195.2, L201.2, L203.2, L205.2, L291.2, L293.2, L295.2, L301.2, L303.2, L305.2, L401.2, L403.2, L405.2, L501.2, L503.2, L505.2, L601.2, L603.2, L605.2, R1.1, R2.1, R3.1, R7.1, R8.1, U1.2 (GND), U2.3 (GND), U3.2 (GND), U4.2 (GND), U5.3 (GND), U6.2 (GND), U7.2 (GND), U8.3 (GND), U9.2 (GND), U10.2 (GND), U11.3 (GND), U12.2 (GND), U13.2 (GND), U14.3 (GND), U15.2 (GND), U16.2 (GND), U17.3 (GND), U18.2 (GND), U19.2 (GND), U20.3 (GND), U21.2 (GND), U22.1 (GND), U23.3 (GND), U24.2 (GND), U25.2 (GND), U26.3 (GND), U27.2 (GND), U28.2 (GND), U29.3 (GND), U30.2 (GND), U31.2 (GND), U35.10 (VSS), U36.2 (GND), U37.3 (GND)
unnamed: J3.1, L1.1
unnamed: JP2.1 (A), R1.2, U35.15 (A0)
unnamed: JP3.1 (A), R2.2, U35.16 (A1)
unnamed: JP4.1 (A), R3.2, U35.17 (A2)
unnamed: C3.1, C4.1, L2.2, TP15.1, U22.2 (VO)
unnamed: R6.1, U35.18 (~RESET)

Notes on the sheet:
BPF Band Select
Power
Board mounting holes
16T T37-0 9"
22T T37-1 12"
34T T37-0 18"
18T T37-10 10"
20m
June 1 2024: VK3PE Corrected wire length for L91 and L95 July 30 2024: VK3PE Added some notes August 25 2024: KI3P Clarified instructions in red box
Added for backwards compatibility with V010/V011 LPF boards and V012 second receiver operation. Only populate if using V012 2nd receiver or with V010/V011 LPF boards.
22T T37-10 12"
22T T37-0 12"
26T T37-6 14"
17T T37-0 9"
9T T37-0 5"
16T T37-0 9"
14t FT37-61 14"
ALL TOROIDS WOUND WITH #28 WIRE 0.32mm
27T T37-6 14"
38T T37-10 20"
26T T37-0 14"
13T T37-0 7"
12/10m
17T T37-10 11"
A2 A1 A0 ADDR 0 0 0 0x20 0 0 1 0x21 0 1 0 0x22 0 1 1 0x23 1 0 0 0x24 1 0 1 0x25 1 1 0 0x26 1 1 1 0x27
1.5nF+100p
RFCONTROL SIGNALS: RxTx: H=Tx, L=Rx
From BANDS connector on Main
25T T37-1 13"
ADDRESS SELECT
21T T37-0 11"
30m
17/15m
Solder JP10 and JP11 closed if using V012 LPF boards and single receiver
160m
7T T37-0 4"
10T T37-2 6"
40m
26T T37-1 14"
20T T37-10 11"
60m
Bypass
80m
20t T37-10 11"

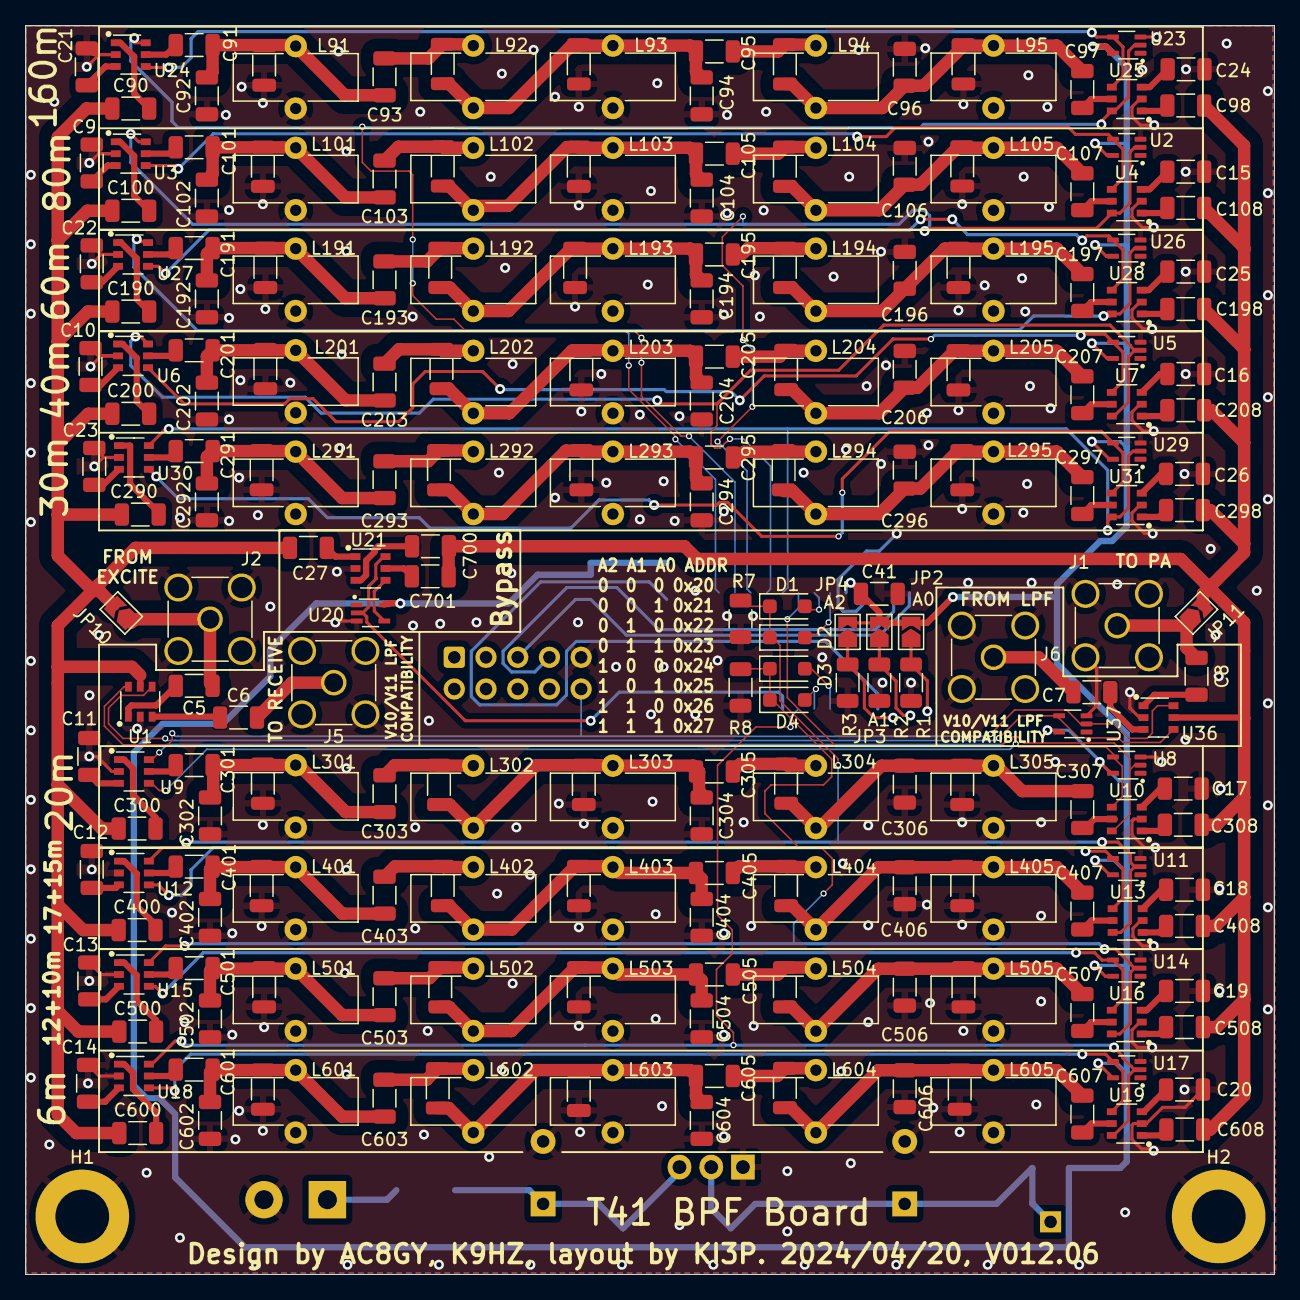
[picture p370: board T41-exciter-filter-board.kicad_pcb from above]

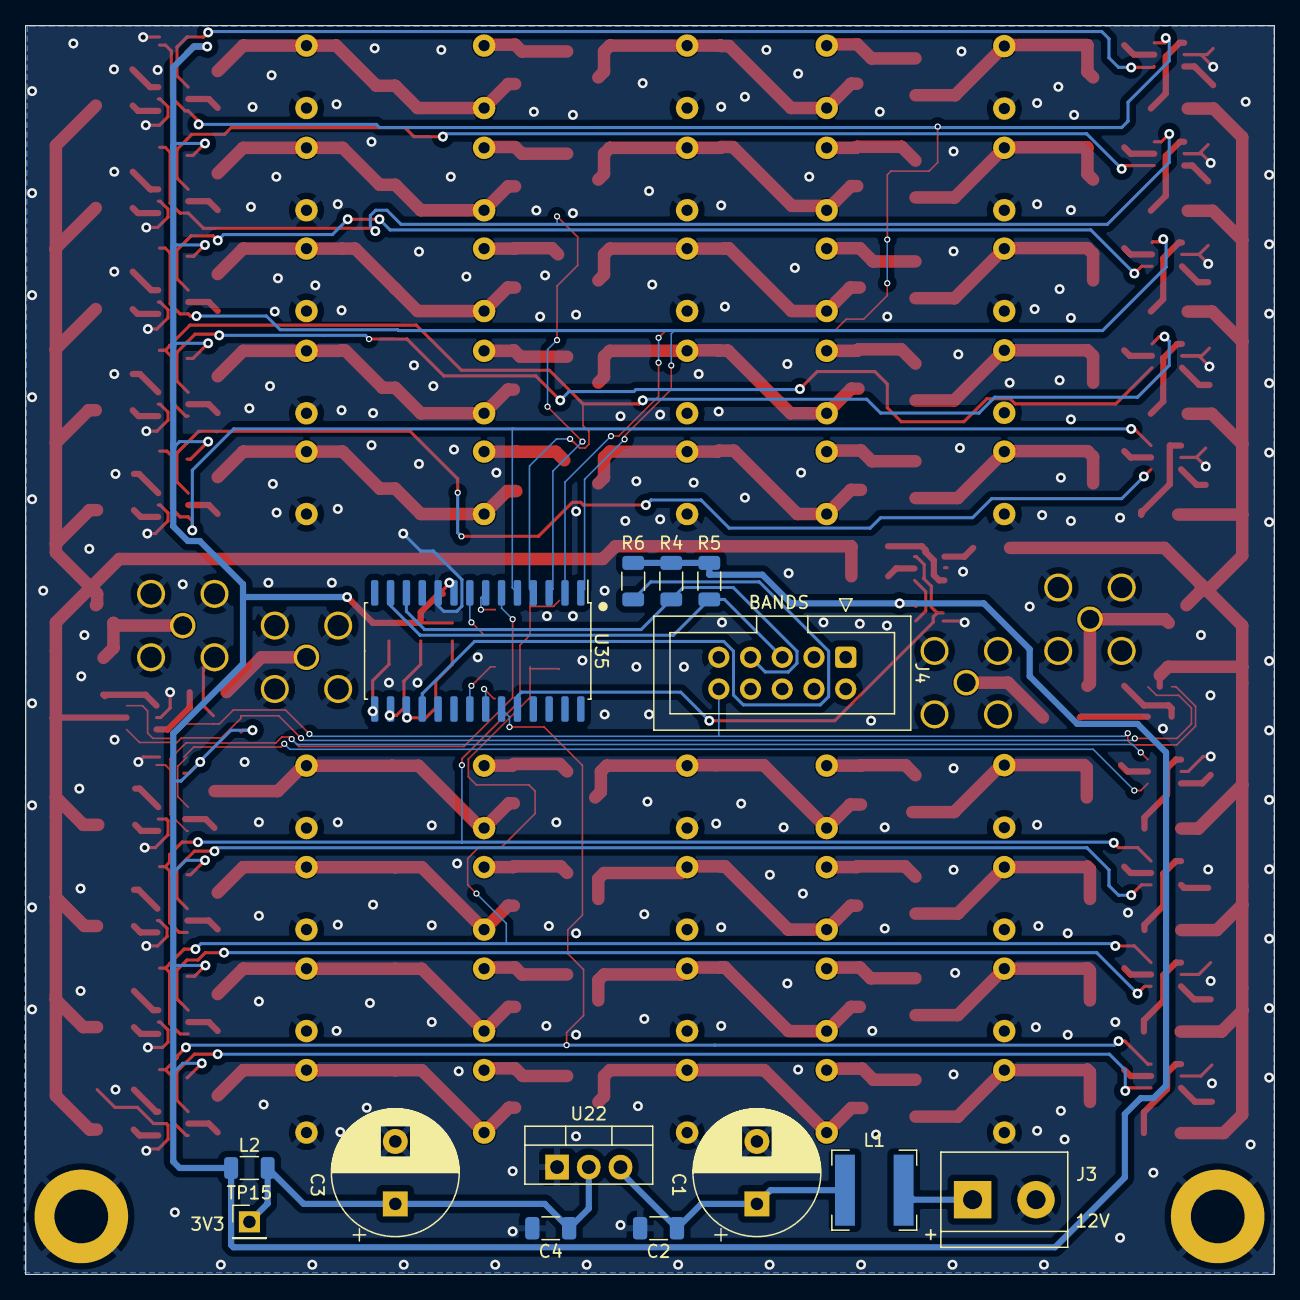
[picture p371: board T41-exciter-filter-board.kicad_pcb from below]

Board: 2 copper layers, 100.0 x 100.0 mm, 263 parts (14 on the bottom side), 149 nets.
