DRWJSCHMIDT/T41/T41_V012_Files/T41_V012_PCBs/T41_V012_PCBs_KiCad/T41-Single-PE4312-Attenuator-daughterboard/T41-Single-PE4312-Attenuator-daughterboard.kicad_pcb

## KiCad design T41_V012_Files/T41_V012_PCBs/T41_V012_PCBs_KiCad/T41-Single-PE4312-Attenuator-daughterboard/T41-Single-PE4312-Attenuator-daughterboard.kicad_pcb (2026-07-07)

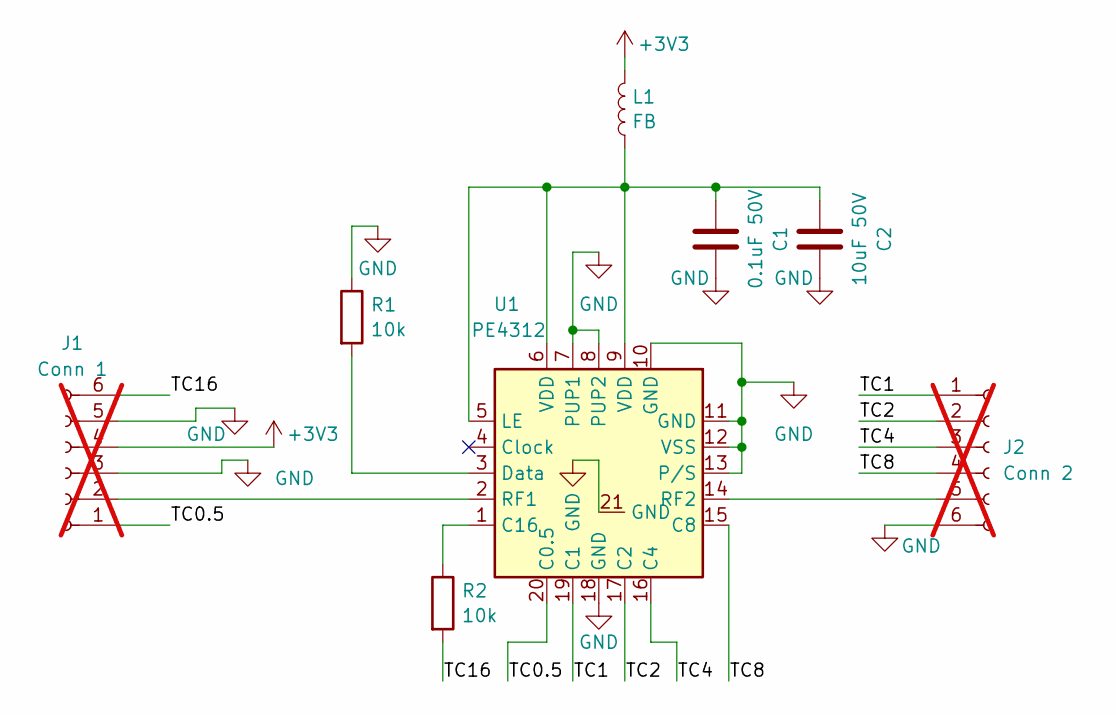
[picture p374: schematic T41-Single-PE4312-Attenuator-daughterboard.kicad_sch, T41 RF Board Attenuator Daughterboard]

Parts:
C1: 0.1uF 50V; C_0603_1608Metric; LCSC C14663
C2: 10uF 50V; C_0603_1608Metric; LCSC C96446
J1: Conn 1; PinHeader_1x06_P2.54mm_Vertical; not fitted
J2: Conn 2; PinHeader_1x06_P2.54mm_Vertical; not fitted
L1: FB; R_0603_1608Metric; LCSC C1002
R1, R2: 10k; R_0603_1608Metric; LCSC C25804
U1: PE4312; PE4312-QFN-20; LCSC C500480

Connections:
+3V3: J1.4, L1.1
/TC0.5: J1.1, U1.20 (C0.5)
/TC1: J2.1, U1.19 (C1)
/TC2: J2.2, U1.17 (C2)
/TC4: J2.3, U1.16 (C4)
/TC8: J2.4, U1.15 (C8)
/TC16: J1.6, R2.2
GND: C1.1, C2.1, J1.3, J1.5, J2.6, R1.1, U1.7 (PUP1), U1.8 (PUP2), U1.10 (GND), U1.11 (GND), U1.12 (VSS), U1.13 (P/S), U1.18 (GND), U1.21 (GND)
unnamed: J1.2, U1.2 (RF1)
unnamed: J2.5, U1.14 (RF2)
unnamed: R2.1, U1.1 (C16)
unnamed: R1.2, U1.3 (Data)
unnamed: C1.2, C2.2, L1.2, U1.5 (LE), U1.6 (VDD), U1.9 (VDD)

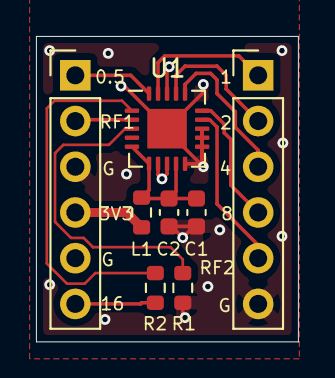
[picture p375: board T41-Single-PE4312-Attenuator-daughterboard.kicad_pcb from above]

Board: 2 copper layers, 14.6 x 17.0 mm, 8 parts (0 on the bottom side), 13 nets.
