DRWJSCHMIDT/T41/T41_V012_Files/T41_V012_PCBs/T41_V012_PCBs_KiCad/Old FIles/T41-RF-board-Dual-Attenuator-daughterboard-OH5KB/T41-RF-board-Dual-Attenuator-daughterboard.kicad_pcb

## KiCad design T41_V012_Files/T41_V012_PCBs/T41_V012_PCBs_KiCad/Old FIles/T41-RF-board-Dual-Attenuator-daughterboard-OH5KB/T41-RF-board-Dual-Attenuator-daughterboard.kicad_pcb (2026-04-17, an earlier design)

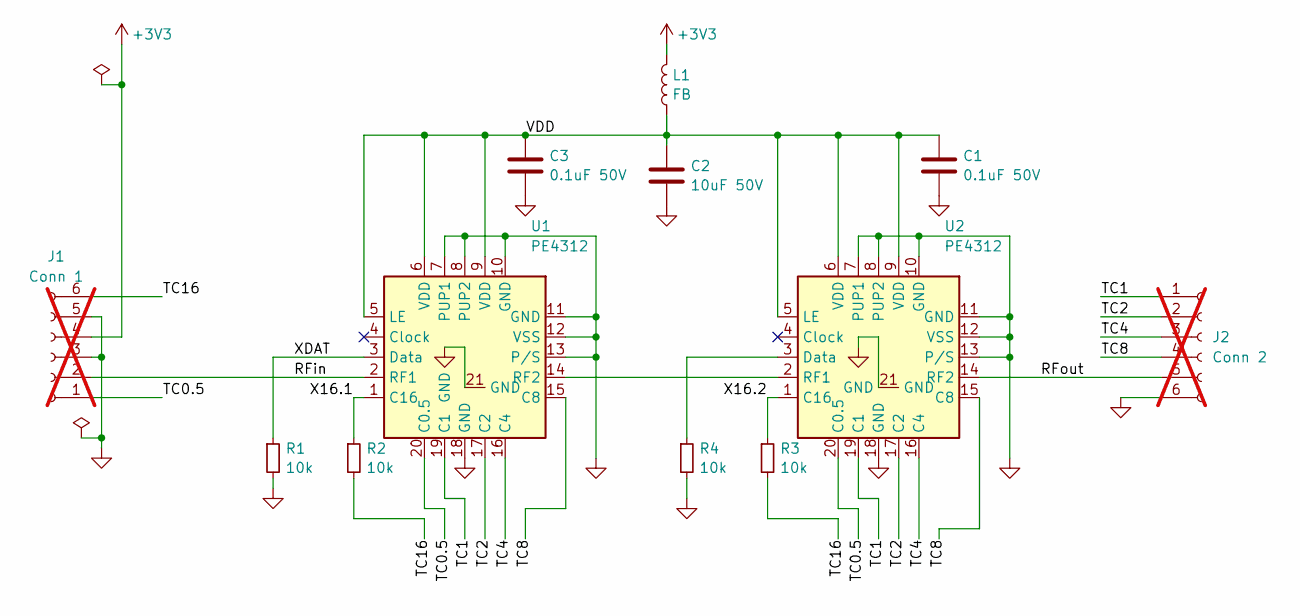
[picture p376: schematic T41-RF-board-Dual-Attenuator-daughterboard.kicad_sch, T41 RF Board Attenuator Daughterboard]

Parts:
C1, C3: 0.1uF 50V; C_0603_1608Metric; LCSC C14663
C2: 10uF 50V; C_0603_1608Metric; LCSC C96446
J1: Conn 1; PinHeader_1x06_P2.54mm_Vertical; not fitted
J2: Conn 2; PinHeader_1x06_P2.54mm_Vertical; not fitted
L1: FB; R_0603_1608Metric; LCSC C1002
R1, R2, R3, R4: 10k; R_0603_1608Metric; LCSC C25804
U1, U2: PE4312; PE4312-QFN-20; LCSC C500480

Connections:
+3V3: J1.4, L1.1
/RFin: J1.2, U1.2 (RF1)
/RFout: J2.5, U2.14 (RF2)
/TC0.5: J1.1, U1.20 (C0.5), U2.20 (C0.5)
/TC1: J2.1, U1.19 (C1), U2.19 (C1)
/TC2: J2.2, U1.17 (C2), U2.17 (C2)
/TC4: J2.3, U1.16 (C4), U2.16 (C4)
/TC8: J2.4, U1.15 (C8), U2.15 (C8)
/TC16: J1.6, R2.2, R3.2
/VDD: C1.2, C2.2, C3.2, L1.2, U1.5 (LE), U1.6 (VDD), U1.9 (VDD), U2.5 (LE), U2.6 (VDD), U2.9 (VDD)
/X16.1: R2.1, U1.1 (C16)
/X16.2: R3.1, U2.1 (C16)
/XDAT: R1.1, U1.3 (Data)
GND: C1.1, C2.1, C3.1, J1.3, J1.5, J2.6, R1.2, R4.2, U1.7 (PUP1), U1.8 (PUP2), U1.10 (GND), U1.11 (GND), U1.12 (VSS), U1.13 (P/S), U1.18 (GND), U1.21 (GND), U2.7 (PUP1), U2.8 (PUP2), U2.10 (GND), U2.11 (GND), U2.12 (VSS), U2.13 (P/S), U2.18 (GND), U2.21 (GND)
unnamed: U1.14 (RF2), U2.2 (RF1)
unnamed: R4.1, U2.3 (Data)

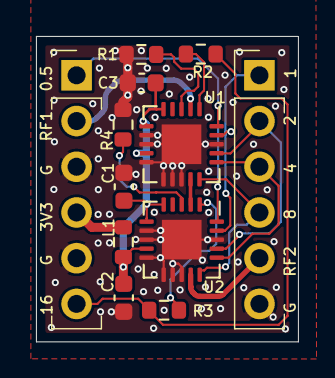
[picture p377: board T41-RF-board-Dual-Attenuator-daughterboard.kicad_pcb from above]

Board: 2 copper layers, 14.6 x 17.0 mm, 12 parts (0 on the bottom side), 16 nets.
