DRWJSCHMIDT/T41/T41_V012_Files/T41_V012_PCBs/T41_V012_PCBs_KiCad/Old FIles/T41-RF-board-DualClock-daughterboard-OH5KB/DualClockLO.kicad_pcb

## KiCad design T41_V012_Files/T41_V012_PCBs/T41_V012_PCBs_KiCad/Old FIles/T41-RF-board-DualClock-daughterboard-OH5KB/DualClockLO.kicad_pcb (2026-04-17, an earlier design)

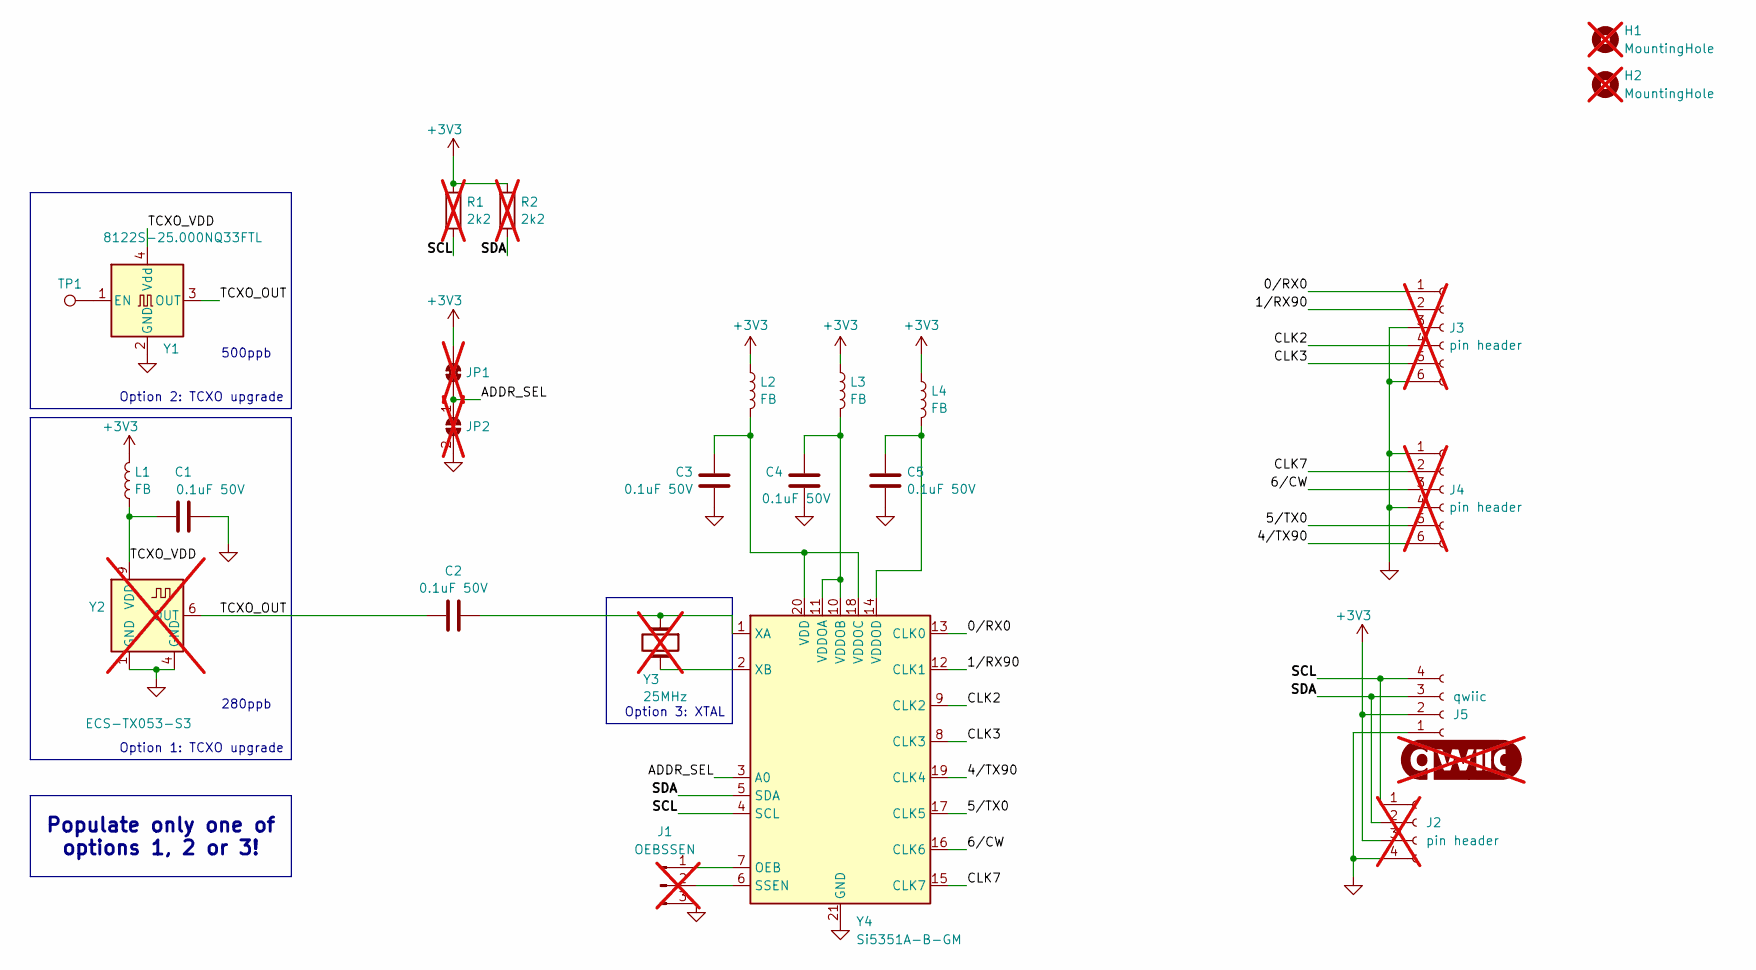
[picture p378: schematic DualClockLO.kicad_sch, Si5351A-B-GM Breakout Board]

Parts:
C1, C2, C3, C4, C5: 0.1uF 50V; C_0603_1608Metric; LCSC C14663
G1: qwiic_Logo; qwiic_4mm; not fitted
H1, H2: MountingHole; MountingHole_2.2mm_M2_DIN965; not fitted
J1: OEBSSEN; PinHeader_1x03_P2.54mm_Vertical; not fitted
J2: pin header; PinHeader_1x04_P2.54mm_Vertical; not fitted
J3, J4: pin header; PinHeader_1x06_P2.54mm_Vertical; not fitted
J5: qwiic; JST_SH_SM04B-SRSS-TB_1x04-1MP_P1.00mm_Horizontal; LCSC C160404
JP1: GND select; SolderJumper-2_P1.3mm_Bridged_RoundedPad1.0x1.5mm; not fitted
JP2: SolderJumper_2_Open; SolderJumper-2_P1.3mm_Open_TrianglePad1.0x1.5mm; not fitted
L1, L2, L3, L4: FB; L_0603_1608Metric; LCSC C1002
R1, R2: 2k2; R_0603_1608Metric; LCSC C4190; not fitted
TP1: TestPoint; TestPoint_Pad_1.5x1.5mm
Y1: 8122S-25.000NQ33FTL; Oscillator_SMD_Abracon_ASE-4Pin_3.2x2.5mm; LCSC C20623084
Y2: ECS-TX053-S3; Oscillator_ECS_TXO53_S3; LCSC C18457614; not fitted
Y3: 25MHz; Crystal_SMD_HC49-SD_HandSoldering; not fitted
Y4: Si5351A-B-GM; QFN-20-1EP_4x4mm_P0.5mm_EP2.7x2.7mm; LCSC C22413806

Connections:
+3V3: J2.3, J5.2, JP1.1 (A), L1.2, L2.1, L3.1, L4.1, R1.1, R2.1
/0/RX0: J3.1, Y4.13 (CLK0)
/1/RX90: J3.2, Y4.12 (CLK1)
/4/TX90: J4.6, Y4.19 (CLK4)
/5/TX0: J4.5, Y4.17 (CLK5)
/6/CW: J4.3, Y4.16 (CLK6)
/ADDR_SEL: JP1.2 (B), JP2.1 (A), Y4.3 (A0)
/CLK2: J3.4, Y4.9 (CLK2)
/CLK3: J3.5, Y4.8 (CLK3)
/CLK7: J4.2, Y4.15 (CLK7)
/SCL: J2.1, J5.4, R1.2, Y4.4 (SCL)
/SDA: J2.2, J5.3, R2.2, Y4.5 (SDA)
/TCXO_OUT: C2.2, Y1.3 (OUT), Y2.6 (OUT)
/TCXO_VDD: C1.1, L1.1, Y1.4 (Vdd), Y2.9 (VDD)
GND: C1.2, C3.2, C4.2, C5.2, J1.3, J2.4, J3.3, J3.6, J4.1, J4.4, J5.1, JP2.2 (B), Y1.2 (GND), Y2.1 (GND), Y2.4 (GND), Y4.21 (GND)
unnamed: J1.1, Y4.7 (OEB)
unnamed: J1.2, Y4.6 (SSEN)
unnamed: TP1.1, Y1.1 (EN)
unnamed: C3.1, L2.2, Y4.18 (VDDOC), Y4.20 (VDD)
unnamed: C4.1, L3.2, Y4.10 (VDDOB), Y4.11 (VDDOA)
unnamed: C5.1, L4.2, Y4.14 (VDDOD)
unnamed: C2.1, Y3.1, Y4.1 (XA)
unnamed: Y3.2, Y4.2 (XB)

Notes on the sheet:
500ppb
280ppb
Populate only one of options 1, 2 or 3!
Option 2: TCXO upgrade
Option 1: TCXO upgrade
Option 3: XTAL

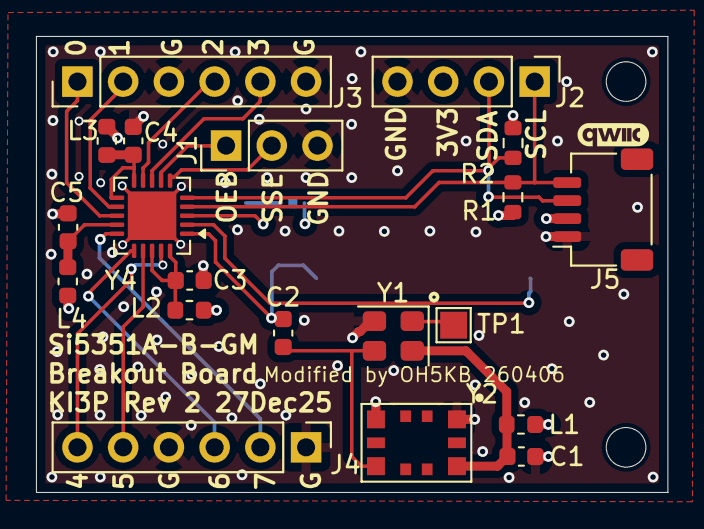
[picture p379: board DualClockLO.kicad_pcb from above]

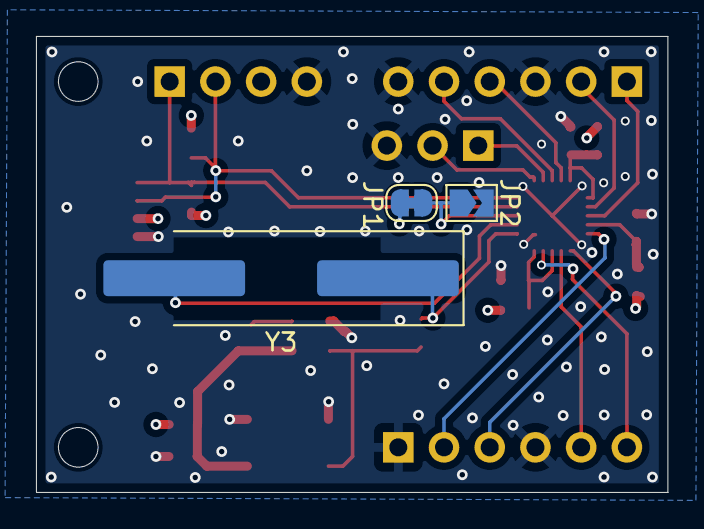
[picture p380: board DualClockLO.kicad_pcb from below]

Board: 4 copper layers, 35.1 x 25.3 mm, 26 parts (3 on the bottom side), 23 nets.
