DRWJSCHMIDT/T41/T41_V012_Files/T41_V012_PCBs/T41_V012_PCBs_KiCad/T41-Second-receiver-adapter_V12.6/T41-Second-receiver-adapter.kicad_pcb

## KiCad design T41_V012_Files/T41_V012_PCBs/T41_V012_PCBs_KiCad/T41-Second-receiver-adapter_V12.6/T41-Second-receiver-adapter.kicad_pcb (2024-04-15)

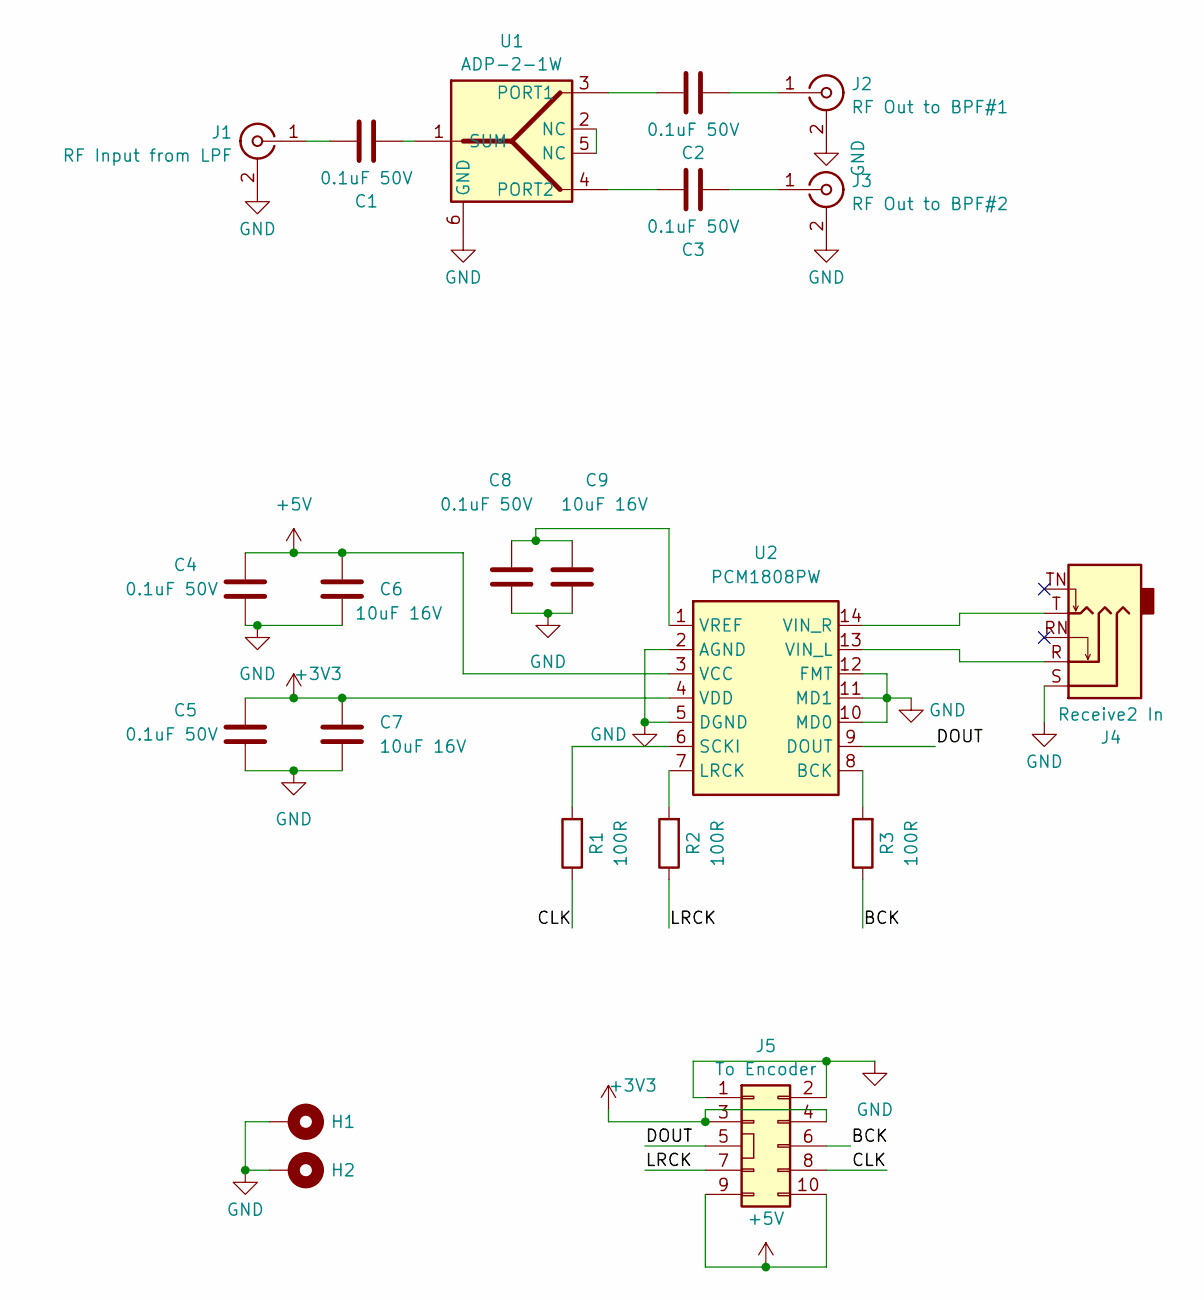
[picture p384: schematic T41-Second-receiver-adapter.kicad_sch, T41 Second Receiver Adapter Board]

Parts:
C1, C2, C3: 0.1uF 50V; C_1206_3216Metric
C4, C5, C8: 0.1uF 50V; C_1206_3216Metric; Mouser C1206C104K5RACTU
C6, C7, C9: 10uF 16V; C_1206_3216Metric; Mouser 80-C1206C106K4P
H1, H2: MountingHole_4.3mm_M4_DIN965_Pad
J1: RF Input from LPF; SMA_Amphenol_901-144_Vertical; Mouser Part Number 712-CONSMA001-G
J2: RF Out to BPF#1; SMA_Amphenol_901-144_Vertical; Mouser Part Number 712-CONSMA001-G
J3: RF Out to BPF#2; SMA_Amphenol_901-144_Vertical; Mouser Part Number 712-CONSMA001-G
J4: Receive2 In; Jack_3.5mm_STX-3081_Horizontal
J5: To Encoder; IDC-Header_2x05_P2.54mm_Vertical
R1, R2, R3: 100R; R_1206_3216Metric; Mouser 652-CR1206FX-1000ELF
U1: ADP-2-1W; Mini-Circuits_CD636_H4.11mm
U2: PCM1808PW; TSSOP-14_4.4x5mm_P0.65mm; Mouser 595-PCM1808PW

Connections:
+3V3: C5.1, C7.1, J5.3, J5.4, U2.4 (VDD)
+5V: C4.1, C6.1, J5.9, J5.10, U2.3 (VCC)
/BCK: J5.6, R3.1
/CLK: J5.8, R1.1
/DOUT: J5.5, U2.9 (DOUT)
/LRCK: J5.7, R2.1
GND: C4.2, C5.2, C6.2, C7.2, C8.2, C9.2, H1.1, H2.1, J1.2 (Ext), J2.2 (Ext), J3.2 (Ext), J4.S, J5.1, J5.2, U1.6 (GND), U2.2 (AGND), U2.5 (DGND), U2.10 (MD0), U2.11 (MD1), U2.12 (FMT)
unnamed: C1.1, J1.1 (In)
unnamed: C2.2, J2.1 (In)
unnamed: C3.2, J3.1 (In)
unnamed: U1.2 (NC), U1.5 (NC)
unnamed: C2.1, U1.3 (PORT1)
unnamed: C3.1, U1.4 (PORT2)
unnamed: C1.2, U1.1 (SUM)
unnamed: R3.2, U2.8 (BCK)
unnamed: R2.2, U2.7 (LRCK)
unnamed: R1.2, U2.6 (SCKI)
unnamed: J4.R, U2.13 (VIN_L)
unnamed: J4.T, U2.14 (VIN_R)
unnamed: C8.1, C9.1, U2.1 (VREF)

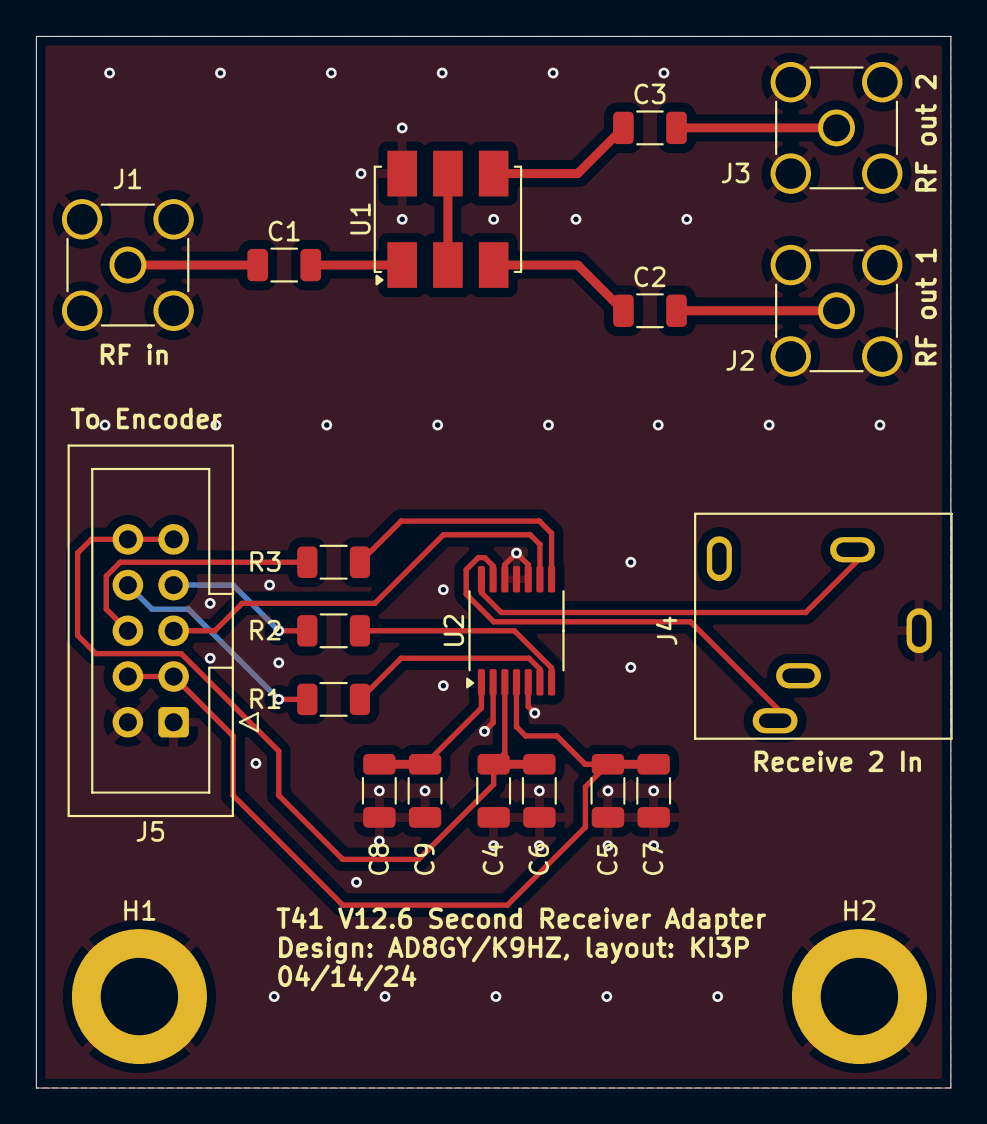
[picture p385: board T41-Second-receiver-adapter.kicad_pcb from above]

Board: 2 copper layers, 50.8 x 58.4 mm, 21 parts (0 on the bottom side), 20 nets.
