DRWJSCHMIDT/T41/T41_V012_Mini_Files/T41_V012_Mini_Projects/T41 mini-LPF+PA-board-V012/T41-mini-LPF+PA-board-V012.kicad_pcb

## KiCad design T41_V012_Mini_Files/T41_V012_Mini_Projects/T41 mini-LPF+PA-board-V012/T41-mini-LPF+PA-board-V012.kicad_pcb (2024-02-05)

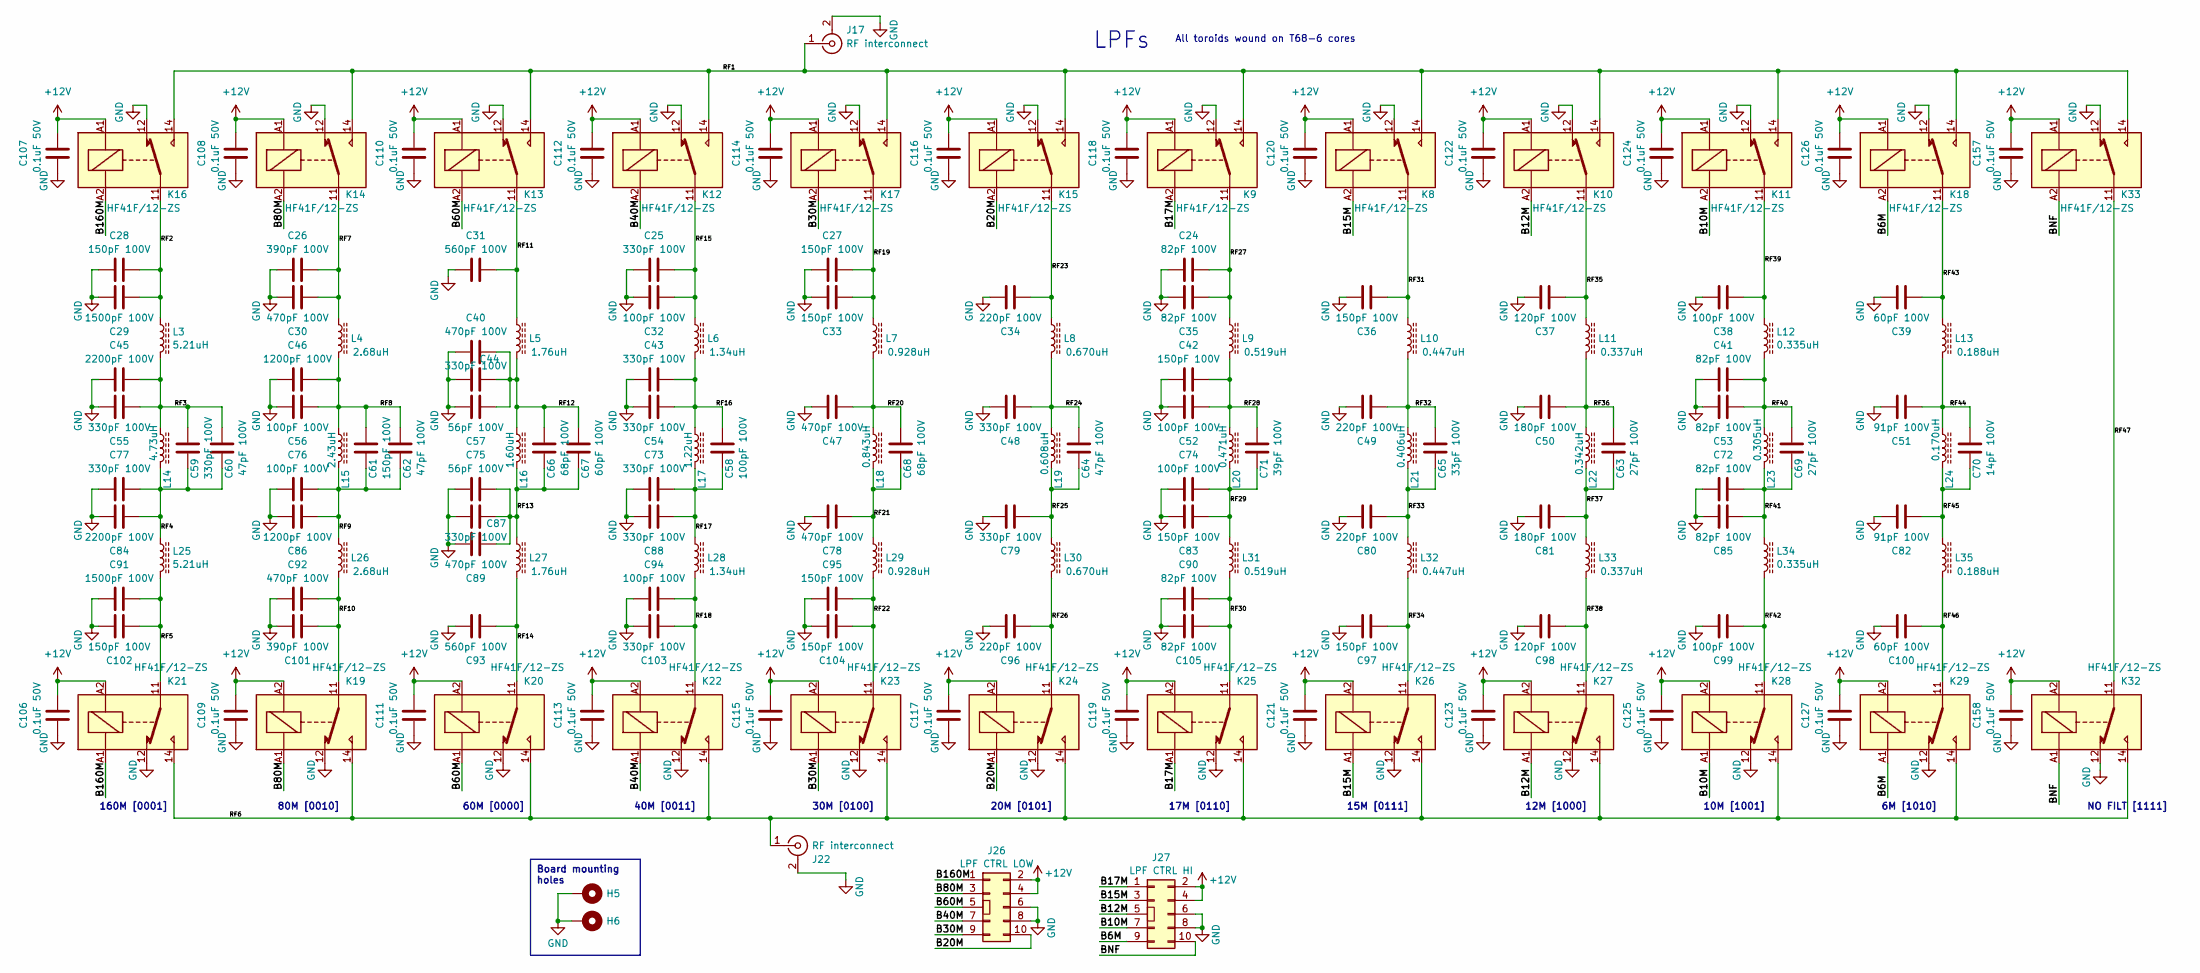
[picture p390: schematic T41-mini-LPF+PA-board-V012.kicad_sch, K9HZ 100W 11 Band LPF: Filter board]

Parts:
C24, C35, C41, C53, C72, C85, C90, C105: 82pF 100V; C_1206_3216Metric; Mouser Part Number 80-C1206C820J1G
C25, C43, C44, C48, C54, C55, C59, C73, C77, C79, C87, C88, C103: 330pF 100V; C_1206_3216Metric; Mouser Part Number 581-12061A331JAT4A
C26, C101: 390pF 100V; C_1206_3216Metric; Mouser Part Number 80-C1206C391J1G
C27, C28, C33, C36, C42, C61, C83, C95, C97, C102, C104: 150pF 100V; C_1206_3216Metric; Mouser Part Number 80-C1206C151J1G
C29, C91: 1500pF 100V; C_1206_3216Metric; Mouser Part Number 80-C1206C152J1GECAUT
C30, C40, C47, C78, C89, C92: 470pF 100V; C_1206_3216Metric; Mouser Part Number 80-C1206C471J1GAC
C31, C93: 560pF 100V; C_1206_3216Metric; Mouser Part Number 581-12061C561JAT2A
C32, C38, C52, C56, C58, C74, C76, C94, C99: 100pF 100V; C_1206_3216Metric; Mouser Part Number 80-C1206C101J1GAULR
C34, C49, C80, C96: 220pF 100V; C_1206_3216Metric; Mouser Part Number 80-C1206C221J1GAC
C37, C98: 120pF 100V; C_1206_3216Metric; Mouser Part Number 77-VJ1206A121JXBMT
C39, C67, C100: 60pF 100V; C_1206_3216Metric; Mouser Part Number 80-C1206C620J1G
C45, C84: 2200pF 100V; C_1206_3216Metric; Mouser Part Number 81-GRM319R72A222JA1D
C46, C86: 1200pF 100V; C_1206_3216Metric; Mouser Part Number 581-12061C122JAT2A
C50, C81: 180pF 100V; C_1206_3216Metric; Mouser Part Number 80-C1206C181J1G
C51, C82: 91pF 100V; C_1206_3216Metric; Mouser Part Number 80-C1206C910J1G
C57, C75: 56pF 100V; C_1206_3216Metric; Mouser Part Number 80-C1206C560J1G
C60, C62, C64: 47pF 100V; C_1206_3216Metric; Mouser Part Number 80-C1206C470J1GAC
C63, C69: 27pF 100V; C_1206_3216Metric; Mouser Part Number 80-C1206C270J1G
C65: 33pF 100V; C_1206_3216Metric; Mouser Part Number 80-C1206C330J1G
C66, C68: 68pF 100V; C_1206_3216Metric; Mouser Part Number 80-C1206C680J1G
C70: 14pF 100V; C_1206_3216Metric; Mouser Part Number 80-C1206C150J1G
C71: 39pF 100V; C_1206_3216Metric; Mouser Part Number 80-C1206C390J1G
C106, C107, C108, C109, C110, C111, C112, C113, C114, C115, C116, C117, C118, C119, C120, C121, C122, C123, C124, C125, C126, C127, C157, C158: 0.1uF 50V; C_1206_3216Metric; Mouser Part Number 581-12065F104K4
H5, H6: MountingHole_4.3mm_M4_DIN965_Pad
J17, J22: RF interconnect; SMA_Amphenol_901-144_Vertical; Mouser Part Number 712-CONSMA001-G
J26: LPF CTRL LOW; IDC-Header_2x05_P2.54mm_Vertical
J27: LPF CTRL HI; IDC-Header_2x05_P2.54mm_Vertical
K8, K9, K10, K11, K12, K13, K14, K15, K16, K17, K18, K19, K20, K21, K22, K23, K24, K25, K26, K27, K28, K29, K32, K33: HF41F/12-ZS; Relay_SPDT_HF41F12-ZS
L3, L25: 5.21uH; T68-6-toroid-vertical
L4, L26: 2.68uH; T68-6-toroid-vertical
L5, L27: 1.76uH; T68-6-toroid-vertical
L6, L28: 1.34uH; T68-6-toroid-vertical
L7, L29: 0.928uH; T68-6-toroid-vertical
L8, L30: 0.670uH; T68-6-toroid-vertical
L9, L31: 0.519uH; T68-6-toroid-vertical
L10, L32: 0.447uH; T68-6-toroid-vertical
L11, L33: 0.337uH; T68-6-toroid-vertical
L12, L34: 0.335uH; T68-6-toroid-vertical
L13, L35: 0.188uH; T68-6-toroid-vertical
L14: 4.73uH; T68-6-toroid-vertical
L15: 2.43uH; T68-6-toroid-vertical
L16: 1.60uH; T68-6-toroid-vertical
L17: 1.22uH; T68-6-toroid-vertical
L18: 0.843uH; T68-6-toroid-vertical
L19: 0.608uH; T68-6-toroid-vertical
L20: 0.471uH; T68-6-toroid-vertical
L21: 0.406uH; T68-6-toroid-vertical
L22: 0.342uH; T68-6-toroid-vertical
L23: 0.305uH; T68-6-toroid-vertical
L24: 0.170uH; T68-6-toroid-vertical

Connections:
+12V: C106.1, C107.1, C108.1, C109.1, C110.1, C111.1, C112.1, C113.1, C114.1, C115.1, C116.1, C117.1, C118.1, C119.1, C120.1, C121.1, C122.1, C123.1, C124.1, C125.1, C126.1, C127.1, C157.1, C158.1, J26.2, J26.4, J27.2, J27.4, K8.A1, K9.A1, K10.A1, K11.A1, K12.A1, K13.A1, K14.A1, K15.A1, K16.A1, K17.A1, K18.A1, K19.A2, K20.A2, K21.A2, K22.A2, K23.A2, K24.A2, K25.A2, K26.A2, K27.A2, K28.A2, K29.A2, K32.A2, K33.A1
/B6M: J27.9, K18.A2, K29.A1
/B10M: J27.7, K11.A2, K28.A1
/B12M: J27.5, K10.A2, K27.A1
/B15M: J27.3, K8.A2, K26.A1
/B17M: J27.1, K9.A2, K25.A1
/B20M: J26.10, K15.A2, K24.A1
/B30M: J26.9, K17.A2, K23.A1
/B40M: J26.7, K12.A2, K22.A1
/B60M: J26.5, K13.A2, K20.A1
/B80M: J26.3, K14.A2, K19.A1
/B160M: J26.1, K16.A2, K21.A1
/BNF: J27.10, K32.A1, K33.A2
/RF1: J17.1 (In), K8.14, K9.14, K10.14, K11.14, K12.14, K13.14, K14.14, K15.14, K16.14, K17.14, K18.14, K33.14
/RF2: C28.2, C29.2, K16.11, L3.1
/RF3: C45.2, C55.2, C59.2, C60.2, L3.2, L14.1
/RF4: C59.1, C60.1, C77.2, C84.2, L14.2, L25.1
/RF5: C91.2, C102.2, K21.11, L25.2
/RF6: J22.1 (In), K19.14, K20.14, K21.14, K22.14, K23.14, K24.14, K25.14, K26.14, K27.14, K28.14, K29.14, K32.14
/RF7: C26.2, C30.2, K14.11, L4.1
/RF8: C46.2, C56.2, C61.2, C62.2, L4.2, L15.1
/RF9: C61.1, C62.1, C76.2, C86.2, L15.2, L26.1
/RF10: C92.2, C101.2, K19.11, L26.2
/RF11: C31.2, K13.11, L5.1
/RF12: C40.2, C44.2, C57.2, C66.2, C67.2, L5.2, L16.1
/RF13: C66.1, C67.1, C75.2, C87.2, C89.2, L16.2, L27.1
/RF14: C93.2, K20.11, L27.2
/RF15: C25.2, C32.2, K12.11, L6.1
/RF16: C43.2, C54.2, C58.2, L6.2, L17.1
/RF17: C58.1, C73.2, C88.2, L17.2, L28.1
/RF18: C94.2, C103.2, K22.11, L28.2
/RF19: C27.2, C33.2, K17.11, L7.1
/RF20: C47.2, C68.2, L7.2, L18.1
/RF21: C68.1, C78.2, L18.2, L29.1
/RF22: C95.2, C104.2, K23.11, L29.2
/RF23: C34.2, K15.11, L8.1
/RF24: C48.2, C64.2, L8.2, L19.1
/RF25: C64.1, C79.2, L19.2, L30.1
/RF26: C96.2, K24.11, L30.2
/RF27: C24.2, C35.2, K9.11, L9.1
/RF28: C42.2, C52.2, C71.2, L9.2, L20.1
/RF29: C71.1, C74.2, C83.2, L20.2, L31.1
/RF30: C90.2, C105.2, K25.11, L31.2
/RF31: C36.2, K8.11, L10.1
/RF32: C49.2, C65.2, L10.2, L21.1
/RF33: C65.1, C80.2, L21.2, L32.1
/RF34: C97.2, K26.11, L32.2
/RF35: C37.2, K10.11, L11.1
/RF36: C50.2, C63.2, L11.2, L22.1
/RF37: C63.1, C81.2, L22.2, L33.1
/RF38: C98.2, K27.11, L33.2
/RF39: C38.2, K11.11, L12.1
/RF40: C41.2, C53.2, C69.2, L12.2, L23.1
/RF41: C69.1, C72.2, C85.2, L23.2, L34.1
/RF42: C99.2, K28.11, L34.2
/RF43: C39.2, K18.11, L13.1
/RF44: C51.2, C70.2, L13.2, L24.1
/RF45: C70.1, C82.2, L24.2, L35.1
/RF46: C100.2, K29.11, L35.2
/RF47: K32.11, K33.11
GND: C24.1, C25.1, C26.1, C27.1, C28.1, C29.1, C30.1, C31.1, C32.1, C33.1, C34.1, C35.1, C36.1, C37.1, C38.1, C39.1, C40.1, C41.1, C42.1, C43.1, C44.1, C45.1, C46.1, C47.1, C48.1, C49.1, C50.1, C51.1, C52.1, C53.1, C54.1, C55.1, C56.1, C57.1, C72.1, C73.1, C74.1, C75.1, C76.1, C77.1, C78.1, C79.1, C80.1, C81.1, C82.1, C83.1, C84.1, C85.1, C86.1, C87.1, C88.1, C89.1, C90.1, C91.1, C92.1, C93.1, C94.1, C95.1, C96.1, C97.1, C98.1, C99.1, C100.1, C101.1, C102.1, C103.1, C104.1, C105.1, C106.2, C107.2, C108.2, C109.2, C110.2, C111.2, C112.2, C113.2, C114.2, C115.2, C116.2, C117.2, C118.2, C119.2, C120.2, C121.2, C122.2, C123.2, C124.2, C125.2, C126.2, C127.2, C157.2, C158.2, H5.1, H6.1, J17.2 (Ext), J22.2 (Ext), J26.6, J26.8, J27.6, J27.8, K8.12, K9.12, K10.12, K11.12, K12.12, K13.12, K14.12, K15.12, K16.12, K17.12, K18.12, K19.12, K20.12, K21.12, K22.12, K23.12, K24.12, K25.12, K26.12, K27.12, K28.12, K29.12, K32.12, K33.12

Notes on the sheet:
Board mounting holes
6M [1010]
160M [0001]
15M [0111]
All toroids wound on T68-6 cores
10M [1001]
30M [0100]
20M [0101]
40M [0011]
60M [0000]
LPFs
17M [0110]
12M [1000]
80M [0010]
NO FILT [1111]

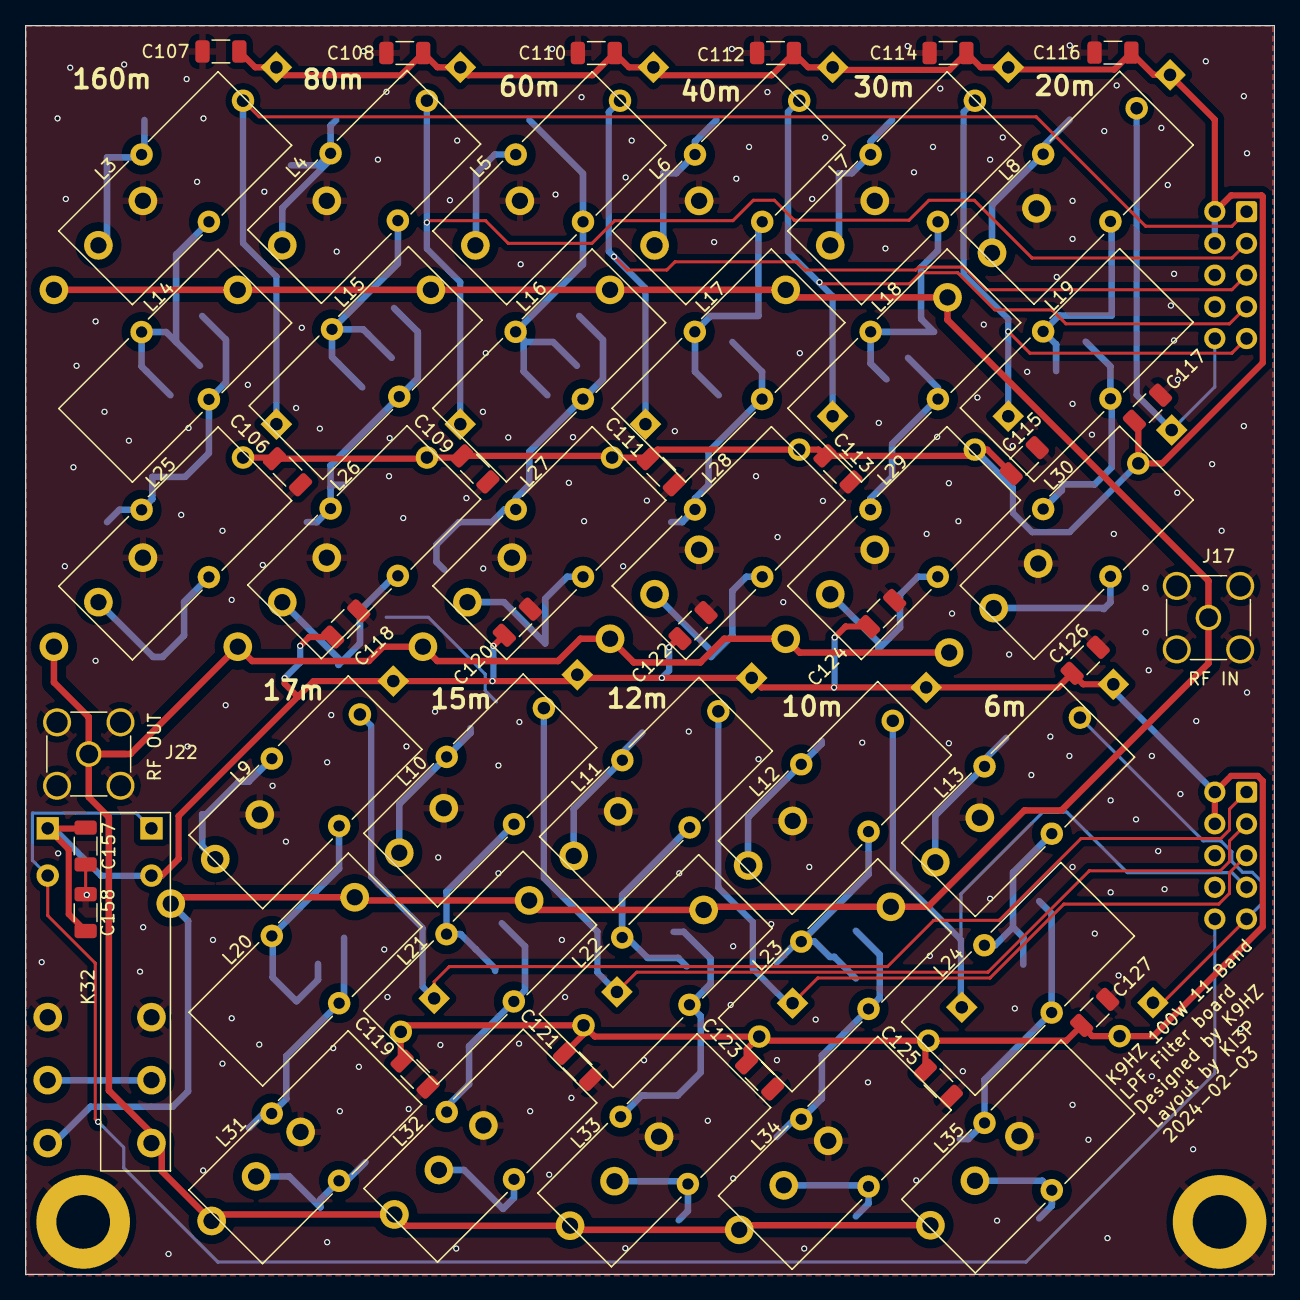
[picture p391: board T41-mini-LPF+PA-board-V012.kicad_pcb from above]

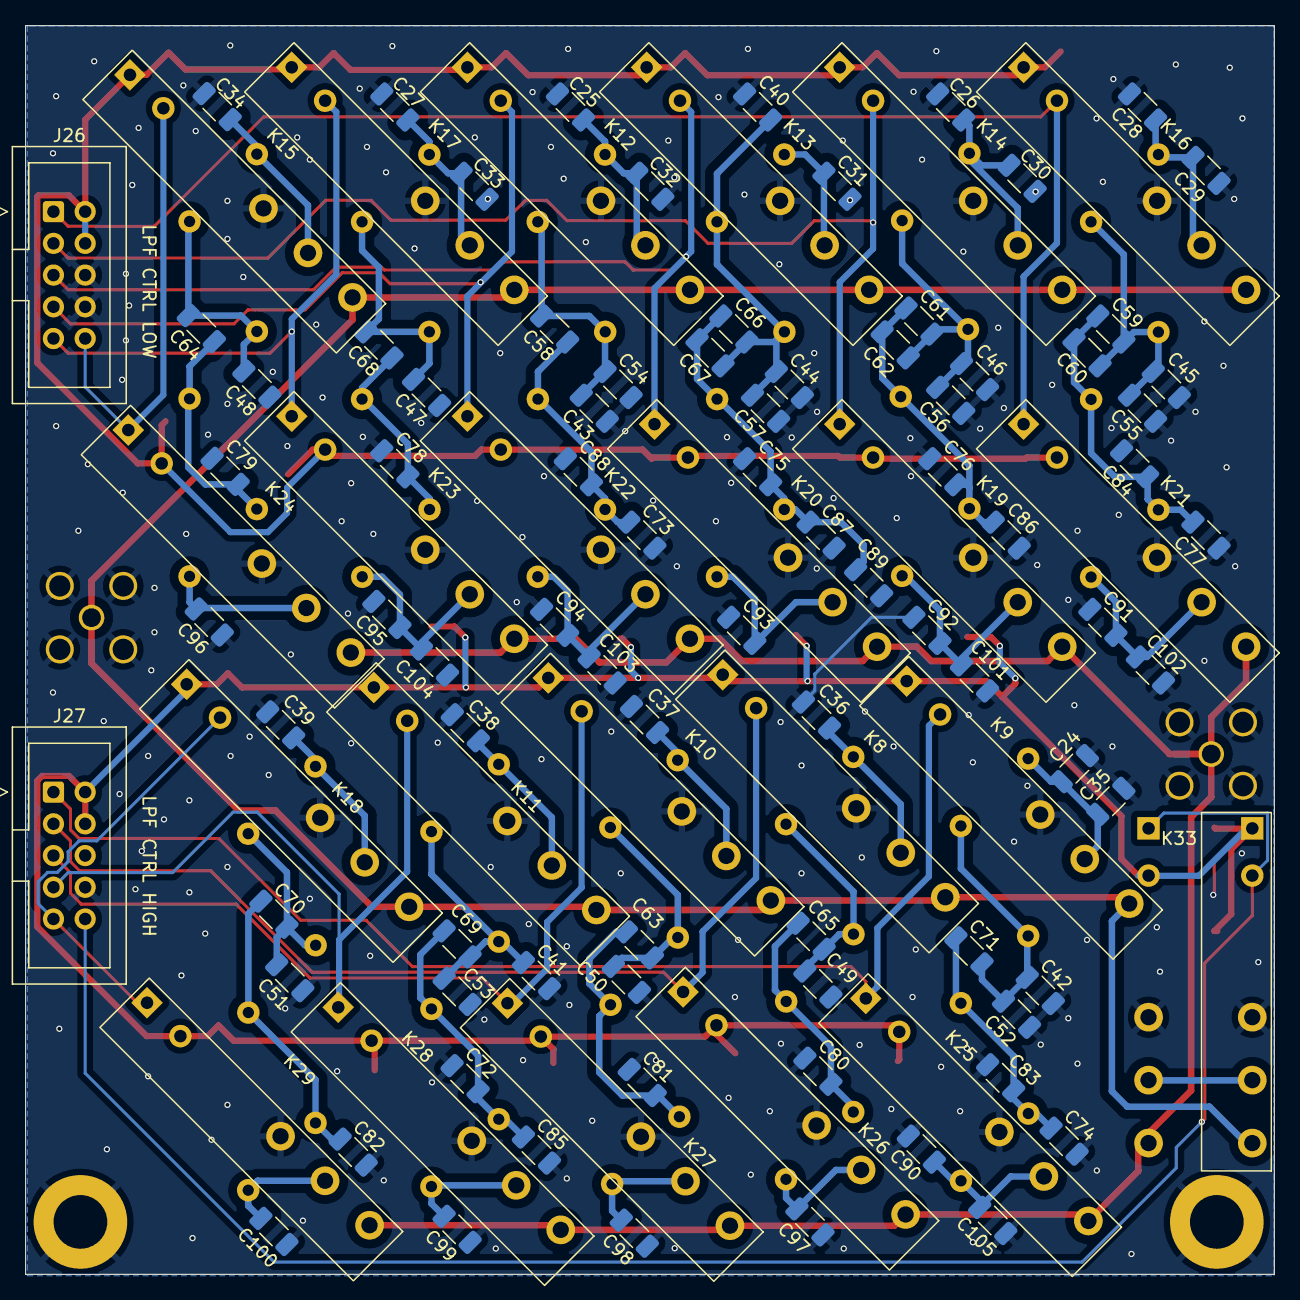
[picture p392: board T41-mini-LPF+PA-board-V012.kicad_pcb from below]

Board: 4 copper layers, 100.0 x 100.0 mm, 169 parts (107 on the bottom side), 61 nets.
