DRWJSCHMIDT/T41/T41_V012_Mini_Files/T41_V012_Mini_Board Pictures/T41-RF-board-Dual-Attenuator-daughterboard.kicad_sch

## KiCad design T41_V012_Mini_Files/T41_V012_Mini_Board Pictures/T41-RF-board-Dual-Attenuator-daughterboard.kicad_sch (2026-01-03)

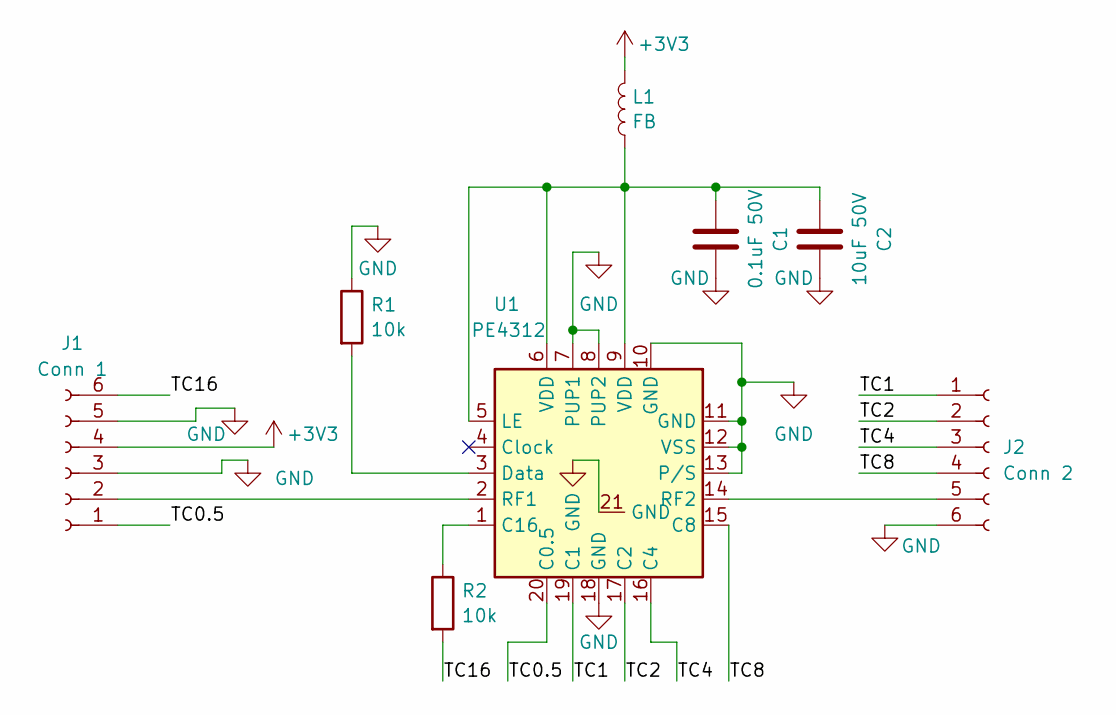
[picture p393: schematic T41-RF-board-Dual-Attenuator-daughterboard.kicad_sch]

Parts:
C1: 0.1uF 50V; C_0603_1608Metric; LCSC C14663
C2: 10uF 50V; C_0603_1608Metric; LCSC C96446
J1: Conn 1; PinHeader_1x06_P2.54mm_Vertical
J2: Conn 2; PinHeader_1x06_P2.54mm_Vertical
L1: FB; R_0603_1608Metric; LCSC C1002
R1, R2: 10k; R_0603_1608Metric; LCSC C25804
U1: PE4312; PE4312-QFN-20; LCSC C500480

Connections:
+3V3: J1.4, L1.1
GND: C1.1, C2.1, J1.3, J1.5, J2.6, R1.1, U1.7 (PUP1), U1.8 (PUP2), U1.10 (GND), U1.11 (GND), U1.12 (VSS), U1.13 (P/S), U1.18 (GND), U1.21 (GND)
unnamed: C1.2, C2.2, L1.2, U1.5 (LE), U1.6 (VDD), U1.9 (VDD)
unnamed: J1.2, U1.2 (RF1)
unnamed: J2.5, U1.14 (RF2)
unnamed: R1.2, U1.3 (Data)
unnamed: R2.1, U1.1 (C16)
TC0.5: J1.1, U1.20 (C0.5)
TC1: J2.1, U1.19 (C1)
TC2: J2.2, U1.17 (C2)
TC4: J2.3, U1.16 (C4)
TC8: J2.4, U1.15 (C8)
TC16: J1.6, R2.2
