DRWJSCHMIDT/T41/(commit log)

2024-01-12 First Commit to main
    First Commit to main
    [BoardOutline.gbr, Bottom.gbr, BottomAssembly.gbr, BottomAssy.gbr, BottomDimension.gbr, BottomMask.gbr, BottomPaste.gbr, BottomSilk.gbr]
2024-01-15 Initial Commit
    K9HZ Digital Attenuator Files
    [RF Attenuator PA Module 041623.dch, RF Attenuator V1.00 041623.dip, RF Attenuator board BOM V1.00 041923.csv]
2024-01-15 Renamed all files to replaces spaces with underscores
    [BoardOutline.gbr, Bottom.gbr, BottomAssembly.gbr, BottomAssy.gbr, BottomDimension.gbr, BottomMask.gbr, BottomPaste.gbr, BottomSilk.gbr]
2024-01-17 Updated To Most Resent Versions
    [BoardOutline.gbr, Bottom.gbr, BottomAssembly.gbr, BottomAssy.gbr, BottomDimension.gbr, BottomMask.gbr, BottomPaste.gbr, BottomSilk.gbr]
2024-01-17 Updated Latest Versions
    [BoardOutline.gbr, Bottom.gbr, BottomAssembly.gbr, BottomAssy.gbr, BottomDimension.gbr, BottomMask.gbr, BottomPaste.gbr, BottomSilk.gbr]
2024-01-17 Added KiCad projects for all boards
    [HF41F-12-ZS.step, K9HZ_100W_11band_LPF-Control.kicad_sch, K9HZ_100W_11band_LPF-Filter.kicad_pcb, K9HZ_100W_11band_LPF-Filter.kicad_sch, K9HZ_100W_11band_LPF-TR-carrier.kicad_pcb, K9HZ_100W_11band_LPF-TR-carrier.kicad_sch, T41-RF-board-V012.kicad_pcb, T41-RF-board-V012.kicad_sch]
2024-01-17 Corrected typo on band code for no-filter option
    [K9HZ_100W_11band_LPF-Filter.kicad_sch]
2024-01-18 Fixed stackup ambiguity in LPF relay carrier board. It is a 2 layer board but KiCad stackup contained two unused inner copper layers
    [K9HZ_100W_11band_LPF-TR-carrier.kicad_pcb]
2024-01-24 Fixed errors
    Fixed a few errors in BOMs
    [K9HZ_LPF-Control_Board_BOM_V1.00_01-14-24.xlsx, K9HZ_LPF-TR Carrier_Board_BOM_V1.00_01-10-24.xlsx, K9HZ_LPF_BOM_V1.00_01-10-24.csv, K9HZ_LPF_BOM_V1.00_01-10-24.xlsx]
2024-01-24 Updated BPF
    Updated PBF
    [T41_BPF_Board_BOM_V12.6_01-23-24.xlsx, T41_BPF_Coil_Winding_V12.6_01-23-24.xlsx]
2024-01-24 Update For BPF Development
    Update for BPF Development
    [ElsieConfiguration.CFG, T41 BPF Board V12.6 10-18-23.dch]
2024-01-25 Added Board Pictures
    Added Board Pictures
2024-01-25 Update K9HZ_LPF-Control_Board_BOM_V1.00_01-14-24.xlsx
    Updated LPF BOM
    [K9HZ_LPF-Control_Board_BOM_V1.00_01-14-24.xlsx]
2024-01-26 Updated RF Board
    Updated RF board
    [T41_RF_Board_V012.6_11-12-23.dch]
2024-01-26 Switched order of attenuator and amplifier in receive chain. Now attenuator is before amplifier
    [T41-RF-board-V012.kicad_pcb, T41-RF-board-V012.kicad_sch]
2024-01-26 Added 11 band BPF design files for prototyping
    [FT37-toroid.step, T41-exciter-filter-board.kicad_pcb, T41-exciter-filter-board.kicad_sch]
2024-01-26 Moved production files for RF board with switched amp and attenuator to correct locations
    [T41-RF-board-V012.kicad_sch]
2024-01-26 Added 3D model pictures of exciter filter
2024-01-26 Update RF board
    Update RF Board
2024-01-27 Renamed some files to keep to the conventions
    [T41-exciter-filter-board.kicad_pcb, T41-exciter-filter-board.kicad_sch]
2024-01-27 Removed references to Software
    Removed References to Software
    [ElsieConfiguration.CFG]
2024-01-29 Update K9HZ_LPF-Filter_Board_BOM_V1.00_01-10-24.xlsx
    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
    [K9HZ_LPF-Filter_Board_BOM_V1.00_01-10-24.xlsx]
2024-02-01 update
    Update
    [K9HZ_LPF-Filter_Board_BOM_V1.00_01-10-24.xlsx]
2024-02-03 Fixed incorrect grounding of heatsink feet on main board
    [T41-exciter-filter-board.kicad_pcb, T41-main-board-V012.kicad_pcb, T41-main-board-V012.kicad_sch]
2024-02-04 Added 1206 footprints alongside all the coil inductors in the BPF board to allow use of SMD inductors instead of toroids
    [T41-exciter-filter-board.kicad_pcb, T41-exciter-filter-board.kicad_sch]
2024-02-04 Fixed silkscreen label placements on LPF filter board
    [K9HZ_100W_11band_LPF-Filter.kicad_pcb]
2024-02-06 Moved heatsink up slightly on main board to avoid board edge
    [T41-main-board-V012.kicad_pcb]
2024-02-06 Update 020524
    Update 020524
    [A_Mouser.xlsx, B_Mouser.xlsx, C_Mouser.xlsx, D_Mouser.xlsx, K9HZ_BPF_V012.6_011224.dch, K9HZ_LPF-Filter_Board_BOM_V1.00_01-10-24.xlsx, Rx_ADL5387_ADF4351-No-input-filter.csv, Rx_ADL5387_ADF4351.csv]
2024-02-06 Restored silkscreen registration dot on U2 of RF board to its rightful place
    [T41-RF-board-V012.kicad_pcb]
2024-02-08 Latest Updates
    Latest Updates
    [K9HZ_LPF-Filter_Board_BOM_V1.00_01-10-24.xlsx, T41_BPF_Board_BOM_V12.6_01-23-24.xlsx, T41_V12.6_I2C_Assignments.xlsx]
2024-02-08 Corrected callsign for Bill on the BPF board silkscreen
    [T41-exciter-filter-board.kicad_pcb]
2024-02-11 VHF Updates
    VHF Updates
    [ElsieConfiguration.CFG, K9HZ_LPF-Filter_Board_BOM_V1.00_01-10-24.xlsx, T41_BPF_Coil_Winding_V12.6_01-23-24.xlsx, T41_V12.6_I2C_Assignments.xlsx]
2024-02-11 Corrected Names
    Corrected File Names
    [K9HZ_100W_11_Band_LPF_Board_V1.00.dch, K9HZ_100W_11band_LPF-Control.kicad_sch, K9HZ_100W_11band_LPF-Filter.kicad_pcb, K9HZ_100W_11band_LPF-Filter.kicad_sch, K9HZ_100W_11band_LPF-TR-carrier.kicad_pcb, K9HZ_100W_11band_LPF-TR-carrier.kicad_sch, K9HZ_LPF-Control_Board_BOM_V1.00_01-14-24.xlsx, K9HZ_LPF-Filter_Board_BOM_V1.00_01-10-24.xlsx]
2024-02-12 Fixes to LPF as part of checkout
    [K9HZ_100W_11band_LPF-Control.kicad_sch]
2024-02-14 Recreate these
    [K9HZ_100W_11band_LPF-Control.kicad_sch, T41-RF-board-V012.kicad_pcb, T41-RF-board-V012.kicad_sch]
2024-02-14 Fixes to LPF control board based on KI3P testing
    [K9HZ_100W_11band_LPF-Control.kicad_sch]
2024-02-14 To match remote
    [K9HZ_100W_11_Band_LPF_Board_V1.00.dch, K9HZ_100W_11band_LPF-Control.kicad_sch, K9HZ_100W_11band_LPF-Filter.kicad_pcb, K9HZ_100W_11band_LPF-Filter.kicad_sch, K9HZ_100W_11band_LPF-TR-carrier.kicad_pcb, K9HZ_100W_11band_LPF-TR-carrier.kicad_sch, K9HZ_LPF-Control_Board_BOM_V1.00_01-14-24.xlsx, K9HZ_LPF-Filter_Board_BOM_V1.00_01-10-24.xlsx]
2024-02-15 Update for LPF BOM
    Update for LPF BOM
    [K9HZ_LPF-Control_Board_BOM_V1.00_01-14-24.xlsx, K9HZ_LPF-Filter_Board_BOM_V1.00_01-10-24.xlsx, K9HZ_LPF-TR Carrier_Board_BOM_V1.00_01-10-24.xlsx, K9HZ_LPF_BOM_V1.00_01-10-24.xlsx, T41 BPF Board V12.6 10-18-23.dch, T41 Main Board V12.6 12-25-23.dch, T41 Power Amp V12.6 07-11-22.dch, T41_LPF_Board_Schematic_V012.6 _07-06-22.dch]
2024-02-15 Update LPF Line Section Inductors
    Update LPF Line Section Inductors
    [K9HZ_100W_11_Band_LPF_Board_V1.00.dch]
2024-02-15 Delete K9HZ_LPF_BOM_V1.00_01-10-24.xlsx
    File Clean-up
    [K9HZ_LPF_BOM_V1.00_01-10-24.xlsx]
2024-02-15 Update for RF Board BOM Part Error
    Update for RF Board BOM Part Error
    [T41_RF_Board_BOM_V012.6_01-12-24.xlsx]
2024-02-16 Removed incorrect LPF prototype gerbers
2024-02-16 Updates to LPF Docs
    Updates to LPF Docs
    [K9HZ_LPF-Filter_Board_BOM_V1.00_01-10-24.xlsx]
2024-02-17 Working on RF board mods
    [T41 BPF Board V12.6 10-18-23.dch, T41 Main Board V12.6 12-25-23.dch, T41 Power Amp V12.6 07-11-22.dch, T41-RF-board-V012.kicad_pcb, T41_LPF_Board_Schematic_V012.6 _07-06-22.dch, T41_RF_Board_V012.6_11-12-23.dch]
2024-02-17 Added ground test points and pad, silkscreen edits
    [031-203-RFX.stp, T41-RF-board-V012.kicad_pcb, T41-RF-board-V012.kicad_sch]
2024-02-17 Restoring files that mistakenly got deleted in branch merge
    [T41 BPF Board V12.6 10-18-23.dch, T41 Main Board V12.6 12-25-23.dch, T41 Power Amp V12.6 07-11-22.dch, T41_LPF_Board_Schematic_V012.6 _07-06-22.dch, T41_RF_Board_V012.6_11-12-23.dch]
2024-02-17 Changed Q1 of main board to correct part FQP47P06
    [T41-main-board-V012.kicad_pcb, T41-main-board-V012.kicad_sch]
2024-02-17 Update for V12 Software Release
    Update for V12 Software Release
    [K9HZ_LPF-Filter_Board_BOM_V1.00_01-10-24.xlsx]
2024-02-18 Added Software
    Added Software
    [VHF_UHF_PA_Modues_Mitsubishi.xlsx]
2024-02-18 Create PCB_Brackets_for_100mm_x_100mm_Boards.gcode
    Update For 3D Printed Stuff
2024-02-19 Update BOMs
    Make BOMs Easier to Read
    [K9HZ_LPF-Control_Board_BOM_V1.00_01-14-24.xlsx, K9HZ_LPF-Filter_Board_BOM_V1.00_01-10-24.xlsx]
2024-02-21 Added Pictures
    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
    [T41_BPF_Board_BOM_V12.6_01-23-24.xlsx, T41_BPF_Coil_Winding_V12.6_01-23-24.xlsx]
2024-02-22 Update BPF Winding Data
    Update BPF Winding Data
    [T41_BPF_Board_BOM_V12.6_01-23-24.xlsx, T41_BPF_Coil_Winding_V12.6_01-23-24.xlsx, T41_Main_Board_BOM_All_V12.6_12-26-23.xlsx]
2024-02-22 Updated 3D files
    Updated 2D FIles
    [BNC washer.FCStd, Mounting Bracket V010-Body.stl, Mounting Bracket V010.FCStd, PS PCB Mounting Bracket-Body V010.stl, PS PCB Mounting Bracket.FCStd, Speaker Box V011-Body.stl, Speaker Box V011.FCStd, Speaker Box V10-Body.stl]
2024-02-25 Corrected footprint for TCXO Y1
    [T41-RF-board-V012.kicad_pcb]
2024-02-25 Fixed errata in KI3P RF board test report
    [T41-RF-board-V012.kicad_pcb, T41-RF-board-V012.kicad_sch]
2024-02-25 Updated RF board BOM, gerbers, and PDF schematic to incorporate KI3Ps testing results
    [T41-RF-board-V012.kicad_pcb, T41_RF_Board_BOM_V012.6_02-25-24.xlsx]
2024-02-25 Removed out of date gerbers and BOMs
    [T41_RF_Board_BOM_V012.6_01-12-24.xlsx]
2024-02-26 Added heatsink model to RF board to confirm component fit. Tweaked locations of a few components.
    [EA-T220-38E.stp, T41-RF-board-V012.kicad_pcb, T41-RF-board-V012.kicad_sch]
2024-02-26 Changed orientation of Q1 and D5 for reverse protection
    [T41-main-board-V012.kicad_pcb, T41-main-board-V012.kicad_sch]
2024-02-26 BPF Finalization
    BPF Finalization
    [ElsieConfiguration.CFG, K9HZ_LPF-Filter_Board_BOM_V1.00_01-10-24.xlsx, T41_BPF_Board_BOM_V12.6_01-23-24.xlsx, T41_BPF_Board_BOM_V12.6_02-23-24.xlsx]
2024-02-26 Update for Fan Bracket
    Update for Fan Bracket
    [fanBracket-Fillet001_24mm.stl]
2024-03-10 Fixes to BPF board, adding missing decoupling capacitors
    [T41-exciter-filter-board.kicad_pcb, T41-exciter-filter-board.kicad_sch]
2024-03-10 Additional fix to BPF board
    [T41-exciter-filter-board.kicad_pcb, T41-exciter-filter-board.kicad_sch]
2024-03-10 BPF Update
    BPF Update
    [T41_BPF_Board_BOM_V12.6_03-07-24.xlsx, T41_BPF_Coil_Winding_V12.6_01-23-24.xlsx]
2024-03-10 BPF Picture Update
    BPF Picture Update
    [ElsieConfiguration.CFG]
2024-03-10 BPF Files Update
    BPF Files Update
    [T41_BPF_Board_BOM_V12.6_03-09-24.xlsx]
2024-03-11 Update BPF
    Update BPF
    [T41_BPF_Board_BOM_V12.6_03-09-24.xlsx]
2024-03-12 Added Arduino sketch and libraries for controlling ADF4351 LO
2024-03-12 Update Encoder Boards
    Update Encoder Boards
    [1 - Top.gbr, 2 - Bottom.gbr, BoardOutline.gbr, BottomAssembly.gbr, BottomDimension.gbr, BottomMask.gbr, BottomPaste.gbr, BottomSilk.gbr]
2024-03-17 Picture Updates
    Picture Updates
    [ElsieConfiguration.CFG, T41_BPF_Board_BOM_V12.6_03-09-24.xlsx]
2024-03-18 Update BPF BOM
    Update BPF BOM
    [T41_BPF_Board_BOM_V12.6_03-09-24.xlsx]
2024-03-20 Update BPF Files
    Update BPF Files
    [ElsieConfiguration.CFG, K9HZ_BPF_V012.6_011224.dch]
2024-03-23 Board Pictures Updated
    Board Pictures Updated
2024-03-25 Updated Board Pictures
    Updated Board Pictures
2024-04-08 Added CAL isolation jumper to RF board to improve Bode plot measurement
    [T41-RF-board-V012.kicad_pcb, T41-RF-board-V012.kicad_sch]
2024-04-10 Upgrade Paths
    Upgrade Paths
    [T41_V12.6_I2C_Assignments.xlsx]
2024-04-11 RF Board BOM Update
    RF Board BOM Update
    [T41_RF_Board_BOM_V012.6_02-25-24.xlsx]
2024-04-13 Update Test Software
    Update Test Software
    [T41_RF_Board_BOM_V012.6_02-25-24.xlsx, T41_V12.6_I2C_Assignments.xlsx]
2024-04-14 Second Rx Adapter
    Second Rx Adapter
    [T41_Second_Rx_Adapter_V12.6_04-14-24.dch]
2024-04-15 Added second receiver adapter board
    [T41-Second-receiver-adapter.kicad_pcb, T41-Second-receiver-adapter.kicad_sch]
2024-04-15 Fixed BOM
    Fixed BOM
    [K9HZ_LPF-Control_Board_BOM_V1.00_01-14-24.xlsx, K9HZ_LPF-Filter_Board_BOM_V1.00_01-10-24.xlsx]
2024-04-20 Final fixes to BPF to change addressing of BYPASS path
    [T41-exciter-filter-board.kicad_pcb, T41-exciter-filter-board.kicad_sch]
2024-04-21 Added pulldown resistors to 12/10 and 17/15 diode combiners
    [T41-exciter-filter-board.kicad_pcb, T41-exciter-filter-board.kicad_sch, T41_BPF_Board_BOM_V12.6_03-09-24.xlsx, T41_BPF_Board_BOM_V12.6_04-20-24.xlsx]
2024-04-23 Upgrade Path Diagram Updates
    Upgrade Path Diagram Updates
    [BOM T41-EP 6-24 V11.xlsx]
2024-04-24 Updated BOMs
    Updates BOMs
    [T41_Main_Board_BOM_All_V12.6_12-26-23.xlsx]
2024-04-27 Incorporate final QC changes from Bill: add altenative MOSFET switch footprint for voltage reversal protection
    [T41-main-board-V012.kicad_pcb, T41-main-board-V012.kicad_sch]
2024-04-27 Small silkscreen tweaks: add diode cathode indicators
    [T41-main-board-V012.kicad_pcb]
2024-04-27 Updated pictures
    Updated Pictures
    [Power Input Circuit.dch]
2024-04-29 Added new code for Teensy shutdown control
2024-04-30 Update V12 BOMS
    Update V12 BOMs
    [T41_Second_RX_Adapter_Board_BOM_V012.6_04-30-24.xlsx]
2024-05-02 Removed some KI3P-specified configurations from the board testing code
2024-05-02 Update files
    Update Files
    [K9HZ_100W_11band_LPF-Control.kicad_sch, K9HZ_100W_11band_LPF-Filter.kicad_pcb, K9HZ_100W_11band_LPF-Filter.kicad_sch, K9HZ_100W_11band_LPF-TR-carrier.kicad_pcb, K9HZ_100W_11band_LPF-TR-carrier.kicad_sch, T41_BPF_Board_BOM_V12.6_04-20-24.xlsx, T41_BPF_Board_BOM_V12.6_05-01-24.xlsx]
2024-05-10 Files Update
    Files Update
    [ElsieConfiguration.CFG]
2024-05-23 File Updates
    File Updates
    [Full_Board_052224.csv]
2024-06-03 Rearranged Files in 20W directory
    Rearranged Files in 20W PA Dir
    [20W AMP 160M-6M V2.4 092523.dch, 20W Amp Layout V2.4 092523.dip, 20W WJS Amp BOM V2.4 121523.xlsx]
2024-06-10 Directory Restructure
    Directory Restructure
    [20W AMP 160M-6M V2.4 092523.dch, 20W Amp Layout V2.4 092523.dip, 20W WJS Amp BOM V2.4 121523.xlsx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]
2024-06-10 File Structure re-alignment
    File Structure re-alignment
    [K9HZ_Front_Panel_Elecctronics_V012.6_11-15-23.dip, K9HZ_Front_Panel_Electronics_BOM_V012.6_11-15-23.xlsx, K9HZ_Front_Panel_Electronics_V012.6_11-15-23.dch, K9HZ_Switch_Matrix_Board_ V012.6 09-27-23.dip, K9HZ_Switch_Matrix_Board_ V012.6_09-27-23.dch, K9HZ_Switch_Matrix_Board_BOM_V012.6_01-15-23.xlsx, K9HZ_Teensy_Hat_Offset_Board_V012.6_12-15-23.dip]
2024-06-15 Updated LPF BOM
    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
    [K9HZ_LPF-Control_Board_BOM_V1.00_01-14-24.xlsx, T41_V12.6_I2C_Assignments.xlsx]
2024-06-15 Update LPF BOM
    Update LPF BOM
    [K9HZ_LPF-Control_Board_BOM_V1.00_01-14-24.xlsx]
2024-06-18 Fixed BPF BOM
    Fixed BPF BOM
    [T41_BPF_Board_BOM_V12.6_05-01-24.xlsx]
2024-06-30 Updated silkscreen for RF Board Y1 to put indicator dot in the correct location
    [T41-RF-board-V012.kicad_pcb]
2024-07-02 BOM Update
    BOM Update
    [K9HZ_Front_Panel_Electronics_BOM_V012.6_11-15-23.xlsx, T41_V12_Board_Sales_Inventory-063024.xlsx]
2024-07-07 Update Front Panel
    Update Front Panel
    [T41_BPF_Filter_Caps_For_Building_04-04-24.xlsx]
2024-07-10 Rearrange Files
    Rearrange FIles
    [T41_BPF_Filter_Caps_For_Building_04-04-24.xlsx, T41_V12.6_I2C_Assignments.xlsx]
2024-07-13 Added models to library
    [HFD4_relay.3mf, HFD4_relay.step, HFD4_relay.stl]
2024-07-14 New Files
    New Files
    [T41_Display_Adapter_Board_V12.6_07-13-24.dch]
2024-07-16 Update BOM files
    Update BOM Files
    [T41_Main_Board_BOM_All_V12.6_07-16-24.xlsx, T41_Main_Board_BOM_All_V12.6_12-26-23.xlsx]
2024-07-17 Update BOMs
    Update BOMs
    [T41_RF_Board_BOM_V012.6_02-25-24.xlsx, T41_RF_Board_BOM_V012.6_07-26-24.xlsx]
2024-07-18 Added component to KiCad library
2024-07-18 Added R73 to RF board to adjust off ramp time
    [T41-RF-board-V012.kicad_sch]
2024-07-20 Updated C5,C8,C19,C21 values per Al
    [T41-RF-board-V012.kicad_sch]
2024-07-21 Added switching regular alternatives description
2024-07-25 Updated LPF carrier board schematic with 6.8k resistor value
    [K9HZ_100W_11band_LPF-TR-carrier.kicad_sch]
2024-07-30 Update GITHUB for Reverse Voltage Protection Kits
    Update GITHUB for Reverse Voltage Protection Kits
    [Reverse_voltage_protection_20A_BOM.xlsx, Reverse_voltage_protection_50A.xlsx]
2024-07-30 Update K9HZ_LPF_tester.ino
    Fixed a bug where from I2C interface was called for the SWR portion
2024-07-30 Update K9HZ_LPF_tester.ino
    Wrong pin being toggled for TX/RX test
2024-07-31 Rearranged files
    Rearranged Files
    [T41_BPF_Board_BOM_V12.6_07-07-24.xlsx, T41_Main_Board_BOM_All_V12.6_07-16-24.xlsx, T41_RF_Board_BOM_V012.6_07-19-24.xlsx, T41_Second_RX_Adapter_Board_BOM_V012.6_04-30-24.xlsx]
2024-08-01 Added Glen VK3PE toroid winding details to BPF schematic
    [T41-exciter-filter-board.kicad_sch]
2024-08-02 Added 100W PA design files
    [K9HZ_100W_KiCad.kicad_pcb, K9HZ_100W_KiCad.kicad_sch, K9HZ_100W_TempMonitor_KiCad.kicad_pcb, K9HZ_100W_TempMonitor_KiCad.kicad_sch]
2024-08-02 Create ATTiny85_On_Off_T41_Jerry-KF6VB.ino
    Added Jerry KF6VB's code for the main board ATTiny85 that "hiccups" the power on startup to address display issues
2024-08-03 Fixed footprint of T2 in 100W PA
    [K9HZ_100W_KiCad.kicad_pcb]
2024-08-05 Added silkscreen art for 100W amp bias pot control per Glenn VK3PE suggestion
    [K9HZ_100W_KiCad.kicad_pcb, K9HZ_100W_KiCad.kicad_sch]
2024-08-08 Added ground pad hole for digital attenuators on RF board
    [T41-RF-board-V012.kicad_pcb]
2024-08-10 Increased diameter of via in RF board attenuators to 2mm
    [T41-RF-board-V012.kicad_pcb]
2024-08-19 Copyright Material Removed
    Copyright Material Removed
    [100W_AMP_160M-6M_V1.02-07-11-24.dch, 20W AMP 160M-6M V2.4 092523.dch, 20W Amp Layout V2.4 092523.dip, 20W WJS Amp BOM V2.4 121523.xlsx, K9HZ_100W_BOM.csv, K9HZ_100W_KiCad.kicad_pcb, K9HZ_100W_KiCad.kicad_sch, K9HZ_100W_TempMonitor_KiCad.kicad_pcb]
2024-08-25 Updated instructions in BPF schematic for second receiver
    [T41-exciter-filter-board.kicad_sch]
2024-08-25 Added wiring drawings for single receiver option
2024-09-08 Correct R35 and R37 to 0R on the RF board
    [T41-RF-board-V012.kicad_sch]
2024-09-19 added printed case files
    added printed case files
2024-09-29 Updates BOMs
    Updating BOMs
    [T41SDT By WA2MZE for Digikey Part Number Additions.xlsx, T41_BPF_Board_BOM_V12.6_09-28-24.xlsx, T41_Main_Board_BOM_All_V12.6_09-28-24.xlsx, T41_RF_Board_BOM_V012.6_09-28-24.xlsx]
2024-10-09 Improved i2cscan to identify devices that are connected
    [T41_V12.6_I2C_Assignments.xlsx]
2024-10-09 Fixed i2cscan README
2024-10-09 Added testing section to BPF assembly manual
2024-10-09 Move old BPF assembly manual
2024-10-11 Changed the order of the BPF assembly slightly to accommodate switch testing
2024-10-11 Added Weather Station
    Added Weather Station
    [180468-032-10-ORIGINAL-180468-1-esp32-weather-station_v1.2-bom.xls]
2024-10-11 Fixing directories
    Fixing directories
    [Reverse_voltage_protection_50A_BOM.xlsx]
2024-10-11 Updating RVP Files
    Updating RVP Files
    [Reverse_voltage_protection_50A_BOM.xlsx]
2024-11-05 Restructure Github
    Restructure Github
    [180468-032-10-ORIGINAL-180468-1-esp32-weather-station_v1.2-bom.xls, A_Mouser.xlsx, BOM for V1.2 052524.csv, BOM for V1.2 052524.xlsm, B_Mouser.xlsx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]
2024-12-13 RF board updates: removed clock divider, replaces IQ output caps with 0R, added cap to FB for TCXO
    [T41-RF-board-V012.kicad_sch]
2025-01-16 Added bypass capacitor to TCXO, removed clock divider circuit, replaced I/Q output DC blocking capacitors with 0R resistors
    [T41-RF-board-V012.kicad_pcb, T41-RF-board-V012.kicad_sch, T41-main-board-V012.kicad_sch]
2025-02-06 Update Boards
    Update Boards
    [ALPS_Concentric_Knobs_3.3mf, BOM T41-EP 6-24 V11 All Boards.xlsx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]
2025-02-10 Rearrange GITHUB
    Rearrange GITHUB
    [BOM T41-EP 6-24 V11 All Boards.xlsx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]
2025-02-16 Clean up Display Adapter Files
    Cleaned up Display Adapter Files
    [T41_Display_Adapter_3.3V_5V_V2.00_02-06-25.dip, T41_Display_Adapter_Board_3.3V_5V_V12.6_020625.dch]
2025-02-18 BPF Files Updates
    BPF Files Updated
    [T41_BPF_Building_Table_021625.xlsx, T41_BPF_Filter_Caps_For_Building_040424.xlsx, T41_BPF_Inductors_for_Building_021625.xlsx, T41_BPF_Inductors_for_Building_071524.xlsx]
2025-03-07 Update Calibration Instr
    Update Calibration Instr
    [T41_RF_Board_BOM_V012.6_12-01-24.xlsx]
2025-03-10 Calibration Update
    Calibration Update
2025-03-23 Added Display Driver Documents
    Added Display Driver Documents
    [T41_Display_3.3&5V_V2.00_02-06-25.xlsx]
2025-06-11 Added RF board testing sketch
2025-06-29 File Update
    File Update
    [T41_SDT_WA2MZE_partial_Digikey_Part_Numbers.xlsx, T41_V12.6_I2C_Assignments.xlsx]
2025-08-28 Update ELSIE cfg file
    Update ELSIE cfg file
    [ElsieConfiguration.CFG]
2025-12-26 T41 Mini
    T41 Mini
    [T41-Main+RF-board-V012.kicad_pcb, T41-Main+RF-board-V012.kicad_sch, T41-exciter-filter-board.kicad_pcb, T41-exciter-filter-board.kicad_sch, T41-mini-LPF+PA-board-V012.kicad_pcb, T41-mini-LPF+PA-board-V012.kicad_sch, T41_BPF_Board_V012_12-11-23.dip, T41_Display_Adapter_V1.01_07-14-24.dip]
2025-12-27 T41 Mini Update
    T41 Mini Update
    [T41-Main+RF-board-V012.kicad_sch]
2025-12-27 Work in progress -- still need to add the clock daughter board
    [T41-RF-board-V012.kicad_pcb, T41-RF-board-V012.kicad_sch]
2025-12-27 Initial commit of new RF board with clock and attenuators broken out to daughter boards
    [RD100HHF1C.3mf, RD100HHF1C.scad, RD100HHF1C.stl, T41-RF-board-Attenuator-daughterboard.kicad_pcb, T41-RF-board-Attenuator-daughterboard.kicad_sch, T41-RF-board-V012.kicad_pcb, T41-RF-board-V012.kicad_sch]
2025-12-27 Version of RF board with clock and attenuator daughterboards sent to Bill for comment
    [DualClockLO.csv, DualClockLO.kicad_pcb, DualClockLO.kicad_sch, T41-RF-board-V012.kicad_pcb]
2025-12-28 Updated titles for schematics and printed to PDF
    [DualClockLO.kicad_sch, T41-RF-board-Attenuator-daughterboard.kicad_sch, T41-RF-board-V012.kicad_sch]
2025-12-29 Updates
    Updates
    [T41-Main+RF-board-V012.kicad_pcb, T41-Main+RF-board-V012.kicad_sch, T41-exciter-filter-board.kicad_pcb, T41-exciter-filter-board.kicad_sch, T41-mini-LPF+PA-board-V012.kicad_sch]
2025-12-30 H1 removed and some via transitions removed for reduced EMI
    [T41-RF-board-Attenuator-daughterboard.kicad_pcb, T41-RF-board-V012.kicad_pcb, T41-RF-board-V012.kicad_sch]
2025-12-31 New layouts for RF board, clock board, and attenuator board are done
    [DualClockLO.kicad_pcb, T41-RF-board-Attenuator-daughterboard.kicad_pcb, T41-RF-board-Attenuator-daughterboard.kicad_sch, T41-RF-board-V012.kicad_pcb, T41-RF-board-V012.kicad_sch]
2025-12-31 Changed transmit chain direction on schematic to match RF board
    [DualClockLO.kicad_pcb, T41-RF-board-V012.kicad_pcb, T41-RF-board-V012.kicad_sch]
2026-01-03 RF board updated to reverse the direction of the transmit chain, making routing easier and less prone to noise.
    [DualClockLO.kicad_pcb, DualClockLO.kicad_sch, T41-RF-board-Attenuator-daughterboard.kicad_pcb, T41-RF-board-Attenuator-daughterboard.kicad_sch, T41-RF-board-V012.kicad_pcb, T41-RF-board-V012.kicad_sch]
2026-01-03 Added gerber files
2026-02-04 Assembly Manual Update
    Assembly Manual Update
    [T41_V12.6_I2C_Assignments.xlsx]
2026-02-23 Cleaned Up Design Documents
    Cleaned Up Design Documents
    [T41_V12.6_I2C_Assignments.xlsx]
2026-03-17 Update New RF Board
    Update New RF Board
    [DualClockLO-CuBottom.gbr, DualClockLO-CuIn1.gbr, DualClockLO-CuIn2.gbr, DualClockLO-CuTop.gbr, DualClockLO-EdgeCuts.gbr, DualClockLO-MaskBottom.gbr, DualClockLO-MaskTop.gbr, DualClockLO-NPTH.drl]
2026-04-07 Update New Boards
    Update New Boards
    [T41-RF-board-AttenuatorDaughterBoard-Assy_BOM.csv, T41-RF-board-AttenuatorDaughterBoard-Assy_BOM.xlsx, T41_RF_Board_AttenuatorDaughterBoard_ComponentPlacement.xlsx, T41_RF_Board_DualClock_Assy_BOM.xlsx]
2026-08-09 Upates
    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
    [Screen_Shield_box.3mf, T41-RF-board-V012.8.kicad_pcb, T41_NF.xlsx, T41_RF_Board_BOM_V012.8_06-16-26.xlsx, ZulkitFrontLeftPanel.stl, ZulkitFrontRightPanel 2.stl, ZulkitFrontRightPanel.stl]
2026-09-08 OSC Files Update
    OSC Files Update
    [Actual Coordinates and rotations for Osc Board Delete.xlsx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]
2026-09-12 Add BPF Holder From Bob Lance
    Add BPF Holder from Bob Lance
    [toroid_holder_bottom_tray.stl, toroid_holder_top_tray.stl]
2026-09-12 RF Board V12.8 BOM Update
    RF Board V12.8 BOM Update
    [T41_RF_Board_BOM_V012.8_06-16-26.xlsx, T41_RF_Board_BOM_V012.8_09-12-26.xlsx]
2026-09-12 Update RF BOM
    Update RF BOM
    [T41_RF_Board_BOM_V012.8_09-12-26.xlsx]
2026-09-15 Updated RF Board BOM
    Updated RF Board BOM
    [Board_Mounting_Bracket_PCB_V25.stl, T41_RF_Board_BOM_V012.8_09-12-26.xlsx]
2026-09-25 BOM Updates
    BOM Updates
