DRWJSCHMIDT/T41/(notices)

Notices in the files:
T41_V012_Mini_Files/T41_V012_Mini_Projects/T41-mini-Main+RF-board-V012/T41-Main+RF-board-V012.kicad_sch:
COPYRIGHT 2025
